Unaqwyn/SysP18_1cv/05_Webseite/05_Robi/IMAG0250.jpg

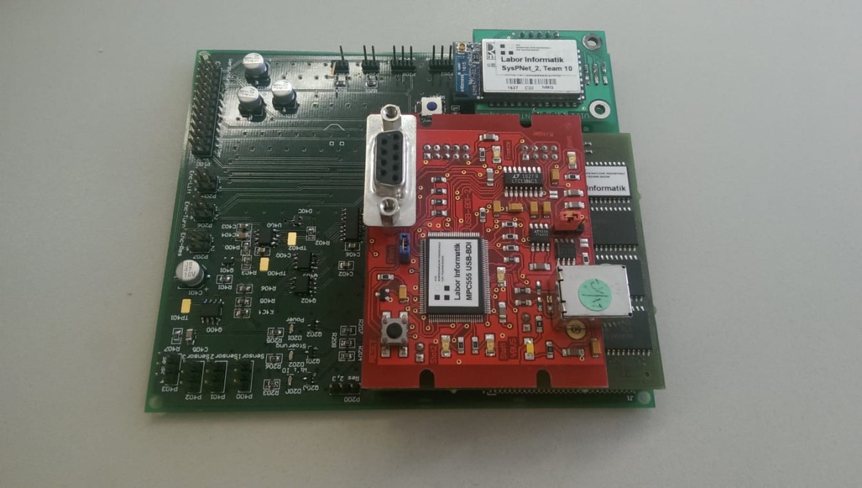
05_Webseite/05_Robi/IMAG0250.jpg
