Unaqwyn/SysP18_1cv/01_Organisation/02_Meilensteine/06_Datenblätter/02_Mechanik/01_Motoren/MotorBezeichnung mit Getriebe zuweisung.txt

Grosser Motor:

2232R012SR IEH2-1024 22/2 3.1:1

Kleiner Motor:

1524T012SR IEH2-1024 15/5 6.3:1
