Unaqwyn/SysP18_1cv/01_Organisation/00_Protokolle/SysP_Sitzung_2018_02_18.docx

Sitzungs-Protokoll vom: 20.2.18

Anwesende: Team 10, Peter Kühne

Ziel der Sitzung:

- M1 Abschluss
- Details am Roboter ausarbeiten
- Team-Coaching Termin festsetzten
- Detailierte Aufstellung für Zeitplan

Probleamtik/Diskussionspunkte:

- Team 10 im vorderen Teil der Noten
- Zeitplan muss detaillierter gestaltet werden
- Vorne nur Distanzsensor anstatt Druck
- Vibrationsmotor bestellen
- Faulhaber, Maxon: häufige Motorensponsoren
- Klapparm: kein Motor
- Team Coaching am 13 März abgemacht
- Auftrag: jeder erstellt ein ungefährer Zeitplan für sein Gebiet (bereits direkt nach Sitzung erledigt)
- Nach Absprache mit Partnerteam 3, neue Startstein Positionen festgesetzt: siehe Foto

Zeitaufwand für diese Sitzung: 1h
