Unaqwyn/SysP18_1cv/01_Organisation/02_Meilensteine/m5/anforderungsliste_nichteingehalten.docx

Zeit, übersetzung des Drehmotors stimmt nicht

Eingreifen während vorführung: sensor kann falsch ausschlagen, somit stimmt die position nicht

Startgrösse
