Unaqwyn/SysP18_1cv/01_Organisation/02_Meilensteine/m5/m5_info.pptx

## Informatik


- Viele kleinere Klassen
  - Einfacheres Testen/ Fehlersuche
- Drive als abstract class, um beide Arten von Motoren gleich anzusteuern
- Move und Lift um Motoren zu koordinieren
- RobiConstant und PinMap, um leicht Anpassungen machen zu können
