Unaqwyn/SysP18_1cv/01_Organisation/02_Meilensteine/m2/Praesentation_m2.pptx

## Klaus der Leuchtturmbauer

SysP18_Team_10

Design Review
Präsentation zu M2

Meilenstein_M2

3. März 2018

## Slide 2

Ablauf

SysP18_Team_10

- Einführung
- Mechanik
- Elektronik
- Informatik
- Zeitplan
- Diskussionsrunde

Meilenstein_M2

Seite 1/20

3. März 2018

## Slide 3

Einführung

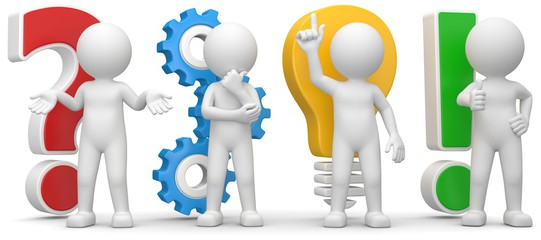
[picture p19: figure]

SysP18_Team_10

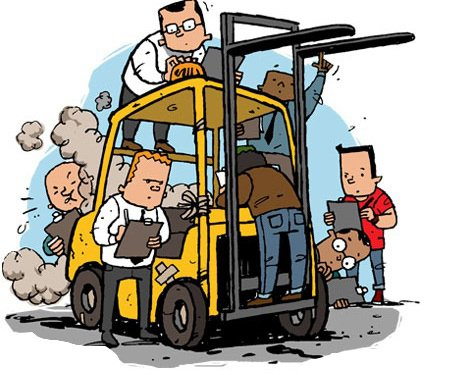
[picture p20: figure]

Seite 2/20

Meilenstein_M2

3. März 2018

## Slide 4

Mechanik – Design Review

SysP18_Team_10

- Autor: Jeannot Zwick
- Aktuar: Mauro Stoffel
- Experte: HansJakob Rechsteiner

Meilenstein_M2

Seite 3/20

3. März 2018

## Slide 5

Mechanik - Ergebnisse

SysP18_Team_10

- Produktionsaspekte mehr beachten
- Murphy’s law

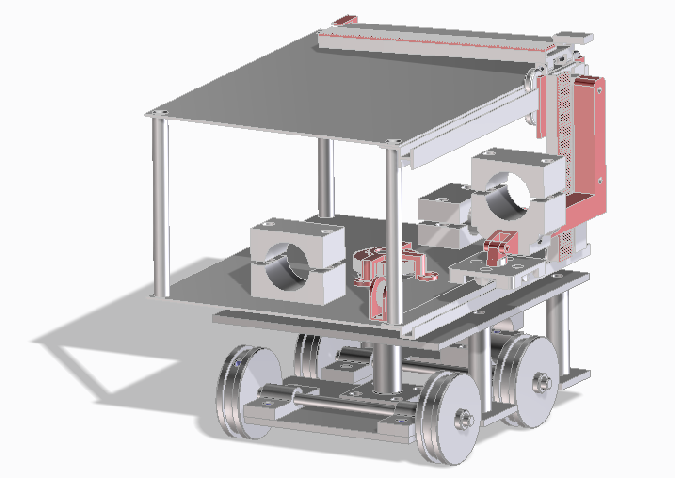
[picture p21: figure]

Meilenstein_M2

Seite 4/20

3. März 2018

## Slide 6

Elektronik

SysP18_Team_10

- Sensorelektronik und MPC 555
Moderator: Michael Alig
Autor: Luzian Weber
- Motorentreiber und Spannungsversorgung
Moderator: Luzian Weber
Autor: Michael Alig
-Aktuar: Marcel Sonderegger
-Betreuer: Falk Kyburz, Bernhard Girardi

Meilenstein_M2

Seite 5/20

3. März 2018

## Slide 7

Sensorelektronik und MPC 555 - Erster Entwurf

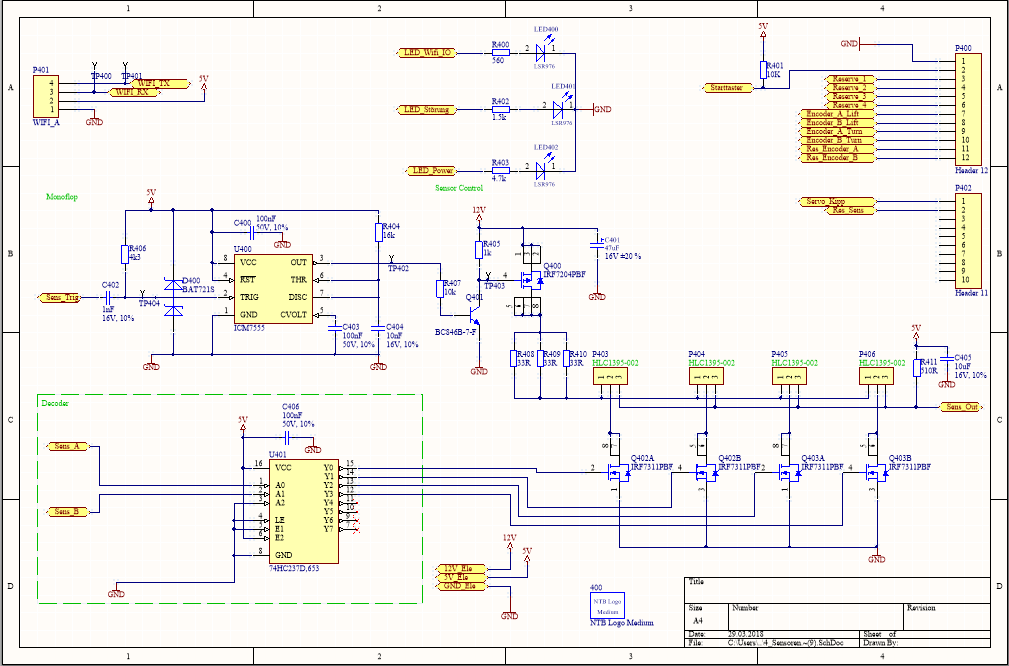
[picture p22: figure]

SysP18_Team_10

Meilenstein_M2

Seite 6/20

3. März 2018

## Slide 8

Sensorelektronik und MPC 555 - Entwurf Top Sheet

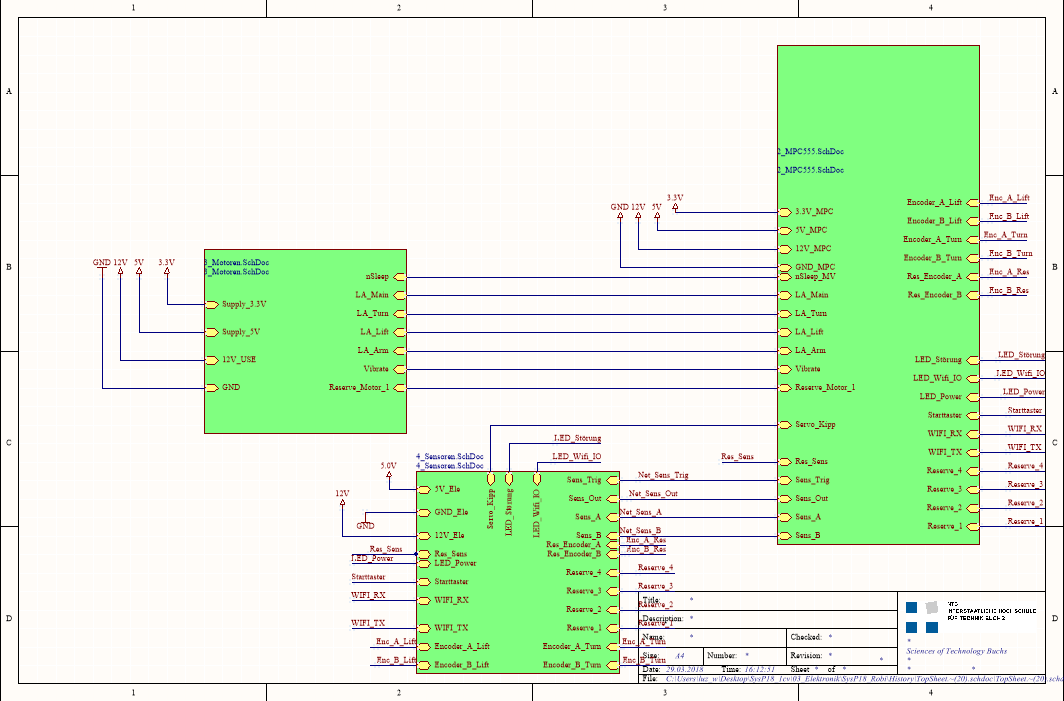
[picture p23: figure]

SysP18_Team_10

Meilenstein_M2

Seite 7/20

3. März 2018

## Slide 9

Sensorelektronik und MPC 555 - Top Sheet Aktuell

SysP18_Team_10

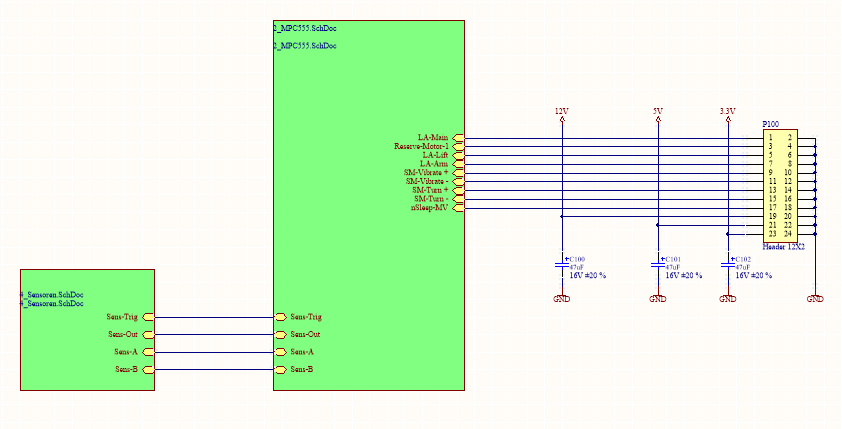
[picture p24: figure]

Meilenstein_M2

Seite 8/20

3. März 2018

## Slide 10

Sensorelektronik und MPC 555 - Aktuelles Schema

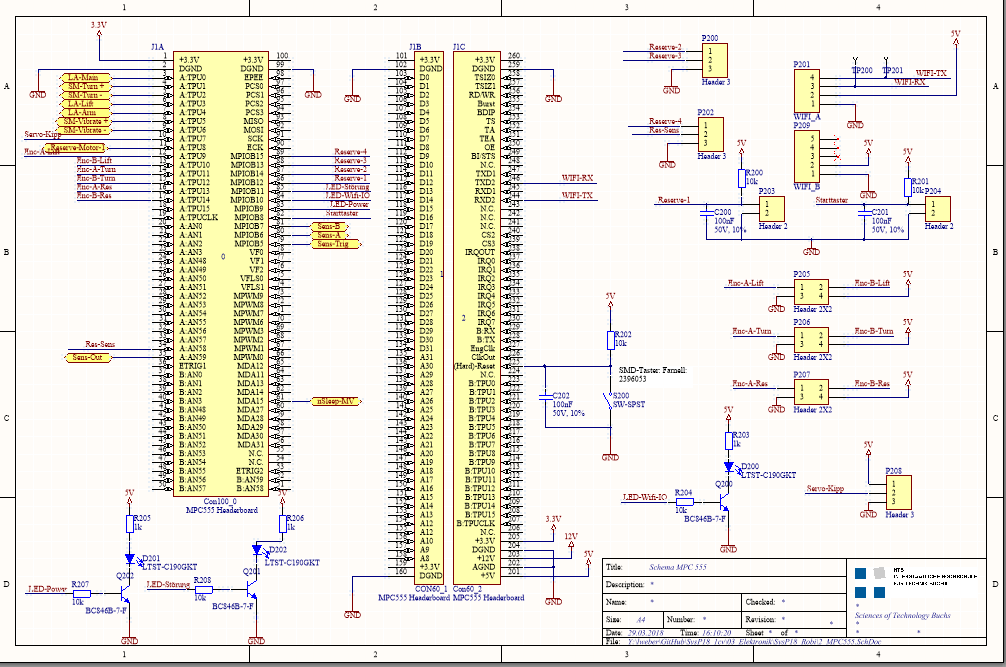
[picture p25: figure]

SysP18_Team_10

Meilenstein_M2

Seite 9/20

3. März 2018

## Slide 11

Sensorelektronik und MPC 555 - PCB Layout


SysP18_Team_10

Meilenstein_M2

Seite 10/20

3. März 2018

## Slide 12

Motorentreiber - Schema

SysP18_Team_10

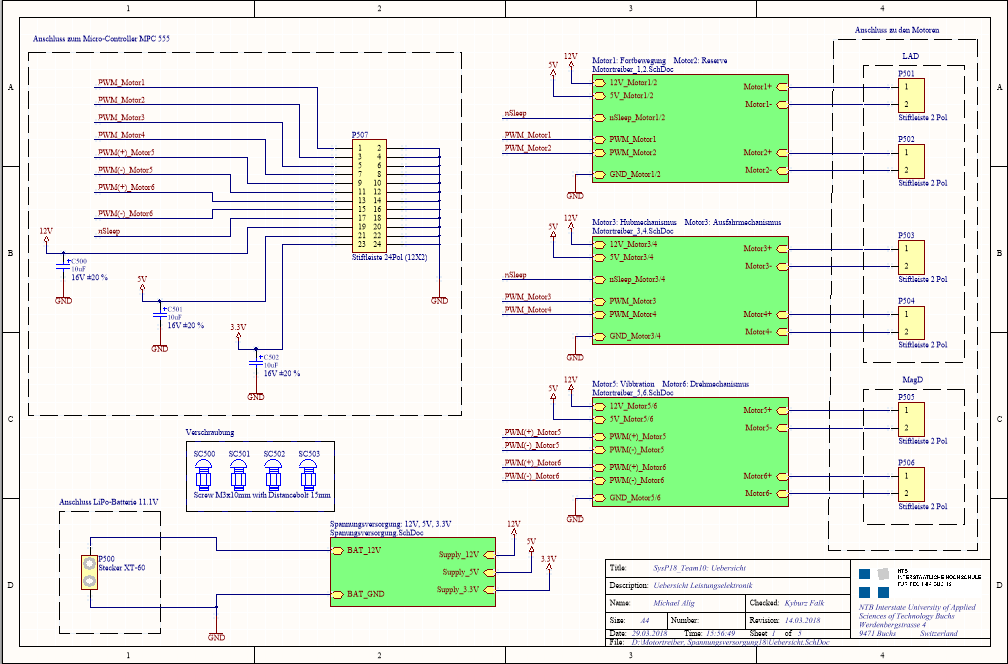
[picture p26: figure]

Meilenstein_M2

Seite 11/20

3. März 2018

## Slide 13

Motorentreiber - PCB Layout

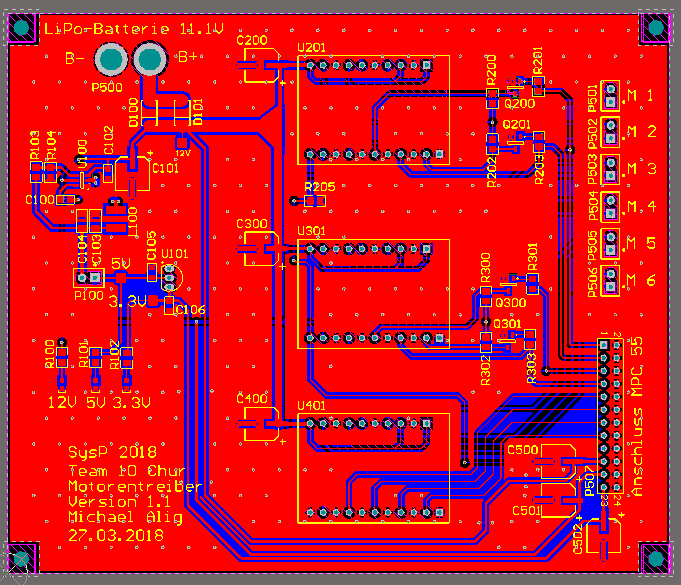
[picture p27: figure]

SysP18_Team_10

Meilenstein_M2

Seite 12/20

3. März 2018

## Slide 14

Fehlerquelle Spannungsversorgung (Switch-Loop)

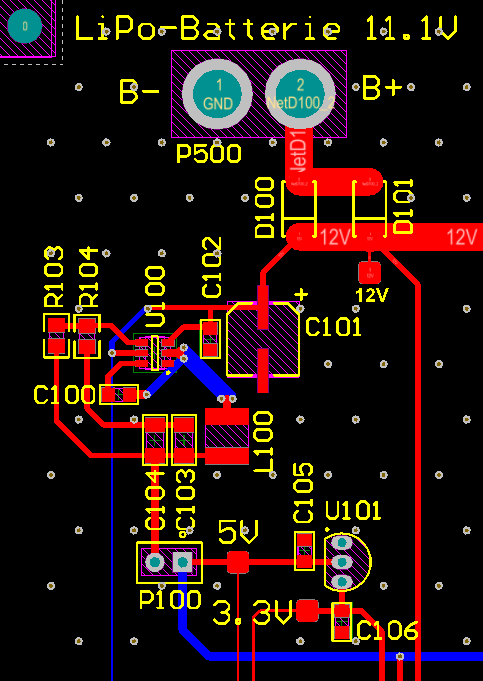
[picture p28: figure]

SysP18_Team_10

Meilenstein_M2

Seite 13/20

3. März 2018

## Slide 15

Motorentreiber - PCB 3D

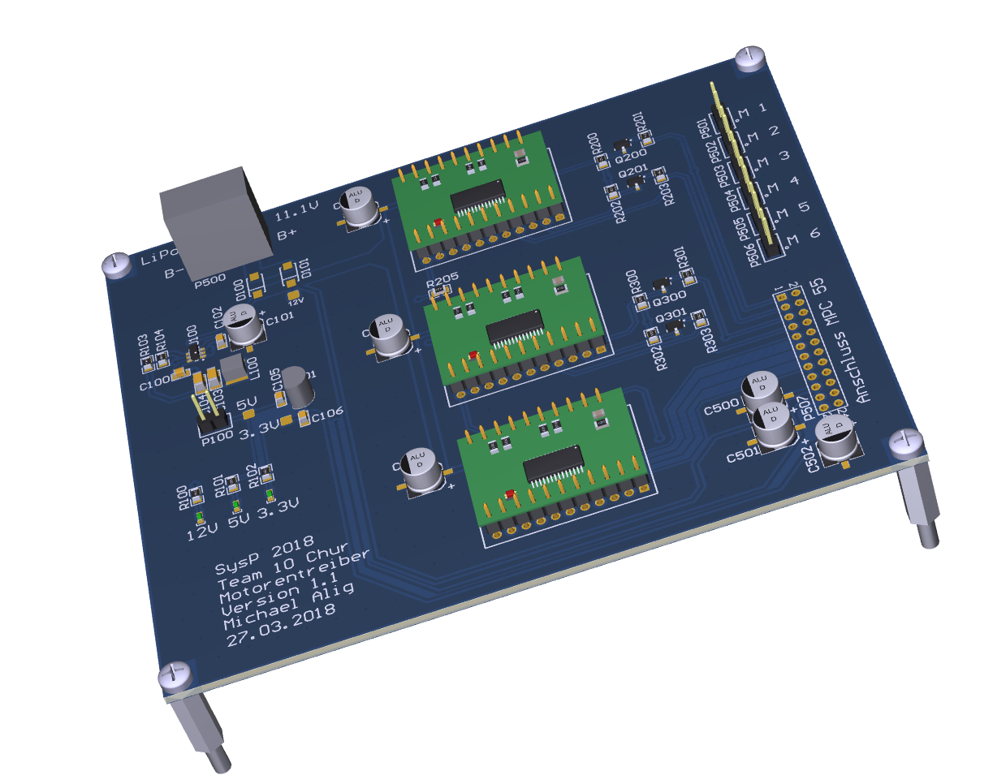
[picture p29: figure]

SysP18_Team_10

Meilenstein_M2

Seite 14/20

3. März 2018

## Slide 16

Informatik

SysP18_Team_10

- Klassendiagramm
- Ablaufdiagramm
- Kommunikationsprotokoll

Meilenstein_M2

Seite 15/20

3. März 2018

## Slide 17

Informatik - Klassendiagramm


- Mehr und kleinere Klassen
- Weniger zentrierte Struktur
- PinMap

SysP18_Team_10

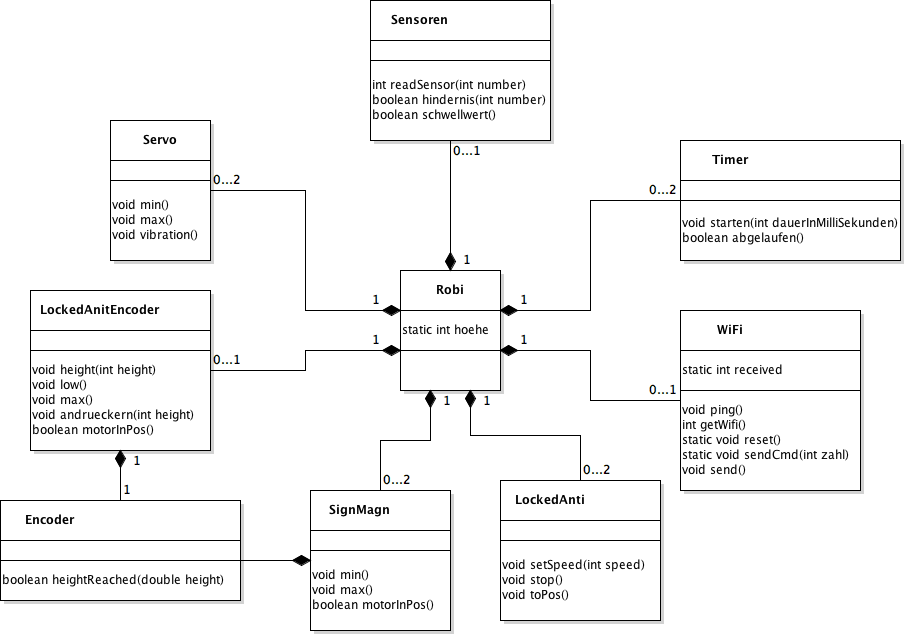
[picture p30: figure]

Meilenstein_M2

Seite 16/20

3. März 2018

## Slide 18

Informatik - Ablaufdiagramm

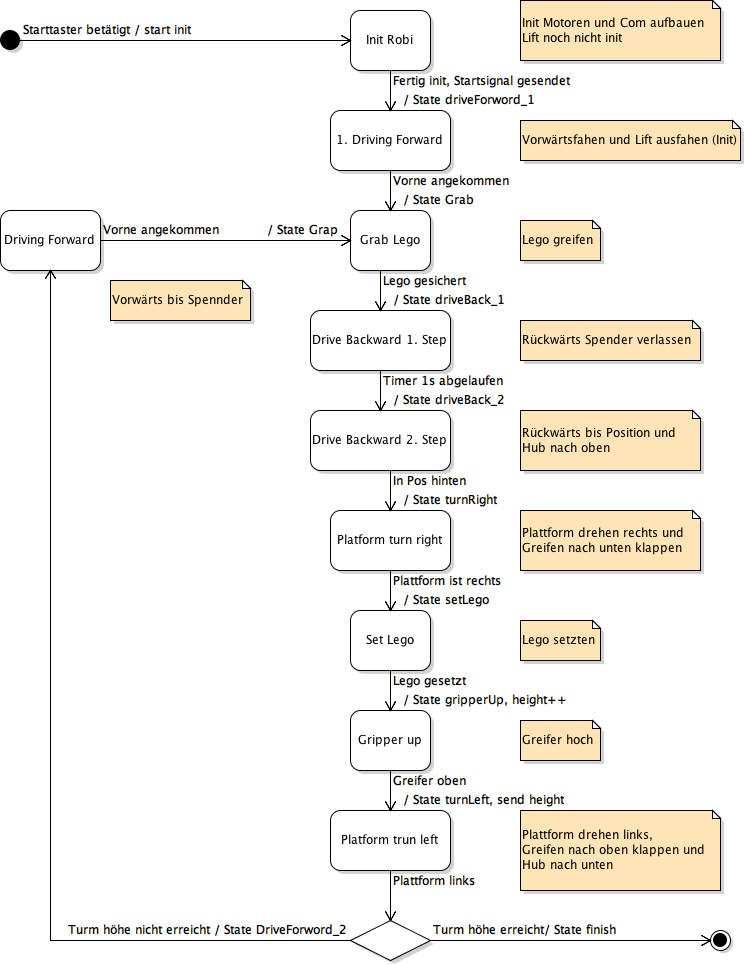
[picture p31: figure]

- Komplikationen vermeiden
- Je früher desto besser
- Bedingung & Aktivitäten

SysP18_Team_10

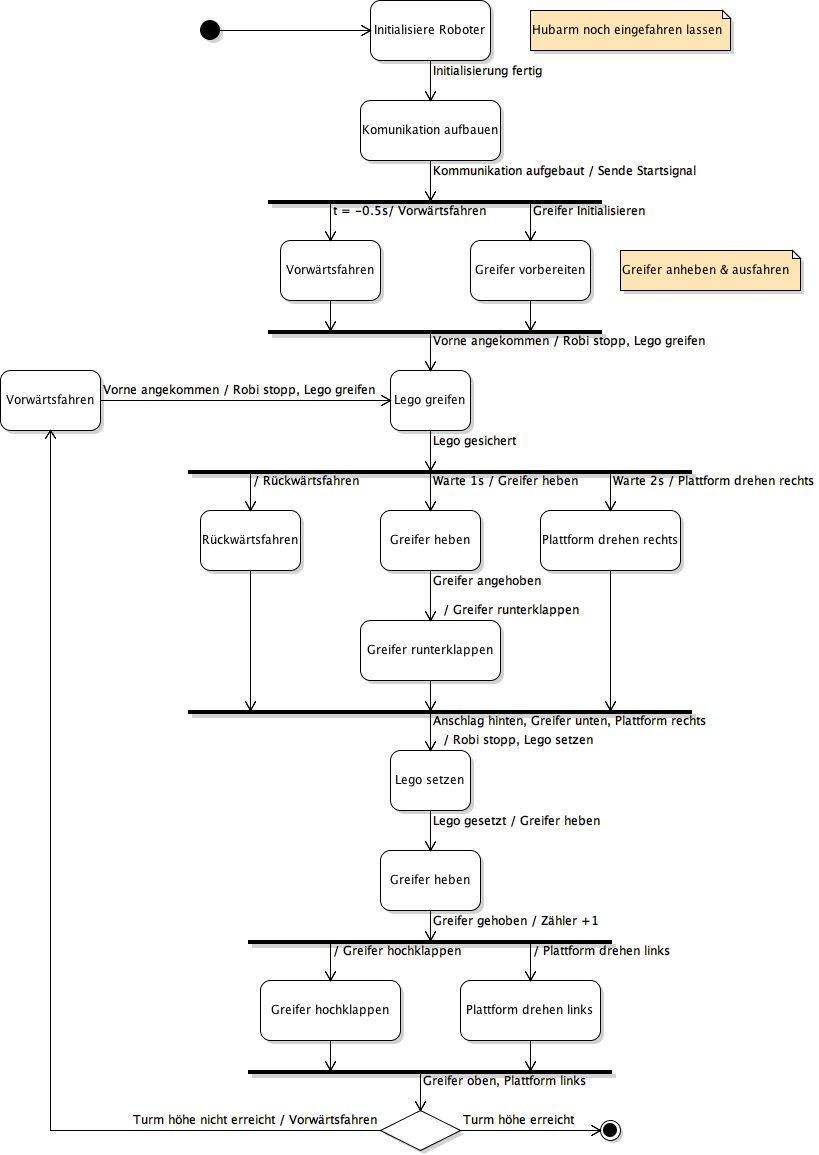
[picture p32: figure]

Meilenstein_M2

Seite 17/20

3. März 2018

## Slide 19

Informatik - Kommunikationsprotokoll

SysP18_Team_10

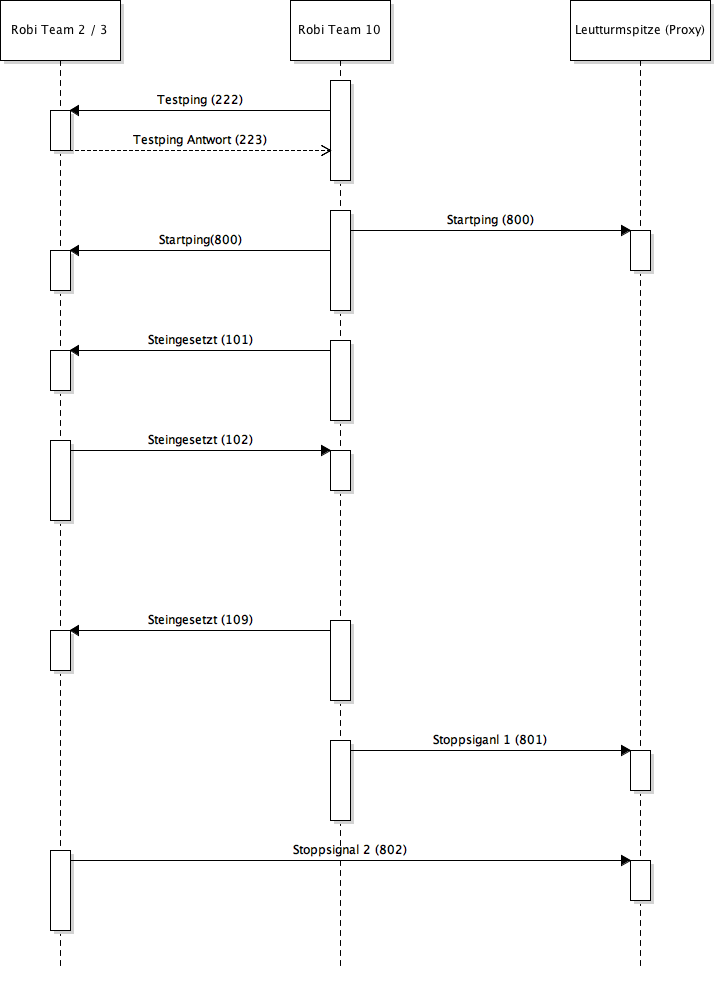
[picture p33: figure]

- Kontrollsignal
- Startsignal
- Stein-Gesetzt-Signal
- Stoppsignal

Meilenstein_M2

Seite 18/20

3. März 2018

## Slide 20

Zeitplan

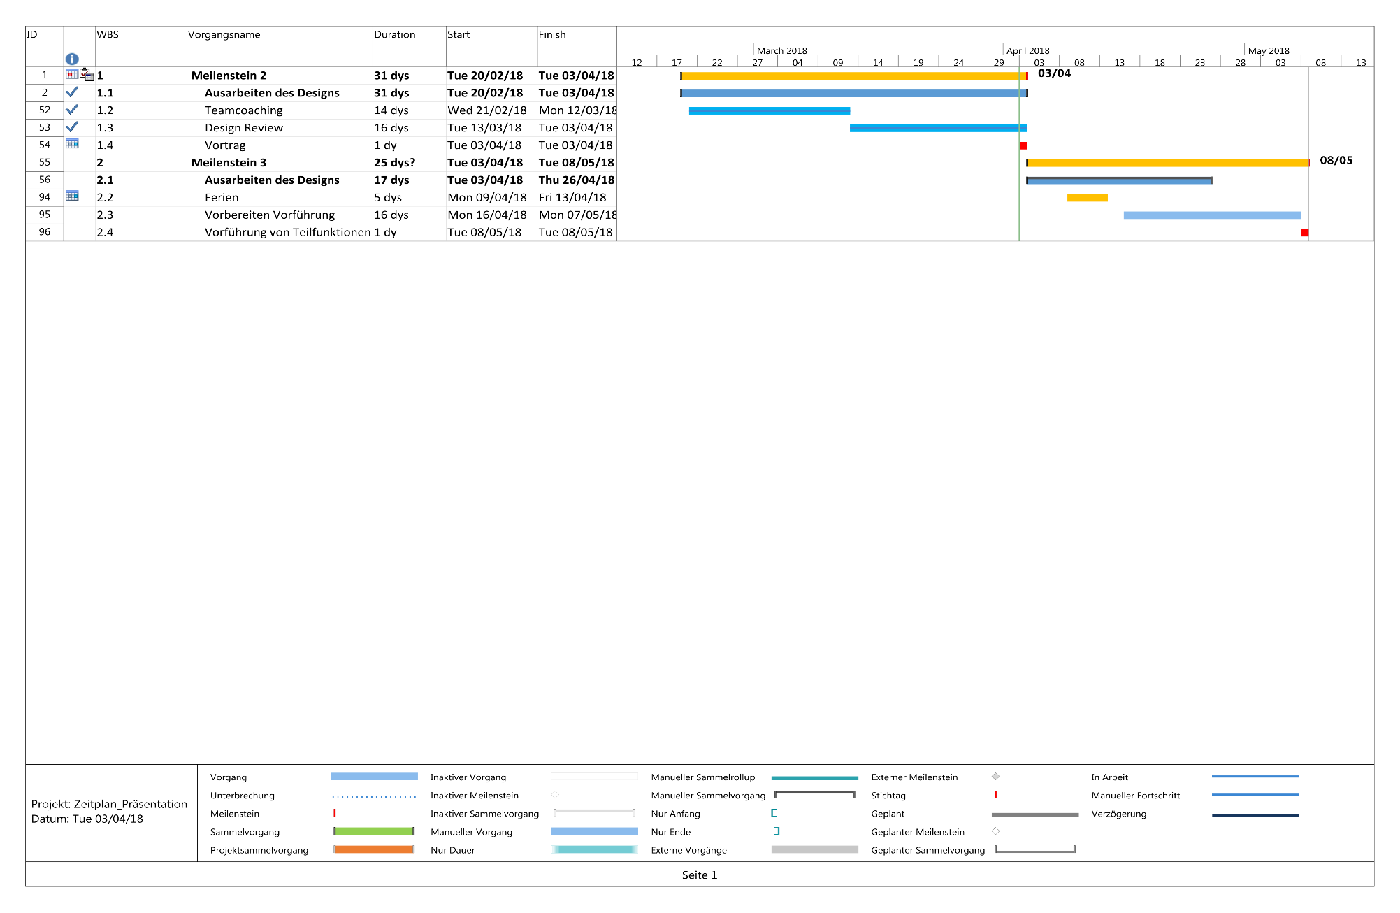
[picture p34: figure]

SysP18_Team_10

Meilenstein_M2

Seite 19/20

3. März 2018

## Diskussionsrunde

SysP18_Team_10

Meilenstein_M2

Seite 20/20

3. März 2018
