Unaqwyn/SysP18_1cv/01_Organisation/02_Meilensteine/m5/Frühere Präsentationen/Fachpräsentation 2016.pptx

## Fachpräsentation Team 01

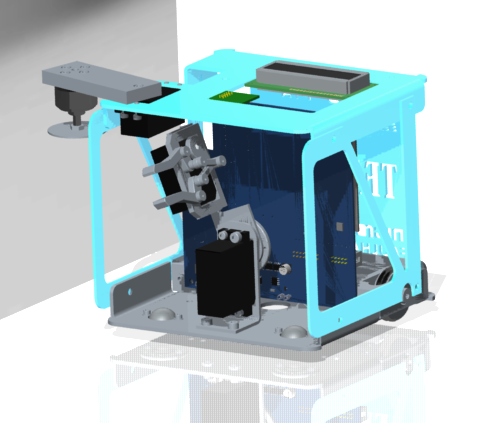
[picture p37: figure]

SYSP-16

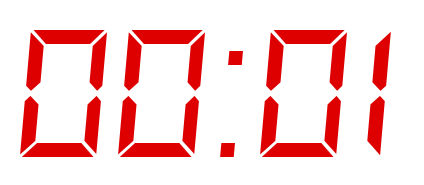
[picture p38: figure]

NTB- Buchs 28.06.2016

## Inhaltsverzeichnis

  1. Ergebnis
  2. Konzepte
    - Mechanik
    - Elektronik
    - Informatik
  3. Einhaltung der Anforderungen
  4. Verbesserungspotential
  5. Live Vorführung
  6. Zeitplan

## 1. Ergebnis

- Voll funktionsfähig
- Innovativ
- Einfache Konstruktion
- Wartungsarm
- Leichtbau

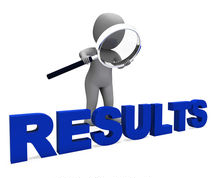
[picture p39: figure]

## 1. Konzepte Mechanik

Drahttrennen

Gehäuse

Antrieb

Greifen & Hub

## 2. Konzepte Mechanik

- Antrieb
  - Zwei Motoren
  - Vierpunkt Auflage
  - Kunststoffgleitlagerung
  - O- Ring für idealen Gripp

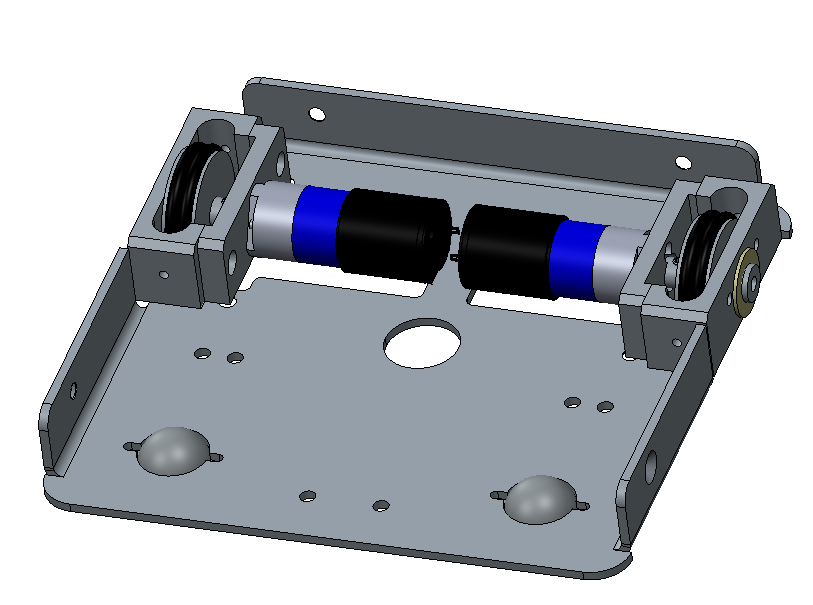
[picture p40: figure]

## 2. Konzepte Mechanik

- Antrieb
  - Auflager

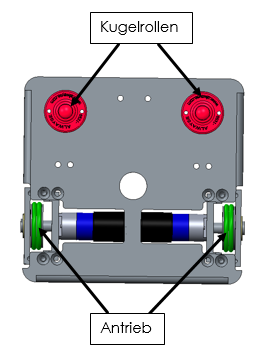
[picture p41: figure]

## 2. Konzepte Mechanik

- Antrieb
  - Lagerung

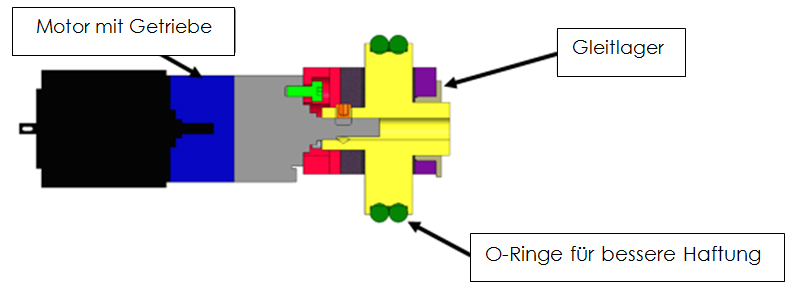
[picture p42: figure]
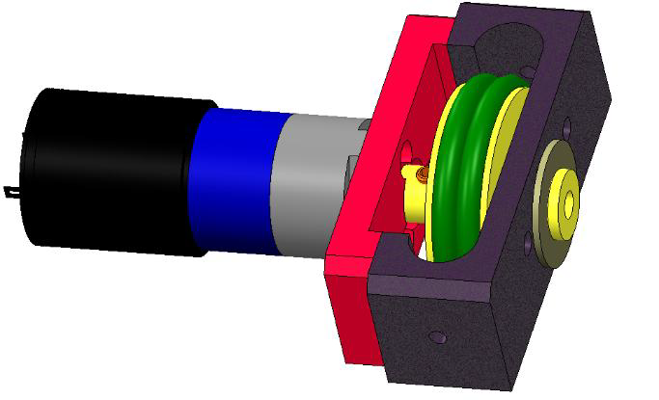
[picture p43: figure]

## 2. Konzepte Mechanik

- Stempelhalter
  - Magnet
  - Schnelle Aufnahme
  - Kunststoffleichtbau
  - Geringes Verkantungsrisiko

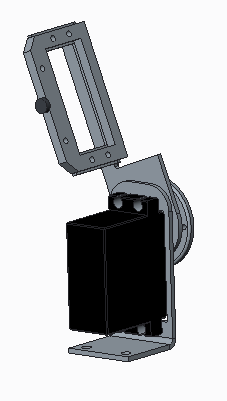
[picture p44: figure]
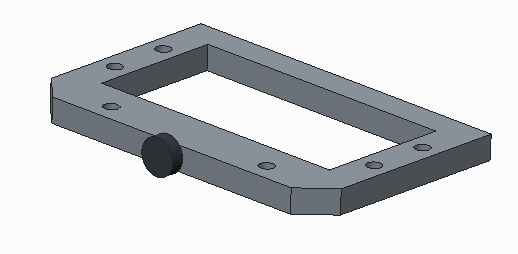
[picture p45: figure]

Magnet

## 2. Konzepte Mechanik

- Hub
  - 180° Schwenkung
  - Servoantrieb
  - Beidseitig
  - Schnell
  - Genaue Positionierung

## 2. Konzepte Mechanik

- Stempelhalter

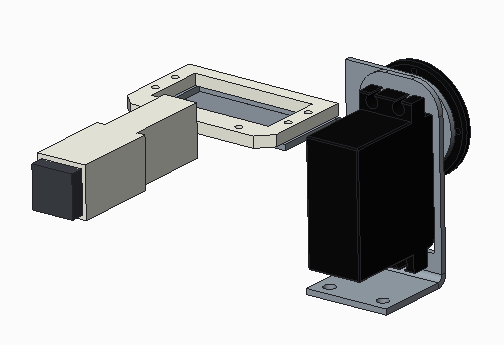
[picture p46: figure]
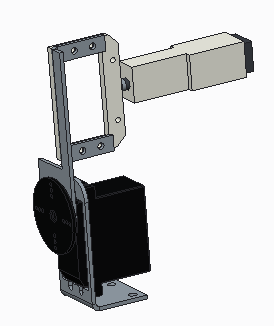
[picture p47: figure]
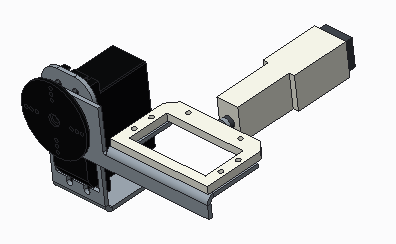
[picture p48: figure]

## 2. Konzepte Mechanik

- Hub

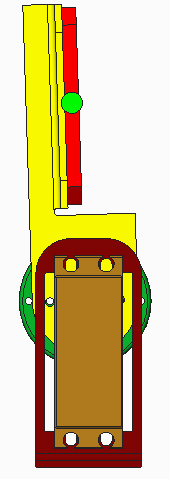
[picture p49: figure]

Stempel aufnehmen

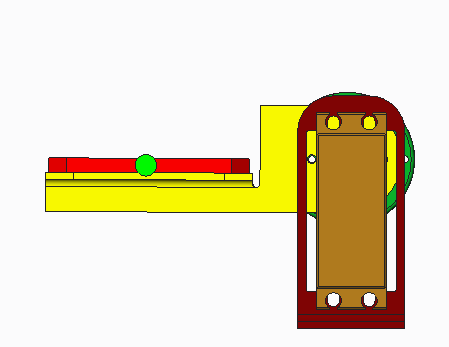
[picture p50: figure]

Stempeln

## 2. Konzepte Mechanik

- Drahttrenner
  - Brushlessmotor
  - Hohe Leistung
  - Ideale Schnittbedingung
  - Ausfahrbar
  - Vorschub durch Antrieb
  - Hochwertige Trennscheibe

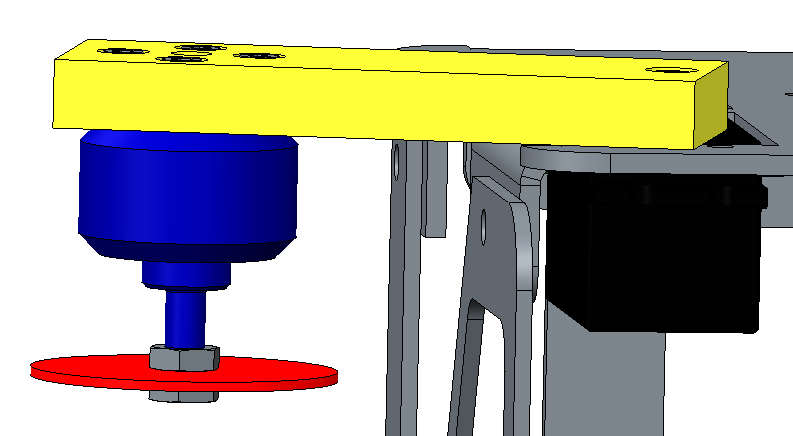
[picture p51: figure]
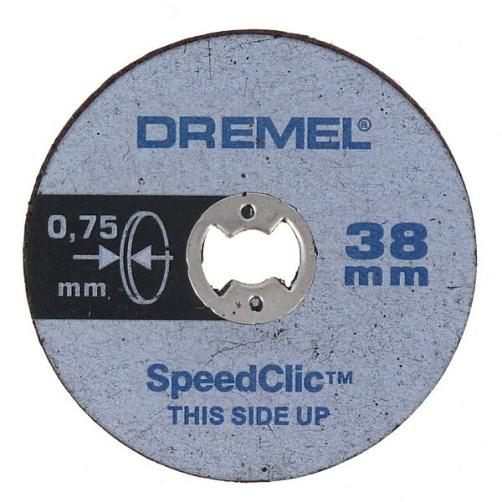
[picture p52: figure]

## 2. Konzepte Mechanik

- Drahttrenner

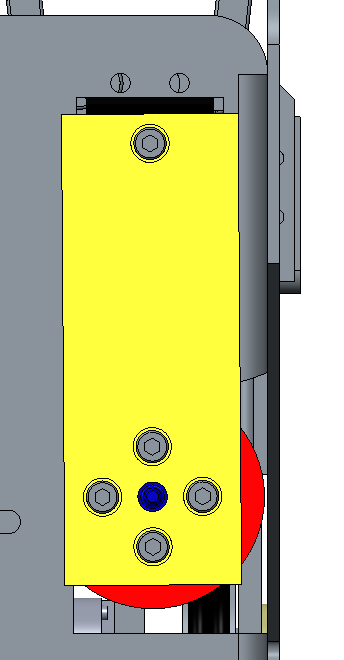
[picture p53: figure]
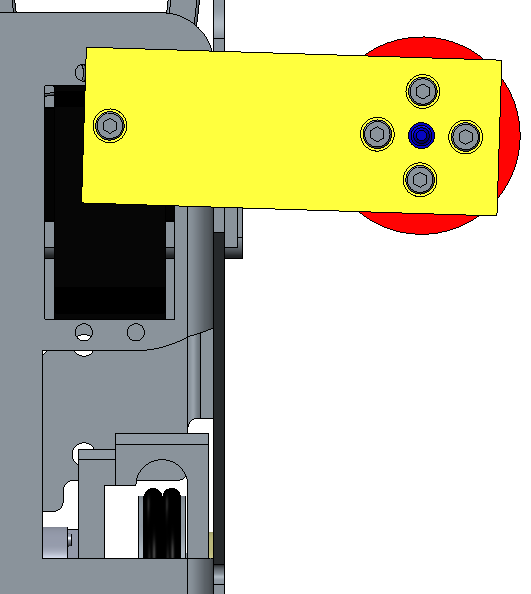
[picture p54: figure]

## 2. Konzepte Mechanik

- Gehäuse
  - Blech- Biege
  - Eloxiert
  - Einfache Montage
  - Logo & Sponsoren
  - Gut zugängliche Komponenten

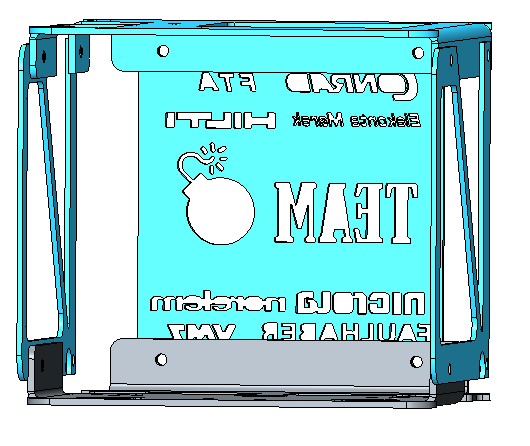
[picture p55: figure]

## 2. Konzepte Elektronik

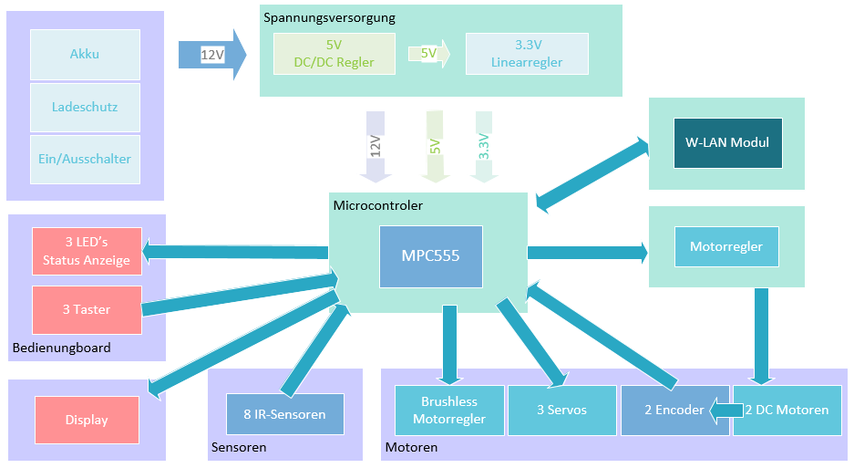
[picture p56: figure]

## 2. Konzepte Informatik

- Modularer Aufbau
- Abstrahierung zur Vereinfachung des Hauptprogramms
- Nutzung der Vorteile Javas ( Objektorientierte Programmierung)

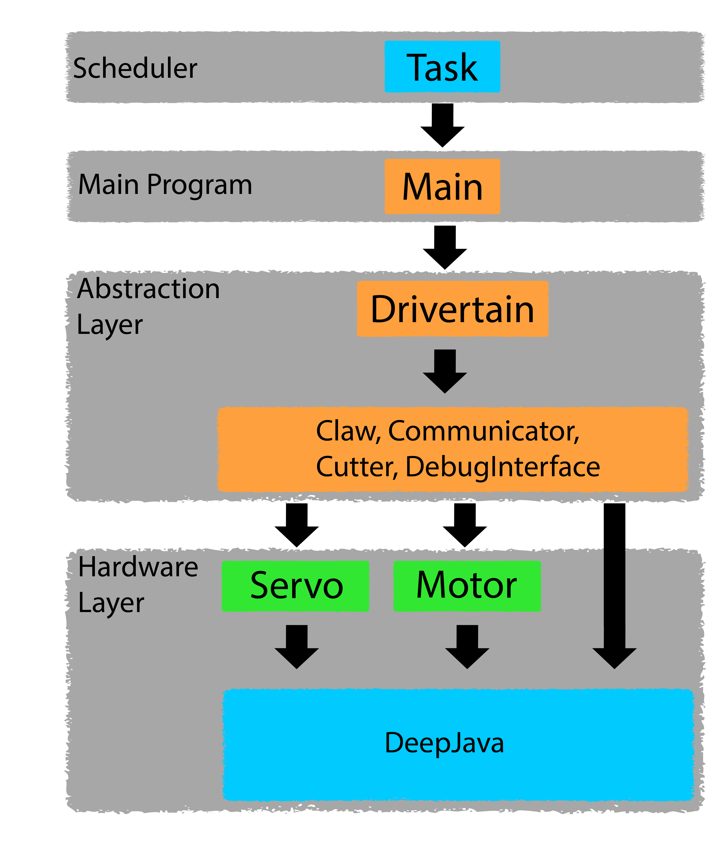
[picture p57: figure]

## 3. Einhaltung der Anforderungen

- Aufgaben der Roboter → erfüllt
- Vollständig autonom → erfüllt
- Gewicht → < 1.5 kg – Wunschgewicht
- Grenzmasse → erfüllt
- Max. 3D- Druckteile → nicht überschritten

## 3. Einhaltung der Anforderungen

- Technische Randbedingungen, Material und Design → erfüllt
- Max. Nennspannung (48V)→ nicht überschritten
- Mikrocontroller → MPC 555
- Programmiersprache → Java
- Kommunikation → WLAN

## 3. Einhaltung der Anforderungen

- Energieversorgung → autonom
- Max. Lärmbelastung → nicht überschritten
- Verletzungsgefahr → bei Beachtung der Sicherheitshinweise keine
- Budget → nicht überschritten
- Termine → eingehalten

## 4. Verbesserungspotential

- Bessere Absprache mit Motorenlieferant
- Liefertermin für Printplatte absprechen
- Checkliste für einzubauende Elektronikteile
- Separate Speisung für die Motoren
- Greifer

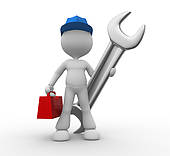
[picture p58: figure]

## 5. Live Vorführung

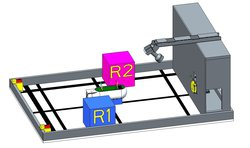
[picture p59: figure]

## 6. Zeitplan

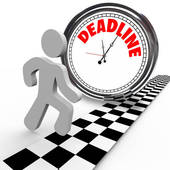
[picture p60: figure]

Zeitplan

## Vielen Dank für Ihre Aufmerksamkeit

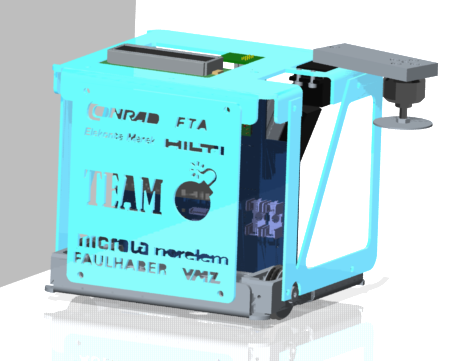
[picture p61: figure]
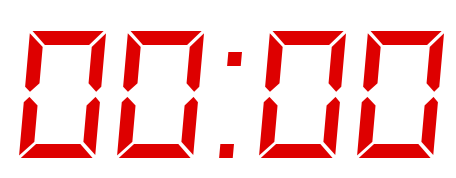
[picture p62: figure]
