Unaqwyn/SysP18_1cv/01_Organisation/02_Meilensteine/m3/Alte_Präsentationen/M3-Präsentation.pptx

## Bündner-Power-RoBock

Präsentation vom M3

Meilenstein_M3

## Inhaltsverzeichnis

- Teilfunktionen in Betrieb
  - Mechanik
  - Elektronik
  - Informatik
- Kommunikationskonzept mit Partnerteam
- Zeitplan Ausblick
- Diskussionsrunde / Vorführungen

## Mechanik

- Montage

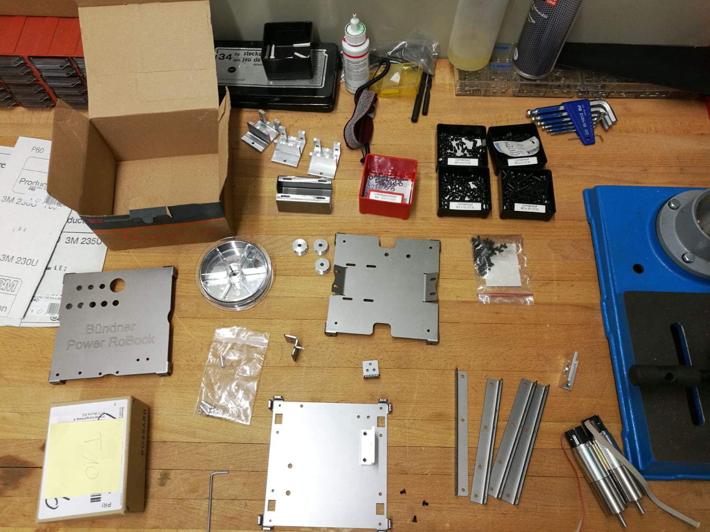
[picture p63: figure]
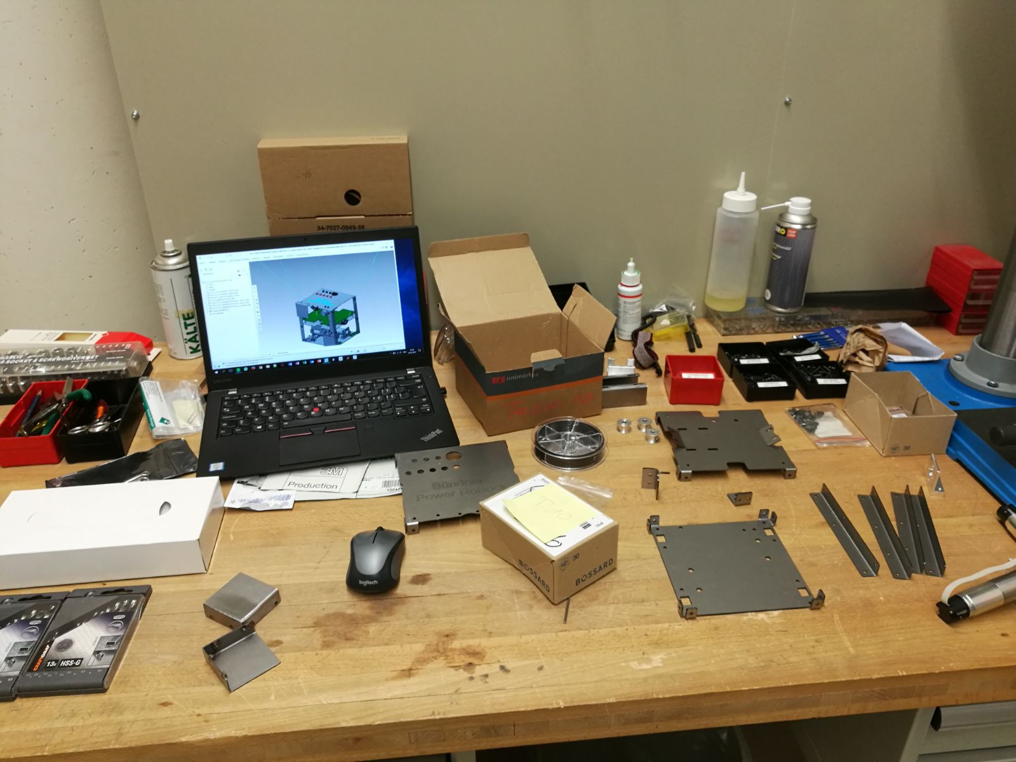
[picture p64: figure]

Notes: Vor Montage Teile vorbereitet
Anhand von CAD-Daten zusammengebaut

## Mechanik

- Grad der Fertigstellung: ca. 90%

Roboter komplett

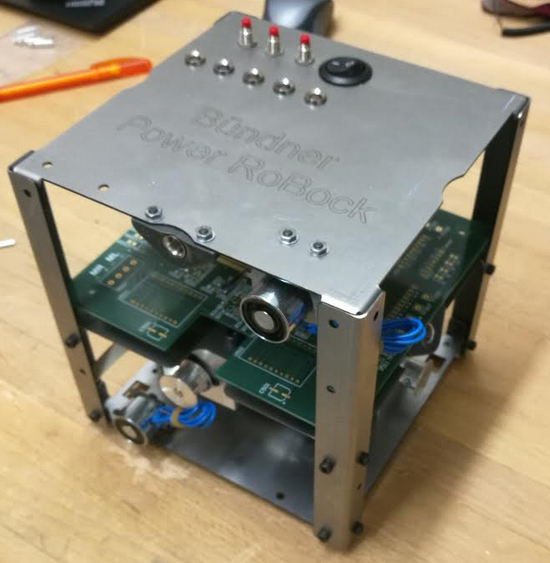
[picture p65: figure]

Teilsystem:
Bodenplatte

Teilsystem:
Deckplatte

Teilsystem:
Mittelplatte

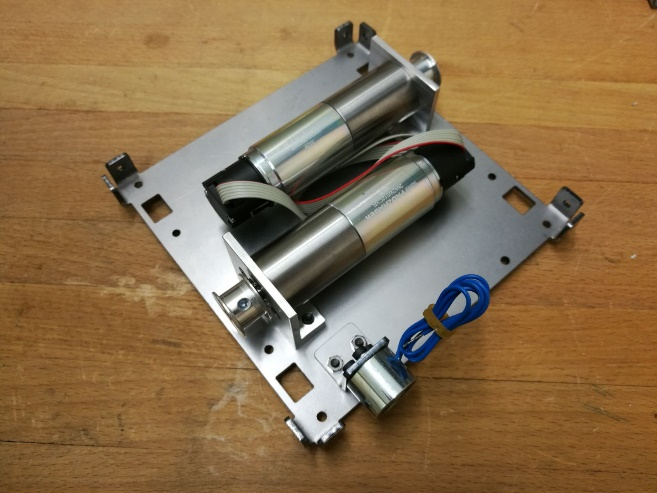
[picture p66: figure]
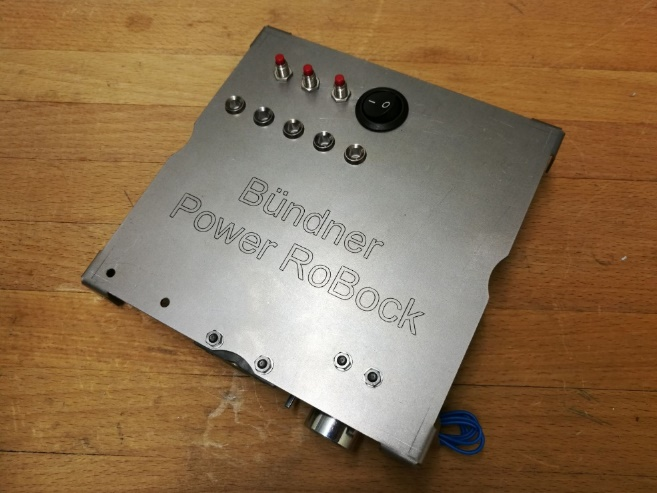
[picture p67: figure]
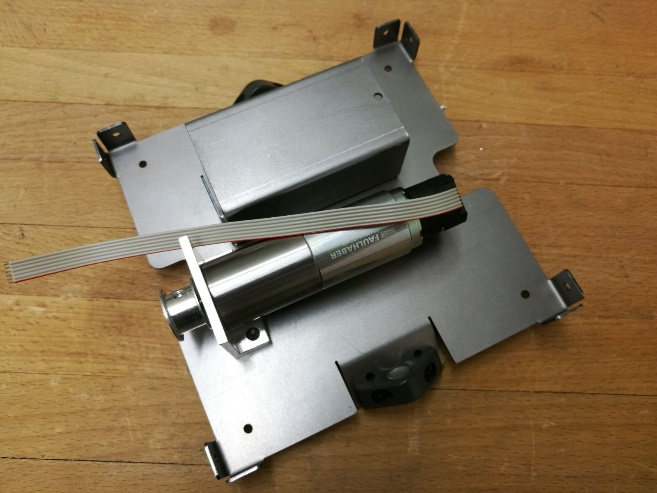
[picture p68: figure]

Notes: Zuerst mechanische Teilsysteme zusammengebaut, dann Roboter komplett
Grad der Fertigstellung 90%
Was fehlt?
Deckplatte noch nicht festgeschraubt (Nicht sinnvoll solange Print noch Arbeiten am Print gemacht werden)
Obere Magnetgegenplatte – wegen Deckplatte

## Mechanik

- Gelöste Probleme
  - Rahmenbefestigung
  - Bodenplatte
- Ungelöste Probleme
  - Seile
  - Gewichtsverteilung

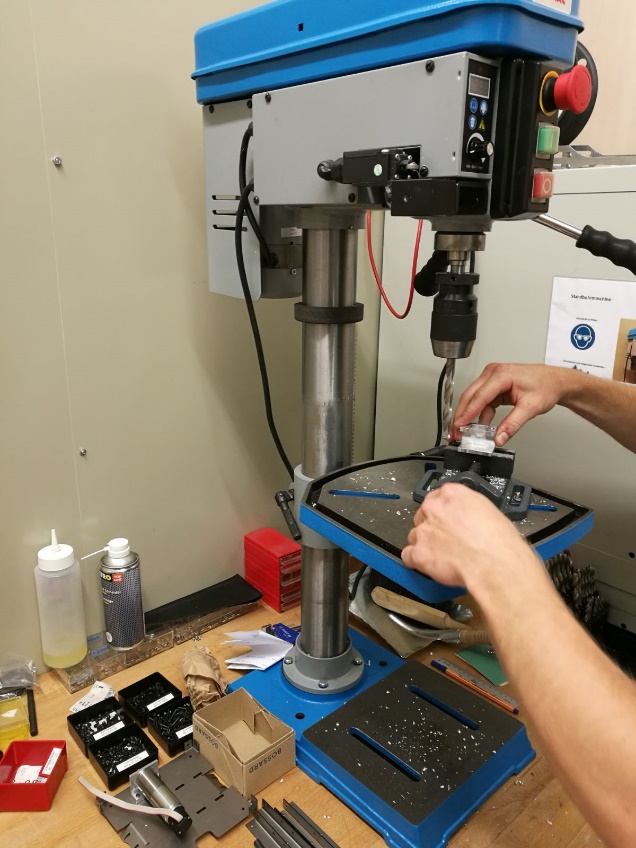
[picture p69: figure]
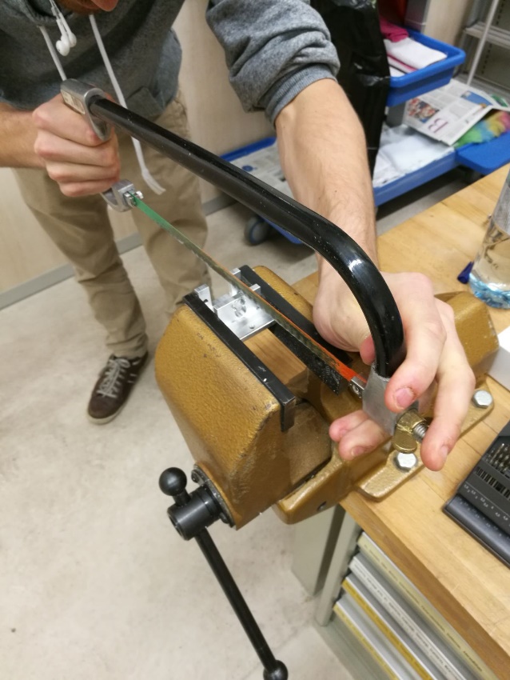
[picture p70: figure]

Notes:
Massnahmen:
Seile – Dickere Seile (0.2mm Angelschnur bringt gemäss M.Stöck 4-fache Verbesserung) (N.Herres bring spezial schnur)
Gewichtsverteilung – Gegengewichte anbringen

## Elektronik

- Vorbereitungen
- Bestückung Prints
- Verkabelung

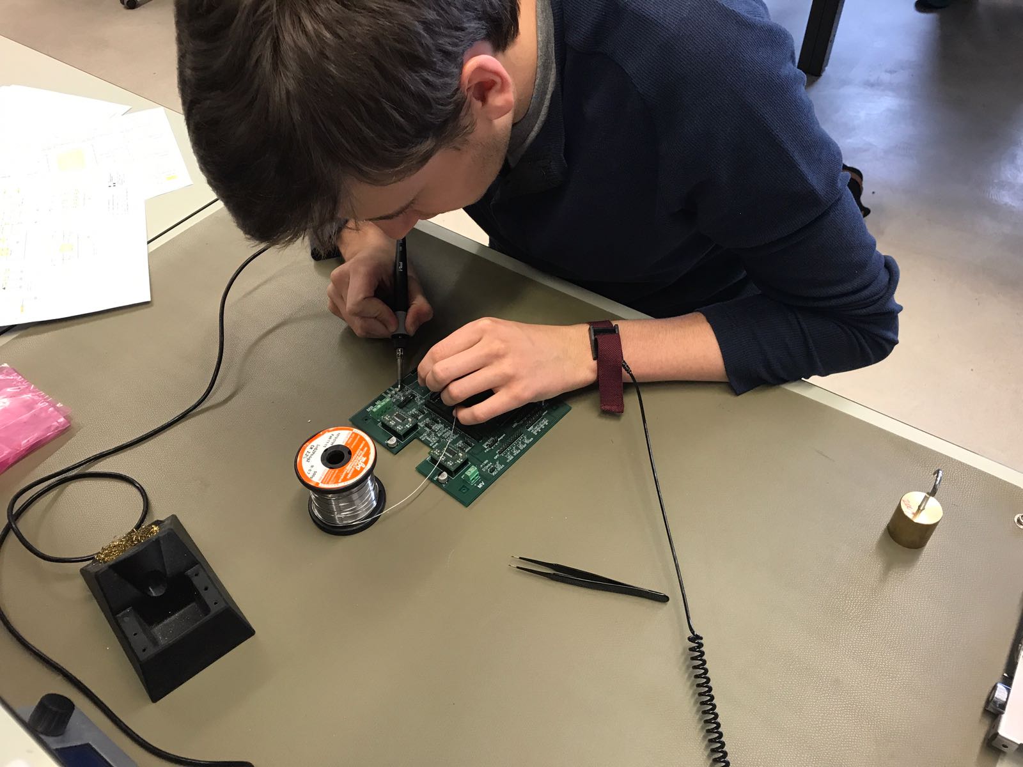
[picture p71: figure]

## Elektronik

- Messprotokoll
- Prüfung Teilfunktionen ohne MPC
- Prüfung mit MPC

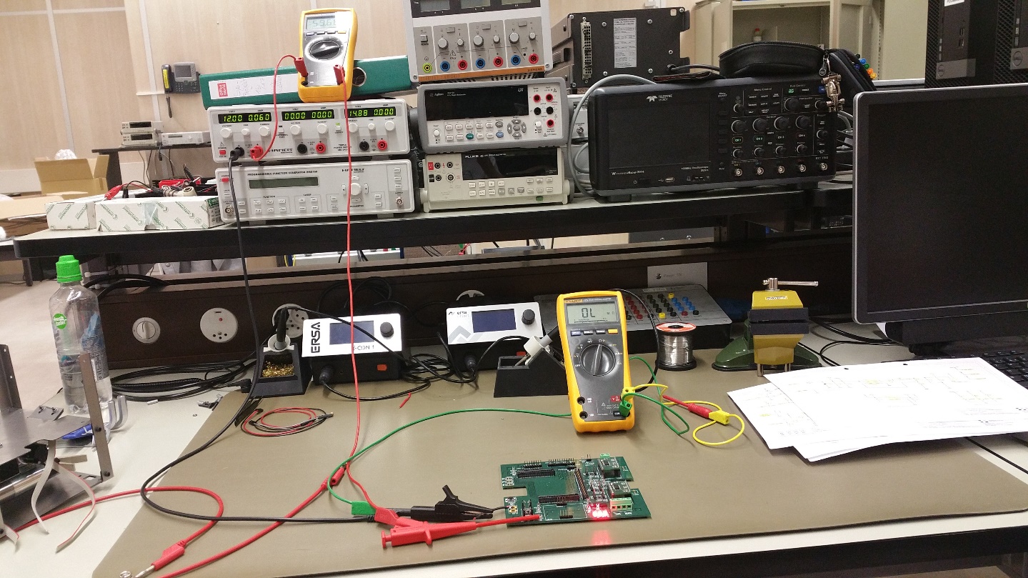
[picture p72: figure]

## Elektronik

Gelöste Probleme
LED’s
Magnete
OPT’s
Ungelöste Probleme
Motoren
Signal OPT

## Informatik

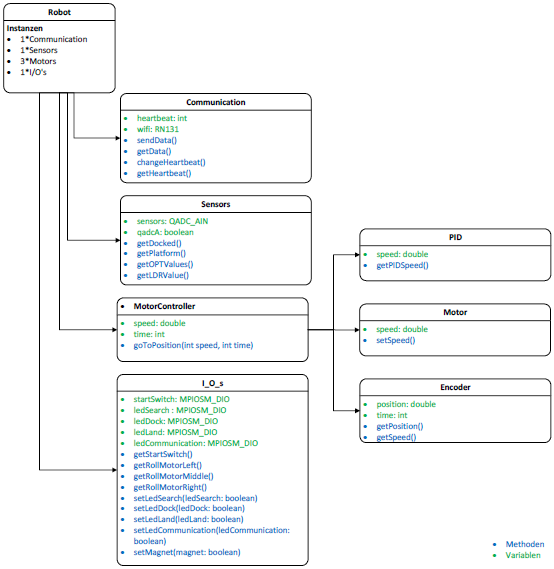
[picture p73: figure]

## Informatik

- Gelöste Probleme
  - StreamBuilder-Exception
  - Falsche Werte der OPT-Sensoren
- Ungelöste Probleme
  - WLAN TCP/IP-Proxy Verbindungsprobleme

## Kommunikationskonzept mit Partnerteam

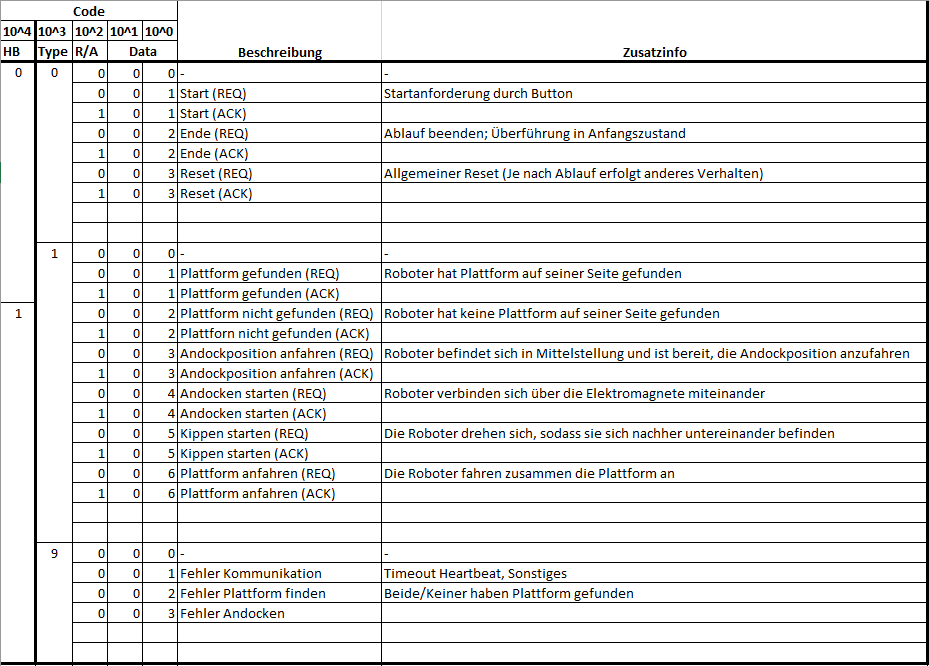
[picture p74: figure]
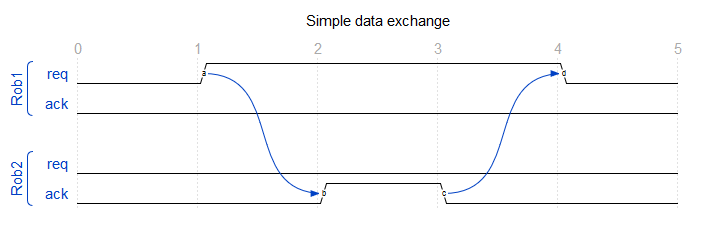
[picture p75: figure]

## Zeitplan Ausblick

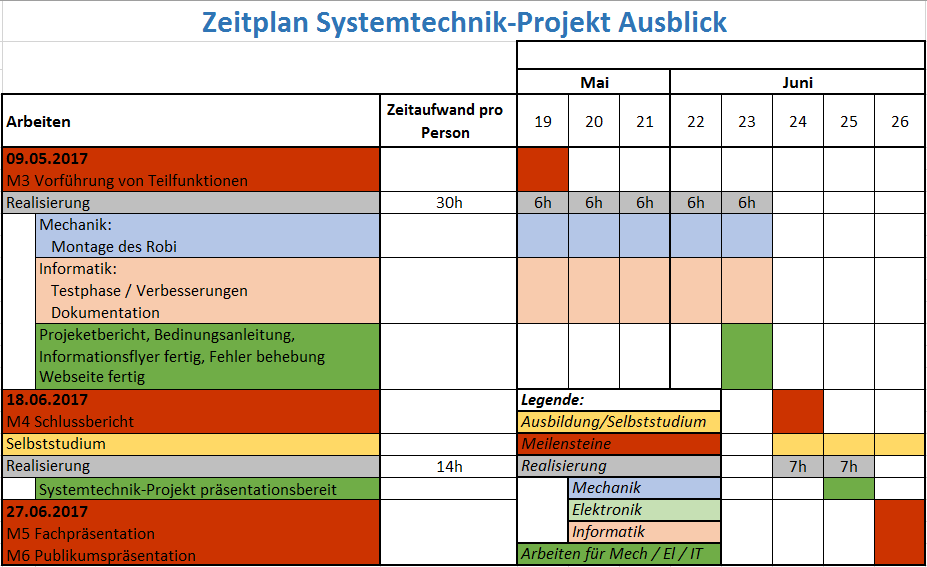
[picture p76: figure]

## Bündner-Power-RoBock

Diskussionsrunde
