Unaqwyn/SysP18_1cv/04_Informatik/99_Altes_Programm/Aktuelle_Dokumente/Sequenzdiagramm.pdf

Zeit

Robi 1 | Robi 2

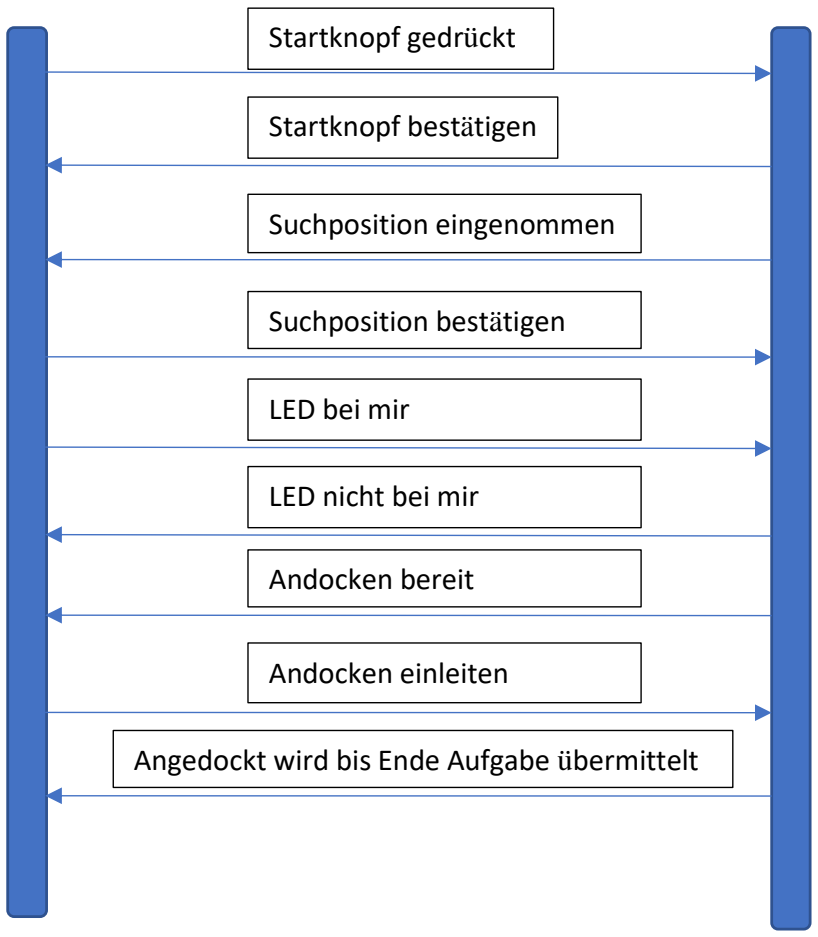
[picture p94: figure]
Startknopf gedrückt; Startknopf bestätigen; Suchposition eingenommen; Suchposition bestätigen; LED bei mir; LED nicht bei mir; Andocken bereit; Andocken einleiten

Angedockt wird bis Ende Aufgabe übermittelt
