Unaqwyn/SysP18_1cv/04_Informatik/02_Dokumente/Ablaufbeschreibung_Klasse_Lift.docx

## Klasse Lift

Init

Lift Arm ausfahren.

downMin

Hub fährt ganz nach unten

toHeight

Hub fährt 2 Stein höher als der Turm bis jetzt gebaut ist.

tilt

Greifer kippt nach unten bei true und nach oben bei false.

setLego

Hub fährt auf Höhe des aktuellen Turmes, wartet 0,5s und fährt nachher wieder mit der Methode toHeight hoch.

vibrate

Vibration starten bei true und stoppen bei false.

inPosHeight

Gibt true zurück, wenn der Hub in der richtigen Position ist.

legoFit

Gibt true zurück, wenn der Stein nicht mehr im Greifer ist.
