Unaqwyn/SysP18_1cv/01_Organisation/00_Protokolle/SysP_Sitzung_2018_01_08.docx

Sitzungs-Protokoll vom: 8.1.18

Anwesende: Team 10 Leiter, Team 2 Leiter, Team 3 Leiter

Ziel der Sitzung:

- Grundlegender Ablauf besprechen
- Diskussion in der Untergruppe

Diskussionspunkte:

- Offen bleiben gegenüber möglicher Konzeptänderungen
- Vielleicht baut nur einer den Turm
- Erster Stein ganz vorne in der Mitte des braunen Feldes (Seit Sitzung vom 12.1.18 ungültig)
