Unaqwyn/SysP18_1cv/01_Organisation/00_Protokolle/000Sitzungs_Protokoll_Vorlage.docx

Sitzungs-Protokoll vom: DATUM EINFÜGEN

Anwesende: ---

Resultat der letzten Sitzung (falls relevant): ---

Ziel der Sitzung: ---

Probleamtik/Diskussionspunkte: ---

Aufgabenverteilung:

- Allgemein: ---
- Elektronik: ---
- Machinenbau: ---
- Informatik: ---
