Unaqwyn/SysP18_1cv/01_Organisation/02_Meilensteine/m5/LogosAufRobi.doc.docx

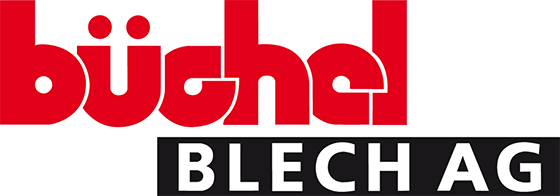
[picture p102: figure]
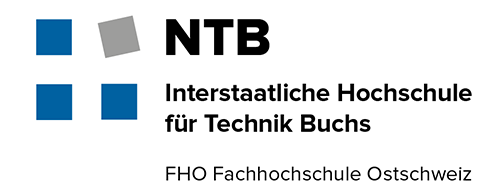
[picture p103: figure]
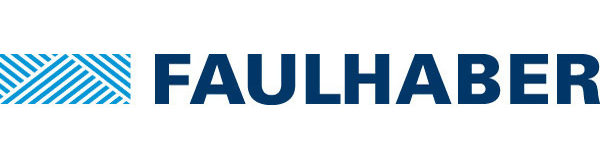
[picture p104: figure]
