Unaqwyn/SysP18_1cv/01_Organisation/02_Meilensteine/vorlagen/Praesentation_m3.pptx

## Klaus der Leuchtturmbauer

SysP18_Team_10

Vorführung der Teilfunktionen
Präsentation von M3

Meilenstein_M3

8. Mai 2018

## Slide 2

SysP18_Team_10

Ablauf

- Teilfunktionen in Betrieb
  - Mechanik
  - Elektronik
  - Informatik
- Kommunikationskonzept mit Partnerteam

Meilenstein_M1c

Seite 1/11

8. Mai 2018

## Diskussionsrunde

SysP18_Team_10

Meilenstein_M1c

Seite 11/11

20. Februar 2018
