Unaqwyn/SysP18_1cv/01_Organisation/02_Meilensteine/m2/M2_Info.pptx

## Klaus der Leuchtturmbauer

SysP18_Team_10

Design Review
Präsentation zu M2

Meilenstein_M2

3. März 2018

## Slide 2

SysP18_Team_10

Ablauf

- Einführung ??
- Mechanik
- Elektronik
- Informatik
- Aussichten ??

Meilenstein_M2

Seite 1/??

3. März 2018

## Slide 3

SysP18_Team_10

Informatik

- Klassendiagramm
- Ablaufdiagramm
- Kommunikationsprotokoll

Meilenstein_M2

Seite 2/??

3. März 2018

## Slide 4


Informatik - Klassendiagramm

- Mehr und kleiner Klasse
- Weniger zentrierte Struktur
- PinMap

SysP18_Team_10


Meilenstein_M2

Seite 2/??

3. März 2018

## Slide 5


Informatik - Ablaufdiagramm

- Komplikationen vermeiden
- Je früher desto besser
- Bedingung & Aktivitäten


SysP18_Team_10

Meilenstein_M2

Seite 2/??

3. März 2018

## Slide 6

Informatik - Kommunikationsprotokoll

SysP18_Team_10


- Kontrollsignal
- Startsignal
- «Steingesetztsignal» ohne Rückmeldung
- Stoppsignal

Meilenstein_M2

Seite 2/??

3. März 2018
