Unaqwyn/SysP18_1cv/01_Organisation/02_Meilensteine/m1c/Praesentation_m1c.pptx

## Klaus der Leuchtturmbauer

SysP18_Team_10

Konzeptfindung
Präsentation von M1c

Meilenstein_M1c

20. Februar 2018

## Slide 2

SysP18_Team_10

Ablauf

- Teamorganisation
- Konzeptfindung
- Funktionsablauf
- Versuchstechnik
- Elektronik
- Zeitplan & Aussichten
- Diskussionsrunde

Meilenstein_M1c

Seite 1/11

20. Februar 2018

## Slide 3

SysP18_Team_10

Luzian Weber*
Teamleiter Team 10
Jeannot Zwick
Teamleiter Mechanik
Marcel Sonderegger
Teamleiter Elektronik
Erich Meyer
Teamleiter Informatik
Romario Jäger
Mitarbeiter Informatik
Mauro Stoffel
Mitarbeiter Informatik
(Mauro Stoffel)
Reservemitarbeiter Mechanik
Michael Alig
Mitarbeiter Elektronik
Luzian Weber*
Mitarbeiter Elektronik

Team-Übersicht

Meilenstein_M1c

Seite 2/11

20. Februar 2018

## Slide 4

SysP18_Team_10

Konzeptfindung

- Start Einführungswoche
- Teamsitzungen
- Brainstorming
- Anforderungsliste
- Konzeptentscheid


Meilenstein_M1c

Seite 3/11

20. Februar 2018

## Slide 5

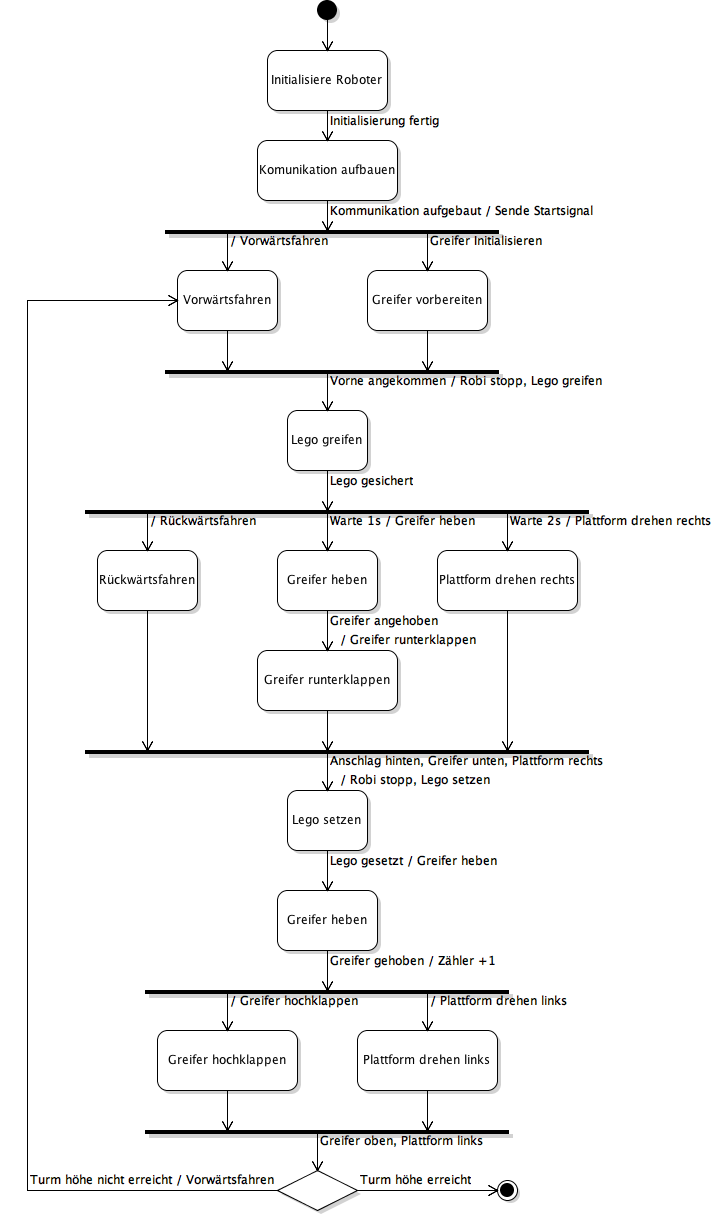
[picture p115: figure]

Seite 4/11

SysP18_Team_10

Funktionsablauf

Meilenstein_M1c

20. Februar 2018

## Slide 6

SysP18_Team_10

Versuchstechnik

- Anpressdruck
  - Erster Stein auf Legoplatte
  - Stein auf Stein
- Greifer
- Fortbewegung

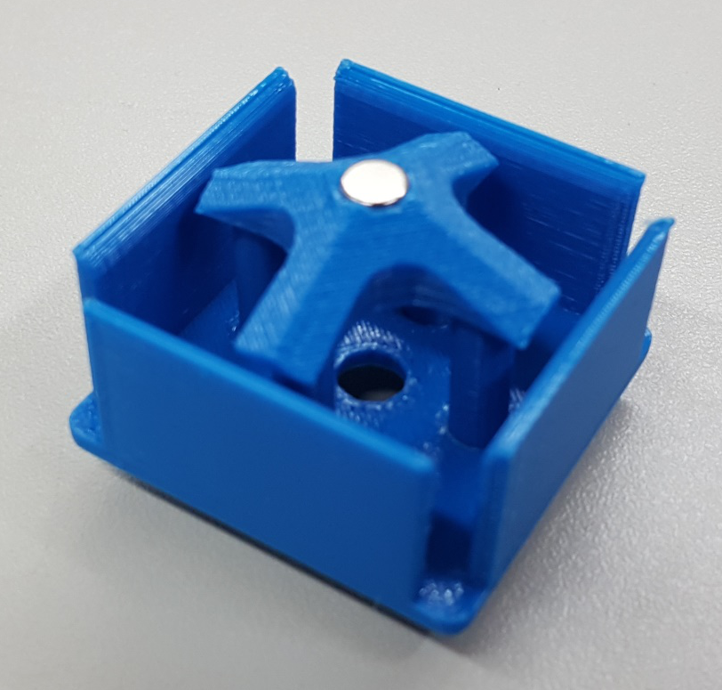
[picture p116: figure]

Meilenstein_M1c

Seite 5/11

20. Februar 2018

## Slide 7

SysP18_Team_10

Elektronik

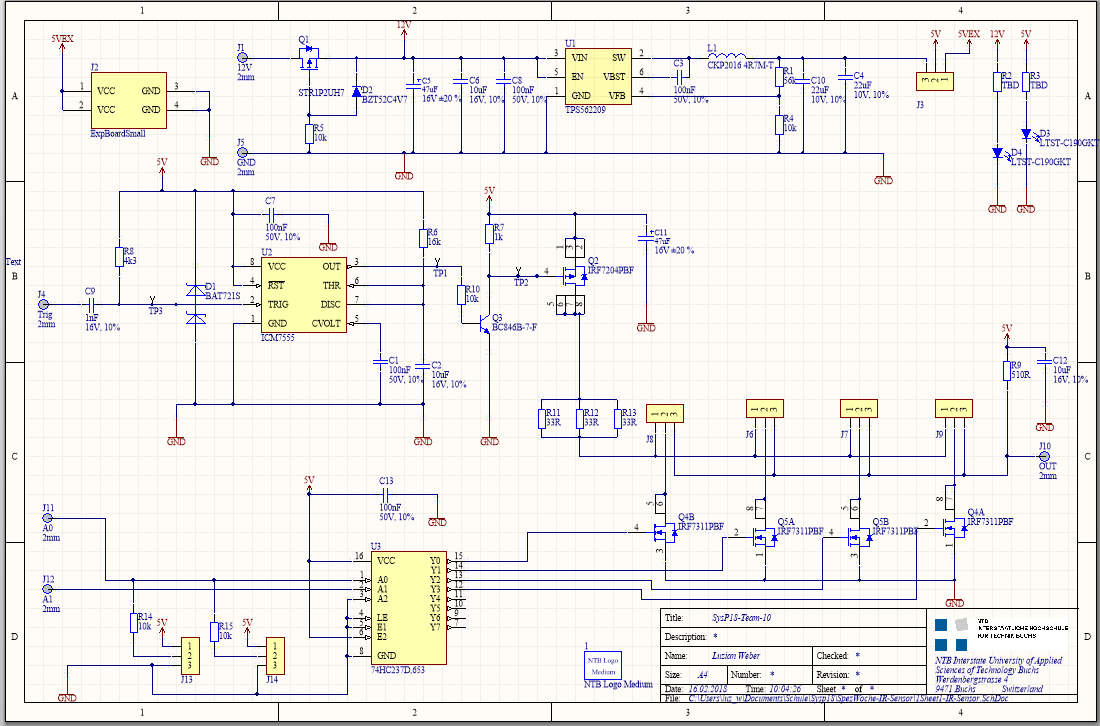
[picture p117: figure]
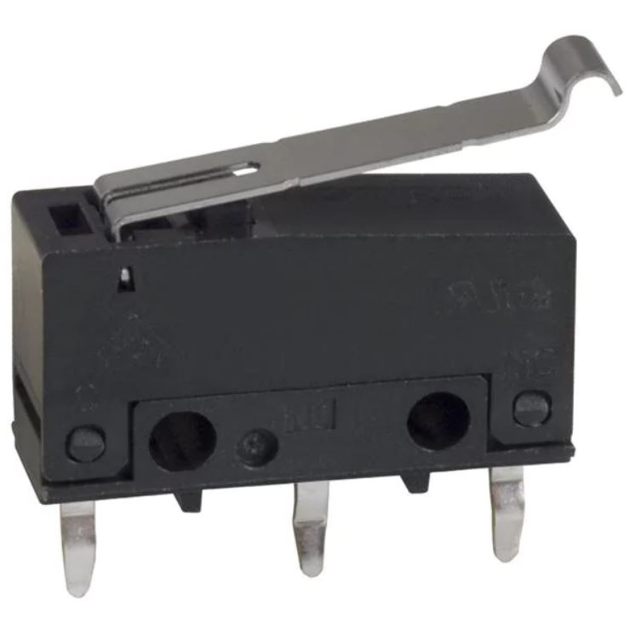
[picture p118: figure]

Einrastschalter

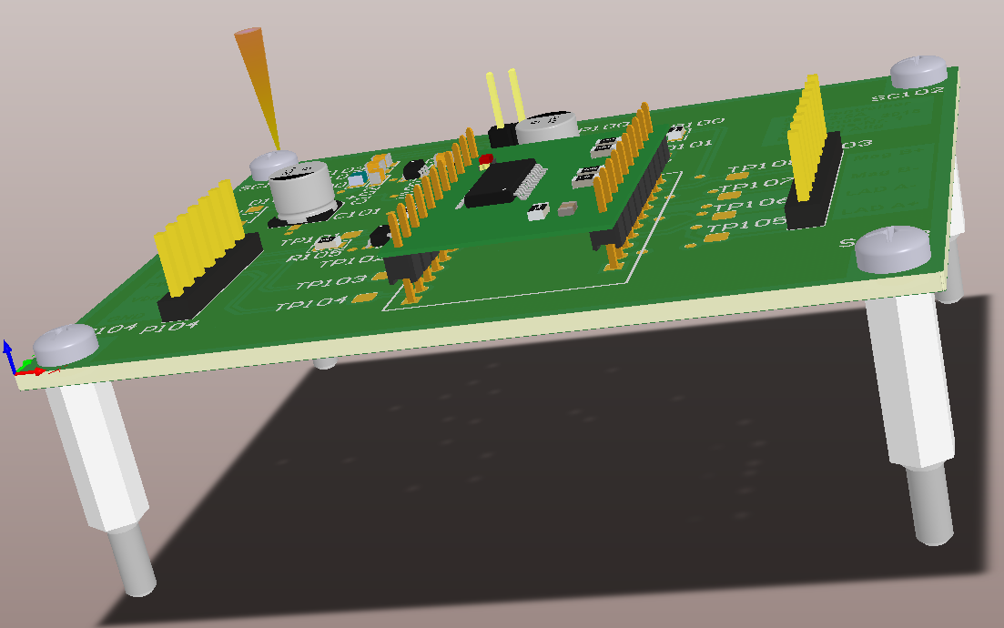
[picture p119: figure]

Meilenstein_M1c

Seite 6/11

20. Februar 2018

## Slide 8

SysP18_Team_10

Ausblick

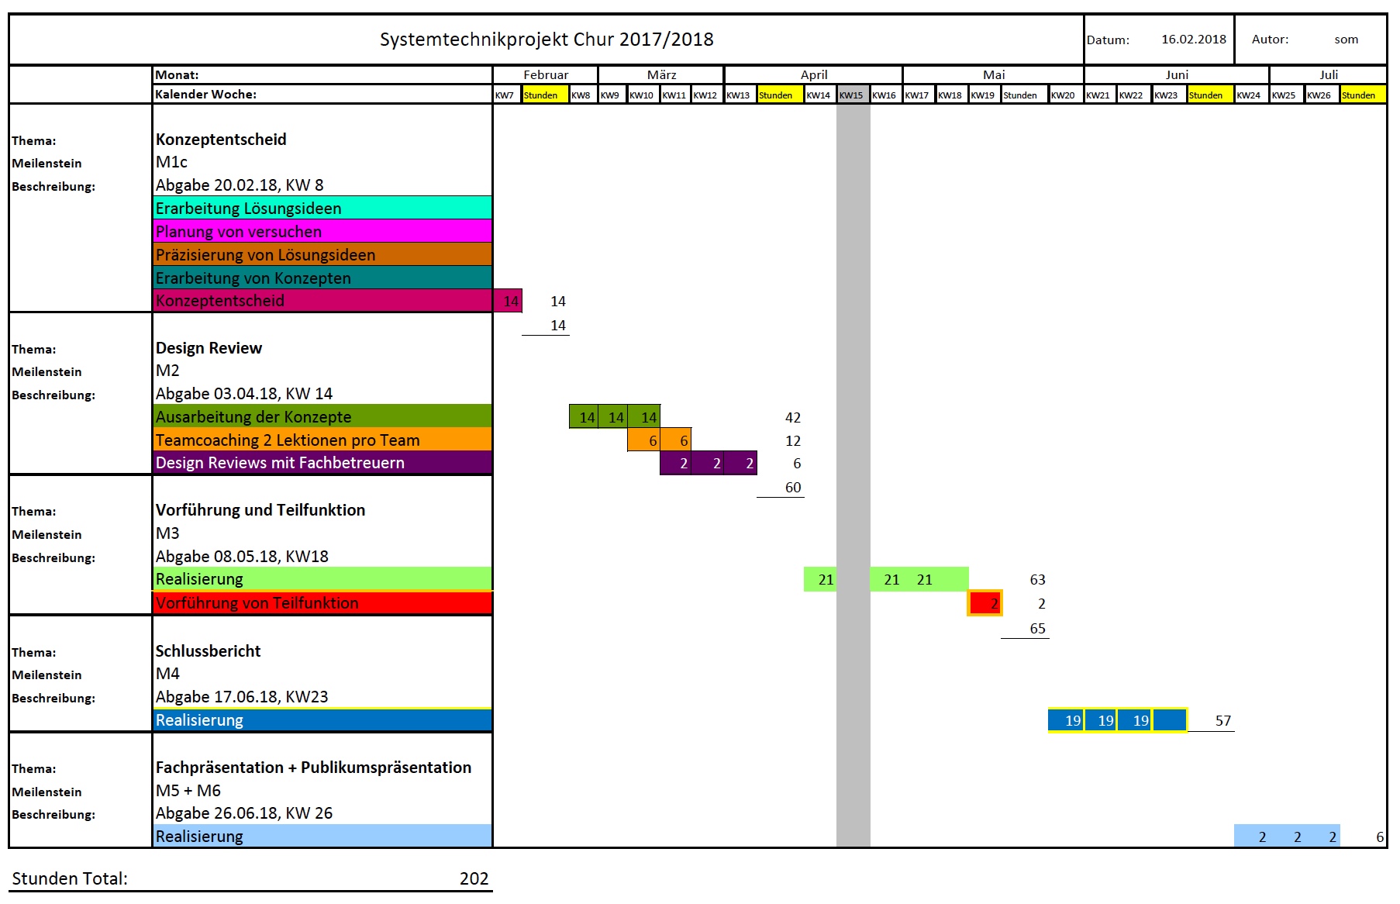
[picture p120: figure]

Meilenstein_M1c

Seite 7/11

20. Februar 2018

## Slide 9

SysP18_Team_10

Aussicht

Team Mechanik
  - Pläne erstellen

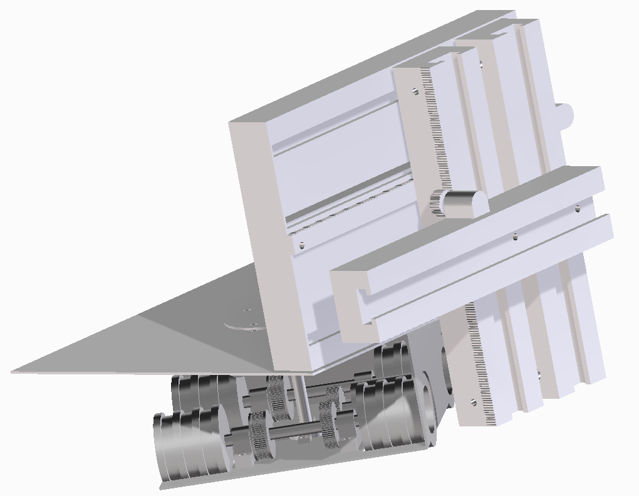
[picture p121: figure]

Meilenstein_M1c

Seite 8/11

20. Februar 2018

## Slide 10

SysP18_Team_10

Aussicht

Team Elektronik
- Bauteile definieren
- Schema zeichnen
- PCB layouten

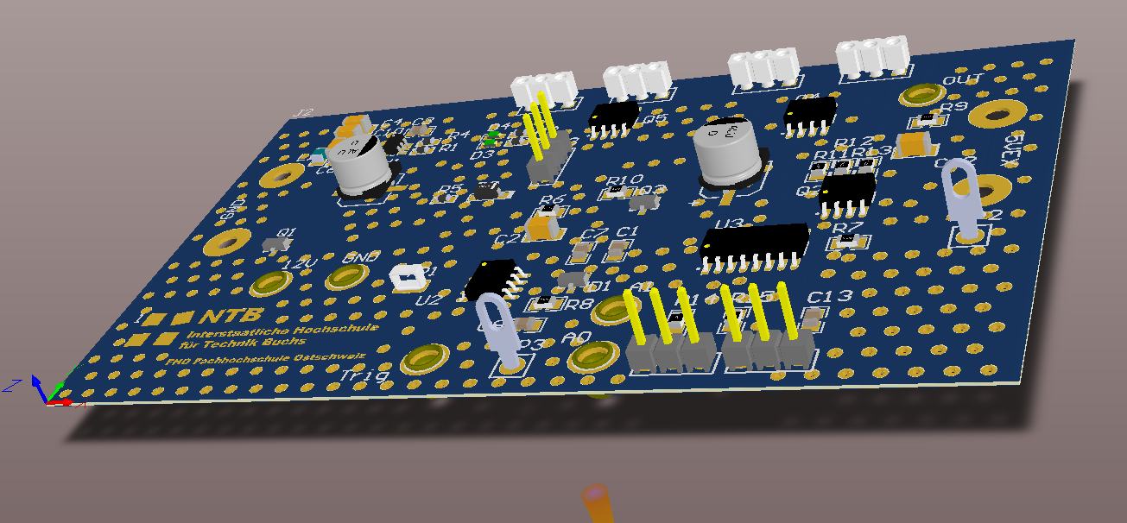
[picture p122: figure]

Meilenstein_M1c

Seite 9/11

20. Februar 2018

## Slide 11

SysP18_Team_10

Aussicht

Team Informatik
- Erste Klassen programmieren
- Kommunikationsprotokoll erarbeiten

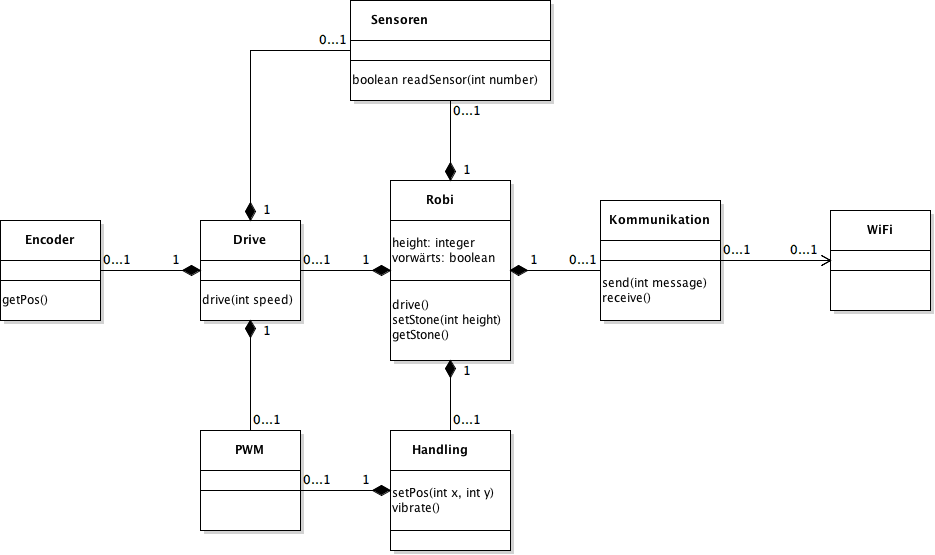
[picture p123: figure]

Meilenstein_M1c

Seite 10/11

20. Februar 2018

## Diskussionsrunde

SysP18_Team_10

Meilenstein_M1c

Seite 11/11

20. Februar 2018
