Unaqwyn/SysP18_1cv/01_Organisation/02_Meilensteine/m3/Alte_Präsentationen/M3 - Vorführung der Teilfunktionen.pptx

## M3 - Vorführung der Teilfunktionen

## Inhalt

- Aktualisierter Zeitplan
- Inbetriebnahme der Teilfunktionen
  - Mechanik
  - Elektronik
  - Informatik
- Diskussion

Notes: Martin 20’’

## Zeitplan: Ausblick

| Zeit/KW | 14 | 15 | 16 | 17 | 18 | 19 | 20 | 21 | 22 | 23 | 24 | 25 | 26 | 27 | 28 | 29 | 30 | 31 | 32 | 33 | 34 | 35 | 36 | 37
Di. 5.04.16 M2
Ferien
Realisierung | 70h | | | 7h | 7h | 7h | 7h | 7h | 7h | 7h | 7h | 7h | 7h
Roboter zusammengestellt
Di. 10.05.16 M3
Roboter präsentationsbereit
So. 19.06.16 M4 Teamleiter
Di. 28.06.16 M5, M6
Abgesetzte Modulschlussprüfungen
Demo Einführungswoche
Legende:
Alle
Meilensteine Abgabe
Teamleiter
Ferien
Meilensteine Teamintern
Modulschlussprüfungen

Notes: Martin

## Mechanik: Aufbau

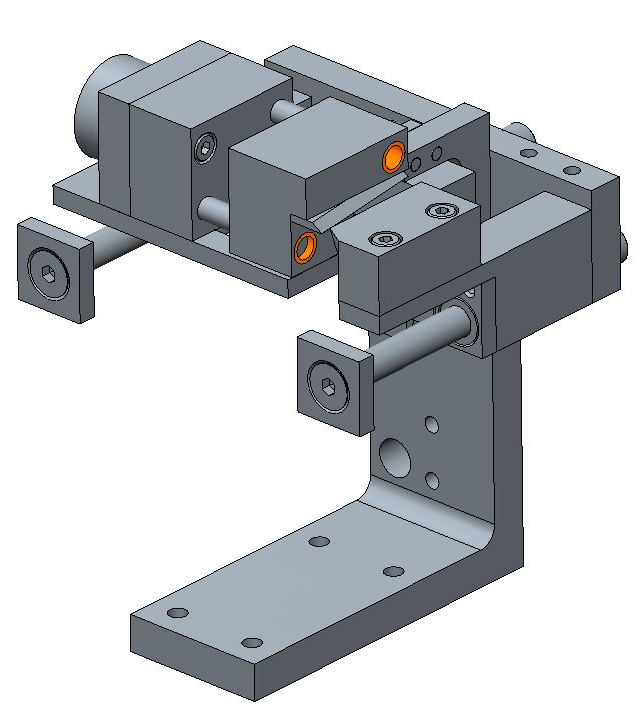
[picture p124: figure]
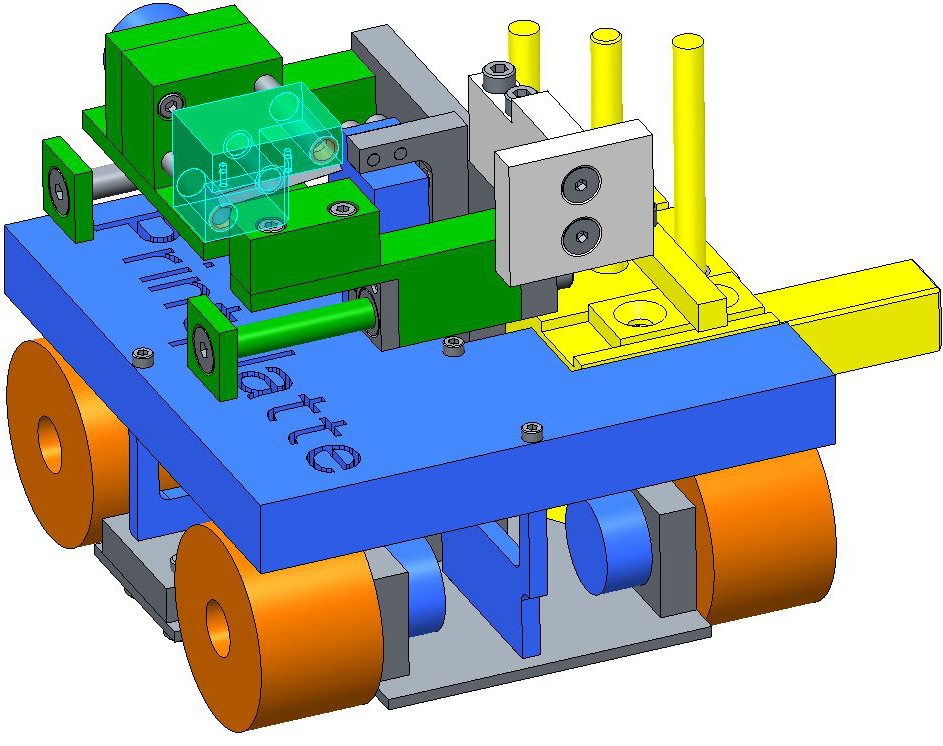
[picture p125: figure]

## Mechanik: Technische Probleme und Lösungen

- Kleine Probleme
- 2 Gewinde in der Grundplatte fehlten
  - Gewinde selber gemacht
  - Schrauben von Hand verkürzt
- Inbetriebnahme grösstenteils reibungslos
- Schneidewerkzeug ist in Fertigung

## Mechanik: Aufbau

Foto Roboter

## Elektronik: Printplatte

Screenshot von PCB

## Elektronik: Technische Probleme und Lösungen

- PCB zur Fertigung aufgegeben
  - Fehlerliste bekommen
  - Fehler behoben, Korrekturen vorgenommen
- Blabla 3

## Informatik: Programm

z.B. Screenshot von Programmteil

## Informatik: Kommunikation mit Partnerroboter

Kommunikationskonzept mit Partnerroboter

## Informatik: Technische Probleme und Lösungen

- Blabla
- Blabla 2
- Blabla 3

## Fazit der Inbetriebnahme der Teilfunktionen

- Mechanik
  - Schneidwerkzeug -> in Auftrag
- Elektronik
  - Printplatte ist auch in Auftrag
- Informatik

## Diskussion

Notes: Ursin
