Unaqwyn/SysP18_1cv/04_Informatik/02_Dokumente/Kommunikationsprotokoll.pdf

Signal-Nr. | Beschreibung | Zusatzinformationen
101…109 | Steingesetzt | Anzahlsteine + 100
222 | Test | Verbindungsaufbau
223 | Test iO | Antwort Verbindungsaufbau
800 | Start | Geht an Leuchtturmspitze und Partnerroboter
801 | Stopp_1 | Stopp von Roboter Team 10
802 | Stopp_2 | Stopp von Roboter Team 2 / 3

## Kommunikationsprotokoll
