Unaqwyn/SysP18_1cv/00_Infos/00_Typo3/EinfÅhrung_Typo3.pdf

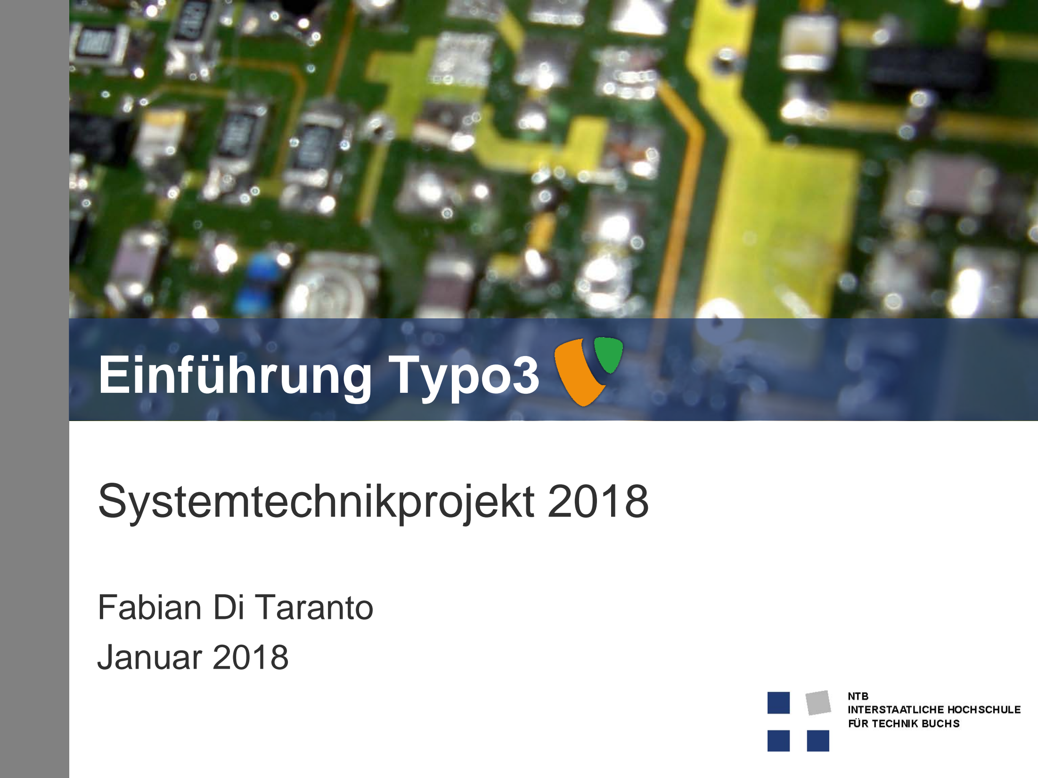
[picture p128: page 1]

# Einführung Typo3

## Systemtechnikprojekt 2018

### Fabian Di Taranto Januar 2018

## Einführung Typo3:

Überblick dieser Präsentation

### 1. Web Content Management System (WCMS)

- Allgemeines über WCMS-Systeme

### 2. SysP-Teamwebseite

- Anforderungen

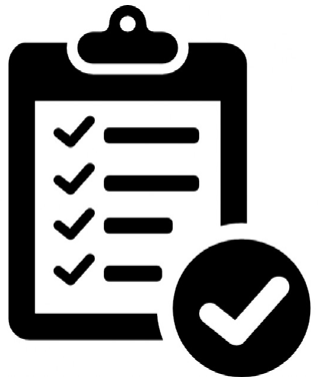
[picture p129: figure]

### 3. Typo3: Die ersten Schritte

- Tutorial

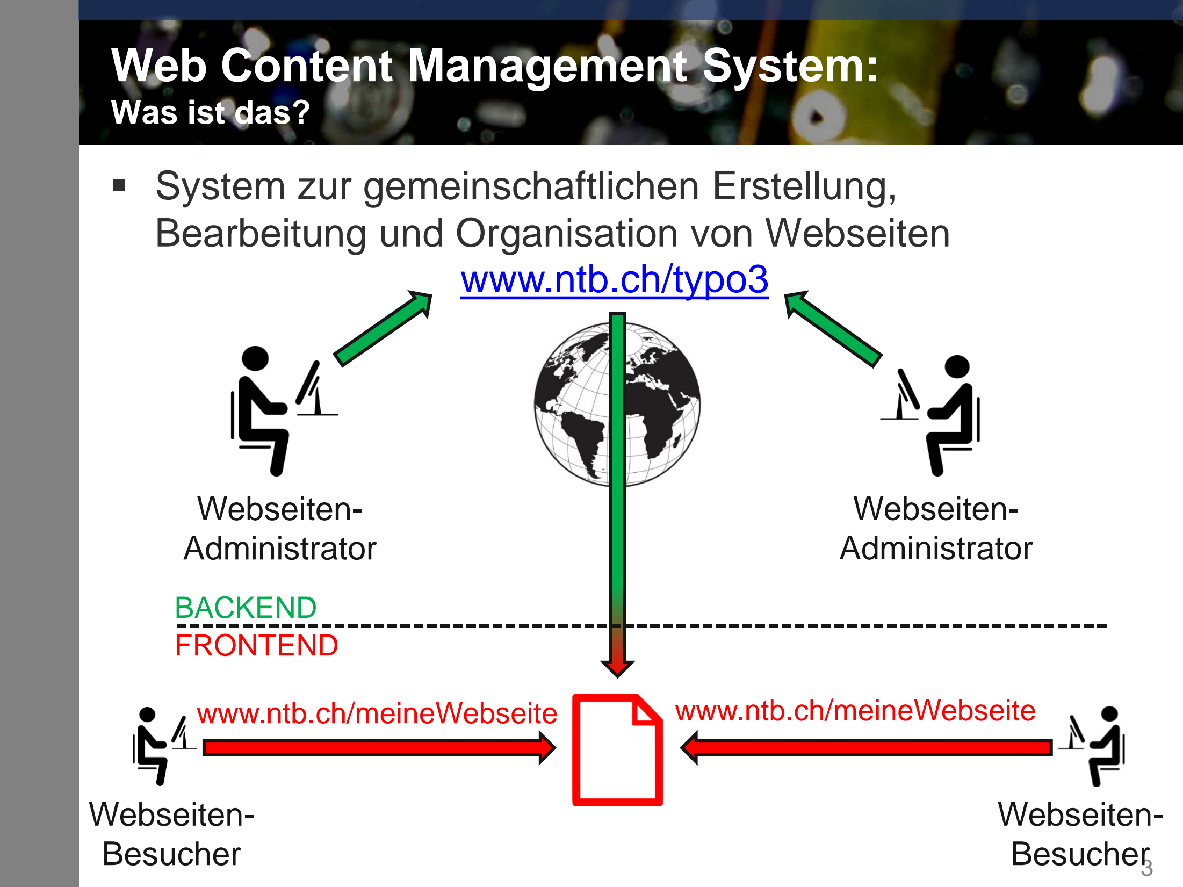
[picture p130: figure]
Web Content Management System: Was ist das?; www.ntb.ch/typo3; Webseiten- Administrator; www.ntb.ch/meineWebseite; Webseiten- Besucher; FRONTEND; BACKEND

- System zur gemeinschaftlichen Erstellung,

### Bearbeitung und Organisation von Webseiten

## Web Content Management System:

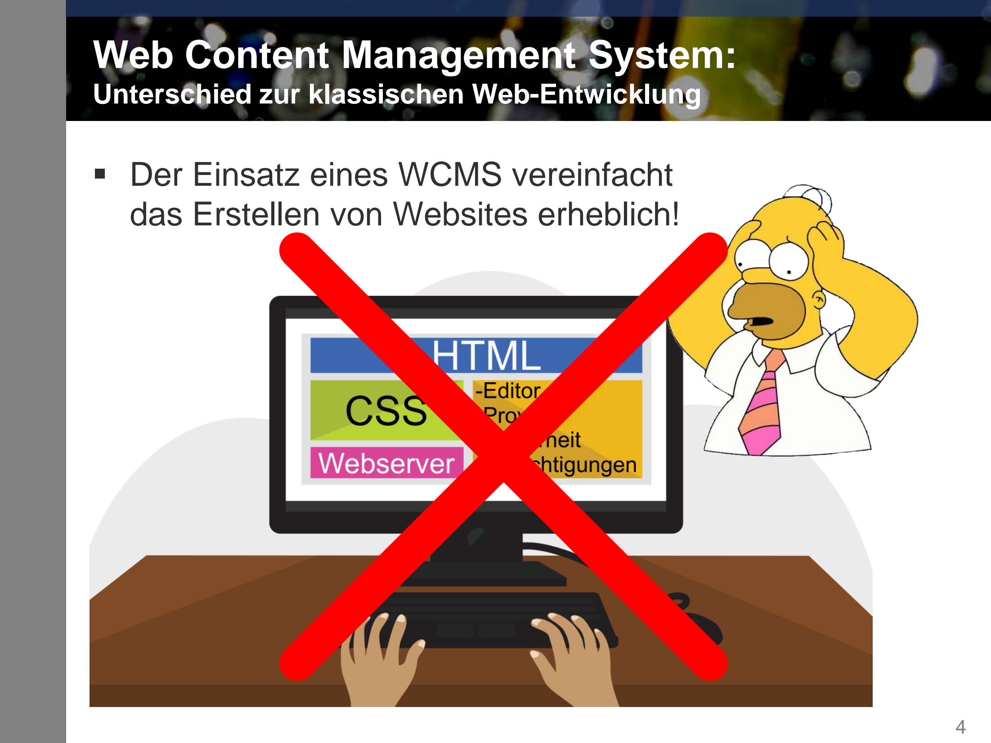
[picture p131: page 4]

### - Der Einsatz eines WCMS vereinfacht das Erstellen von Websites erheblich!

Unterschied zur klassischen Web-Entwicklung

## Web Content Management System:

Wesentliche Vor- und Nachteile

### - Vorteile:

- Plattformunabhängig
- Dynamische Erstellung der Webseiten in «Echtzeit»
- Einfache, weltweite Administration via Browser möglich
- Strikte Trennung von Inhalt, Funktion und Design
- Gestaltungsvorgaben können erzwungen werden
- Kostenersparnisse
- Keine Code-Kenntnisse vonnöten

### - Nachteile:

- Webdesign-Möglichkeiten klar eingeschränkt
- Gewöhnungsbedürftige Bedienung
- Jeder WCMS-Hersteller «kocht sein eigenes Süppchen» (z.B. Typo3, Joomla, Drupal, …)
- Abhängigkeiten zum gewählten WCMS-Anbieter

## Anforderungen:

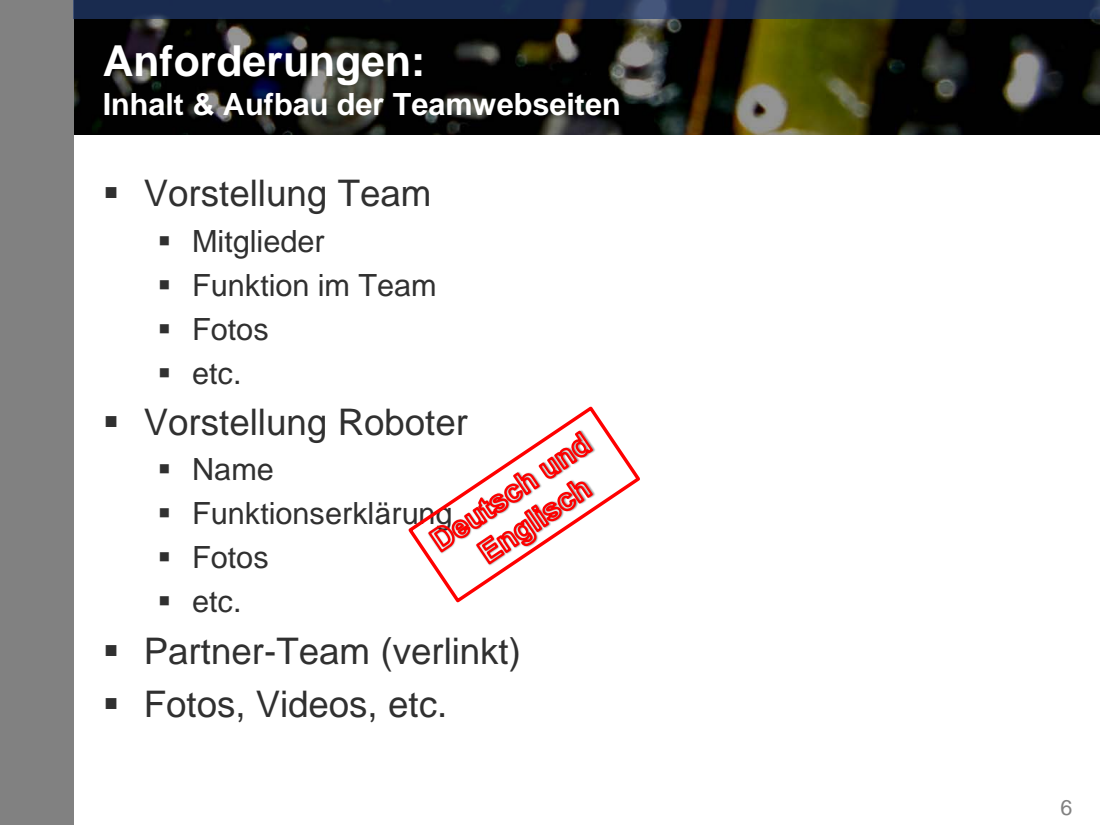
[picture p132: page 6]

Inhalt & Aufbau der Teamwebseiten
▪ Vorstellung Team
▪ Mitglieder
▪ Funktion im Team
▪ Fotos
▪ etc.
▪ Vorstellung Roboter
▪ Name
▪ Funktionserklärung
▪ Partner-Team (verlinkt)
▪ Fotos, Videos, etc.

### - Das gilt es zu beachten:

- Quellenangaben für nicht selbst erstellte Inhalte
- Keine Werbeeinblendungen
- Nur wirklich relevante externe Links
- Keine I-Like-This-Buttons, «Google +1»-Buttons oder ähnliches
- Keine Hintergrundmusik

## Anforderungen:

Inhalt & Aufbau der Teamwebseiten

Weitere Details zu den Anforderungen Ihrer Webseite finden Sie im Systemtechnikprojekt-Leitfaden auf Seite 15, vierter Abschnitt.

## Erste Schritte:

Demonstration

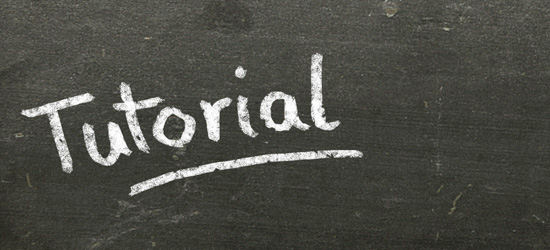
[picture p133: figure]

### - Tutorial-Dateien via Browser herunterladen: -Typo3_KursUnterlagen.zip

# https://moodle.ntb.ch

### - Typo3-Backend via Browser öffnen + einloggen mit persönlichem NTB-Studenten-Account:

# https://www.ntb.ch/typo3

## Tutorial:

Erste Schritte

### - Typo3 bietet die Möglichkeit, Seiten mehrsprachig

zu erstellen.

### - Der Benutzer kann zwischen den Sprachen der

Webseite umschalten.

### - Auf NTB-Webseite: Funktioniert nur, wenn auch eine englische Version hinterlegt ist:

## Tutorial: Mehrsprachige Webseite

Allgemeines

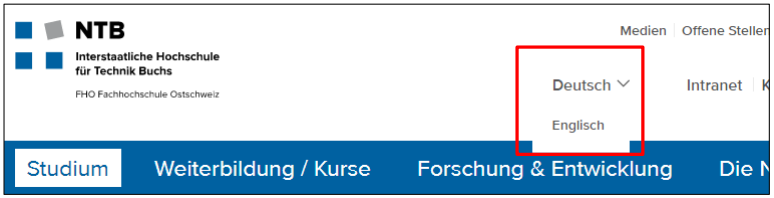
[picture p134: figure]

## Tutorial: Mehrsprachige Webseite

Allgemeines

- Erstellen der Masterseite immer in Deutsch.
- Anschliessend ausgewählte Seiten und Elemente übersetzen.
- Seiten, für welche keine Übersetzung angelegt wurde, werden in der «fremden» Sprache nicht angezeigt.
- Nicht übersetzte Elemente einer übersetzten Seite werden in der «Default»-Sprache angezeigt. Das ist unschön. Deshalb sollten ALLE Elemente einer Seite übersetzt oder nicht zu übersetzende Elemente gelöscht werden.
- Es existiert kein Übersetzungs-Automatismus wie z.B. «Google-Translator». Englische Übersetzungen müssen manuell vorgenommen werden!

## Tutorial: Mehrsprachige Webseite

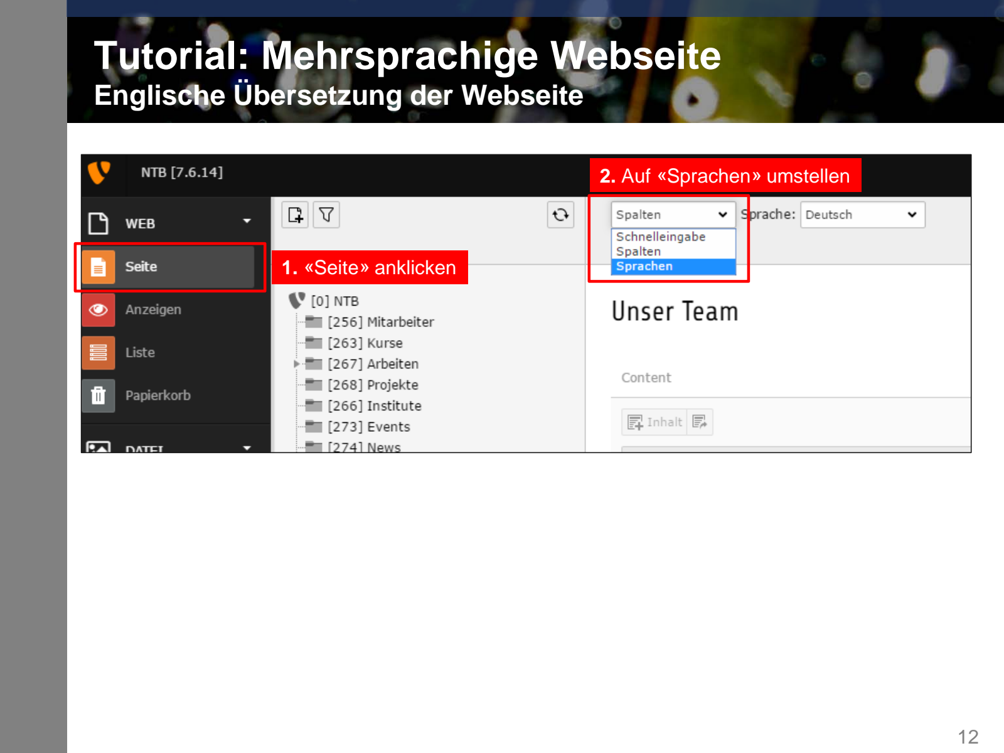
[picture p135: page 12]

### 2. Auf «Sprachen» umstellen

Englische Übersetzung der Webseite

1. «Seite» anklicken

## Tutorial: Mehrsprachige Webseite

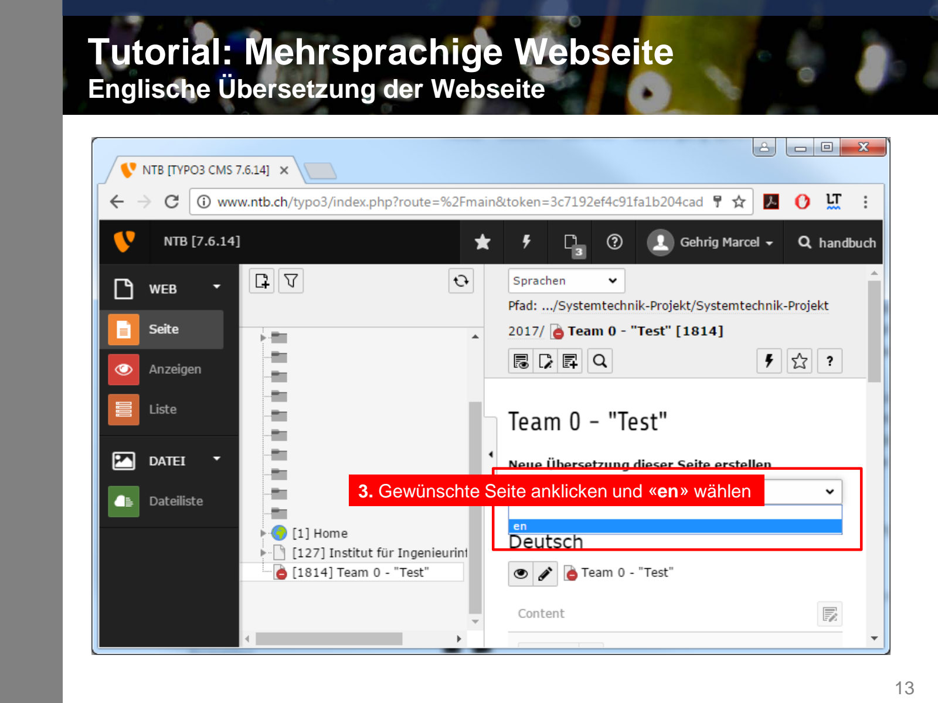
[picture p136: page 13]

### 3. Gewünschte Seite anklicken und «en» wählen

Englische Übersetzung der Webseite

## Tutorial: Mehrsprachige Webseite

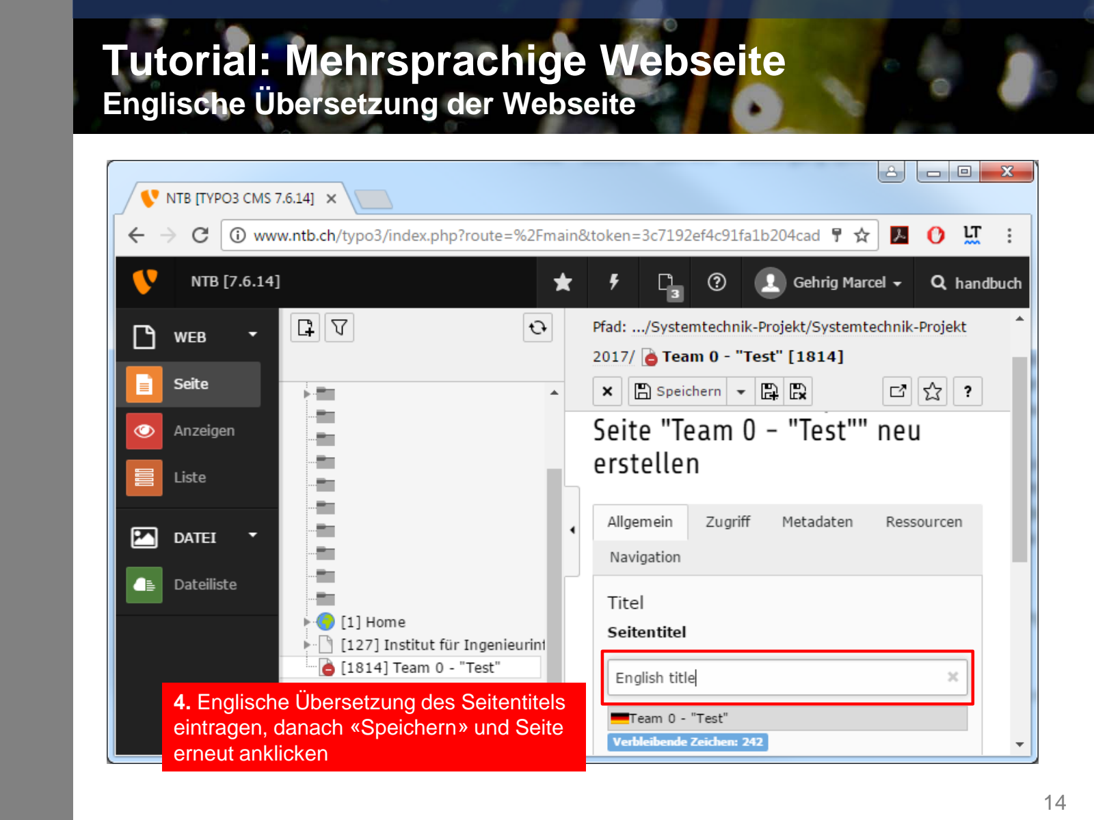
[picture p137: page 14]

### 4. Englische Übersetzung des Seitentitels

eintragen, danach «Speichern» und Seite erneut anklicken

Englische Übersetzung der Webseite

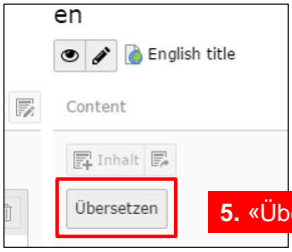
[picture p138: figure]

5. «Übersetzen»
6. «Translate»

## Tutorial: Mehrsprachige Webseite

Englische Übersetzung der Webseite

7. «Nächster» und

«Verarbeitung beginnen»

## Tutorial: Mehrsprachige Webseite

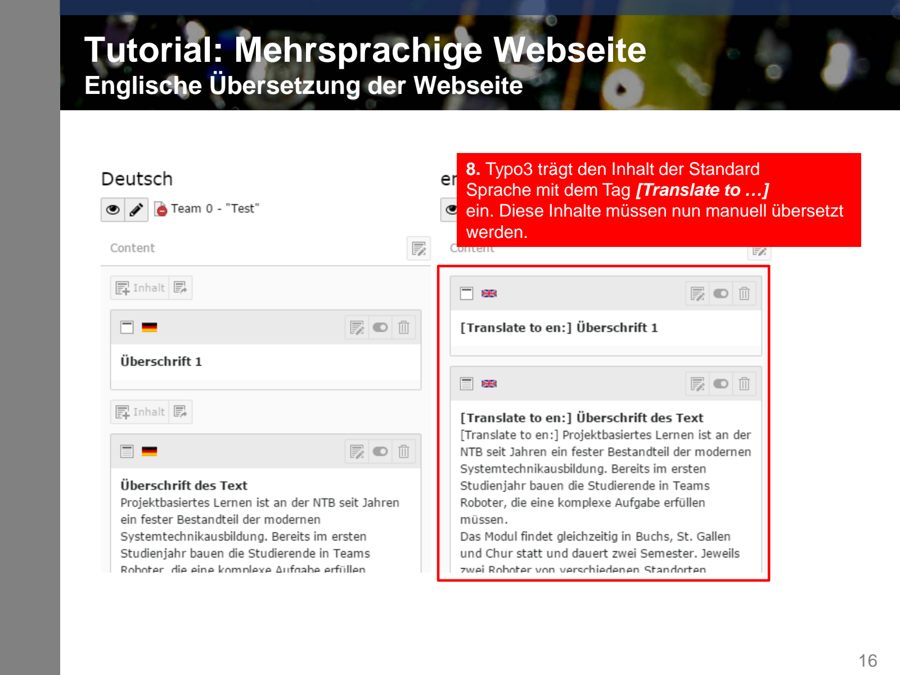
[picture p139: page 16]

### 8. Typo3 trägt den Inhalt der Standard

Sprache mit dem Tag [Translate to …]
ein. Diese Inhalte müssen nun manuell übersetzt werden.

Englische Übersetzung der Webseite

## Tutorial:

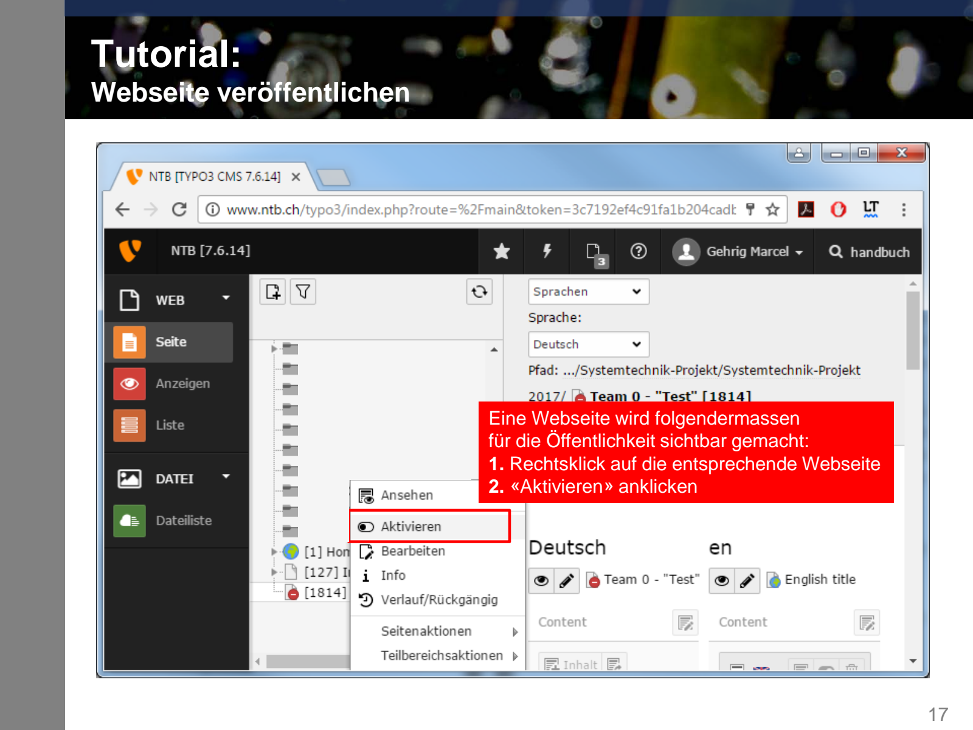
[picture p140: page 17]

Eine Webseite wird folgendermassen
für die Öffentlichkeit sichtbar gemacht:

### 1. Rechtsklick auf die entsprechende Webseite

2. «Aktivieren» anklicken

Webseite veröffentlichen

## Tutorial:

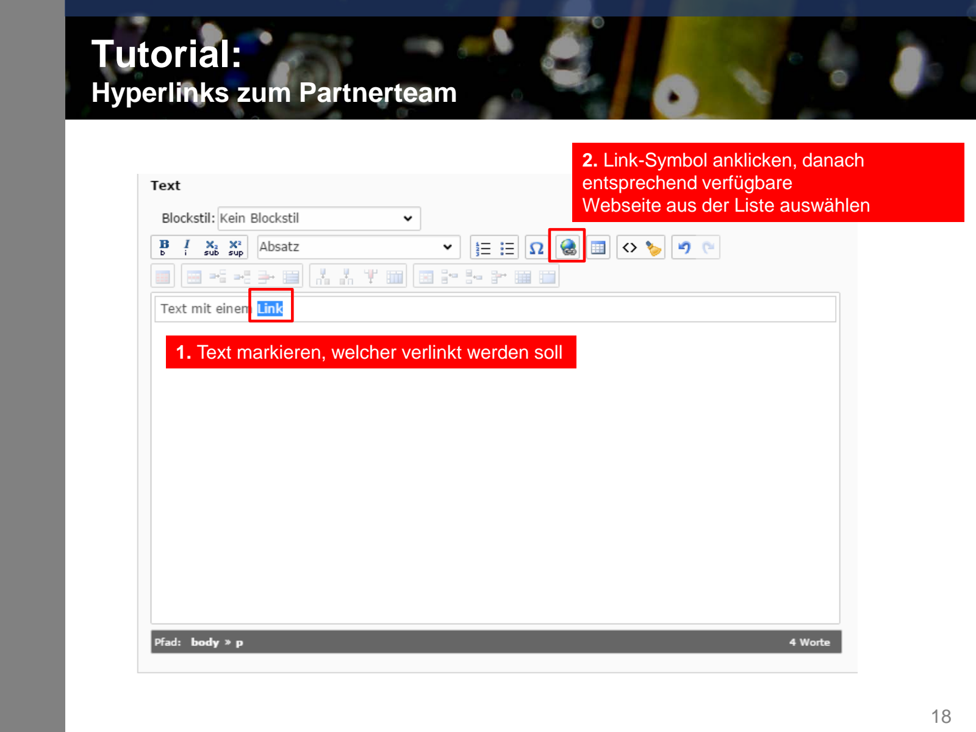
[picture p141: page 18]

### 2. Link-Symbol anklicken, danach

entsprechend verfügbare
Webseite aus der Liste auswählen

Hyperlinks zum Partnerteam

### 1. Text markieren, welcher verlinkt werden soll

## Tutorial:

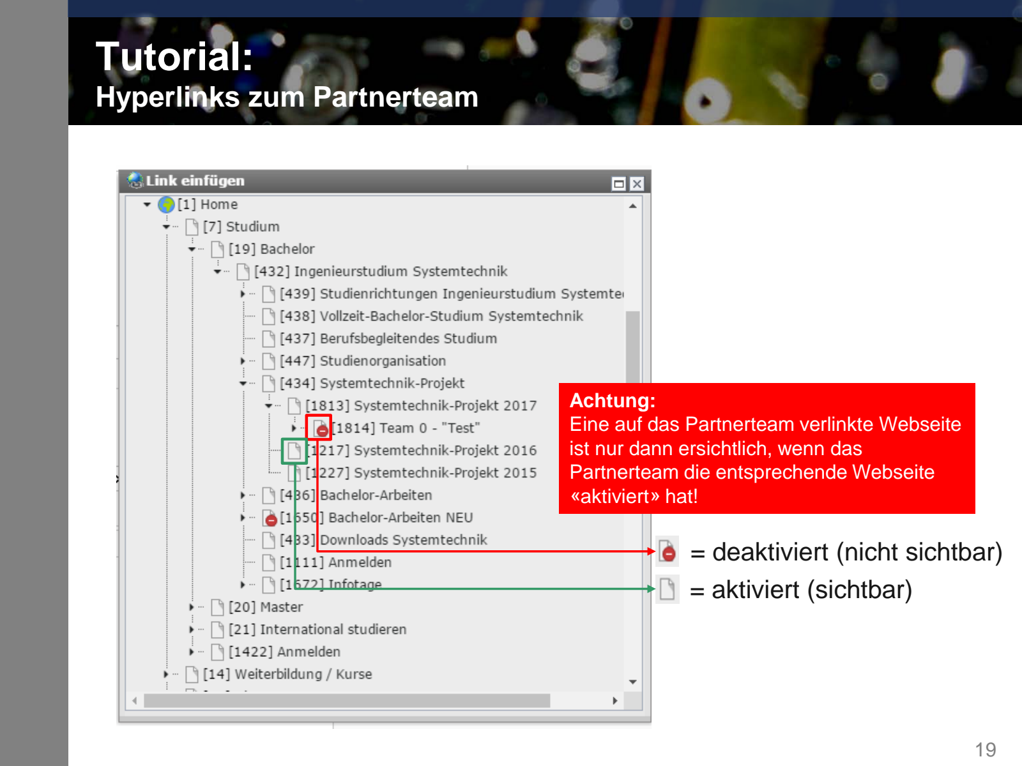
[picture p142: page 19]

Achtung:
Eine auf das Partnerteam verlinkte Webseite ist nur dann ersichtlich, wenn das Partnerteam die entsprechende Webseite «aktiviert» hat!
= deaktiviert (nicht sichtbar) = aktiviert (sichtbar)

Hyperlinks zum Partnerteam

## Tutorial:

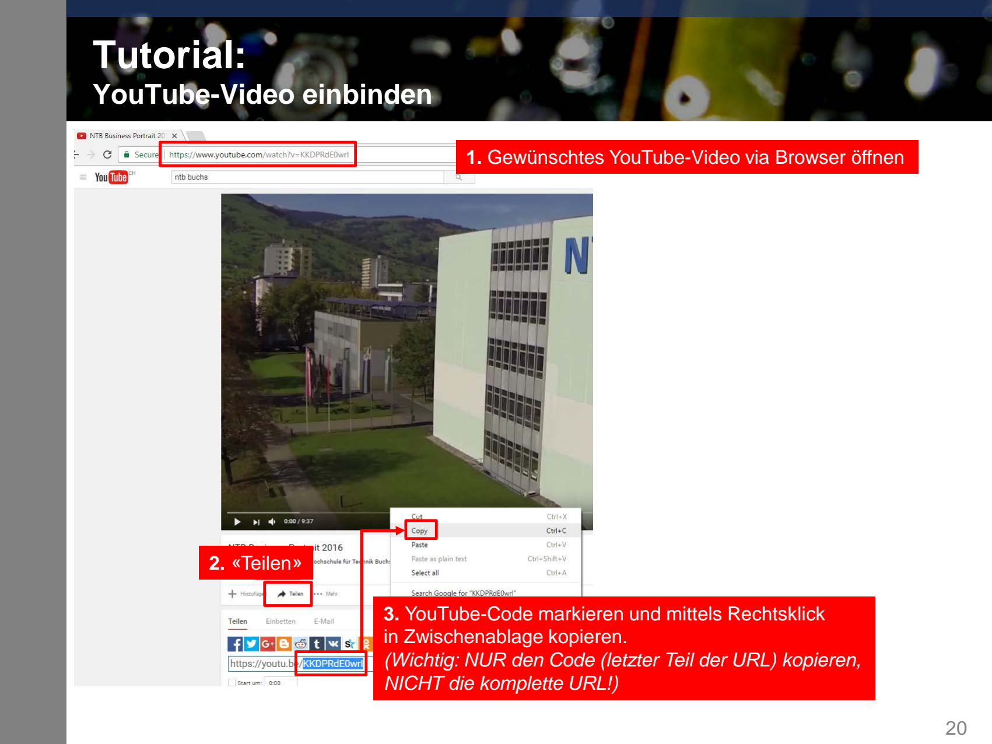
[picture p143: page 20]

YouTube-Video einbinden

### 1. Gewünschtes YouTube-Video via Browser öffnen

2. «Teilen»

### 3. YouTube-Code markieren und mittels Rechtsklick

in Zwischenablage kopieren.
(Wichtig: NUR den Code (letzter Teil der URL) kopieren, NICHT die komplette URL!)

## Tutorial:

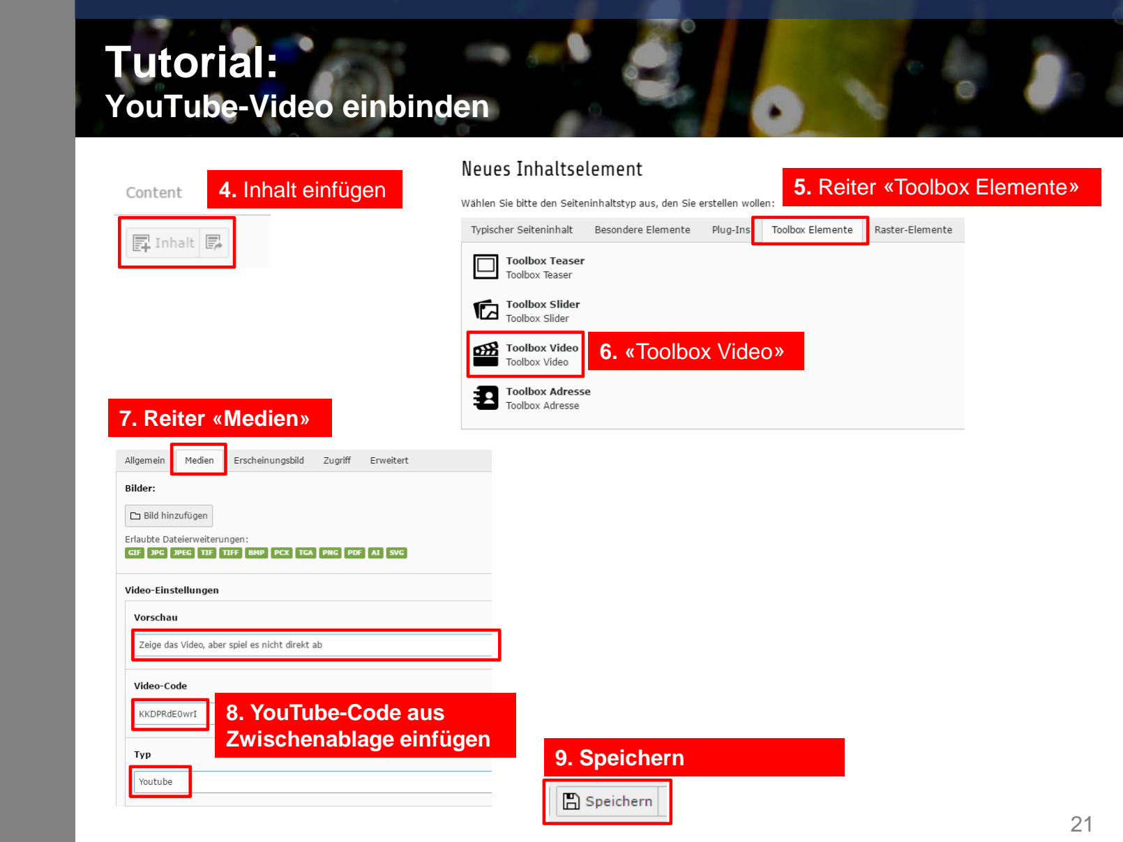
[picture p144: page 21]

4. Inhalt einfügen | 5. Reiter «Toolbox Elemente»
6. «Toolbox Video»

### 7. Reiter «Medien»

### 8. YouTube-Code aus

Zwischenablage einfügen 9. Speichern

YouTube-Video einbinden

## Allgemeine Informationen

### - Dokumentation/Hilfe:

- Dokumentation auf der Projektseite. Besonders zu empfehlen sind folgende Tutorials: http://typo3.org/documentation/document-library/
- Typo3 an der NTB:
https://intranet.ntb.ch/ntb-von-a-z/inhalte-a-z/typo3-support.html (https://intranet.ntb.ch/ntb-von-a-z/inhalte-a-z/typo3-support.html)

### - Für Fragen:

- Fabian Di Taranto (fabian.ditaranto@ntb.ch)
- Marcel Gehrig (marcel.gehrig@ntb.ch)
- Roland Seeger (roland.seeger@ntb.ch)
- Franz Vinzenz (www.ntb.ch/stoerungsmeldung oder franz.vinzenz@ntb.ch)

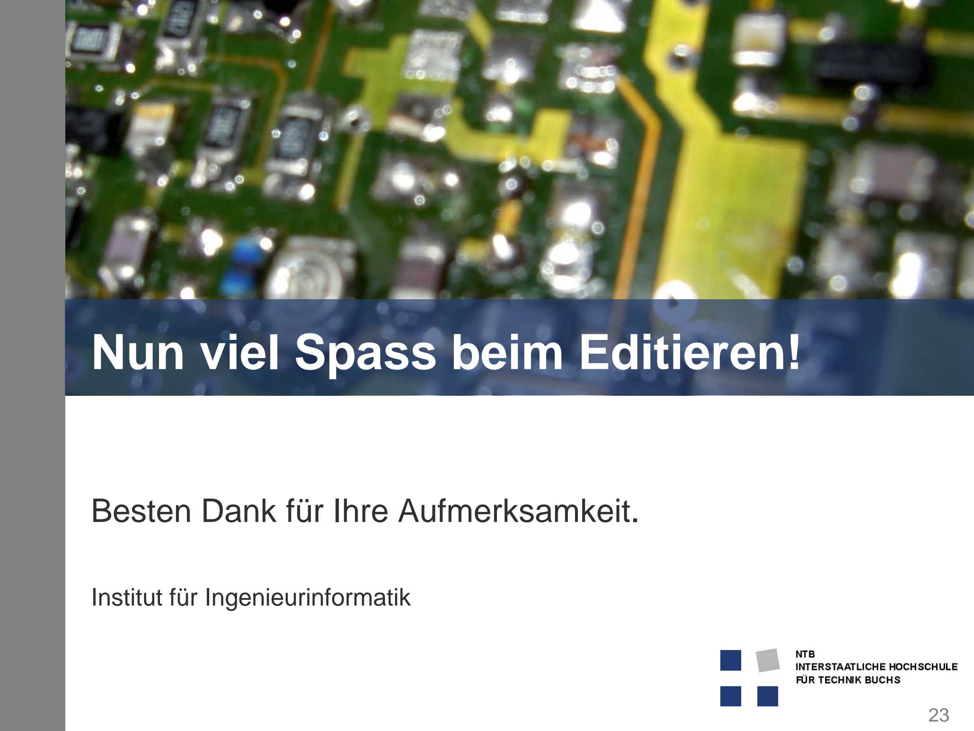
[picture p145: page 23]

Besten Dank für Ihre Aufmerksamkeit.

Institut für Ingenieurinformatik

# Nun viel Spass beim Editieren!
