Unaqwyn/SysP18_1cv/04_Informatik/99_Altes_Programm/Aktuelle_Dokumente/Quelltextformatierung.pdf

## Quelltextformatierung

- Bei Konstruktoren die geschweiften Klammern auf separater Zeile setzen.
- Bei Methoden, Schleifen etc. die geschweifte Klammer (nach links gerichtet) auf der obersten Zeile schreiben.
- Nach jeder geschweiften Klammer (nach links gerichtet) auf der nächsten Zeile einrücken.
- Bei mathematischen Operatoren links und rechts einen Abstand einfügen.
- Einrücken mit Tabulatorzeichen.
- Nur eine Anweisung pro Zeile.
- Variablen mit gleichen Anfangswerten auf einzelne Zeilen schreiben.
- Kurzformen wie i++ als Zähler in Ordnung, ansonsten die ausgeschriebene Form i = i + 1
- Zeilenlänge auf 80 Zeichen begrenzen
- Right-hand-comparison (die Variable steht links, die Zahl rechts)

## Namenskonvention

Typ | Schreibstil
Klassen | UpperCamelCase
Methoden | lowerCamerCase
Variablen | lowerCamelCase
Parameter | lowerCamelCase
Konstanten | GROSSBUCHSTABEN
Sondierende Methoden | getBlabla

Sprache der Klassen-, Methoden-, Variablennamen etc.: Englisch

Sprache der Kommentare: Englisch
