Unaqwyn/SysP18_1cv/04_Informatik/99_Altes_Programm/Aktuelle_Dokumente/CD/Kommunikationstabelle.pdf

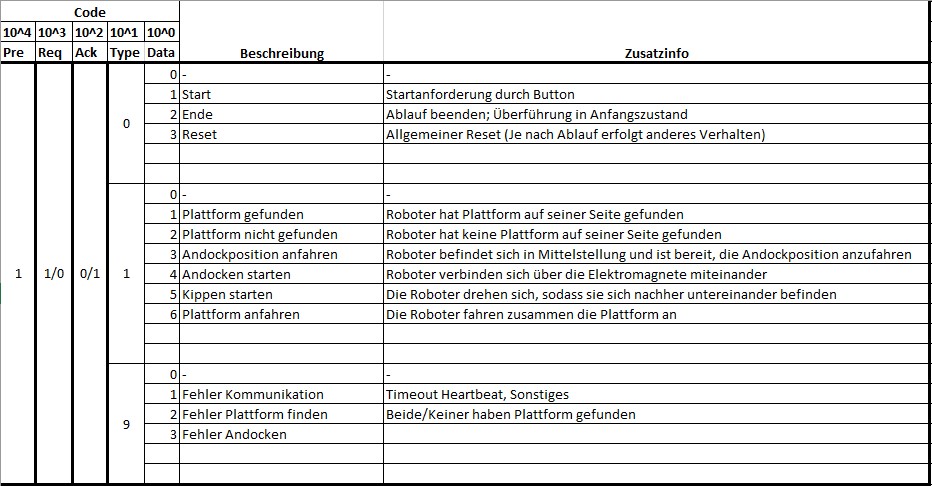
[picture p146: figure]
