Unaqwyn/SysP18_1cv/01_Organisation/02_Meilensteine/m4/SySP18-Team10-Anhang/Abgabe Elektonik/Abgabe PDF/Motortreiber, Spannungsversorgung PDF/Spannungsregler.pdf

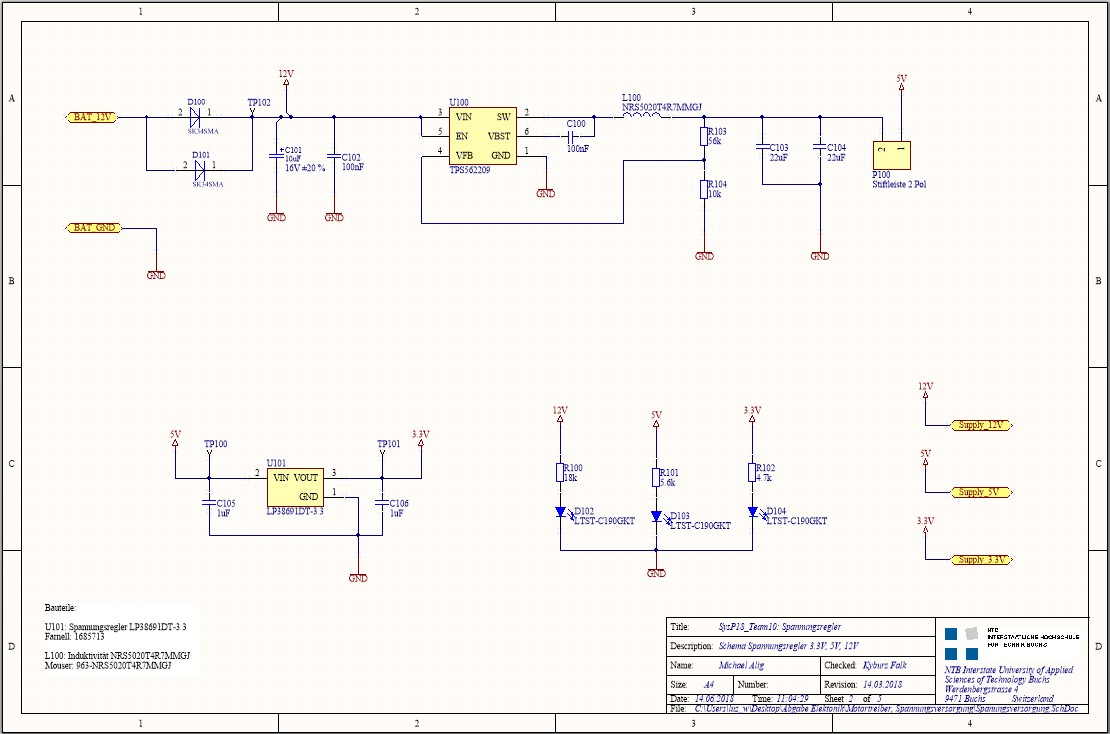
[picture p151: figure]
