Unaqwyn/SysP18_1cv/01_Organisation/02_Meilensteine/m4/SySP18-Team10-Anhang/Abgabe Elektonik/Abgabe PDF/MPC555undSensoren Bestellung PDF/PCB_MPC555_Sensoren.pdf

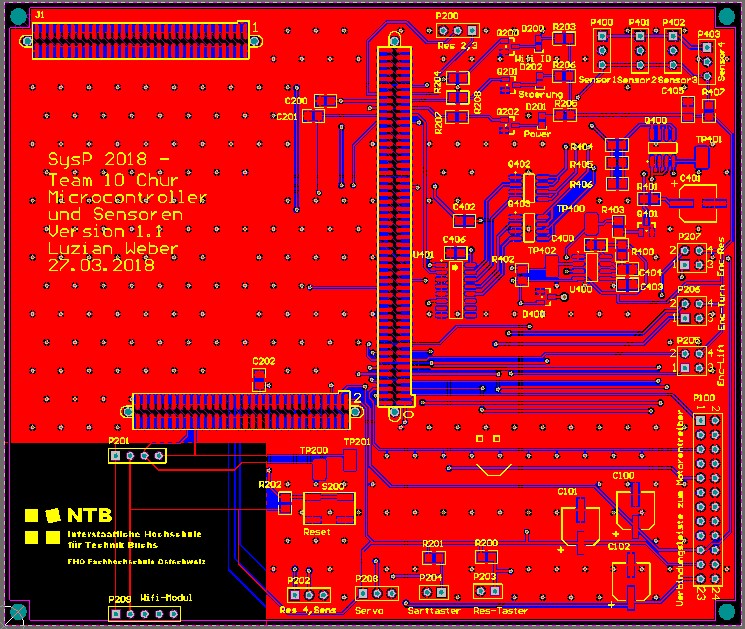
[picture p154: figure]
