Unaqwyn/SysP18_1cv/01_Organisation/02_Meilensteine/m4/SySP18-Team10-Anhang/Abgabe Elektonik/Abgabe PDF/MPC555undSensoren Bestellung PDF/TopSheet_MPC_Sensoren.pdf

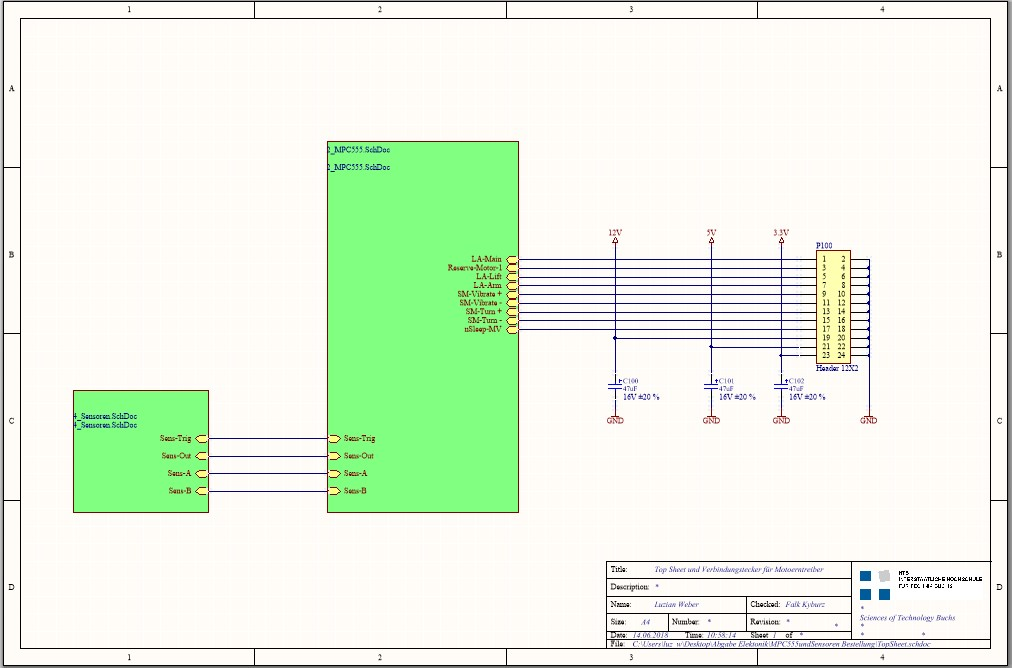
[picture p156: figure]
