Unaqwyn/SysP18_1cv/00_Diverses/Roboter_2.png

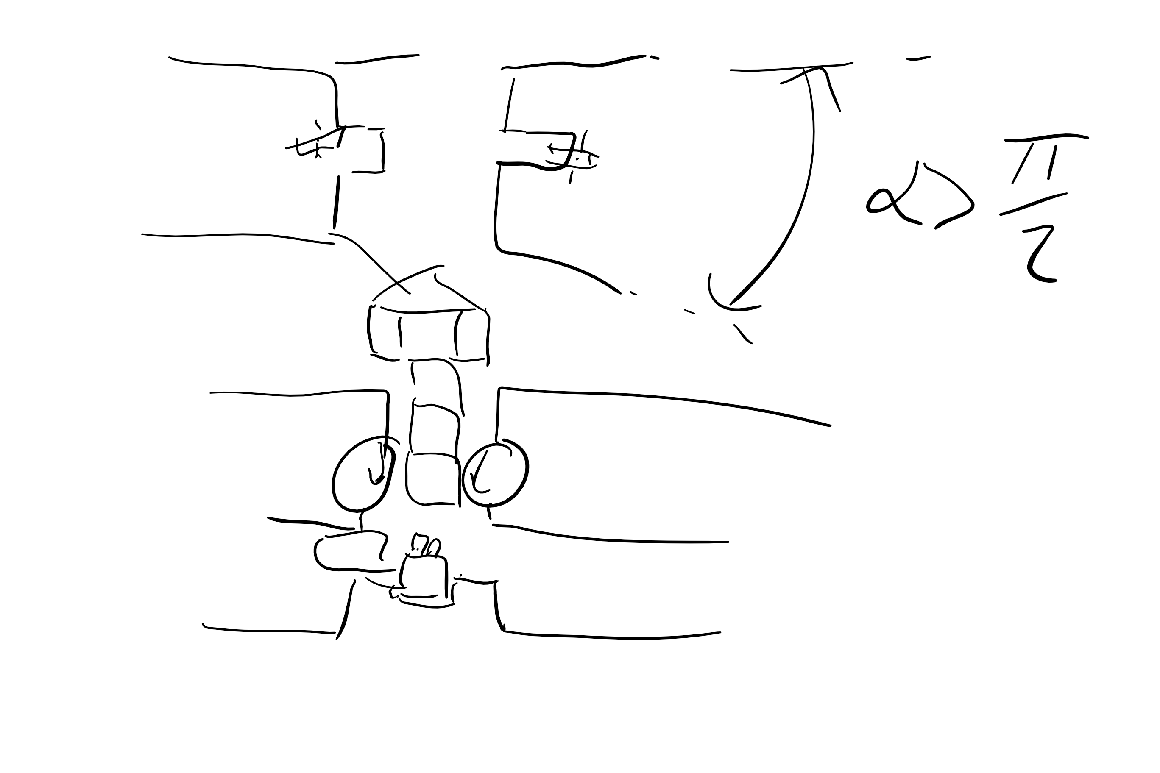
00_Diverses/Roboter_2.png
