Unaqwyn/SysP18_1cv/00_Infos/00_Typo3/AbrahamSimpson.png

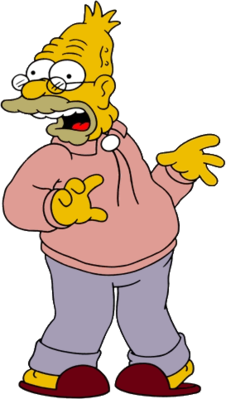
00_Infos/00_Typo3/AbrahamSimpson.png
