Unaqwyn/SysP18_1cv/00_Infos/00_Typo3/MargeSimpson.png

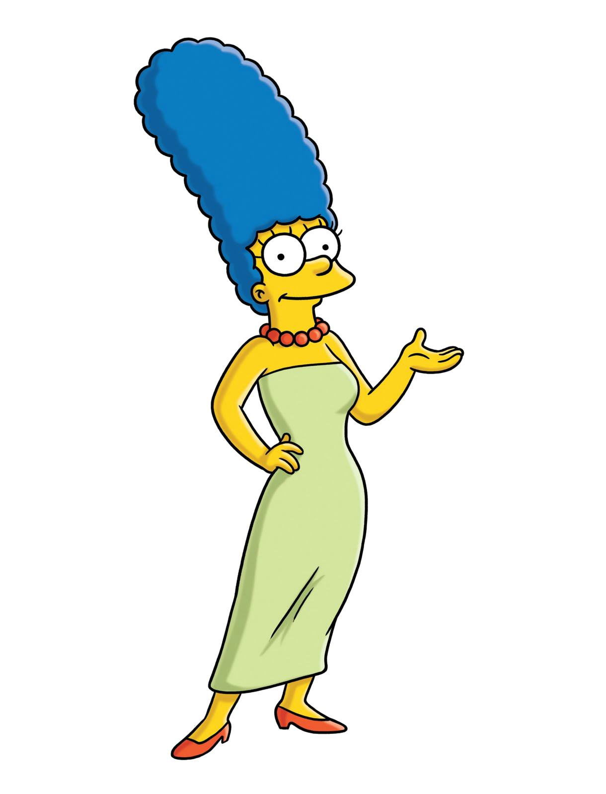
00_Infos/00_Typo3/MargeSimpson.png
