Unaqwyn/SysP18_1cv/01_Organisation/02_Meilensteine/06_Datenblätter/02_Mechanik/PrtScn Motoren.PNG

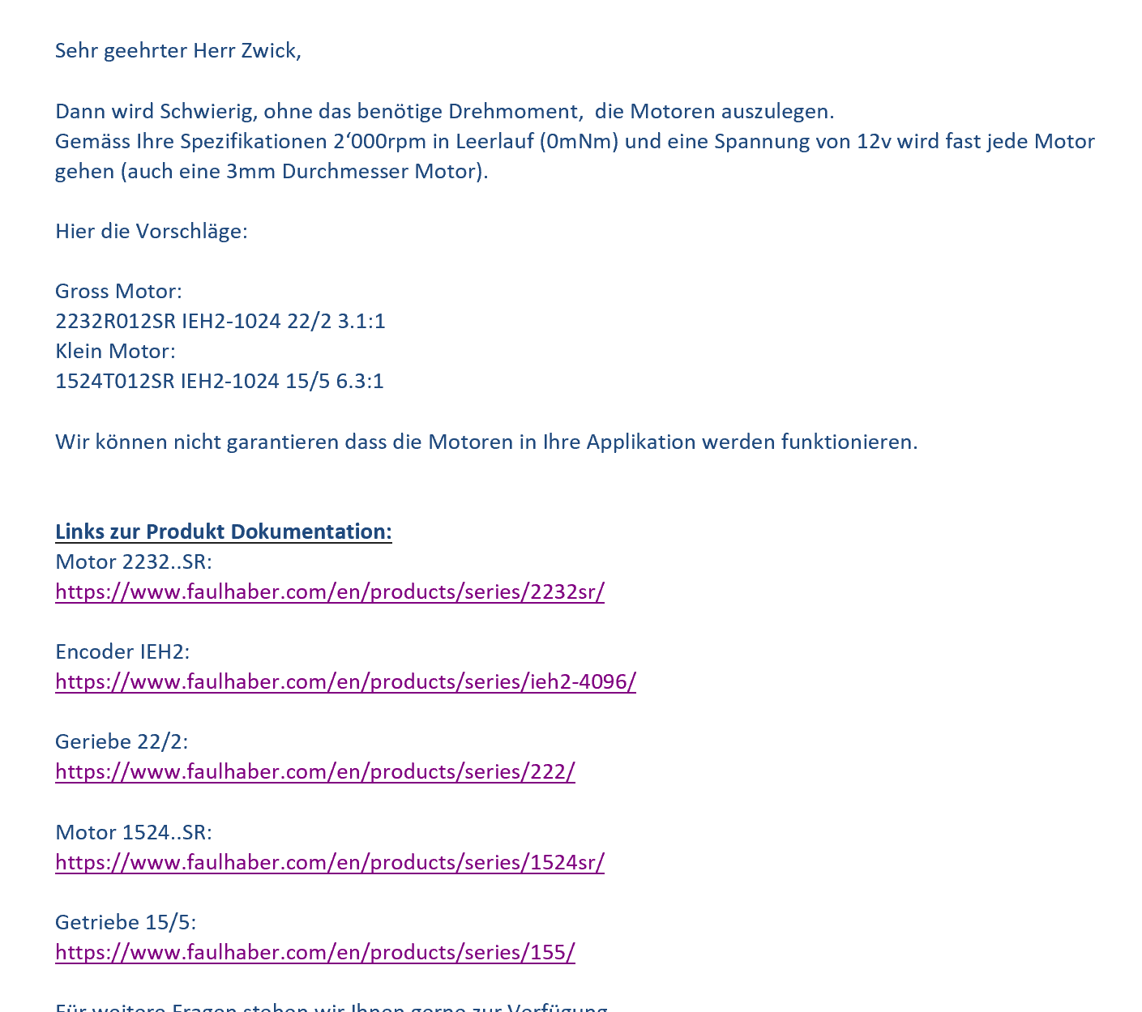
01_Organisation/02_Meilensteine/06_Datenblätter/02_Mechanik/PrtScn Motoren.PNG
