Unaqwyn/SysP18_1cv/01_Organisation/02_Meilensteine/m1a/01_Systembeschreibung/Systembeschreibung_Graphik_V1_2017_10_08_LST.jpg

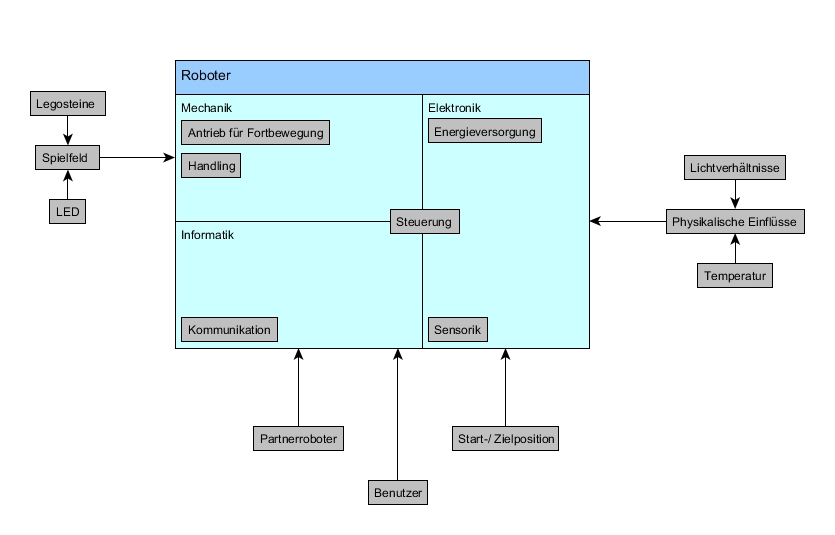
01_Organisation/02_Meilensteine/m1a/01_Systembeschreibung/Systembeschreibung_Graphik_V1_2017_10_08_LST.jpg
