Unaqwyn/SysP18_1cv/01_Organisation/02_Meilensteine/m1c/Bilder/3D_2.png

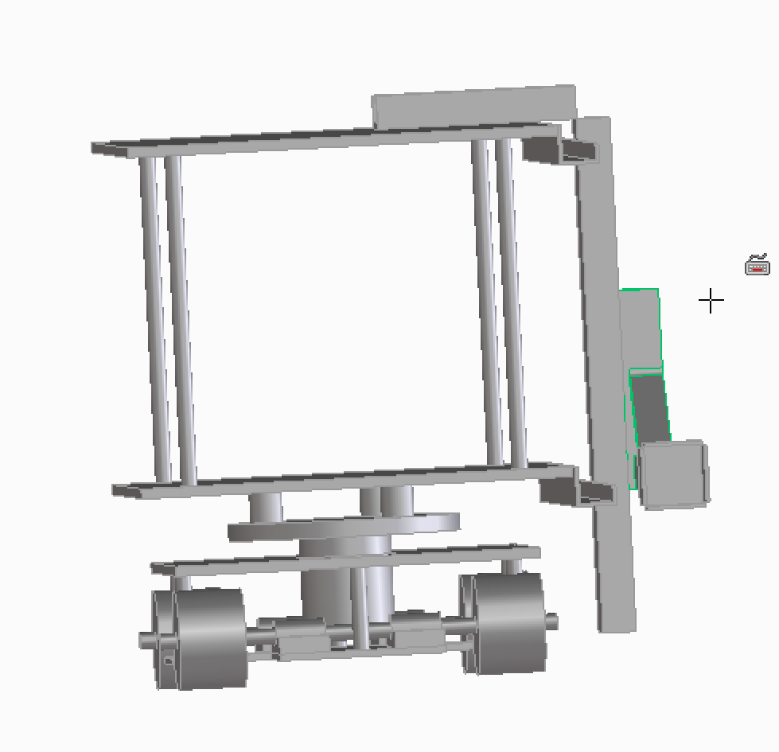
01_Organisation/02_Meilensteine/m1c/Bilder/3D_2.png
