Unaqwyn/SysP18_1cv/01_Organisation/02_Meilensteine/m1c/Bilder/20180219_171103.jpg

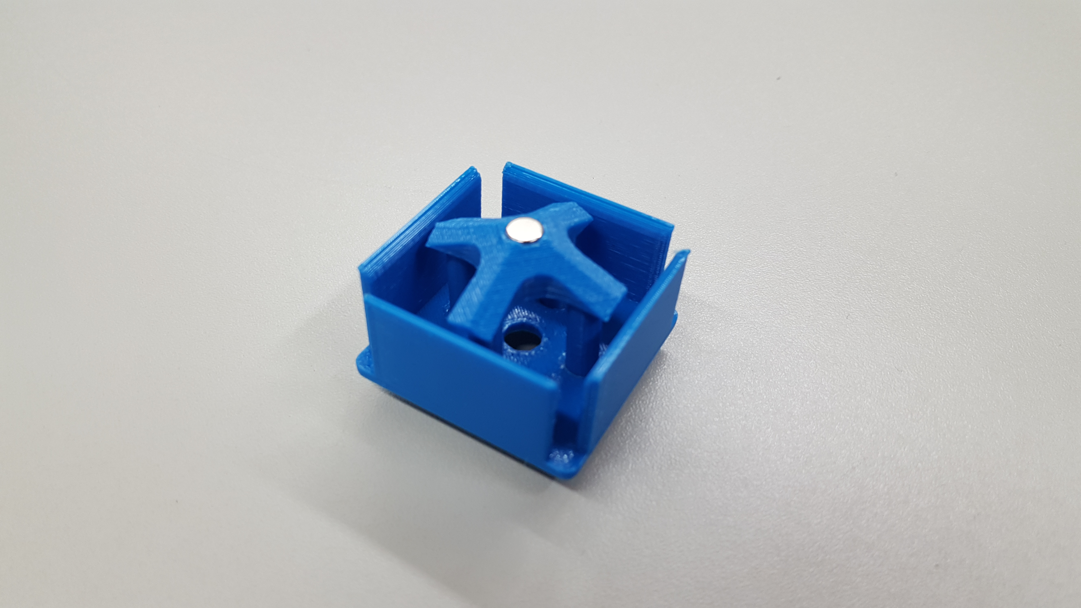
01_Organisation/02_Meilensteine/m1c/Bilder/20180219_171103.jpg
