Unaqwyn/SysP18_1cv/01_Organisation/02_Meilensteine/m1c/Bilder/Activity diagram.png

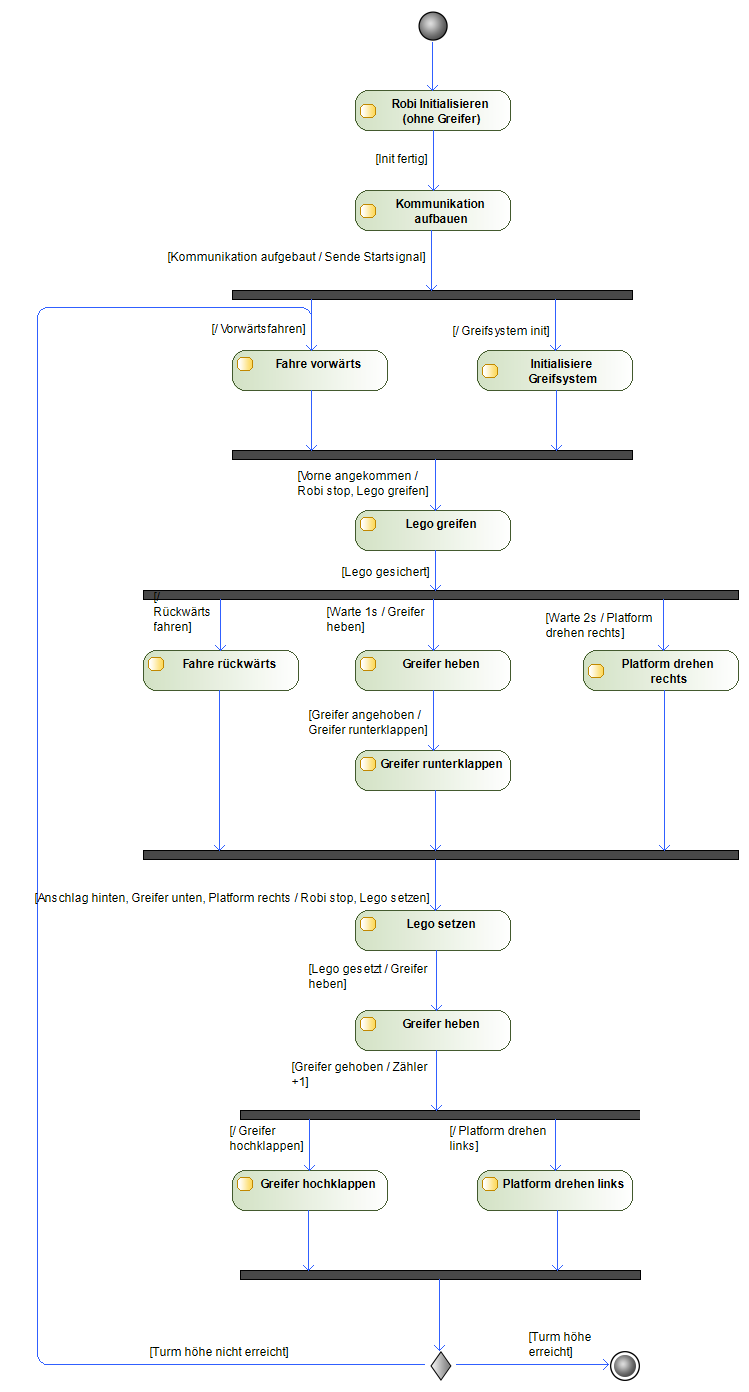
01_Organisation/02_Meilensteine/m1c/Bilder/Activity diagram.png
