Unaqwyn/SysP18_1cv/01_Organisation/02_Meilensteine/m1c/Bilder/Klaus CAD Bodenansicht.png

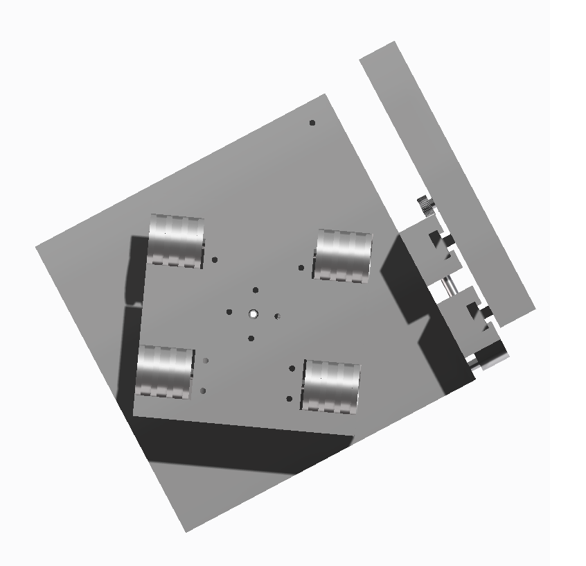
01_Organisation/02_Meilensteine/m1c/Bilder/Klaus CAD Bodenansicht.png
