Unaqwyn/SysP18_1cv/01_Organisation/02_Meilensteine/m1c/Bilder/sysp_project Class diagram.png

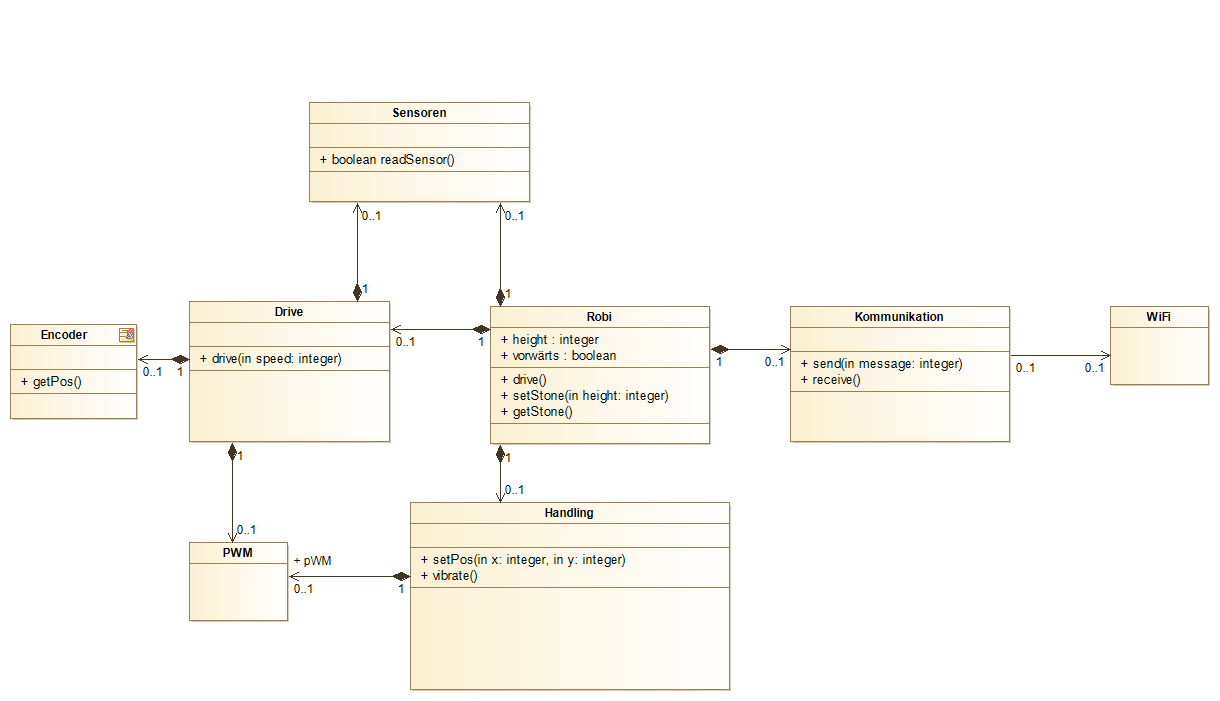
01_Organisation/02_Meilensteine/m1c/Bilder/sysp_project Class diagram.png
