Unaqwyn/SysP18_1cv/01_Organisation/02_Meilensteine/m4/Flyer/IMG_6948V2.png

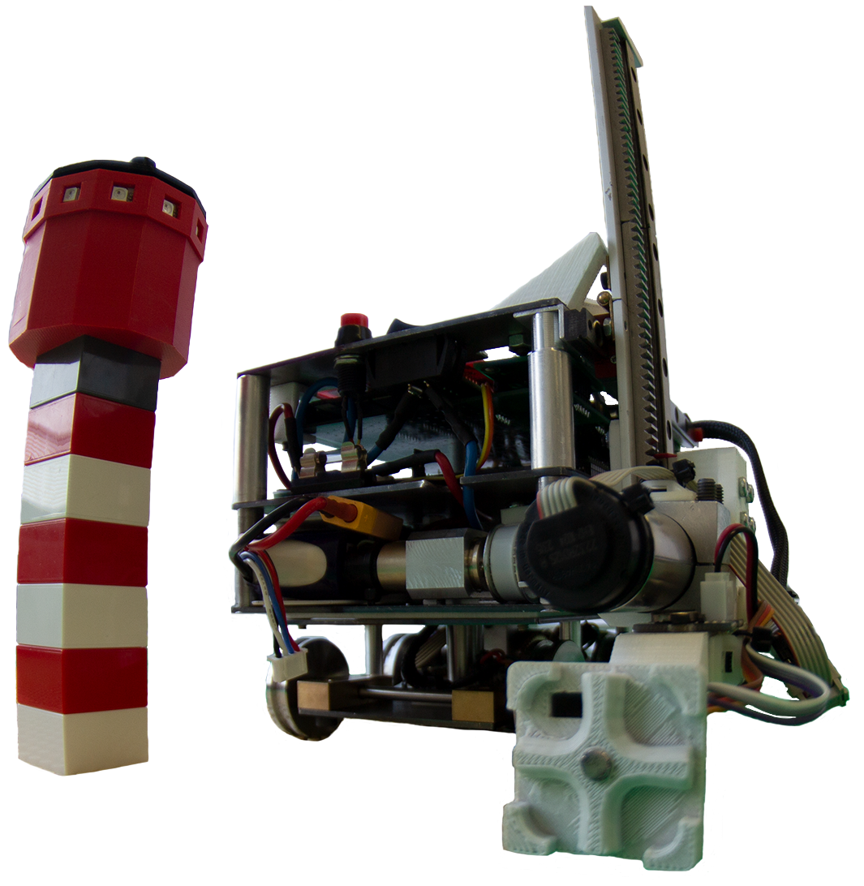
01_Organisation/02_Meilensteine/m4/Flyer/IMG_6948V2.png
