Unaqwyn/SysP18_1cv/01_Organisation/02_Meilensteine/m4/Mechanik/Hintergrund.png

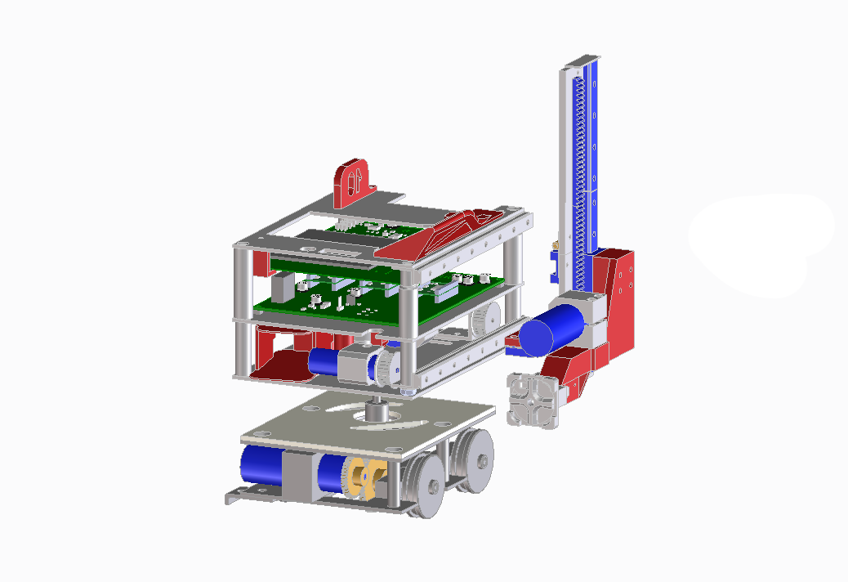
01_Organisation/02_Meilensteine/m4/Mechanik/Hintergrund.png
