Unaqwyn/SysP18_1cv/01_Organisation/02_Meilensteine/m4/Skizze2.PNG

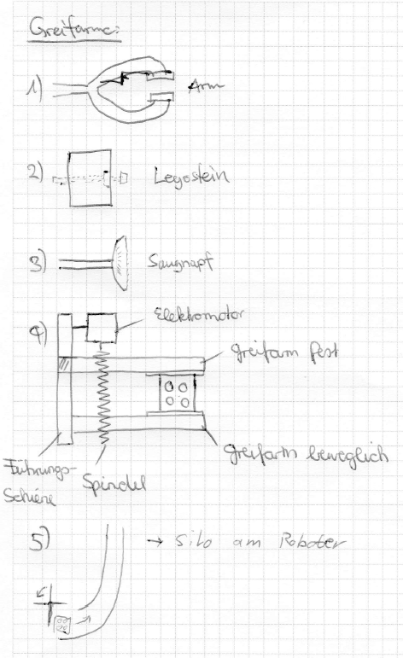
01_Organisation/02_Meilensteine/m4/Skizze2.PNG
