Unaqwyn/SysP18_1cv/01_Organisation/02_Meilensteine/m5/Blockschaltbild2.jpg

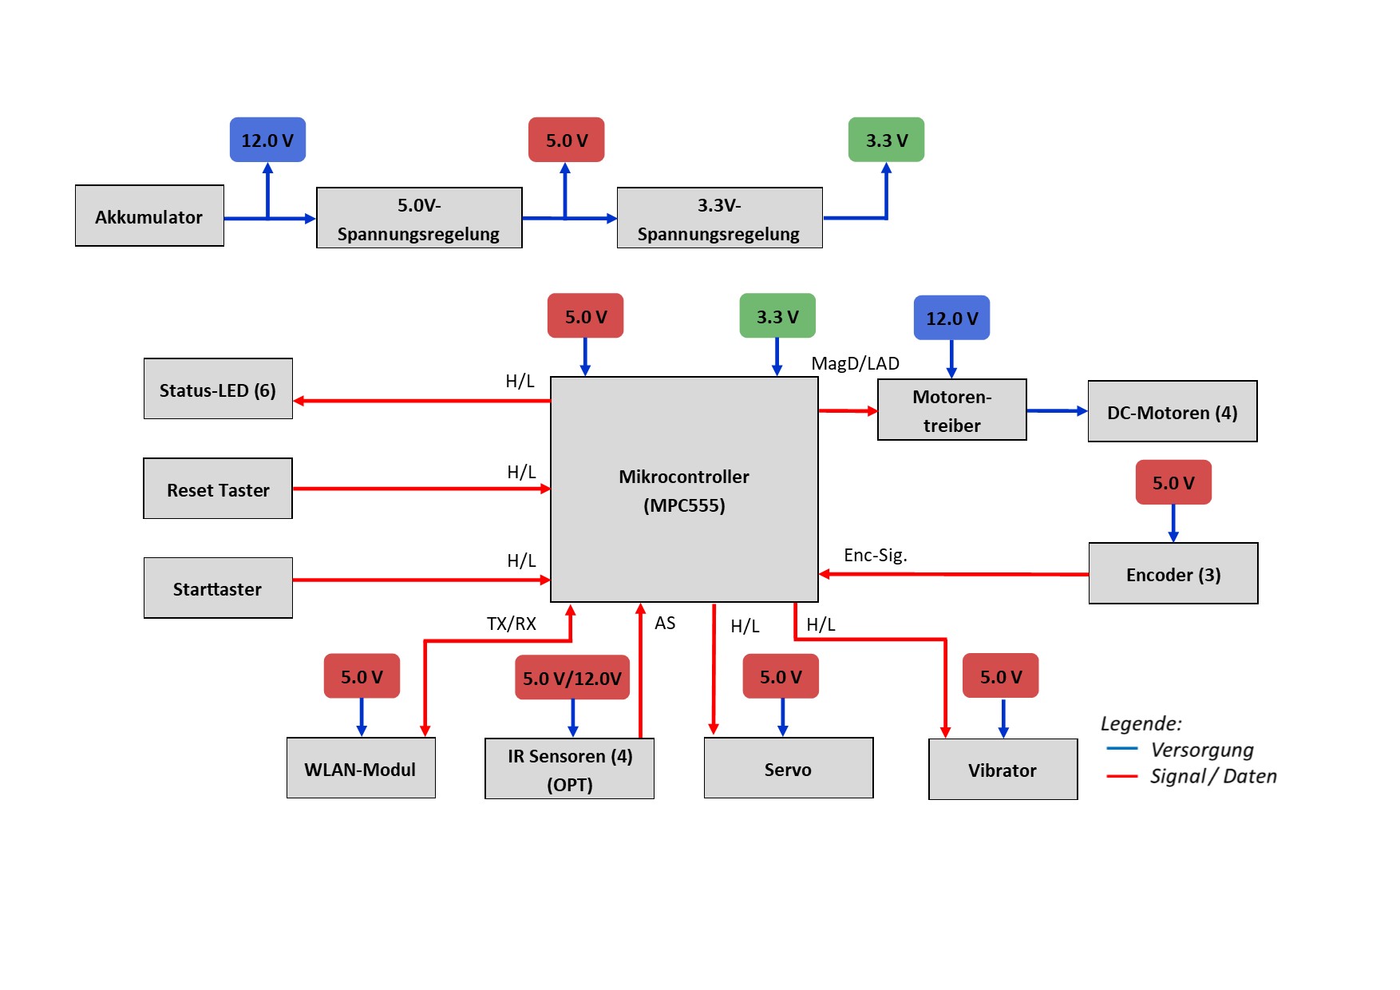
01_Organisation/02_Meilensteine/m5/Blockschaltbild2.jpg
