Unaqwyn/SysP18_1cv/01_Organisation/02_Meilensteine/m5/motorentreiber.PNG

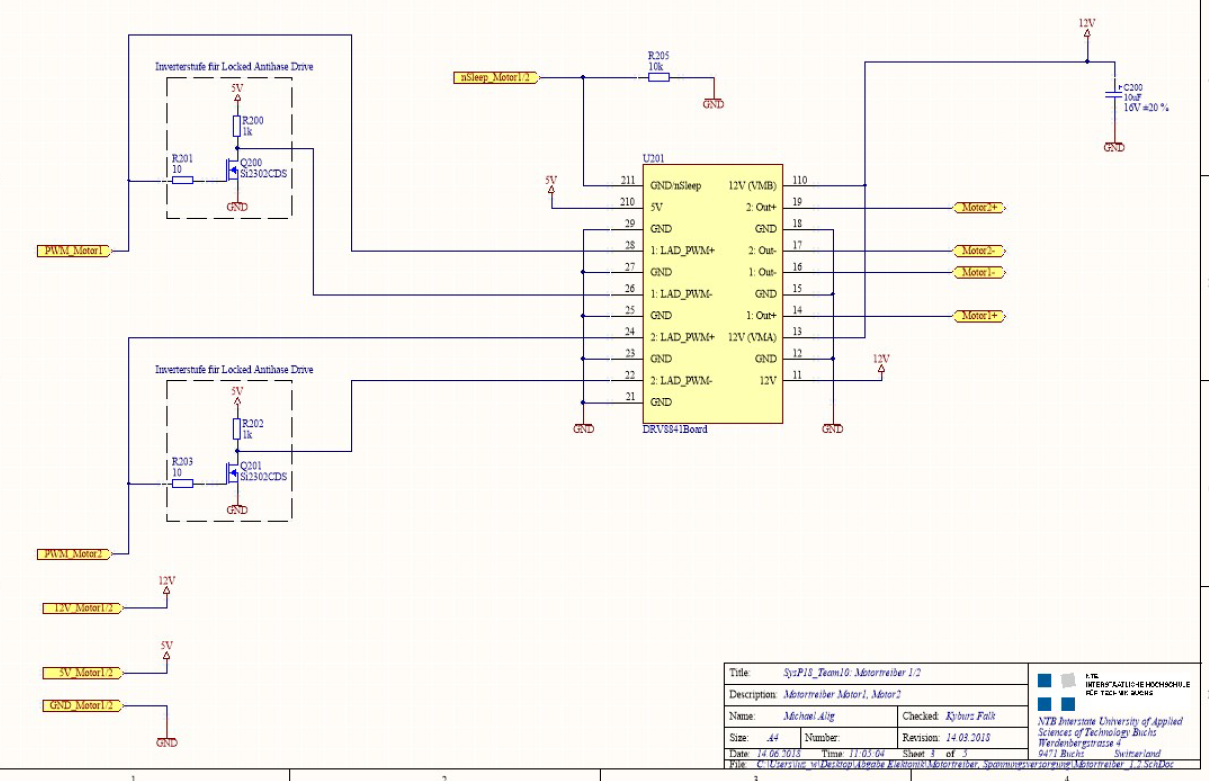
01_Organisation/02_Meilensteine/m5/motorentreiber.PNG
