Unaqwyn/SysP18_1cv/01_Organisation/02_Meilensteine/m5/Sensor1.JPG

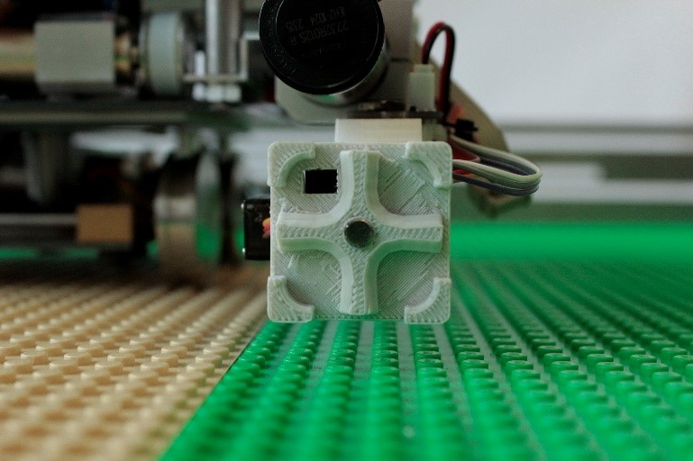
01_Organisation/02_Meilensteine/m5/Sensor1.JPG
