Unaqwyn/SysP18_1cv/01_Organisation/02_Meilensteine/m5/Sensor2.jpg

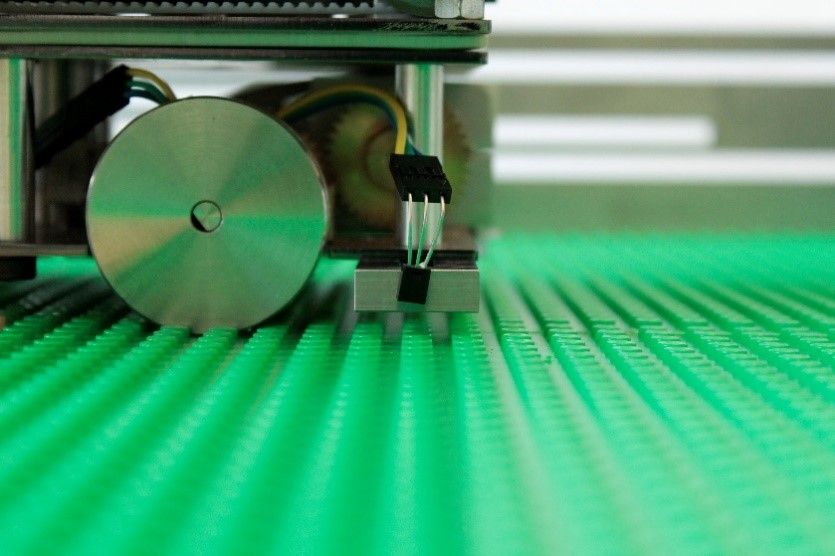
01_Organisation/02_Meilensteine/m5/Sensor2.jpg
