Unaqwyn/SysP18_1cv/01_Organisation/02_Meilensteine/m6/Namensschilder/Flag_of_Canton_of_Graubünden.svg.png

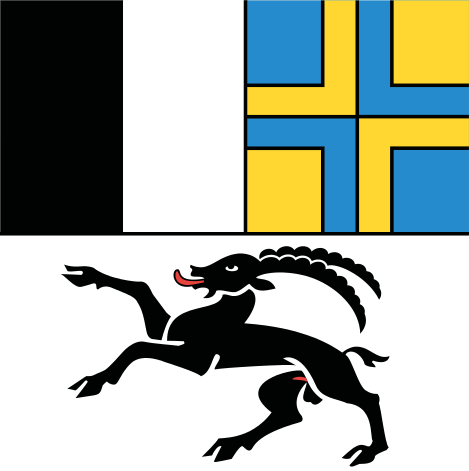
01_Organisation/02_Meilensteine/m6/Namensschilder/Flag_of_Canton_of_Graubünden.svg.png
