Unaqwyn/SysP18_1cv/01_Organisation/02_Meilensteine/m6/Präsentationsfotos/FotoJeannot2.jpg

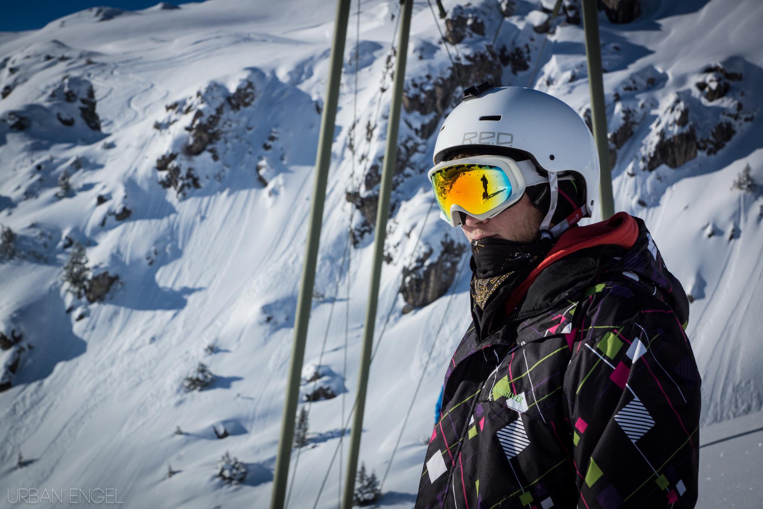
01_Organisation/02_Meilensteine/m6/Präsentationsfotos/FotoJeannot2.jpg
