Unaqwyn/SysP18_1cv/01_Organisation/02_Meilensteine/m6/Präsentationsfotos/FotoLuzian1.jpg

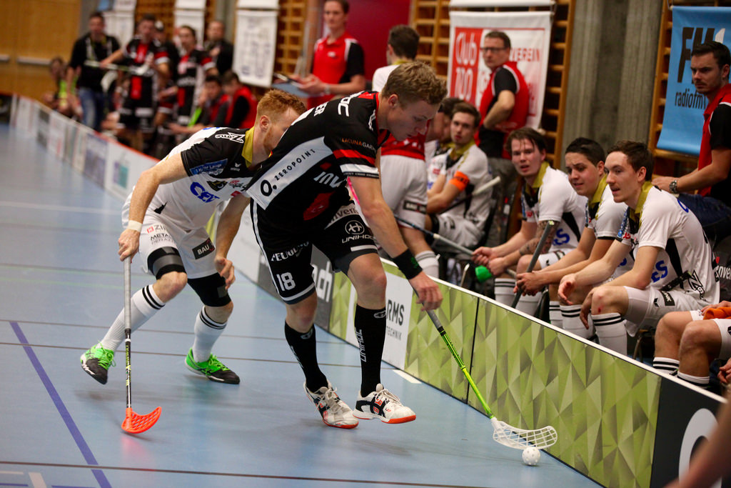
01_Organisation/02_Meilensteine/m6/Präsentationsfotos/FotoLuzian1.jpg
