Unaqwyn/SysP18_1cv/01_Organisation/02_Meilensteine/m6/Präsentationsfotos/Mauro/20170428_143037.jpg

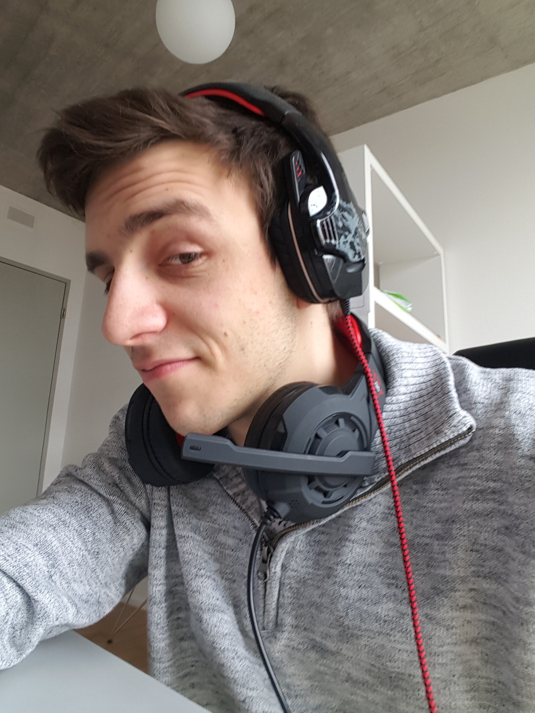
01_Organisation/02_Meilensteine/m6/Präsentationsfotos/Mauro/20170428_143037.jpg
