Unaqwyn/SysP18_1cv/01_Organisation/02_Meilensteine/m6/Präsentationsfotos/Mauro/20170720_191004.jpg

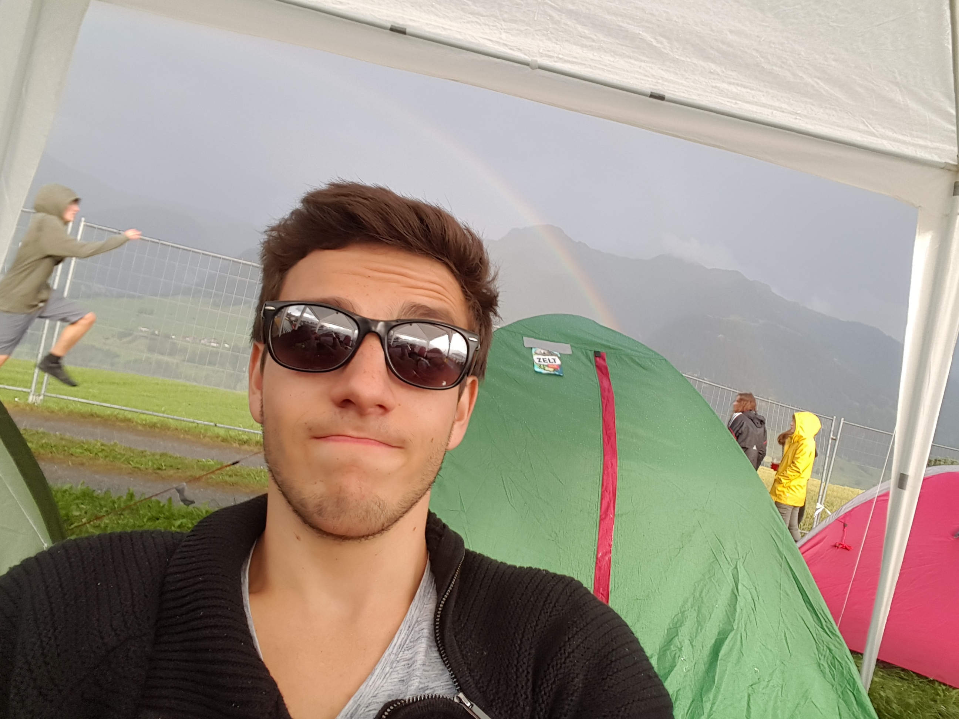
01_Organisation/02_Meilensteine/m6/Präsentationsfotos/Mauro/20170720_191004.jpg
