Unaqwyn/SysP18_1cv/01_Organisation/02_Meilensteine/m6/Präsentationsfotos/Mauro/Mauro Stoffel Freizeit 003.JPG

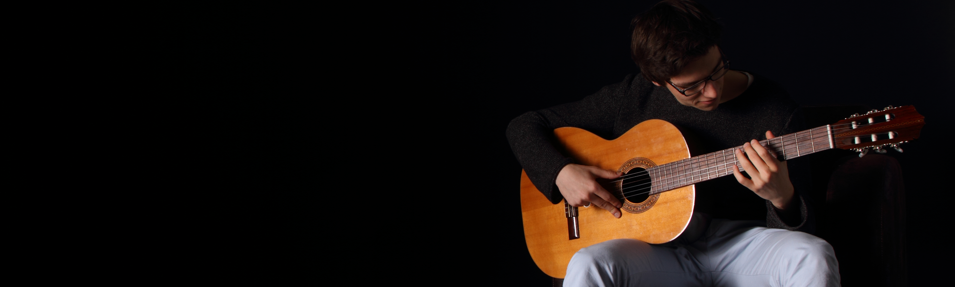
01_Organisation/02_Meilensteine/m6/Präsentationsfotos/Mauro/Mauro Stoffel Freizeit 003.JPG
