Unaqwyn/SysP18_1cv/01_Organisation/02_Meilensteine/m6/Präsentationsfotos/Michael.jpg

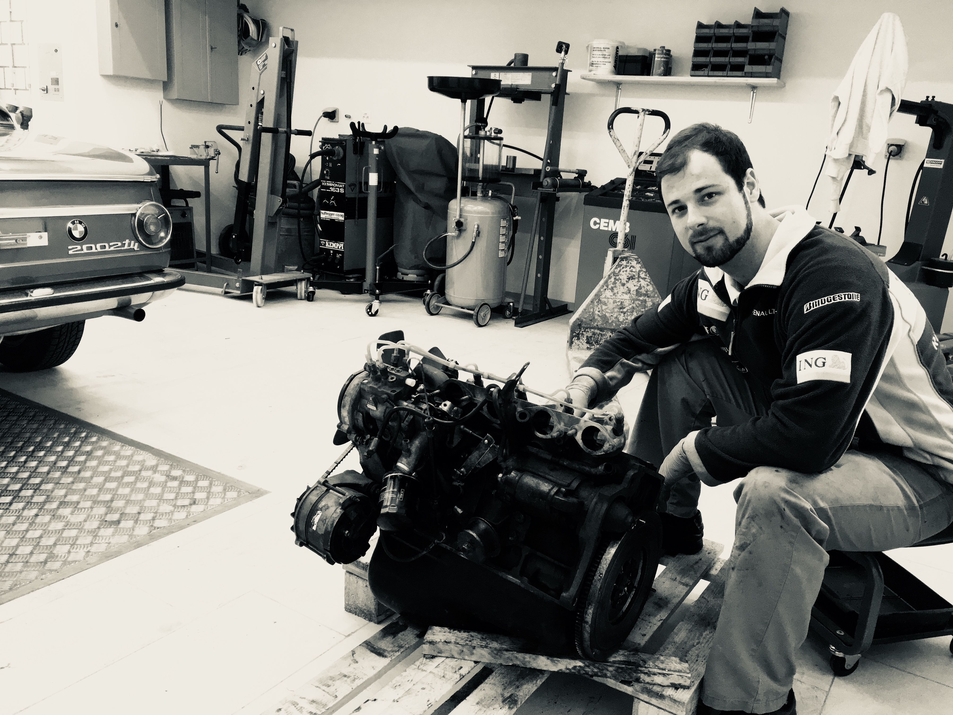
01_Organisation/02_Meilensteine/m6/Präsentationsfotos/Michael.jpg
