Unaqwyn/SysP18_1cv/01_Organisation/02_Meilensteine/m6/Präsentationsfotos/Robi_ALU_1.jpg

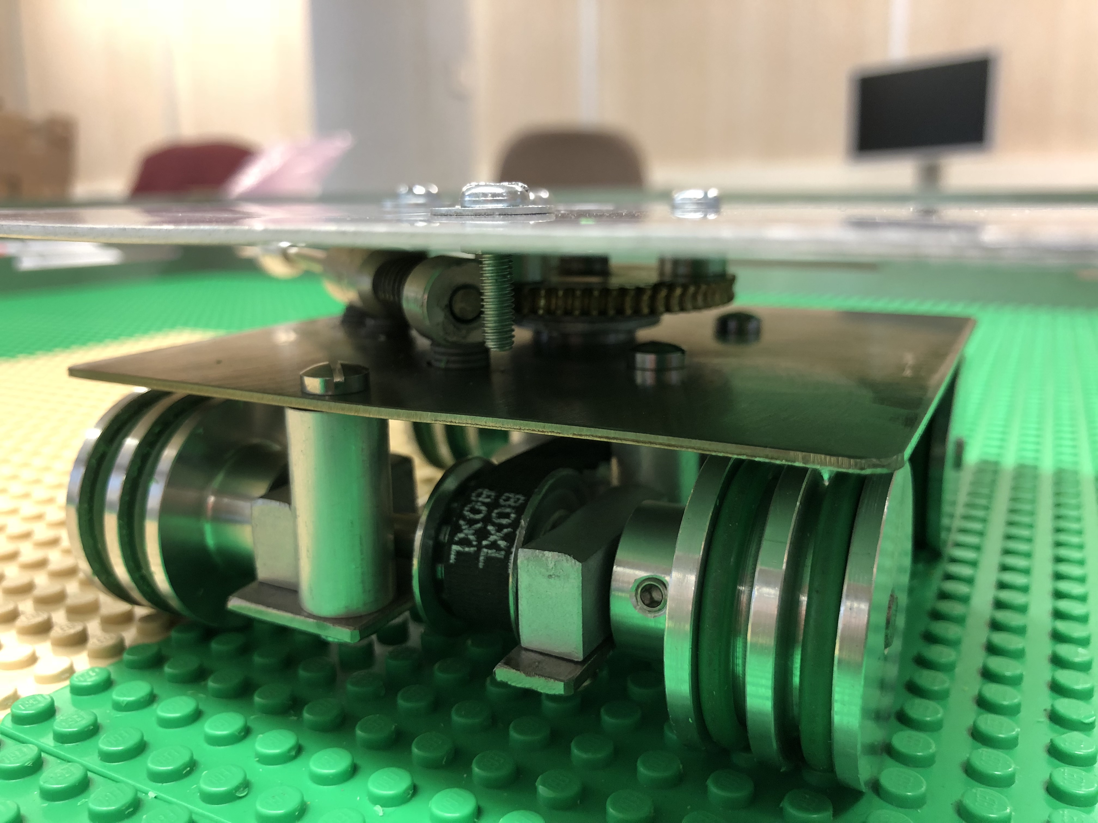
01_Organisation/02_Meilensteine/m6/Präsentationsfotos/Robi_ALU_1.jpg
