Unaqwyn/SysP18_1cv/03_Elektronik/veralteteDateien/SysP18_Robi/MPC555Stand27.03.PNG

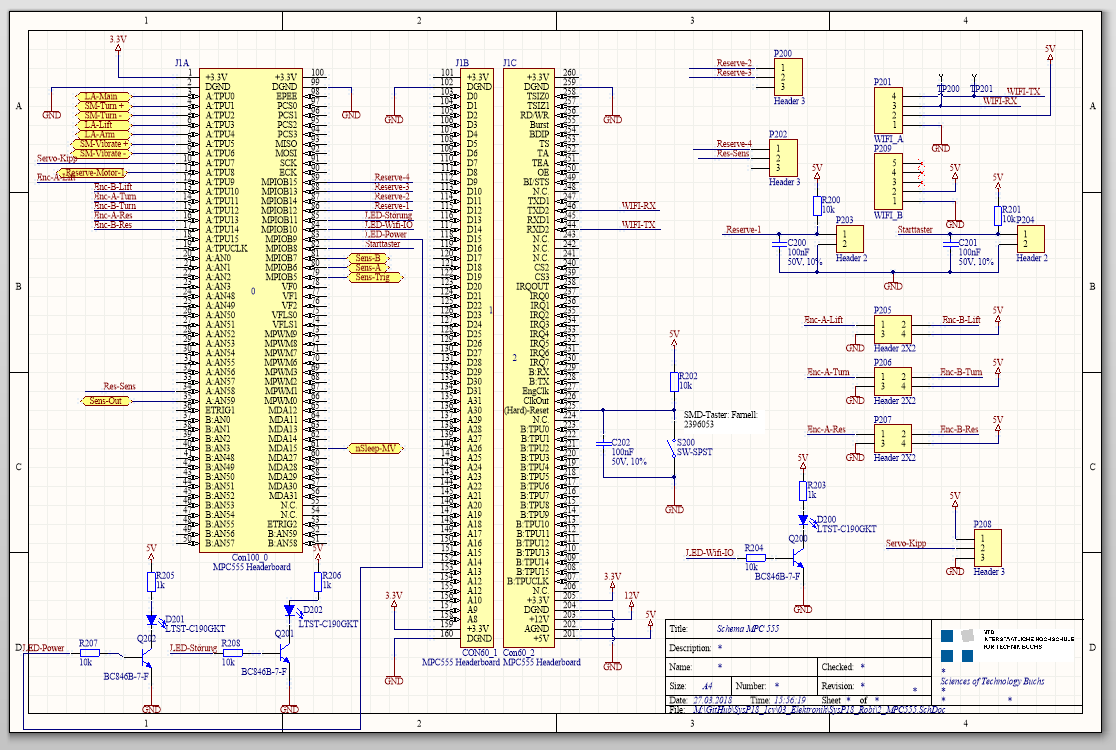
03_Elektronik/veralteteDateien/SysP18_Robi/MPC555Stand27.03.PNG
