Unaqwyn/SysP18_1cv/04_Informatik/01_Diagramme/Sequence_diagram.png

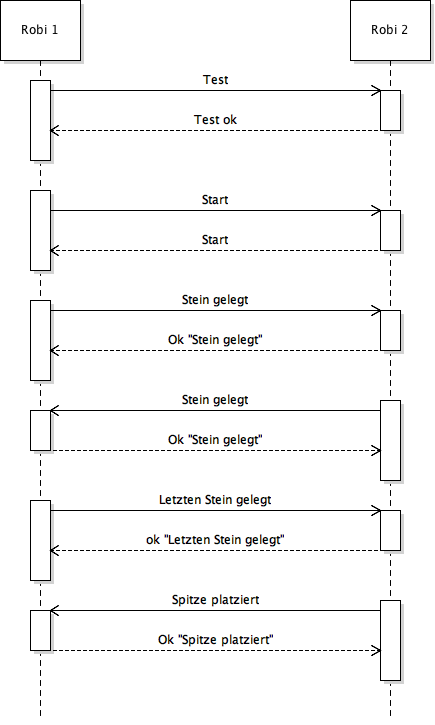
04_Informatik/01_Diagramme/Sequence_diagram.png
