Unaqwyn/SysP18_1cv/04_Informatik/99_Altes_Programm/Aktuelle_Dokumente/Kommunikationstabelle.JPG

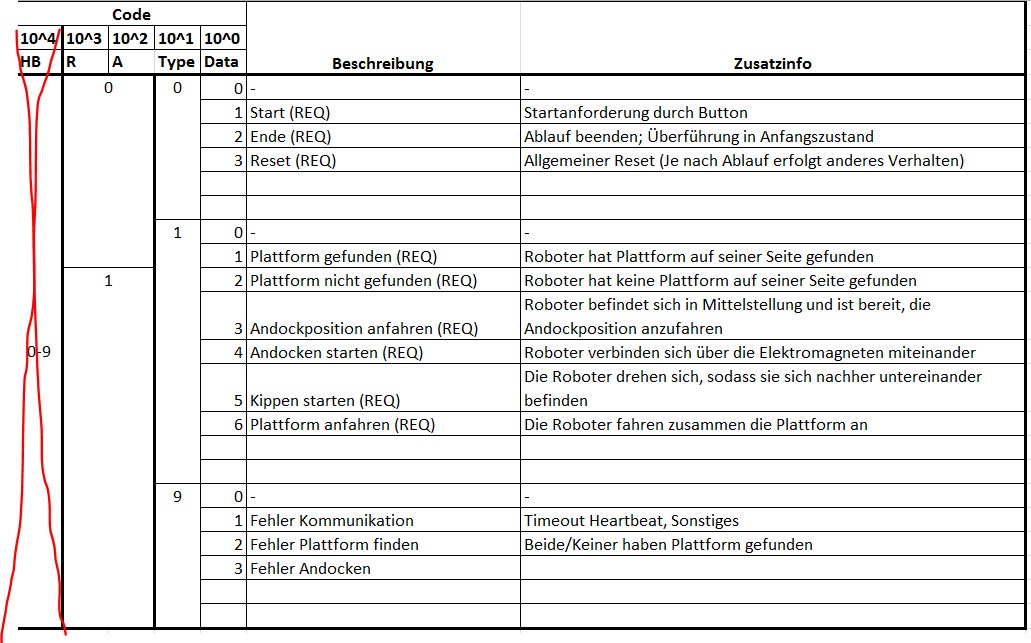
04_Informatik/99_Altes_Programm/Aktuelle_Dokumente/Kommunikationstabelle.JPG
