Unaqwyn/SysP18_1cv/05_Webseite/01_Bilder/Profilbild-Platzhalter-w.jpg

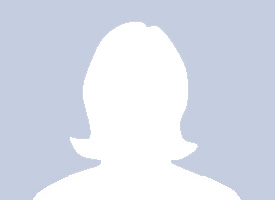
05_Webseite/01_Bilder/Profilbild-Platzhalter-w.jpg
