Unaqwyn/SysP18_1cv/05_Webseite/01_Bilder/Profilbild-Platzhalter.jpg

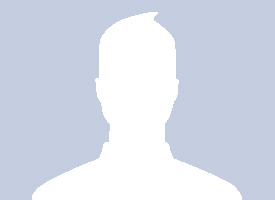
05_Webseite/01_Bilder/Profilbild-Platzhalter.jpg
