Unaqwyn/SysP18_1cv/05_Webseite/01_Bilder/Teamstrucktur.png

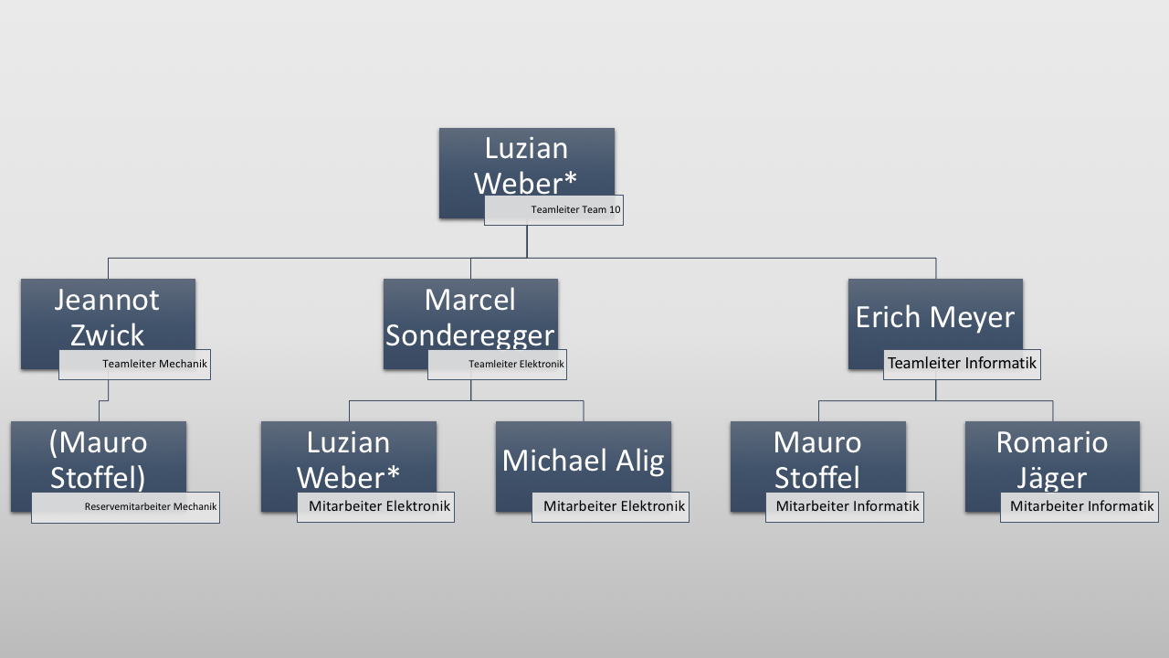
05_Webseite/01_Bilder/Teamstrucktur.png
