Unaqwyn/SysP18_1cv/05_Webseite/02_Porträt/Laura.jpg

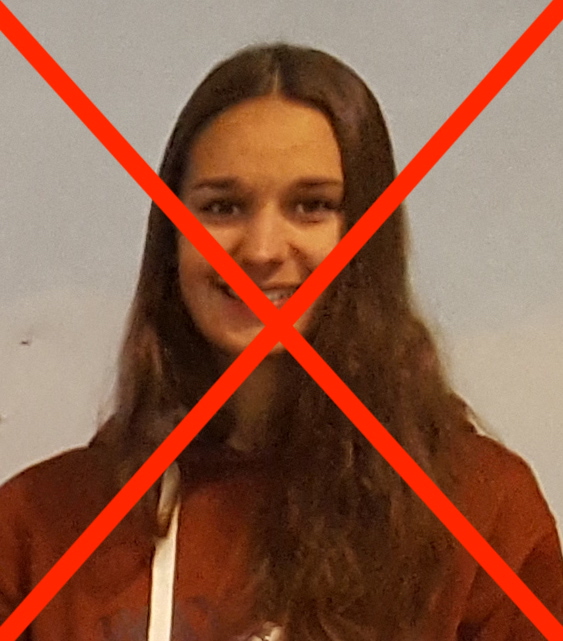
05_Webseite/02_Porträt/Laura.jpg
