Unaqwyn/SysP18_1cv/05_Webseite/02_Porträt/Marcel_alt.jpg

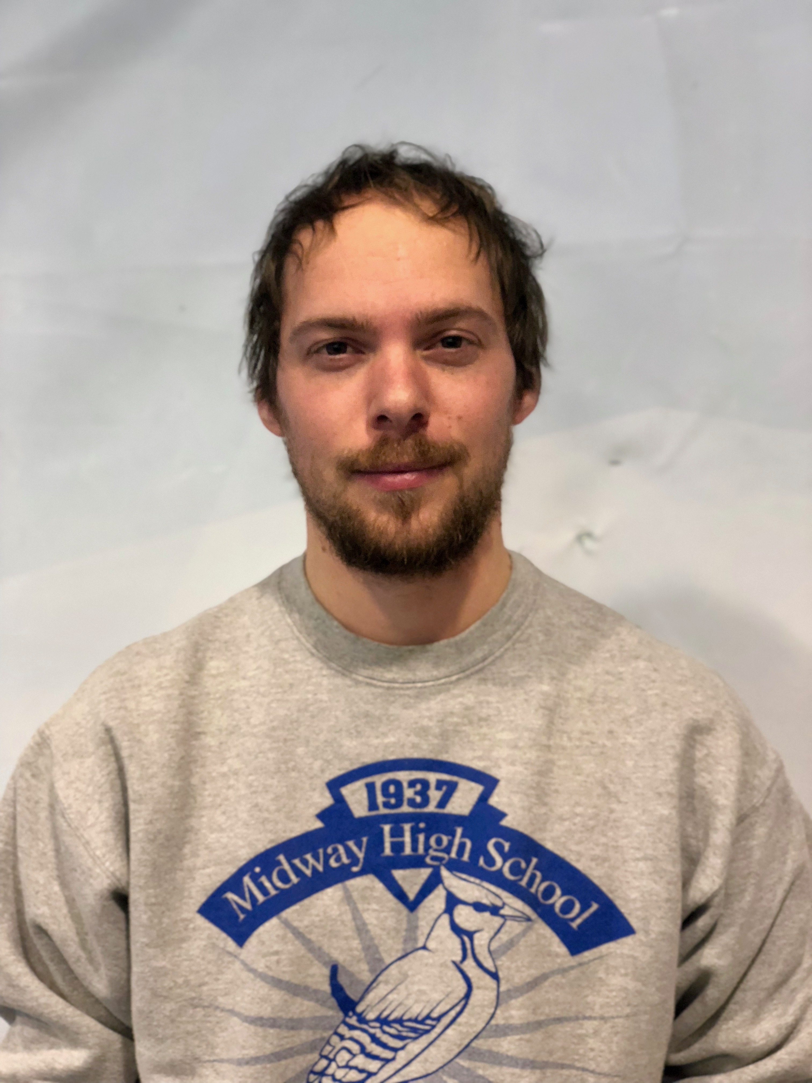
05_Webseite/02_Porträt/Marcel_alt.jpg
