Unaqwyn/SysP18_1cv/05_Webseite/02_Porträt/Mauro.jpg

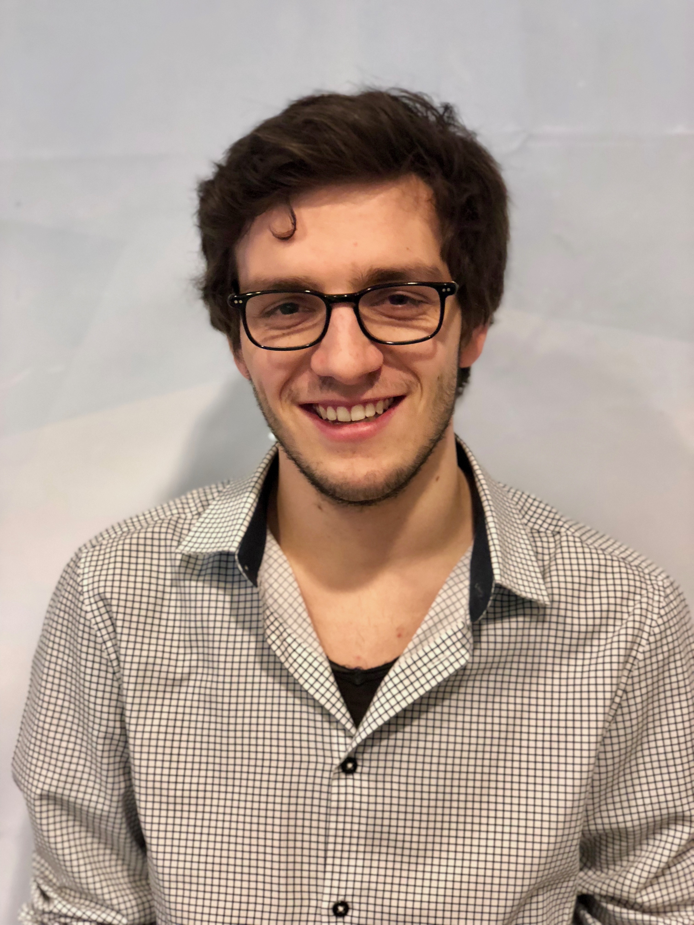
05_Webseite/02_Porträt/Mauro.jpg
