Unaqwyn/SysP18_1cv/05_Webseite/03_Sponsoren/faulhaber.jpg

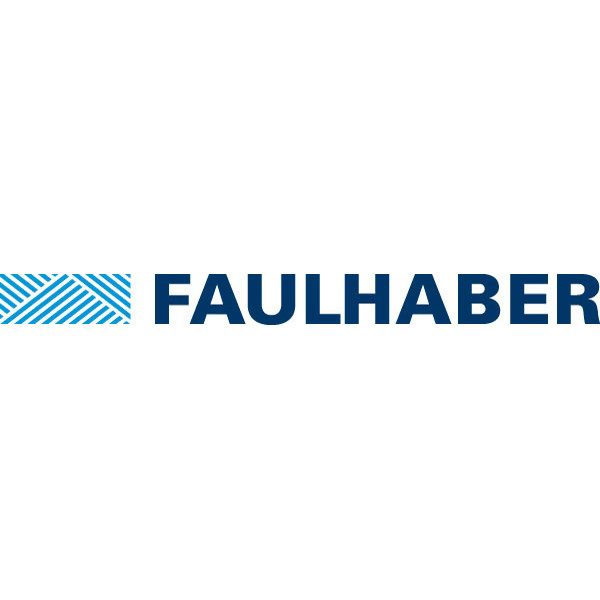
05_Webseite/03_Sponsoren/faulhaber.jpg
