Unaqwyn/SysP18_1cv/05_Webseite/04_Mediathek/Hochgeladen/9b97f04c-d26c-4549-8599-a20a27662bf8.jpg

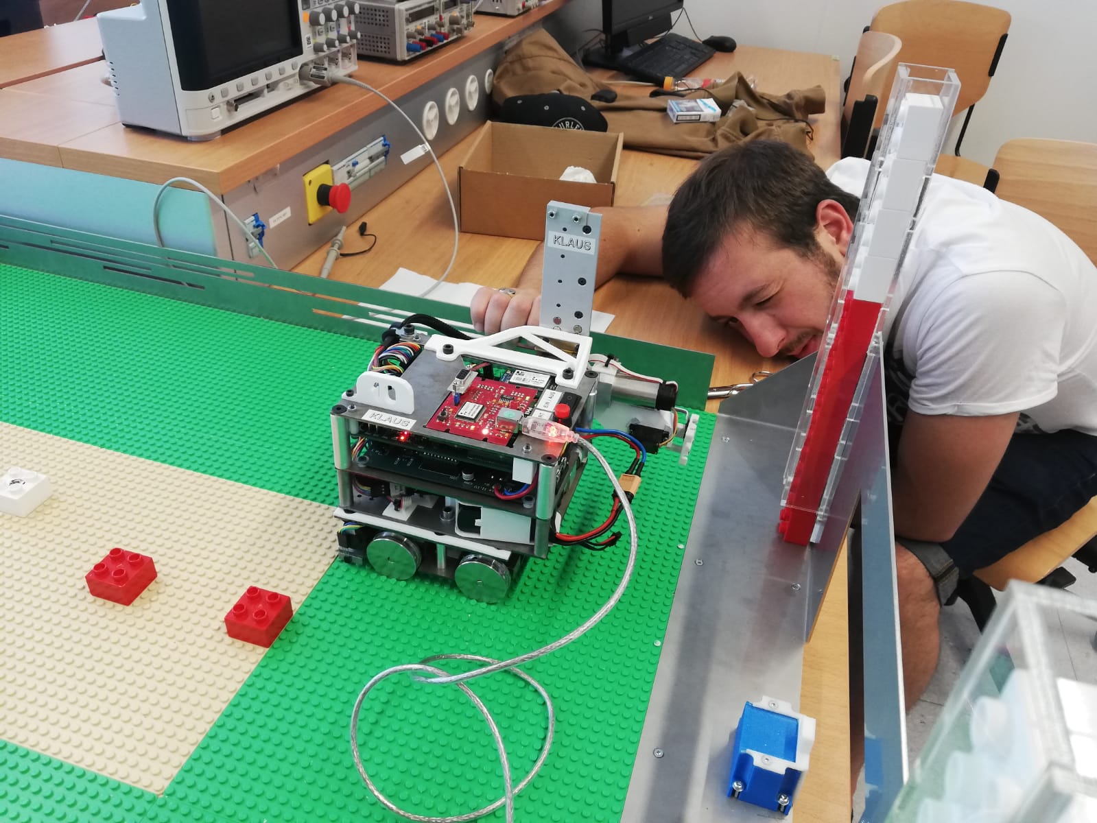
05_Webseite/04_Mediathek/Hochgeladen/9b97f04c-d26c-4549-8599-a20a27662bf8.jpg
