Unaqwyn/SysP18_1cv/05_Webseite/04_Mediathek/Hochgeladen/18edad8e-4c34-4cdc-a0f5-3b2ebb2a7a0b.jpg

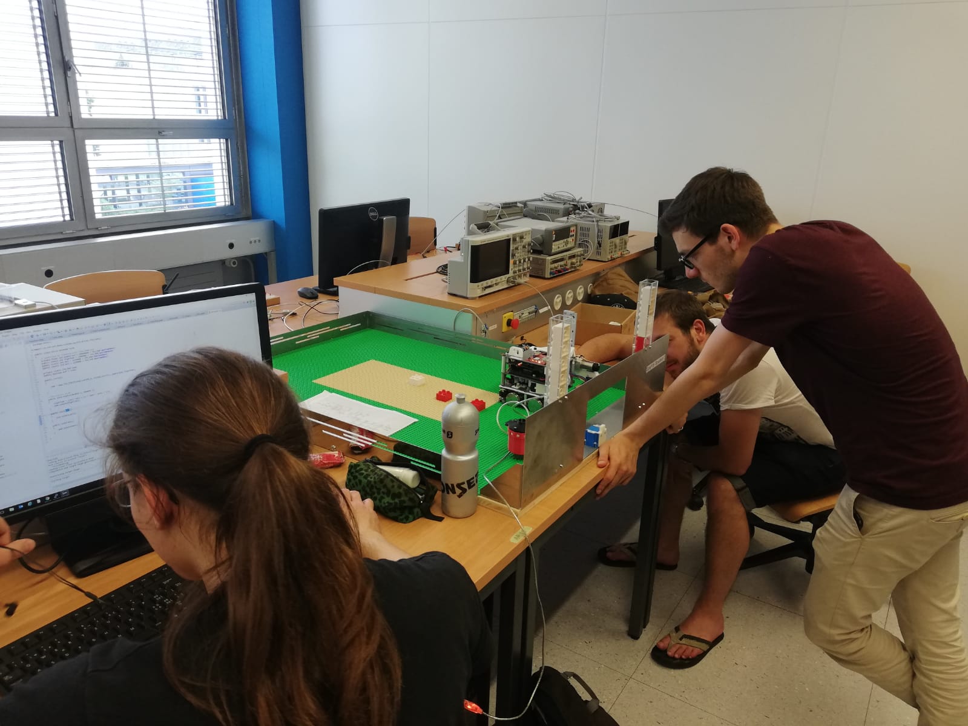
05_Webseite/04_Mediathek/Hochgeladen/18edad8e-4c34-4cdc-a0f5-3b2ebb2a7a0b.jpg
