Unaqwyn/SysP18_1cv/05_Webseite/04_Mediathek/Hochgeladen/70a36ec6-195b-40f6-a419-cb3ec2cc155b.jpg

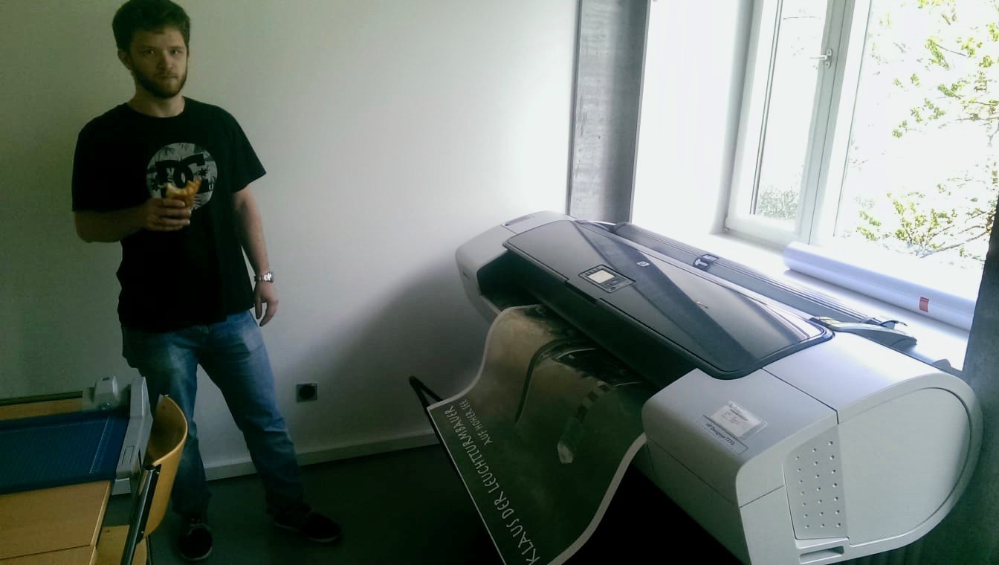
05_Webseite/04_Mediathek/Hochgeladen/70a36ec6-195b-40f6-a419-cb3ec2cc155b.jpg
