Unaqwyn/SysP18_1cv/05_Webseite/04_Mediathek/Hochgeladen/b3cf3521-ea76-4aaa-9266-8a74e348915c.jpg

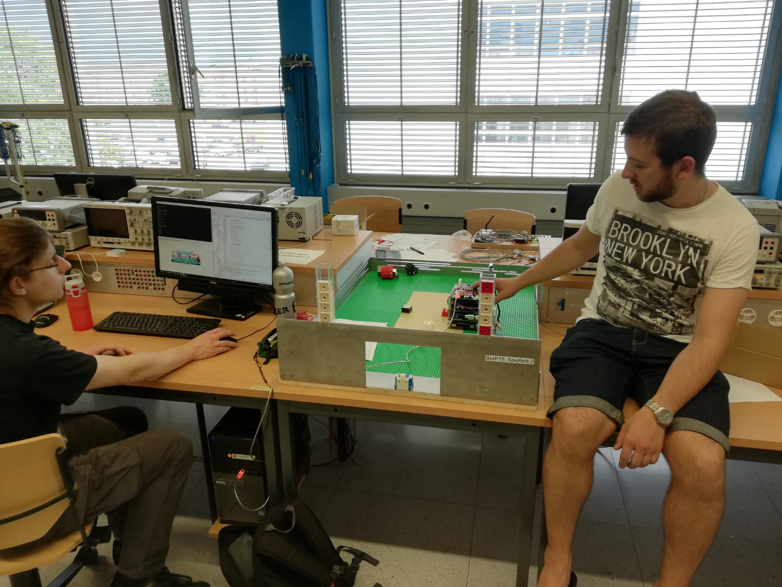
05_Webseite/04_Mediathek/Hochgeladen/b3cf3521-ea76-4aaa-9266-8a74e348915c.jpg
