Unaqwyn/SysP18_1cv/05_Webseite/04_Mediathek/Hochgeladen/d1c9973b-fbab-4746-ac73-c2e64dbb6a8f.jpg

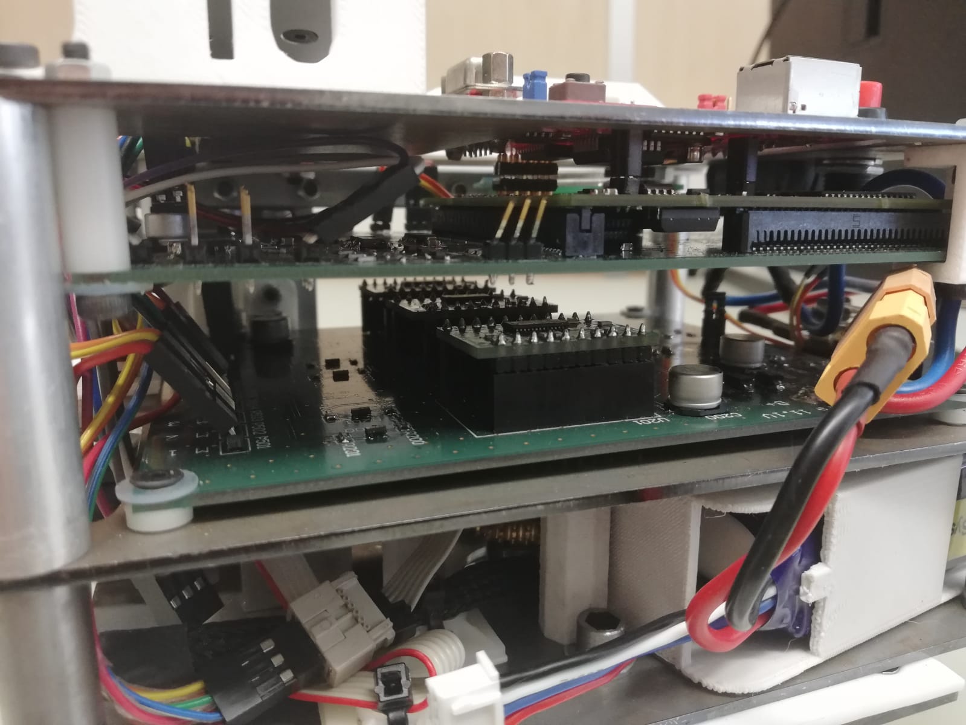
05_Webseite/04_Mediathek/Hochgeladen/d1c9973b-fbab-4746-ac73-c2e64dbb6a8f.jpg
