Unaqwyn/SysP18_1cv/05_Webseite/04_Mediathek/Hochgeladen/e9b87880-fcc8-4672-9cc1-a21c02fbb1ae.jpg

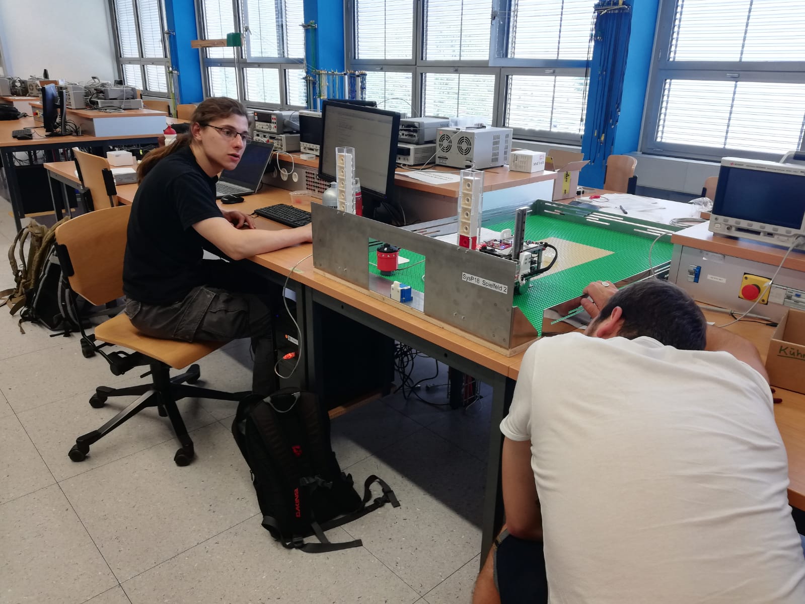
05_Webseite/04_Mediathek/Hochgeladen/e9b87880-fcc8-4672-9cc1-a21c02fbb1ae.jpg
