Unaqwyn/SysP18_1cv/05_Webseite/04_Mediathek/Hochgeladen/efc17c77-1bde-447a-b3a5-e84e0d3070d2.jpg

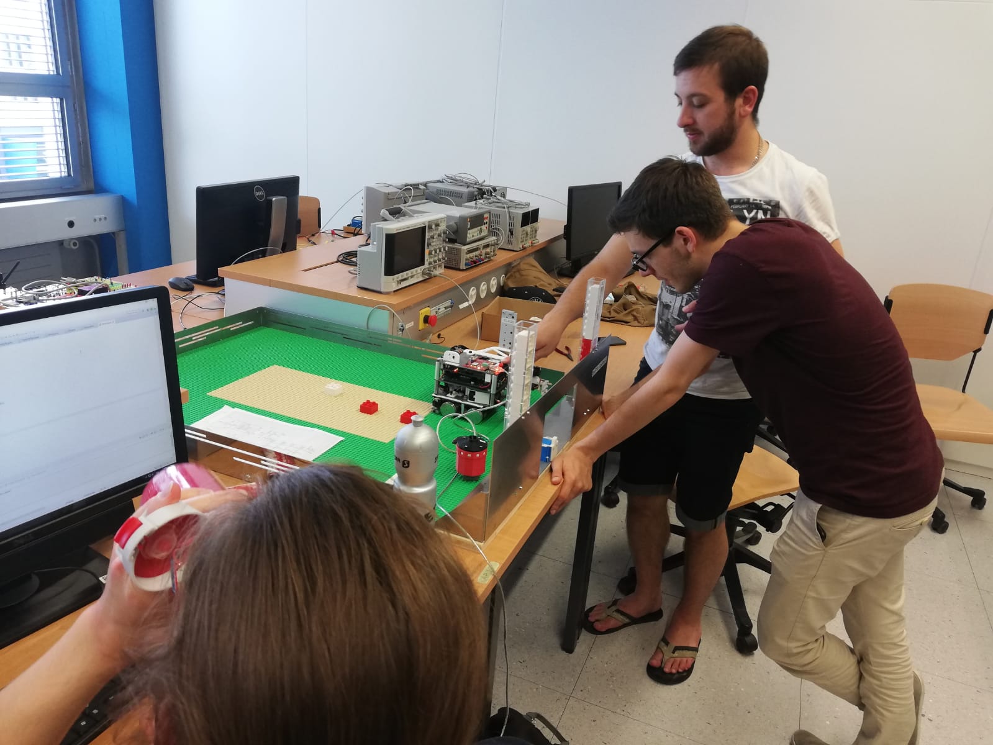
05_Webseite/04_Mediathek/Hochgeladen/efc17c77-1bde-447a-b3a5-e84e0d3070d2.jpg
