Unaqwyn/SysP18_1cv/05_Webseite/04_Mediathek/Hochgeladen/IMAG0275.jpg

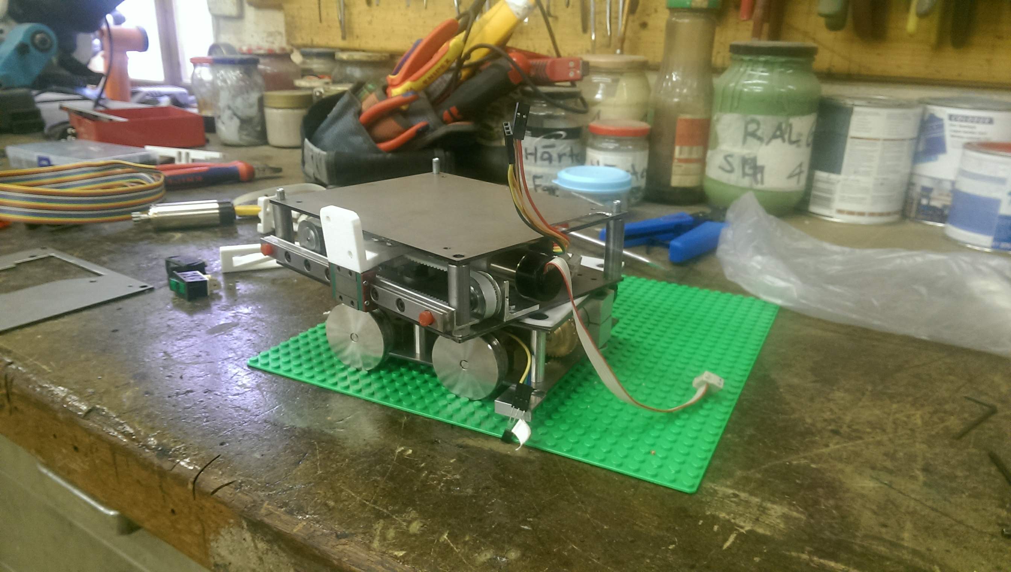
05_Webseite/04_Mediathek/Hochgeladen/IMAG0275.jpg
