Unaqwyn/SysP18_1cv/05_Webseite/04_Mediathek/Hochgeladen/image1.jpeg

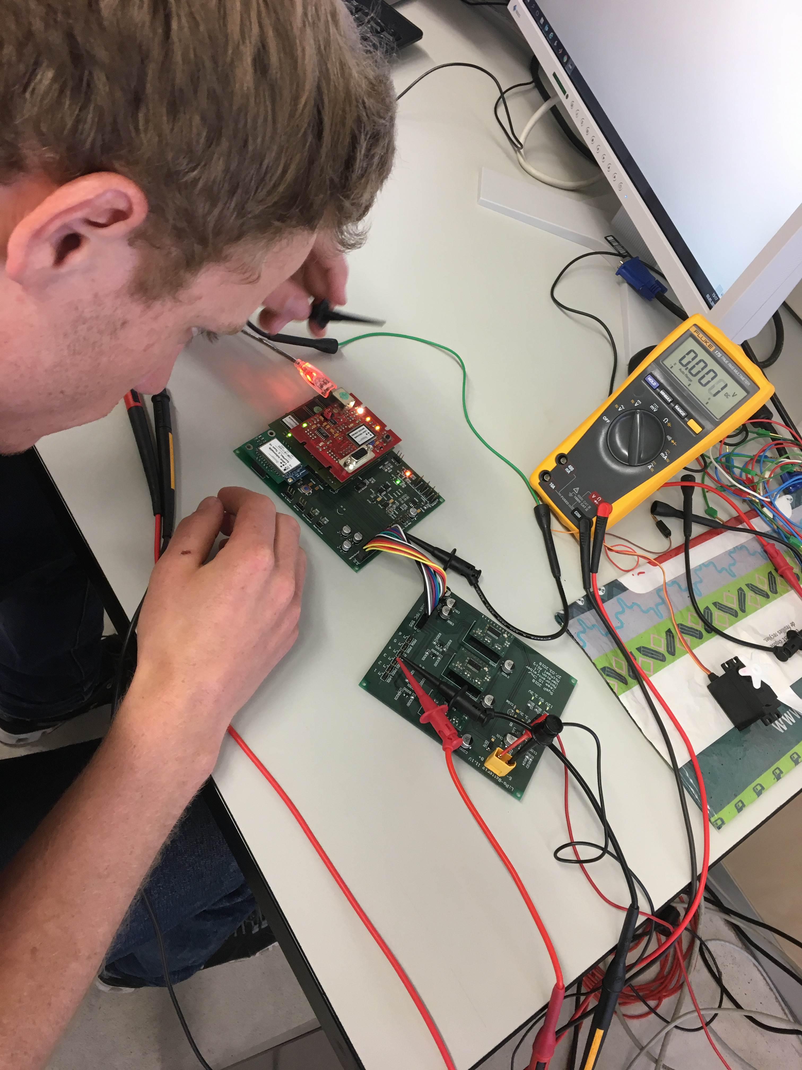
05_Webseite/04_Mediathek/Hochgeladen/image1.jpeg
