Unaqwyn/SysP18_1cv/05_Webseite/04_Mediathek/Hochgeladen/IMG_0975.jpg

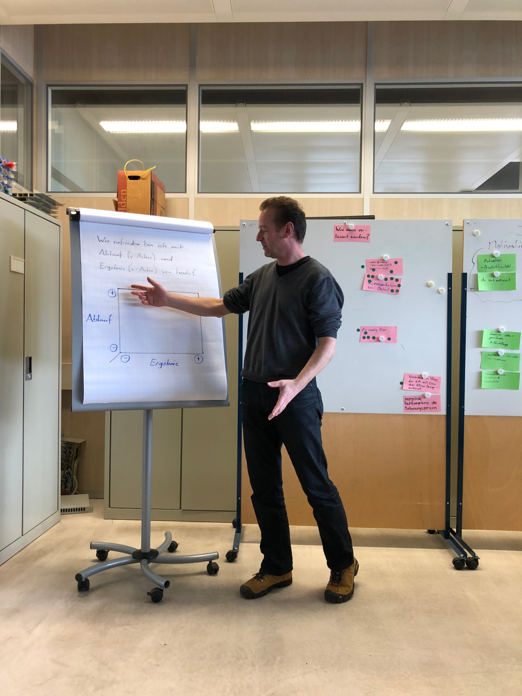
05_Webseite/04_Mediathek/Hochgeladen/IMG_0975.jpg
