Unaqwyn/SysP18_1cv/05_Webseite/04_Mediathek/Hochgeladen/IMG_0987_Titel.jpg

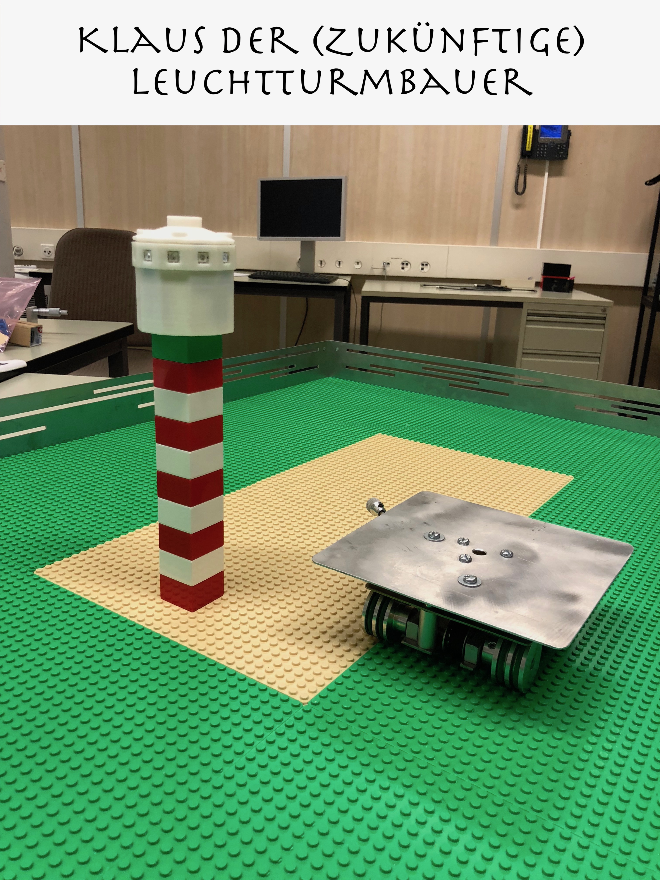
05_Webseite/04_Mediathek/Hochgeladen/IMG_0987_Titel.jpg
