Unaqwyn/SysP18_1cv/05_Webseite/04_Mediathek/Nicht_verwendet/7dc3bb58-5567-443f-86cb-ebc30191fc35.jpg

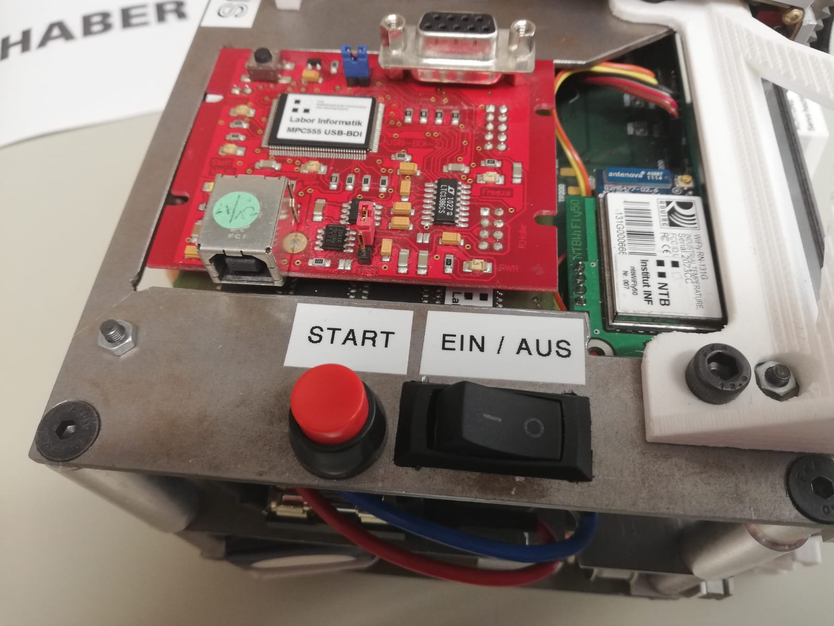
05_Webseite/04_Mediathek/Nicht_verwendet/7dc3bb58-5567-443f-86cb-ebc30191fc35.jpg
