Unaqwyn/SysP18_1cv/05_Webseite/04_Mediathek/Nicht_verwendet/26e9a6b7-19cd-45bb-b35f-08c392e0b2c5.jpg

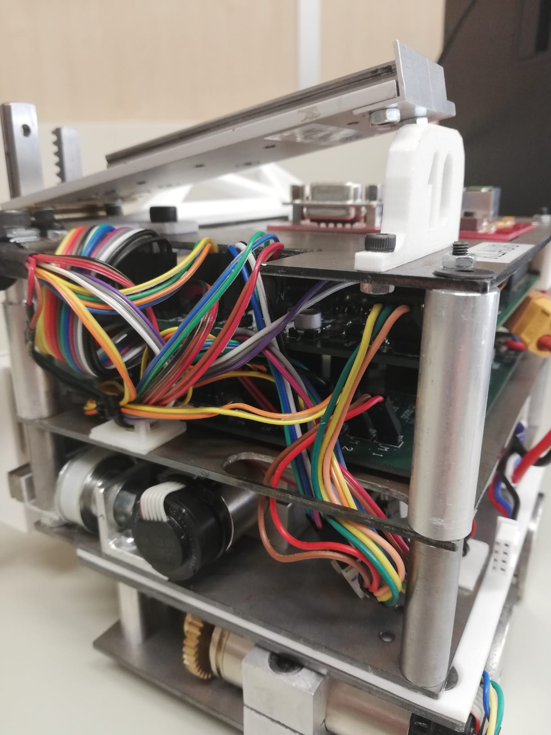
05_Webseite/04_Mediathek/Nicht_verwendet/26e9a6b7-19cd-45bb-b35f-08c392e0b2c5.jpg
