Unaqwyn/SysP18_1cv/05_Webseite/04_Mediathek/Nicht_verwendet/70ab4a47-688d-4188-acc7-863f50ce0877.jpg

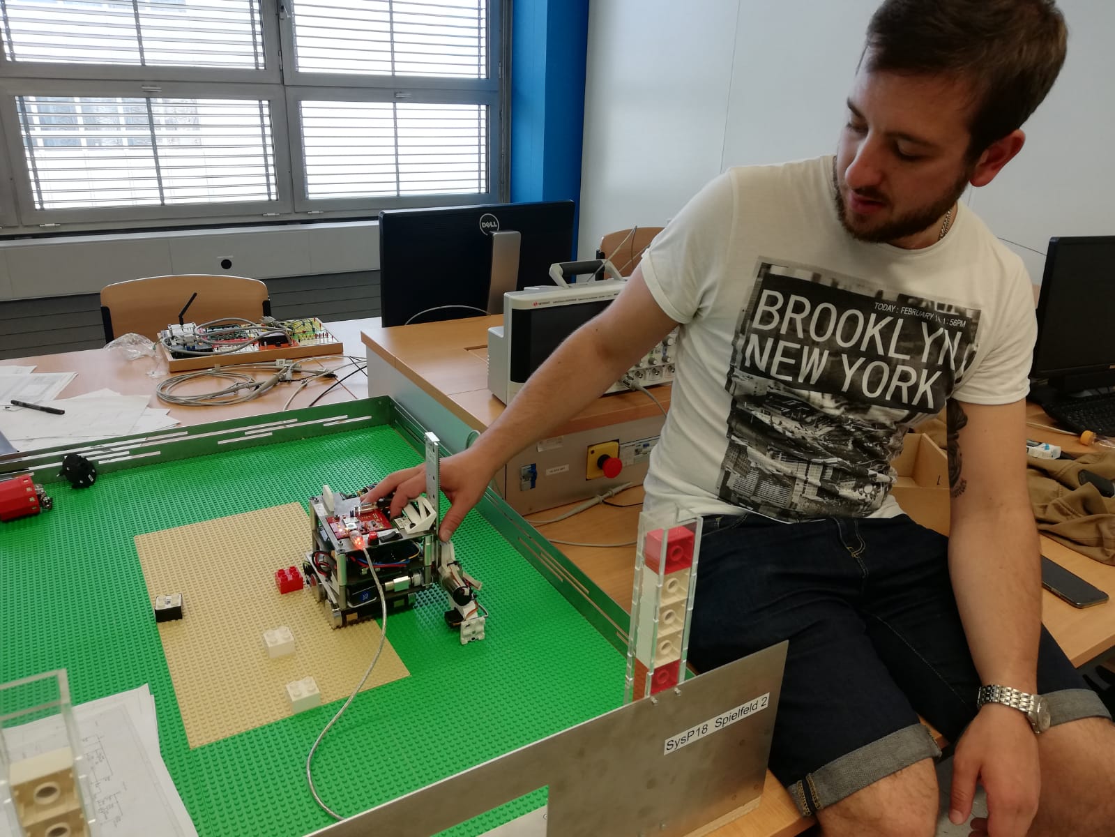
05_Webseite/04_Mediathek/Nicht_verwendet/70ab4a47-688d-4188-acc7-863f50ce0877.jpg
