Unaqwyn/SysP18_1cv/05_Webseite/04_Mediathek/Nicht_verwendet/7075ae88-4c72-406c-824d-7bd651676167.JPG

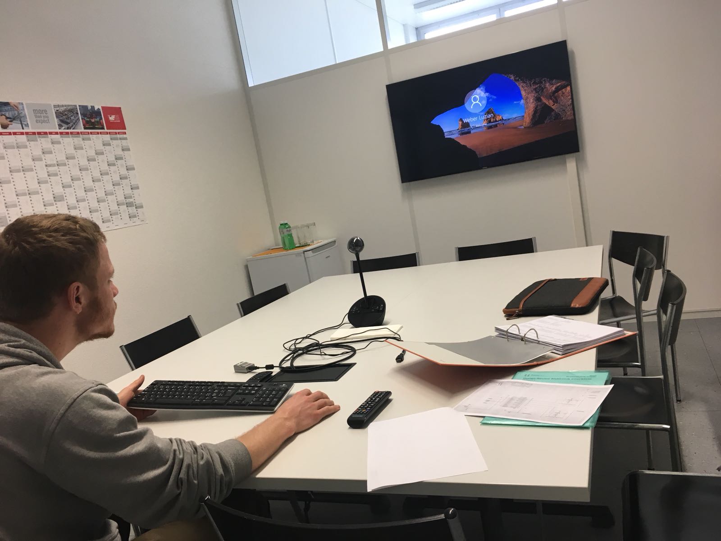
05_Webseite/04_Mediathek/Nicht_verwendet/7075ae88-4c72-406c-824d-7bd651676167.JPG
