Unaqwyn/SysP18_1cv/05_Webseite/04_Mediathek/Nicht_verwendet/074374a0-931a-43e8-8b43-4e871c6c2989.jpg

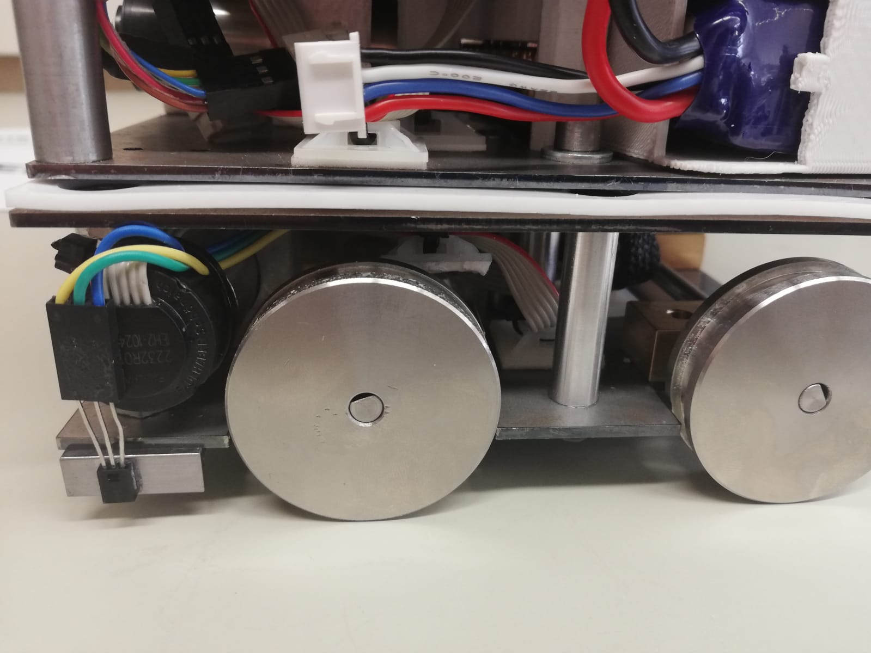
05_Webseite/04_Mediathek/Nicht_verwendet/074374a0-931a-43e8-8b43-4e871c6c2989.jpg
