Unaqwyn/SysP18_1cv/05_Webseite/04_Mediathek/Nicht_verwendet/c9ccb158-df68-4e10-b713-48cd7105a139.jpg

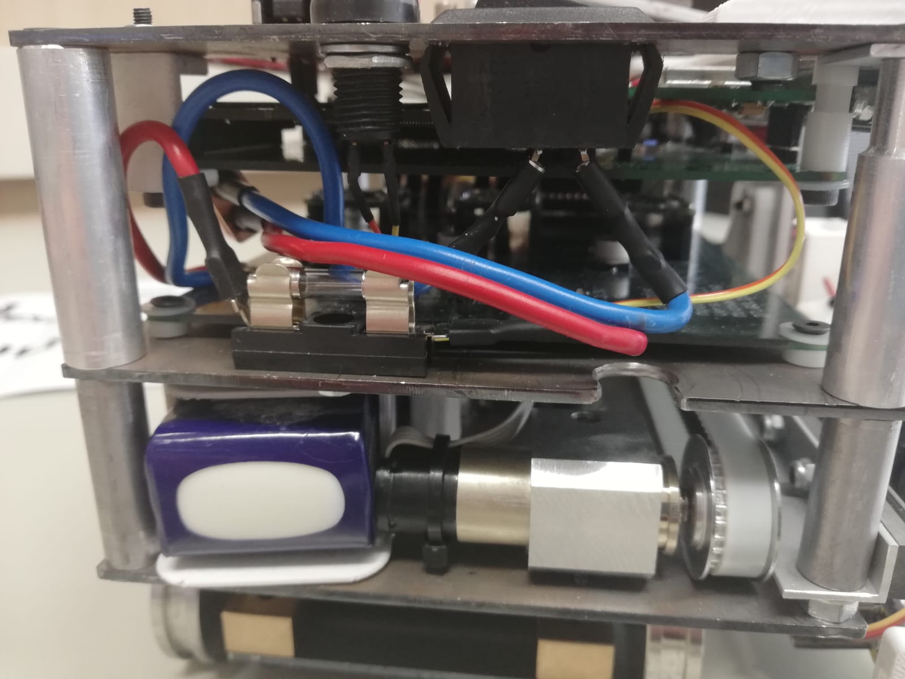
05_Webseite/04_Mediathek/Nicht_verwendet/c9ccb158-df68-4e10-b713-48cd7105a139.jpg
