Unaqwyn/SysP18_1cv/05_Webseite/04_Mediathek/Nicht_verwendet/IMG-20180611-WA0000.jpeg

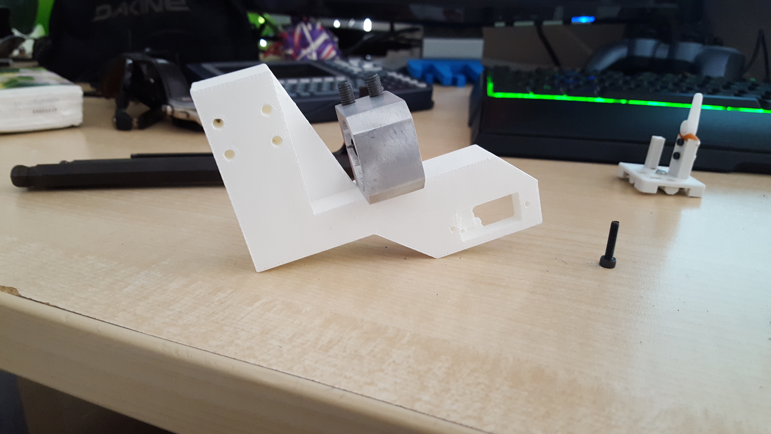
05_Webseite/04_Mediathek/Nicht_verwendet/IMG-20180611-WA0000.jpeg
