Unaqwyn/SysP18_1cv/05_Webseite/04_Mediathek/Nicht_verwendet/IMG_0977.jpg

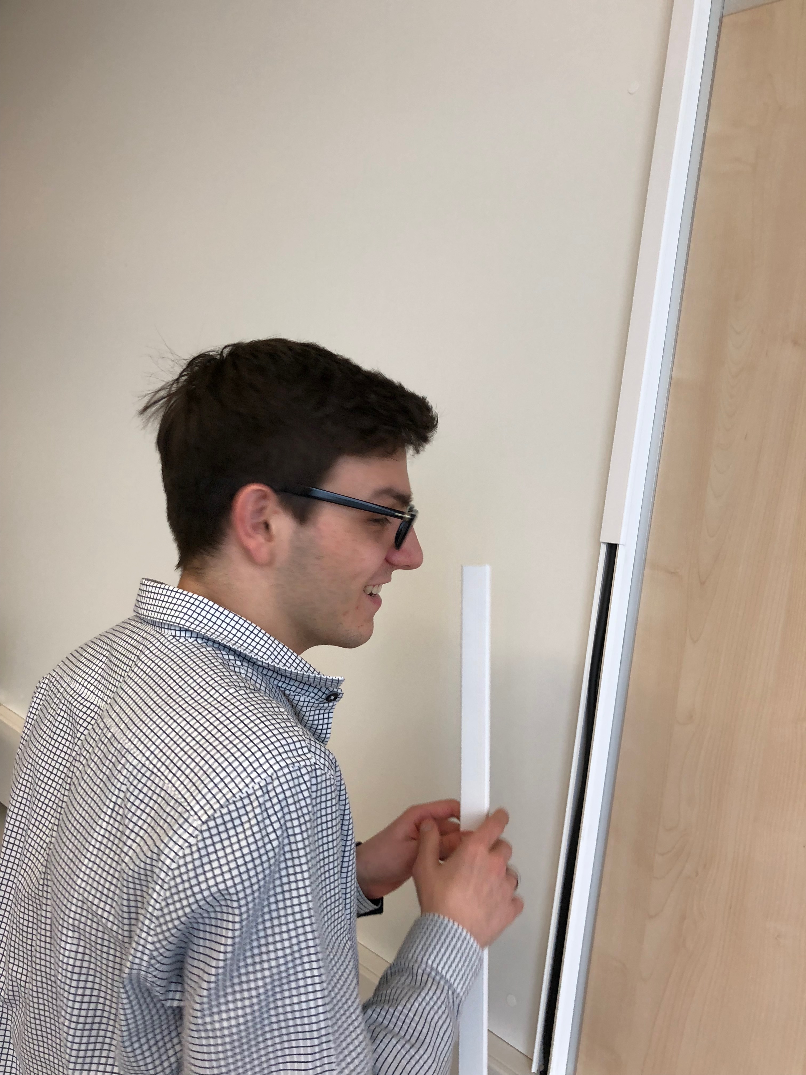
05_Webseite/04_Mediathek/Nicht_verwendet/IMG_0977.jpg
