Unaqwyn/SysP18_1cv/05_Webseite/04_Mediathek/Nicht_verwendet/IMG_6917.JPG

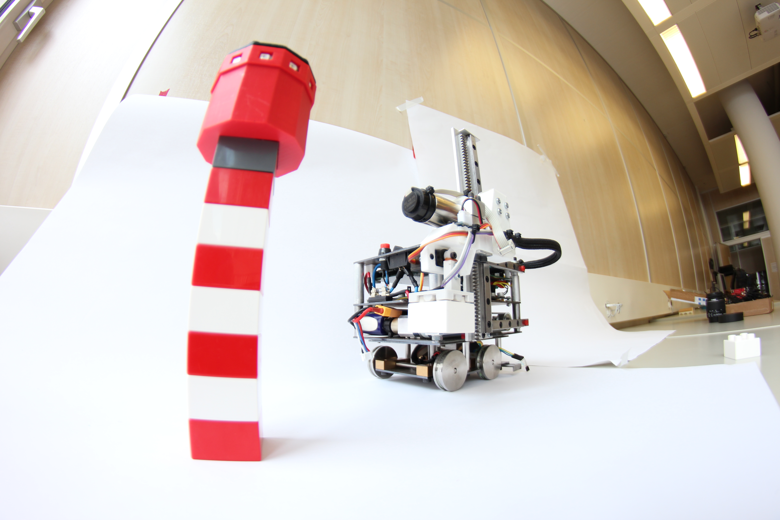
05_Webseite/04_Mediathek/Nicht_verwendet/IMG_6917.JPG
