Unaqwyn/SysP18_1cv/05_Webseite/05_Robi/Ablauf/IMG_2410.jpg

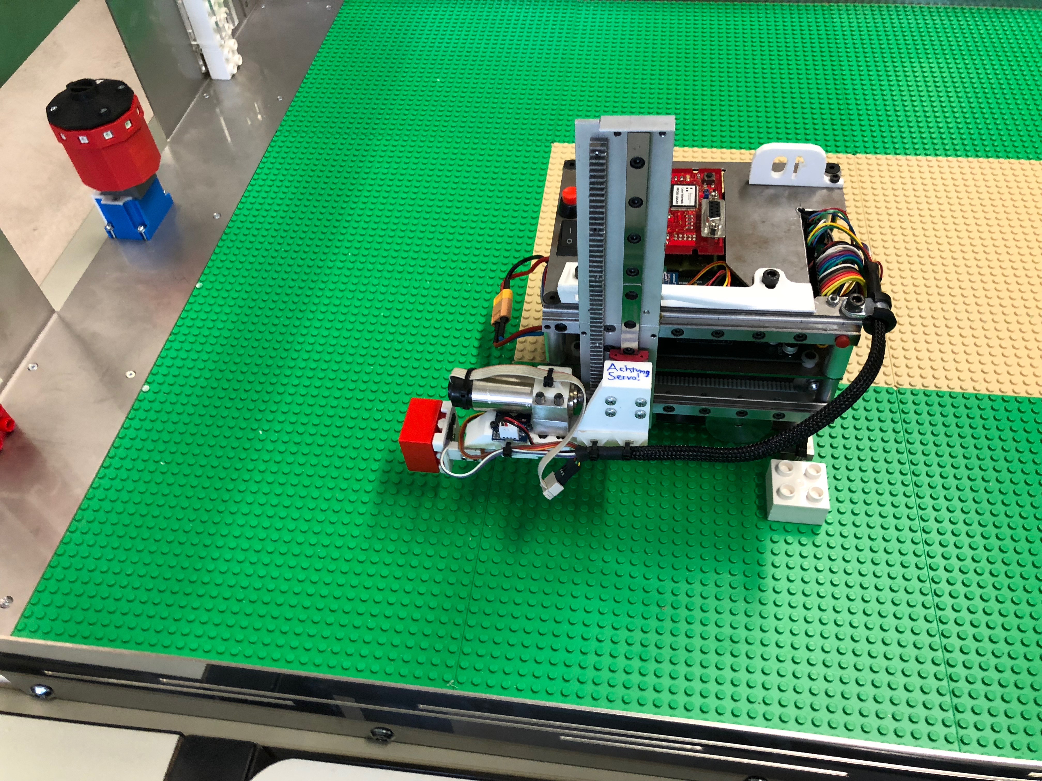
05_Webseite/05_Robi/Ablauf/IMG_2410.jpg
