Unaqwyn/SysP18_1cv/05_Webseite/05_Robi/Ablauf/IMG_2416.jpg

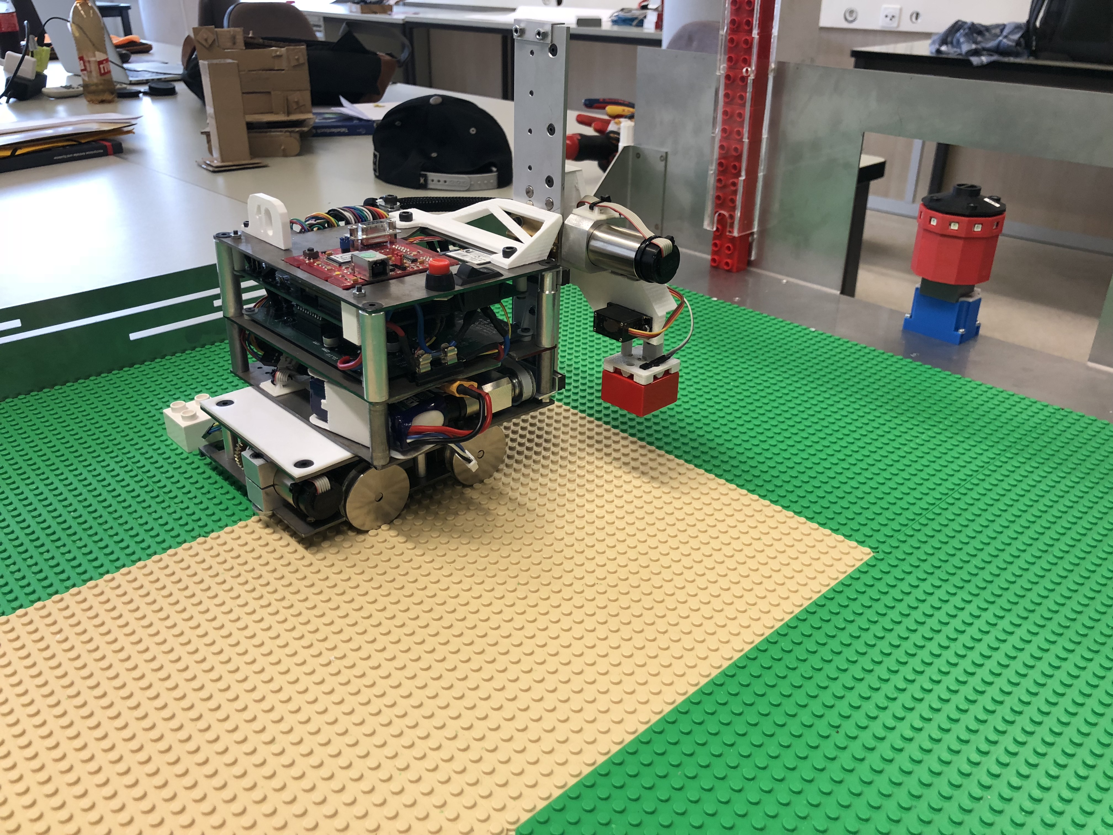
05_Webseite/05_Robi/Ablauf/IMG_2416.jpg
