Unaqwyn/SysP18_1cv/05_Webseite/05_Robi/IMAG0251.jpg

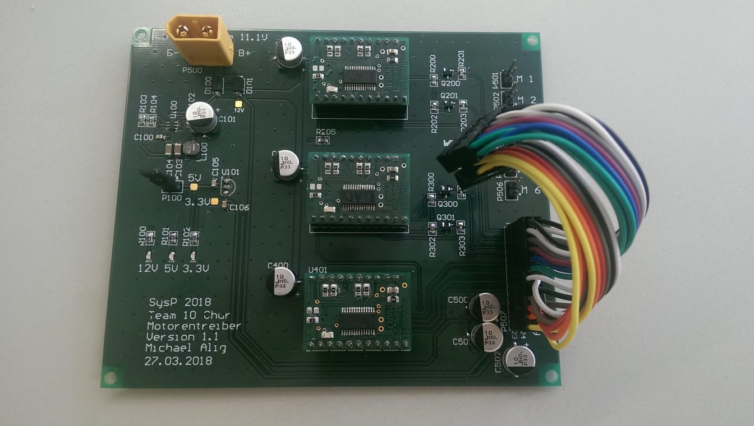
05_Webseite/05_Robi/IMAG0251.jpg
