Unaqwyn/SysP18_1cv/05_Webseite/05_Robi/Robi komplett.png

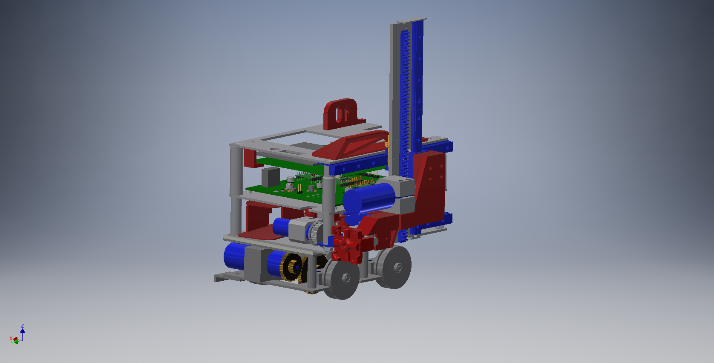
05_Webseite/05_Robi/Robi komplett.png
