Unaqwyn/SysP18_1cv/01_Organisation/05_Bestellungen/Budget.xlsx

Budget |  |  | Total: | SFr.714.46
 |  |  |  |  |  | unklar
Kategorie | Artikel | Preis | Lieferant | Lieferungkosten | Summe
Elektronik | Bestückung Komplett | SFr.70.00 | mouser etc. | SFr.20.00 | SFr.90.00
 | Platinen 2x | SFr.170.00 | ntb | SFr.0.00 | SFr.170.00
Mechanik | Motoren | gesponsert | sponsor | SFr.0.00 | SFr.0.00
 | Micro-Servo | SFr.9.95 | conrad.ch | SFr.8.95 | SFr.18.90
 | Vibrationsmotor | SFr.3.15 | distrelec.ch | SFr.0.00 | SFr.3.15
 | Kunststoffplatte | SFr.37.26 | distrelec.ch | SFr.0.00 | SFr.37.26
 | Schienen m. Wagen | 75 | distrelec.ch | SFr.0.00 | SFr.75.00
Nachbestellung | Antrieb |  | conrad.ch | SFr.13.50 | SFr.17.95
Mechanik | Antrieb |  | distrerelec.ch | SFr.12.40 | SFr.3.20
 | Antrieb |  | maedler.ch | ? | SFr.199.00
Materialkosten
WerkstattNTB | Annahme | SFr.100.00 | - | SFr.0.00 | SFr.100.00
