Unaqwyn/SysP18_1cv/01_Organisation/05_Bestellungen/Bestellformular_SysProjekt_18.xlsx

Bestellung Team: | 10
Zuständig für Rückfragen: | Marcel Sonderegger
email | msonderegger@ntb.ch
Bestelldatum: | 2018-05-01
Lieferant | Menge | Art. Nr. | Artikel | Preis/Stück | Total CHF
conrad.ch | 1 | 236950 | Messing, Stahl Schneckenradsatz, Reely Modul-Typ: 0.75 Anzahl Zähne: 40 | SFr.17.95 | 17.95
distrelec.ch | 1 | 148-50-105 | Rillenkugellager 16 mm, 625, SKF | SFr.3.20 | 3.20
maedler.ch | 6 | 60120700 | Drehstarre Kupplung HZ mit Sacklochbohrung 4mm max. Drehmoment 0,5 Nm Außendurchmesser 12,7mm | SFr.17.94 | 116.25
maedler.ch | 3 | 16051200 | Zahnriemenrad aus Polyacetal gespritzt Profil T2,5 12 Zähne für Riemenbreite 6mm | SFr.4.10 | 12.30
maedler.ch | 1 | 16054000 | Zahnriemenrad aus Polyacetal gespritzt Profil T2,5 40 Zähne für Riemenbreite 6mm | SFr.7.23 | 7.23
maedler.ch | 1 | 16060000 | PU-Zahnriemen Profil T2,5 Breite 6mm Meterware 6 T2,5 (Polyurethan mit Stahl-Zugstrang) | SFr.34.04 | 34.04
maedler.ch | 1 | 16069900 | Klemmplatte aus Aluminium für Zahnriemen Profil T2,5 Riemenbreite 6mm | SFr.15.16 | 15.16
maedler.ch | 1 | 28102800 | Stirnzahnrad aus Polyacetal gespritzt mit Nabe Modul 0,5 28 Zähne Zahnbreite 3mm Außendurchmesser 15mm | SFr.0.79 | 0.79
maedler.ch | 1 | 28103200 | Stirnzahnrad aus Polyacetal gespritzt mit Nabe Modul 0,5 32 Zähne Zahnbreite 3mm Außendurchmesser 17mm | SFr.0.82 | 0.82
maedler.ch | 1 | 28160100 | Zahnstange aus Polyacetal Modul 0,5 Zahnbreite 4mm Höhe 4,5mm Länge 250mm | SFr.1.82 | 1.82
maedler.ch | 2 | 28103000 | Stirnzahnrad aus Polyacetal gespritzt mit Nabe Modul 0,5 30 Zähne Zahnbreite 3mm Außendurchmesser 16mm | SFr.0.79 | 1.58
 |  |  |  |  | 0.00
 |  |  |  |  | 0.00
 |  |  |  |  | 0.00
 |  |  |  |  | 0.00
 |  |  |  |  | 0.00
 |  |  |  |  | 0.00
 |  |  |  |  | 0.00
 |  |  |  |  | 0.00
