Unaqwyn/SysP18_1cv/01_Organisation/05_Bestellungen/Bestellformular_SysProjekt_18_Team10_Elektronik.xlsx

Bestellung Team: | 10
Zuständig für Rückfragen: | Marcel Sonderegger
email | msonderegger@ntb.ch
Bestelldatum: | 2018-04-06 |  |  |  | NTB verfügbar
Lieferant | Menge | Art. Nr. | Artikel | Preis/Stück | Total CHF
MPC555 + Sensoren
mouser.ch | 4 | 598-AVE476M16D16T-F | ELKO 47uF 16V | SFr.0.38 | 1.50
mouser.ch | 6 | 80-C0805S104K5RAUTO | Keramikvielschichtkondensator,0805, 0.1 µF, 50 V, ± 10%, X7R | SFr.0.07 | 0.42
mouser.ch | 1 | 710-885012207033 | Keramikvielschichtkondensator, SMD, 0805, 1000 pF, 16 V, ± 5%, C0G / NP0 | SFr.0.07 | 0.07
mouser.ch | 1 | 710-885012208026 | Keramikvielschichtkondensator, SMD, 1206, 10nF, 16 V, ± 10%, X7R | SFr.0.24 | 0.24
mouser.ch | 1 | 710-885012208041 | Keramikvielschichtkondensator, SMD, 0805, 10 µF, 10 V, ± 10%, X7R, Baureihe C | SFr.0.54 | 0.54
mouser.ch | 1 | 755-SML-D13M8WT86 (https://www.mouser.ch/ProductDetail/ROHM-Semiconductor/SML-D13M8WT86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) | LED, 0603, Grün, Oberflächenmontage, 20 mA, 2.2 V, 560 nm | SFr.0.19 | 0.19
mouser.ch | 1 | 755-SML-D12V1WT86 (https://www.mouser.ch/ProductDetail/ROHM-Semiconductor/SML-D12V1WT86) | LED, 0603, Rot, Oberflächenmontage, 20 mA, 2.2 V, 630 nm | SFr.0.20 | 0.20
mouser.ch | 1 | 755-SML-D12D1WT86 (https://www.mouser.ch/ProductDetail/ROHM-Semiconductor/SML-D12D1WT86) | LED, 0603, Orange, Oberflächenmontage, 20 mA, 2.2 V, 605 nm | SFr.0.20 | 0.20
mouser.ch | 1 | 771-BAT721S-T/R | 771-BAT721S - Kleinsignal-Schottky-Diode, Zwei in Reihe, 40 V, 200 mA, 1 A, SOT 23 | SFr.0.50 | 0.50
mouser.ch | 4 | 621-BC846B-7-F | Bipolarer Einzeltransistor (BJT), NPN, 65 V, 300 MHz, 300 mW, 100 mA, 330 hFE | SFr.0.19 | 0.76
mouser.ch | 1 | 942-IRF7204PBF | IRF7204PBF - MOSFET-Transistor, p-Kanal, 5.3 A, -20 V, 60 mohm, -10 V, -2.5 V | SFr.0.75 | 0.75
mouser.ch | 2 | 942-IRF7311PBF | IRF7311PBF - Dual-MOSFET, Zweifach n-Kanal, 6.6 A, 20 V, 29 mohm, 4.5 V, 700 mV | SFr.0.96 | 1.92
mouser.ch | 10 | 667-ERJ-6RBD1002V | 10 kOhm, 0805 | SFr.0.16 | 1.59
mouser.ch | 4 | 667-ERJ-6RBD1001V | 1kOhm, 0805 | SFr.0.17 | 0.70
mouser.ch | 1 | 667-ERJ-U06F16R0V | 16kOhm, 0805 | SFr.0.04 | 0.04
mouser.ch | 1 | 667-ERJ-6GEYJ432V | 4.3kOhm, 0805 | SFr.0.11 | 0.11
mouser.ch | 1 | 667-ERJ-6GEYJ511V | 510 Ohm, 0805 | SFr.0.11 | 0.11
mouser.ch | 1 | 653-B3SE-1002P | B3SE-1002P Switch | SFr.0.60 | 0.60
mouser.ch | 1 | 968-ICM7555CBAZ | ICM7555 CMOS Timer | SFr.0.67 | 0.67
mouser.ch | 1 | 771-HC237D653 | Decoder 3-8 line, SO16 | SFr.0.54 | 0.54
Motorentreiber und Stromversogung
mouser.ch | 2 | 710-885012207072 | 885012207072 - 0.1uf , MLCC, 805, X7R | SFr.0.07 | 0.14
mouser.ch | 7 | 598-AVE476M16D16T-F | AVE476M16D16T-F, Elko | SFr.0.38 | 2.64
mouser.ch | 2 | 963-EMK316BB7226ML-T | MLCC - SMD/SMT 22uF 16V X7R +/-20% 1206 Gen | SFr.0.96 | 1.92
mouser.ch | 2 | 710-885012207051 | SMD/SMT WCAP-CSGP 1uF 0805 10% 16V MLCC | SFr.0.17 | 0.34
mouser.ch | 3 | 859-LTST-C190GKT | LTST-C190GKT LED Grün 20ma 2.1V | SFr.0.24 | 0.72
mouser.ch | 1 | 963-NRS5020T4R7MMGJ | NRS5020T4R7MMGJ 4.7 uH, 2A | SFr.0.32 | 0.32
mouser.ch | 3 | 538-22-28-5364 | Terminals/Header 36position 1 row | SFr.1.41 | 4.23
mouser.ch | 3 | 538-10-89-7122 | Header 12 Position 2 row | SFr.2.01 | 6.03
mouser.ch | 1 | 926-38691DT-3.3/NOPB | LDO-Festspannungsregler, 2.7V bis 10V, 330mV Dropout, 3.3Vout, 500mAout | SFr.1.87 | 1.87
mouser.ch | 1 | 667-ERJ-6GEYJ183V | 18k, 0805 | SFr.0.19 | 0.19
mouser.ch | 1 | 667-ERJ-PB6B5601V | 5.6k, 0805 | SFr.0.55 | 0.55
mouser.ch | 1 | 667-ERJ-6GEYJ472V | 4.7k, 0805 | SFr.0.19 | 0.19
mouser.ch | 1 | 667-ERJ-6RBD5602V | 56k, 0805 | SFr.0.14 | 0.14
mouser.ch | 6 | 667-ERJ-6RBD1002V | 10 kOhm, 0805 | SFr.0.16 | 0.95
mouser.ch | 4 | 667-ERJ-6RBD1001V | 1k, 0805 | SFr.0.27 | 1.10
mouser.ch | 1 | 781-SI2302CDS-E3 | SI2302CDS-T1-E3 - MOSFET, N CHANNEL, 20V, 2.6A, SOT-23-3 | SFr.0.48 | 0.48
Buchs | 2 | SK34-SMA | DIOTEC-SK34-SMA
Buchs | 4 | - | DRV8841 Steckboards
Buchs | 0 | TPS562209DDCT | TPS562209DDCT - 4.5V-17Vin, 760mV-7Vout, 2Aout
Buchs | 4 | HLC1395 | Optoreflektor Sensor | SFr.2.10 | 8.40
Buchs | 1 | TFM-150-02-LDLC | MPC555 Steckleiste | SFr.11.00 | 11.00
Buchs | 2 | TFM-130-02-LDLC | MPC555 Steckleiste | SFr.7.00 | 14.00
