Unaqwyn/SysP18_1cv/01_Organisation/05_Bestellungen/Bestellformular_SysProjekt_18_Team10_Mechanik.xlsx

Bestellung Team: | 10
Zuständig für Rückfragen: | Marcel Sonderegger
email | msonderegger@ntb.ch
Bestelldatum: | 2018-04-06
Lieferant | Menge | Art. Nr. | Artikel | Preis/Stück | Total CHF
conrad.ch | 1 | 249458 - 62 | Micro-Servo S 36 S36 0.13 s | SFr.9.95 | SFr.9.95
distrelec.ch | 1 | 300-69-914 | Grove Vibrationsmotor | SFr.3.15 | SFr.3.15
distrelec.ch | 1 | 148-21-717 | Kunststoffplatte 295 x 295 x 2 mm, PTFE NATURE 295X295X2, No Brand | SFr.37.26 | SFr.37.26
distrelec.ch | 1 | 182-49-575 | Lötpaste | SFr.17.40 | SFr.17.40
distrelec.ch | 1 | 182-49-574 | Dosiernadel | SFr.1.08 | SFr.1.08
distrelec.ch | 1 | 300-72-943 | Schlitten für lineare Führungsschienen 9 mm, Vorgeschmiert ja, MNN 9-G3-LS, Schneeberger | SFr.29.67 | SFr.29.67
distrelec.ch | 1 | 300-72-923 | Lineare Führungsschiene 9/275 mm, MN 9-275-G3-V0, Schneeberger | SFr.45.05 | SFr.45.05
