Unaqwyn/SysP18_1cv/01_Organisation/02_Meilensteine/m1b/Ideensammlung.xlsx

Sheet: Bewegung
Nr. | Typ | Beschreibung | Zeichnungslink
1 | Raupe | Flache Raupen
2 |  | Dreiecks-Raupen
3 |  | Flache Raupen mit Führung in der Mitte
4 |  | "Schienen": Raupen die zwischen den Lego-Köpfen fahren
5 | Räder | 4 Räder mit Lenkachse
6 |  | Omniräder
7 |  | 3 Räder
8 | Beine | Octoped
9 |  | "Zwei Beiner"
10 | Rollen | Kugelförmiges Design des Roboters: Fortbewegung durch rollen
11 | Vibration | siehe Link
12 | Luftkissen | Luftkissenboden mit Propeller-Antrieb
13 | Rotoren | Helikopter
14 |  | Quadrotor
15
16
17
18
19
20

Sheet: Antrieb_Energieübertragung
Nr. | Typ | Beschreibung | Zeichnungslink
1 | Zahnräder
2 | Kettenübertagung
3 | Keilriemen
4 | Getriebe
5
6
7
8
9
10
11
12
13
14
15
16
17
18
19
20

Sheet: Sensorik
Nr. | Typ | Beschreibung | Zeichnungslink
1 | Orientierenug | 360° Umdrehung mit Ultraschallsensor
2 |  | Distanzsensor am Boden des Roboters: Spielfeldrand suchen
3 |  | Farbsensor am Boden des Roboters: Spielfeldmitte suchen
4 |  | Tastsensor: Spielfeld wand erfühlen
5 |  | Materialsensor: Metallwand suchen
6 |  | Kamera: Turmspitze suchen, Silos suchen
7 |  | GPS-Orientierung
8 | Referenzpunkte | Turmspitze
9 |  | Lego-Vorräte
10 | Sensorik | Tastsensor: Für Legoklötze und Turmspitze
11 |  | Farbsensor: Unterscheidung rote/weisse Klötze
12 |  | Kamera: Erkennung des anderen Roboters
13 |  | Distanzsensor am Boden des Roboters: Absturzsicherung
14
15
16
17
18
19
20

Sheet: Handling
Nr. | Typ | Beschreibung | Zeichnungslink
1 | Blöcke bewegen | klassischer Greifarm
2 |  | Legostein als Gegenstück
3 |  | Saugnapf
4 |  | Greifarm mit Spinel
5 |  | Schaufelrad
6 |  | Kombo: Lego als Gegenstück + Greifarm mit Spindel | .--->
7 | Taktiken | Turm von unten nach oben: nicht in der Höhe beschränkt
8
9
10
11
12
13
14
15
16
17
18
19
20
