Unaqwyn/SysP18_1cv/01_Organisation/02_Meilensteine/m1b/alte_Versionen/SysP18-Team 10-morphologischer Kasten_V2_2017_11_04_M.Stoffel.xlsx

Teilsystem | Lösungsvarianten
Energieversorgung | Lithium-Polymer- Akkumulator (LiPo-Akku) | Nickel-Cadmium-Akkumulator (NiCd-Akku) | Blei-Akkumulator | Verbrennungsmotor | Photovoltaische Zelle (Solarzelle) | Potenzielle Energie durch Spannen einer Feder | Druckluftspeicher | AKW | Dampfmaschine
Kommunikation zwischen den Robotern | Wireless Local Area Network (W-LAN) | Bluetooth | Infrarot | Akustisch
Fortbewegung auf dem Spielfeld | 3 Räder | 4 Räder | Diagonal-Räder (Omniräder) | Schienen | Flache Raupen | Dreiecks-Raupen | 2 Beine | Octoped | Quadrokopter | Helikopter | Lufftkissen-Boot | Kugelförmiges Design (Fortbewegung durch Rollen)
Antrieb für Fortbewegung | Permanent erregter Gleichstrom-Elektromotor | Bürstenloser Gleichstrommotor (Brushless-motor) | Schrittmotor
Heandlingsystem für die Lego-Duplo-Steine / Leuchtturm | Zange betätigt durch eine Spindel | Hydraulisch betätigte Zange | Pneumatisch betätigte Zange | Saugnapf | Lego-Duplo-Stein als Gegenstück | Sekundenkleber | Magnet | Schaufelrad | Kombo: Lego als Gegenstück + Greifarm mit Spindel
Antrieb für das Handlingsystem | Digital-Metallgetriebeservo aus dem Modellbaubereich | Permanent erregter Gleichstrom-Elektromotor | Bürstenloser Gleichstrommotor (Brushless-motor) | Schrittmotor mit Positionsgeber
Handhabung der Lego-Duplo-Steine | Lego-Duplo-Steine von oben stapeln | Lego-Duplo-Steine von unten stapeln | Zwischenlager für Lego-Duplo-Steine im Roboter | Hub-Gabelstapler
Orientierung auf dem Spielfeld, Sensorik | Kamera | Global Positioning System (GPS) | Infrarot-Sensor | Distanzmesser (Spielfeldwand suchen) | Distantmesser (Spilfeldrand suchen) | Bezugspunkt auf dem Spielfeld | Farbsensor (Spielfeldmitte suchen) | Tastsensor (Spielfeldwand erfühlen) | Materialsensor (Metallwand suchen)
