Unaqwyn/SysP18_1cv/02_Mechanik/Lagerbock_sysp.stp

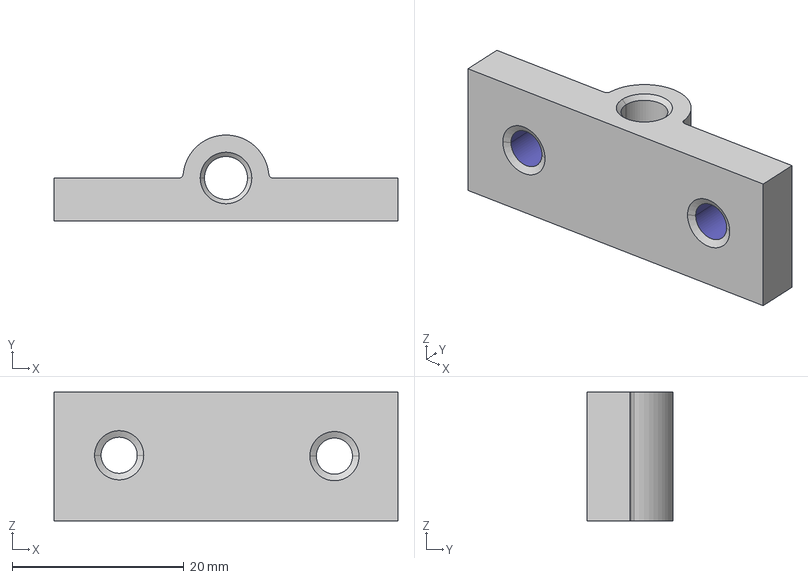
[picture p303: CAD file, 2018-03-06]
02_Mechanik/Lagerbock_sysp.stp
40.0 x 10.0 x 15.0 mm
