Unaqwyn/SysP18_1cv/03_Elektronik/Motortreiber, Spannungsversorgung/PCB.step

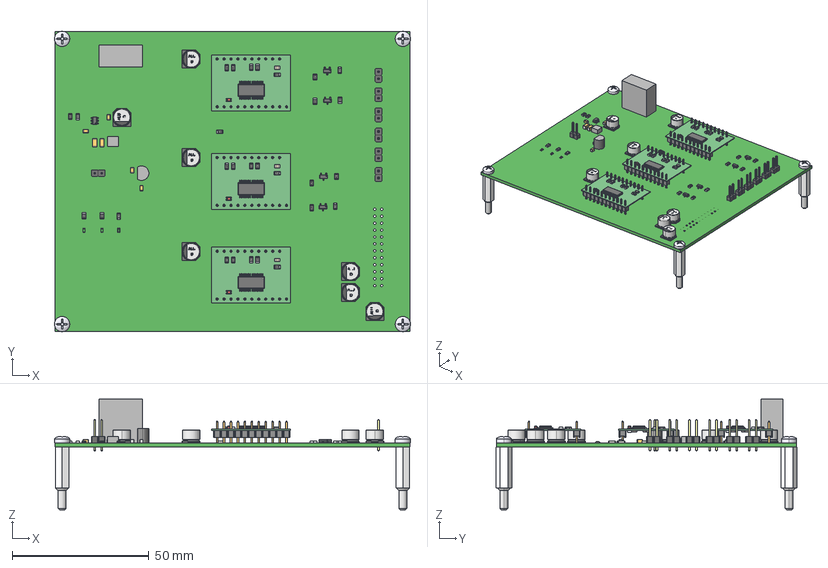
[picture p304: CAD file, 2018-06-12]
03_Elektronik/Motortreiber, Spannungsversorgung/PCB.step
130.3 x 110.2 x 40.5 mm
Board x 4
CAPC2012X120N_EIA_0805 x 4
User_Library-ALU-D_Fuss_1 x 7
User_Library-ALU-D_Pins_1 x 7
User_Library-ALU-D_K_X_F6rper_1 x 7
User_Library-ALU-D_Beschriftung_1 x 7
CAPC3216X180N_EIA_1206 x 2
User_Library-led_0603_(2) x 3
Extruded x 3
User_Library-Header_Male_2Pin_PinArray x 7
User_Library-Header_Male_2Pin_BodyArray x 7
User_Library-SOT23-3 x 4
User_Library-RES_2013-0805 x 32
M3x0_5x10_Phillips_Panhead_Screw x 4
User_Library-SOT23-6-2
User_Library-PWP_(R-PDSO-G28)_PWP_Koerper x 3
User_Library-PWP_(R-PDSO-G28)_PWP_PIN x 84
User_Library-PWP_(R-PDSO-G28)_PWP_THERM_PIN x 3
LED0805_red x 3
CAP0805 x 12
User_Library-Header_Vertical_2.54mm_Pitch2-1_2 x 63
