Unaqwyn/SysP18_1cv/03_Elektronik/veralteteDateien/SysP18_Robi/SensorenUndMPC555Stand28.03fürCAD.step

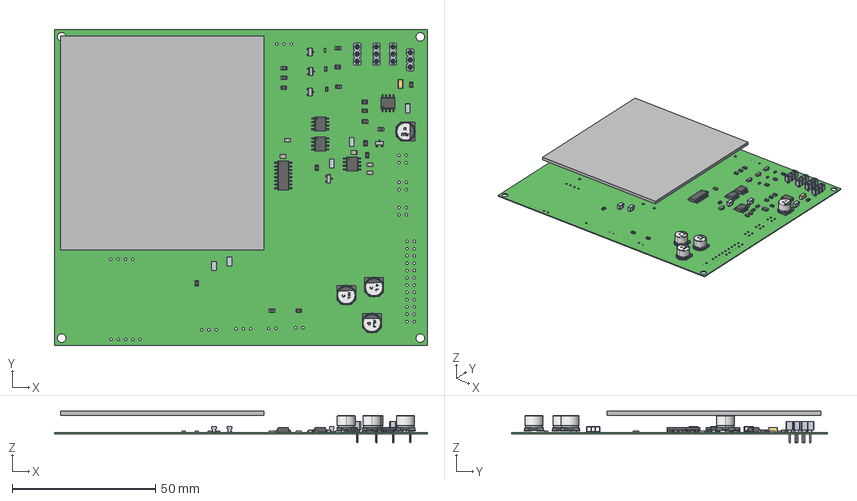
[picture p305: CAD file, 2018-04-04]
03_Elektronik/veralteteDateien/SysP18_Robi/SensorenUndMPC555Stand28.03fürCAD.step
130.0 x 110.0 x 11.1 mm
Board
Extruded
SO16
SO8 x 4
RCW_1206 x 5
RES0805 x 17
FAIRCHILD-SOT-23_3L x 5
3Pin_Buchsenleiste x 4
User_Library-led_0603_(2) x 3
CAP0805 x 8
CAPC3216X180N_EIA_1206
User_Library-ALU-D_Fuss_1 x 4
User_Library-ALU-D_Pins_1 x 4
User_Library-ALU-D_K_X_F6rper_1 x 4
User_Library-ALU-D_Beschriftung_1 x 4
