Unaqwyn/SysP18_1cv/01_Organisation/02_Meilensteine/m4/SysP18-Team-10-Bedienungs_und_Wartungsanleitung_2018_06_15.docx

# Bedienungs- und Wartungsanleitung

## Bedienungsanleitung

1. Akku anschliessen
  1.1. Akku aus der Hülle nehmen
  1.2. Akku mit Spannungsprüfer überprüfen
  1.3. Feinsicherung (2A) kontrollieren
  1.4. Akku anstecken und in Akkugehäuse einschieben
  1.5. Hauptschalter einschalten
2. Roboter nur an der Bodenplatte von Hand halten und anheben

Roboter auf dem Spielfeld platzieren

  2.1. Greifarm muss Richtung Spender zeigen und auf die Legosteine ausgerichtet werden. Roboter in Ausgangstellung bringen:
    2.1.1. Arm vorsichtig horizontal verschieben, bis dieser ganz hinten an der Schiene Ankommt.
    2.1.2. Arm vorsichtig vertikal verschieben, sodass der Servo-Motor sich zwischen den beiden Schienen befindet.
    2.1.3. Schiene umklappen, sodass sie auf dem Roboter liegt.
  2.2. Räder müssen zwischen den «Noppen» der Legogrundplatte laufen.
3. Wenn beide Roboter bereit sind, «Start» Taster drücken
4. Nach Vollendung des Programms; Hauptschalter betätigen und Roboter wieder in Ausgangsstellung bringen.

## Wartungsanleitung

### Mechanik

Alle Schrauben sind periodisch zu prüfen und gegeben Falles nachzuziehen.

Die Lagerung des Roboters muss immer in einem trocknen Bereich bei Raumtemperatur erfolgen.

Der Keilriemen kann mithilfe der Stellschraube ideal gespannt und danach mit der Fixierschraube befestigt werden.

### Elektronik

Beide Elektronikplatinen müssen regelmüssig und vorsichtig von Staub befreit werden. Bei diesem Vorgang können sie gleichzeitig auf Beschädigung überprüft werden.

- Akku:
  - Sobald der Roboter für länger Zeit ausgeschaltet wird, ist der Akku zu entfernen.
  - Er sollte, wenn immer möglich in einem Batterie-Safe Bag aufbewahrt werden.
  - Regelmässiges überprüfen des Ladezustandes ist empfohlen.
- Feinsicherung:
  - Für eine sichere Verwendung wird eine 2A Feinsicherung empfohlen.
- Allgemein:
  - Weder Drehen, anheben des Liftes, noch das ausfahren des Armes sollten von Hand vorgenommen werden. Dies könnte Beschädigungen an den Motoren oder der Mechanik nach sich ziehen.

SysP18-Team-10-Bedienungs_und_Wartungsanleitung_2018_06_15.docxSeite 1 von 12018_06-15
