Unaqwyn/SysP18_1cv/03_Elektronik/veralteteDateien/PCB_SysP17_Official_170617_1141/Print.PcbDoc.htm

Reporting Options

# File in Previous Format

Date | : | 27.03.2018
Time | : | 14:20:04
Filename | : | M:\GitHub\SysP18_1cv\03_Elektronik\PCB_SysP17_Official_170617_1141\Print.PcbDoc

Version | Warning

This file was generated by an earlier version of the software
