Unaqwyn/SysP18_1cv/TEstordner/Flyer tetxt.docx

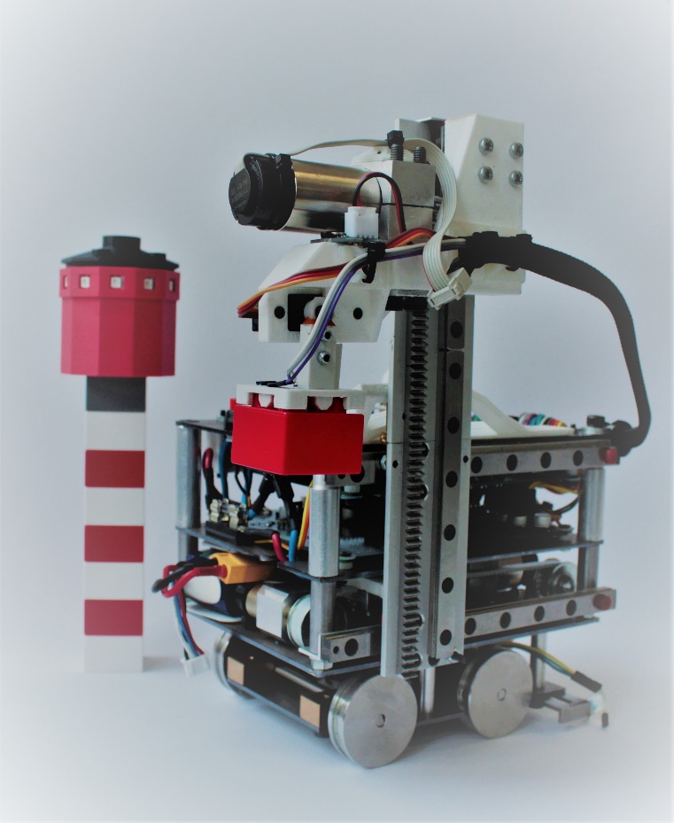
[picture p306: figure]

Klaus der Leuchtturmbauer

- - Innovativ
- - Zuverlässig
- - Stabil
- - qualitativ hochwertig

Team 10:

- Weber Luzian
- Alig Michael
- Meyer Erich
- Jäger Romario
- Stoffel Mauro
- Zwick Jeannot
