Unaqwyn/SysP18_1cv/03_Elektronik/veralteteDateien/SysP18_Robi/SysP18_Robi.pdf

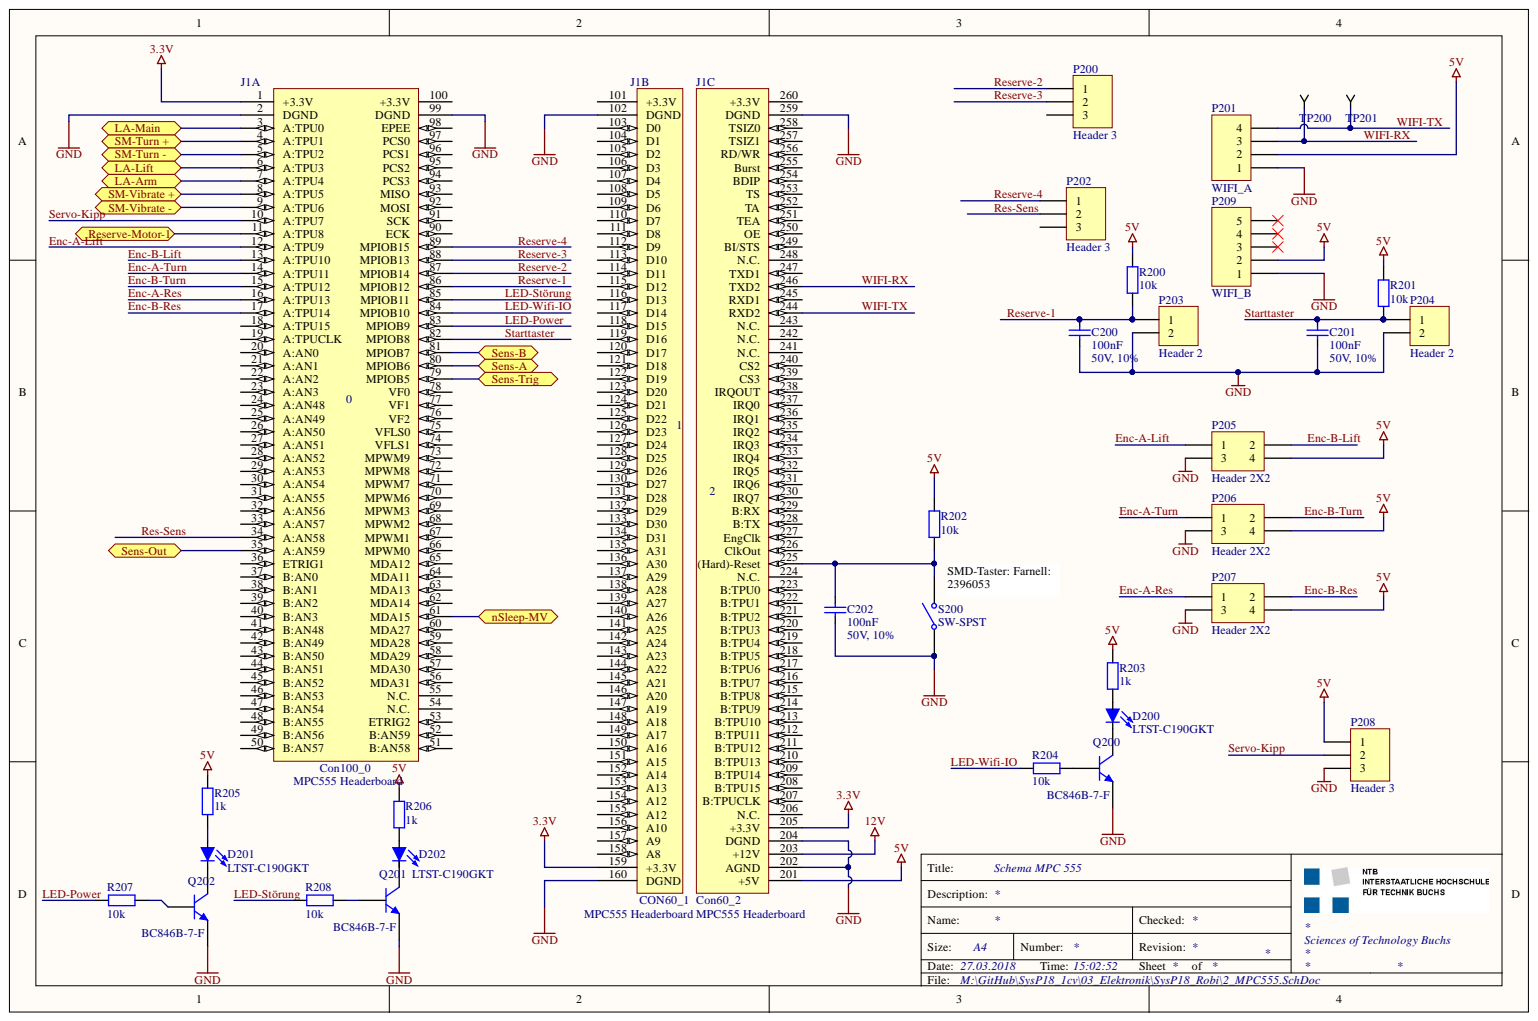
[picture p307: page 1]

Name: | : *

Size: A 4 | N umber: * | Rev i s i o n : * *

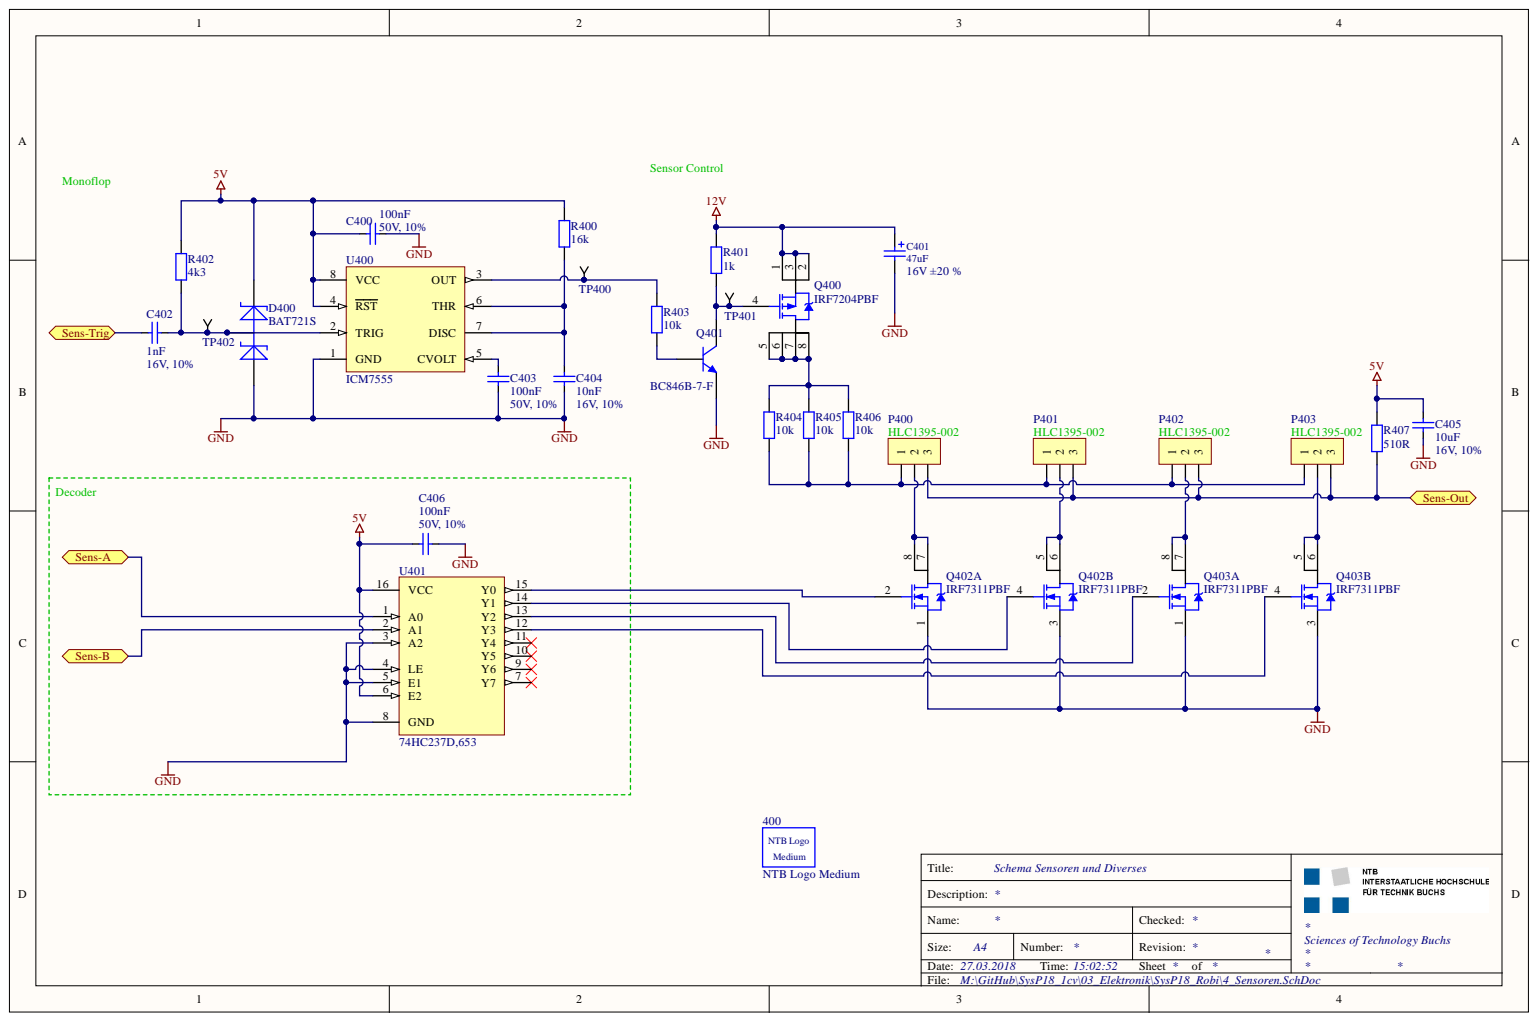
[picture p308: page 2]

Schema Sensoren und Diverses

Name: * | Checked: *

Size: A4 | Number: * | Revision: * *

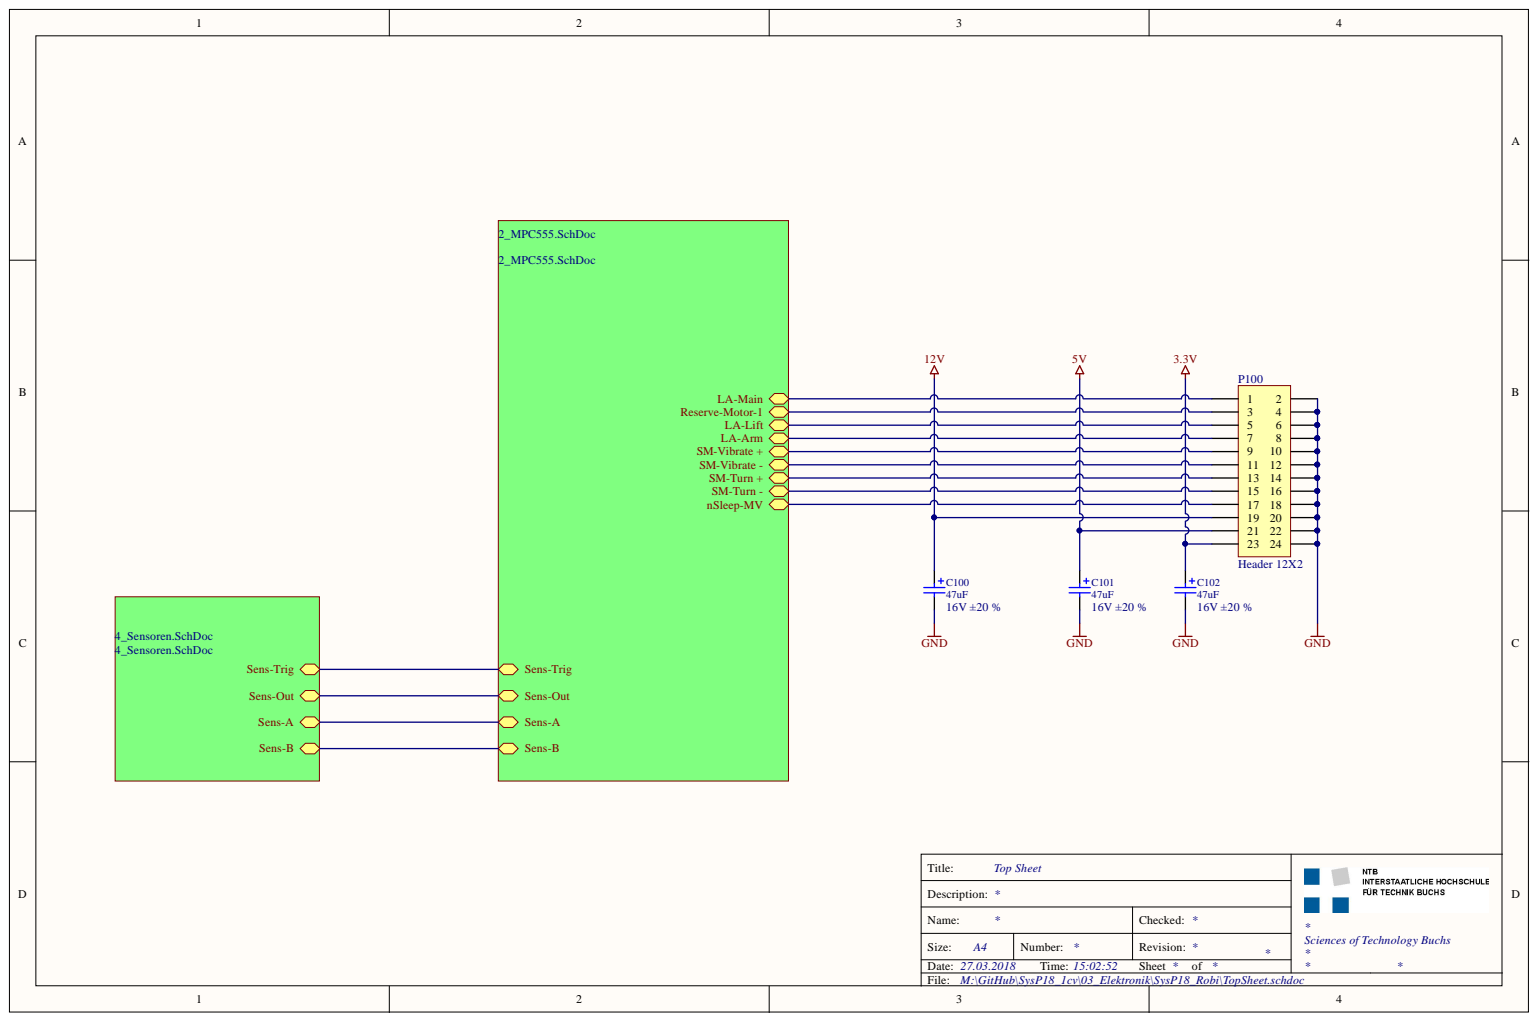
[picture p309: page 3]

Name: * | Checked: *

Size: A4 | Number: * | Revision: * *

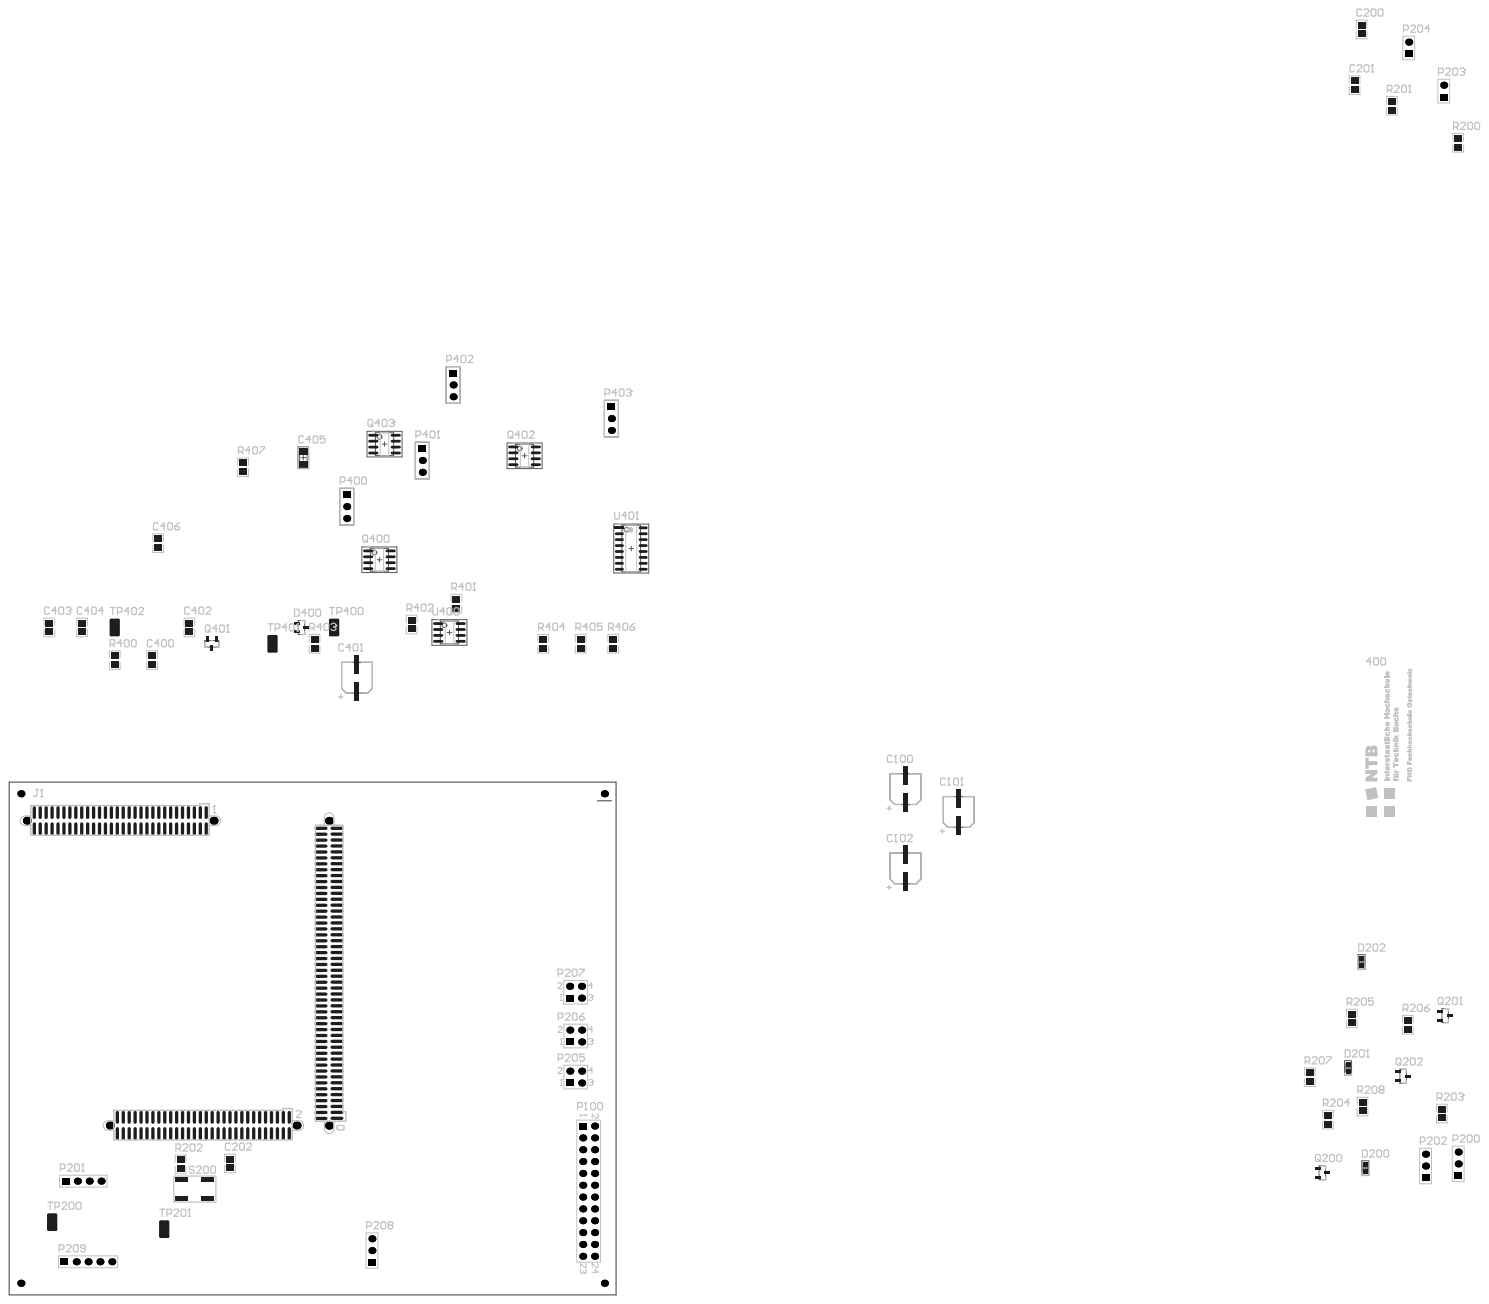
[picture p310: page 4]
