Unaqwyn/SysP18_1cv/04_Informatik/99_Altes_Programm/Aktuelle_Dokumente/Zustandsdiagramm.pdf

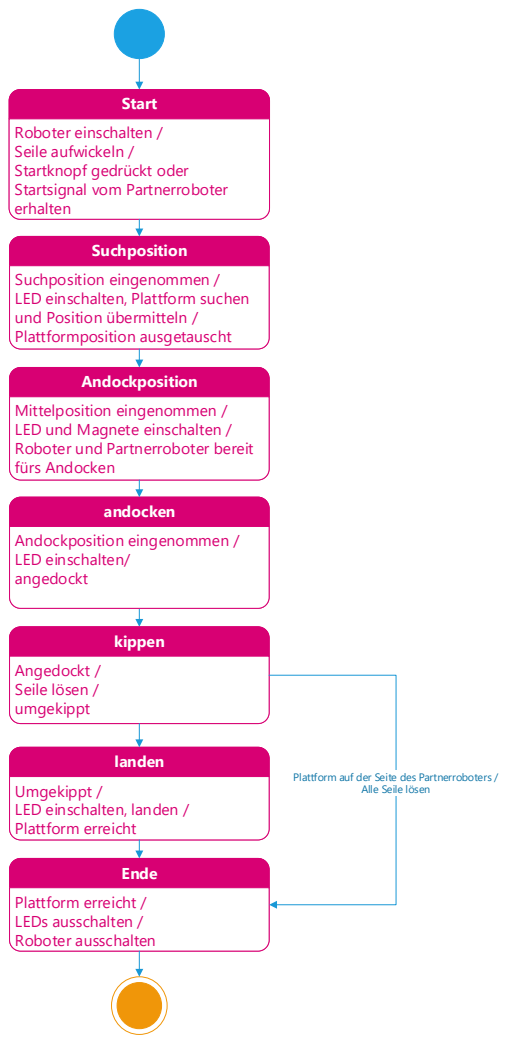
[picture p311: page 1]
Start; Suchposition; andocken; Andockposition eingenommen / LED einschalten/ angedockt; kippen; Angedockt / Seile lösen / umgekippt; Andockposition; landen; Ende; Plattform erreicht / LEDs ausschalten / Roboter ausschalten; Plattform auf der Seite; des Partnerroboters /

Roboter einschalten /
Seile aufwickeln /
Startknopf gedrückt oder
Startsignal vom Partnerroboter
erhalten

Suchposition eingenommen /
LED einschalten, Plattform suchen
und Position übermitteln /
Plattformposition ausgetauscht

Mittelposition eingenommen /
LED und Magnete einschalten /
Roboter und Partnerroboter bereit
fürs Andocken

Umgekippt /
LED einschalten, landen /
Plattform erreicht

Alle Seile lösen
