Unaqwyn/SysP18_1cv/04_Informatik/99_Altes_Programm/Aktuelle_Dokumente/CD/Klassendiagramm.pdf

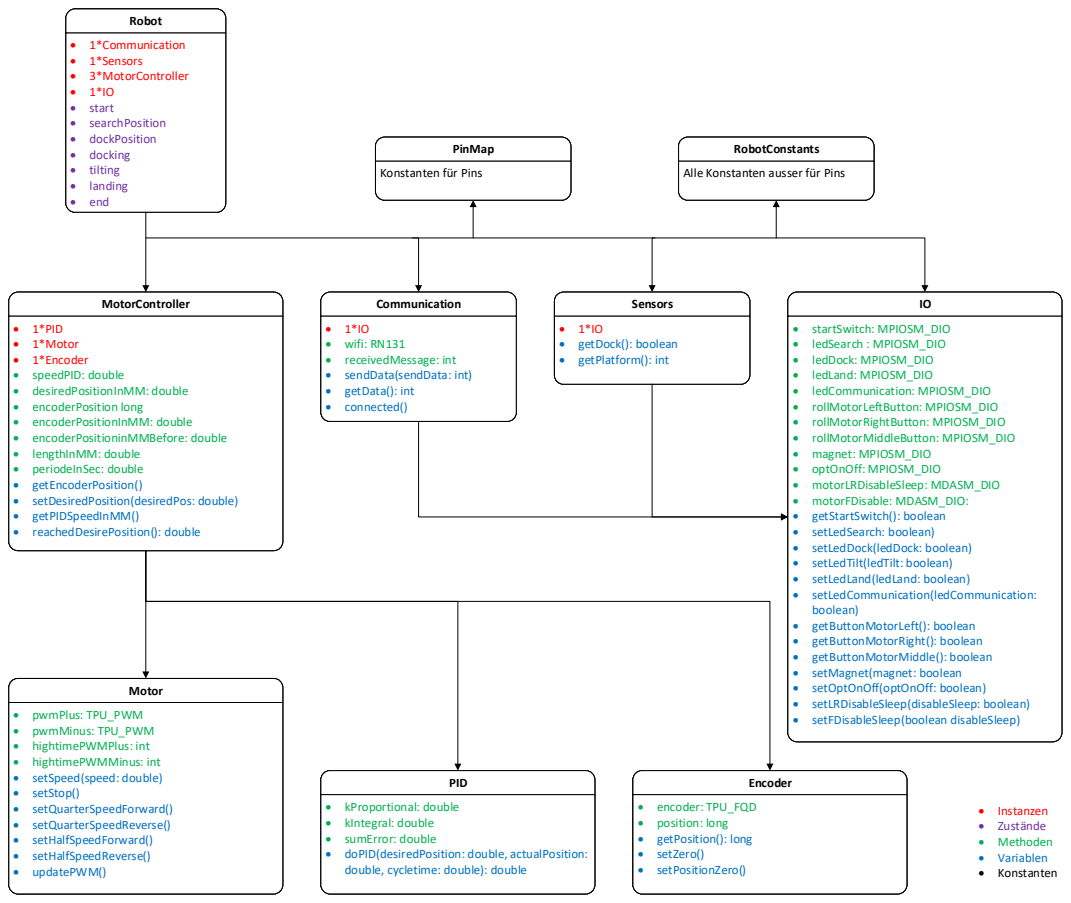
[picture p312: page 1]
Communication; Robot; • 1*Communication • 1*Sensors • 3*MotorController • 1*IO • start • searchPosition • dockPosition • docking • tilting • landing • end; Sensors; • 1*IO • getDock(): boolean • getPlatform(): int; MotorController; Encoder; • encoder: TPU_FQD • position: long • getPosition(): long • setZero() • setPositionZero(); • Instanzen • Zustände • Methoden • Variablen • Konstanten; Motor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

Konstanten für Pins

Alle Konstanten ausser für Pins

• 1*PID
• 1*Motor
• 1*Encoder
• speedPID: double
• desiredPositionInMM: double
• encoderPosition long
• encoderPositionInMM: double
• encoderPositioninMMBefore: double
• lengthInMM: double
• periodeInSec: double
• getEncoderPosition()
• setDesiredPosition(desiredPos: double)
• getPIDSpeedInMM()
• reachedDesirePosition(): double

• wifi: RN131
• receivedMessage: int
• sendData(sendData: int)
• getData(): int
• connected()

• startSwitch: MPIOSM_DIO
• ledSearch : MPIOSM_DIO
• ledDock: MPIOSM_DIO
• ledLand: MPIOSM_DIO
• ledCommunication: MPIOSM_DIO
• rollMotorLeftButton: MPIOSM_DIO
• rollMotorRightButton: MPIOSM_DIO
• rollMotorMiddleButton: MPIOSM_DIO
• magnet: MPIOSM_DIO
• optOnOff: MPIOSM_DIO
• motorLRDisableSleep: MDASM_DIO
• motorFDisable: MDASM_DIO:
• getStartSwitch(): boolean
• setLedSearch: boolean)
• setLedDock(ledDock: boolean)
• setLedTilt(ledTilt: boolean)
• setLedLand(ledLand: boolean)
• setLedCommunication(ledCommunication:
boolean)
• getButtonMotorLeft(): boolean
• getButtonMotorRight(): boolean
• getButtonMotorMiddle(): boolean
• setMagnet(magnet: boolean
• setOptOnOff(optOnOff: boolean)
• setLRDisableSleep(disableSleep: boolean)
• setFDisableSleep(boolean disableSleep)

• kProportional: double
• kIntegral: double
• sumError: double
• doPID(desiredPosition: double, actualPosition:
double, cycletime: double): double
