Unaqwyn/SysP18_1cv/04_Informatik/99_Altes_Programm/Aktuelle_Dokumente/CD/Zustandsdiagramm.pdf

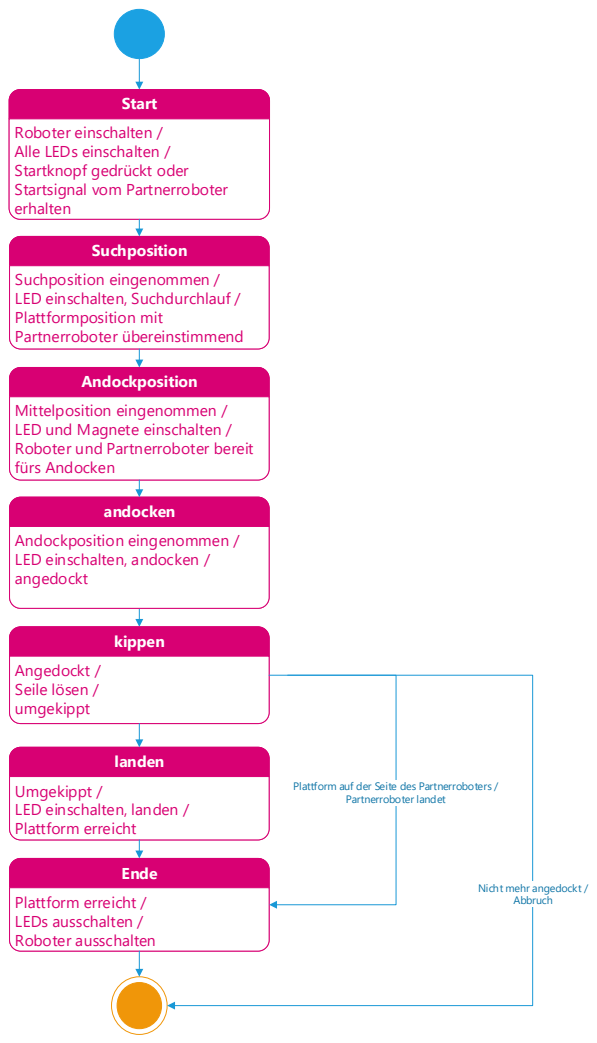
[picture p313: page 1]
Start; Suchposition; andocken; kippen; Angedockt / Seile lösen / umgekippt; Andockposition; landen; Abbruch; Ende; Plattform erreicht / LEDs ausschalten / Roboter ausschalten; Plattform auf der Seite; des Partnerroboters /; Partnerroboter landet

Roboter einschalten /
Alle LEDs einschalten /
Startknopf gedrückt oder
Startsignal vom Partnerroboter
erhalten

Suchposition eingenommen /
LED einschalten, Suchdurchlauf /
Plattformposition mit
Partnerroboter übereinstimmend

Mittelposition eingenommen /
LED und Magnete einschalten /
Roboter und Partnerroboter bereit
fürs Andocken

Andockposition eingenommen /
LED einschalten, andocken /
angedockt

Umgekippt /
LED einschalten, landen /
Plattform erreicht

Nicht mehr angedockt /
