Unaqwyn/SysP18_1cv/01_Organisation/02_Meilensteine/06_Datenblätter/01_Elektronik/Wifimodulschema.pdf

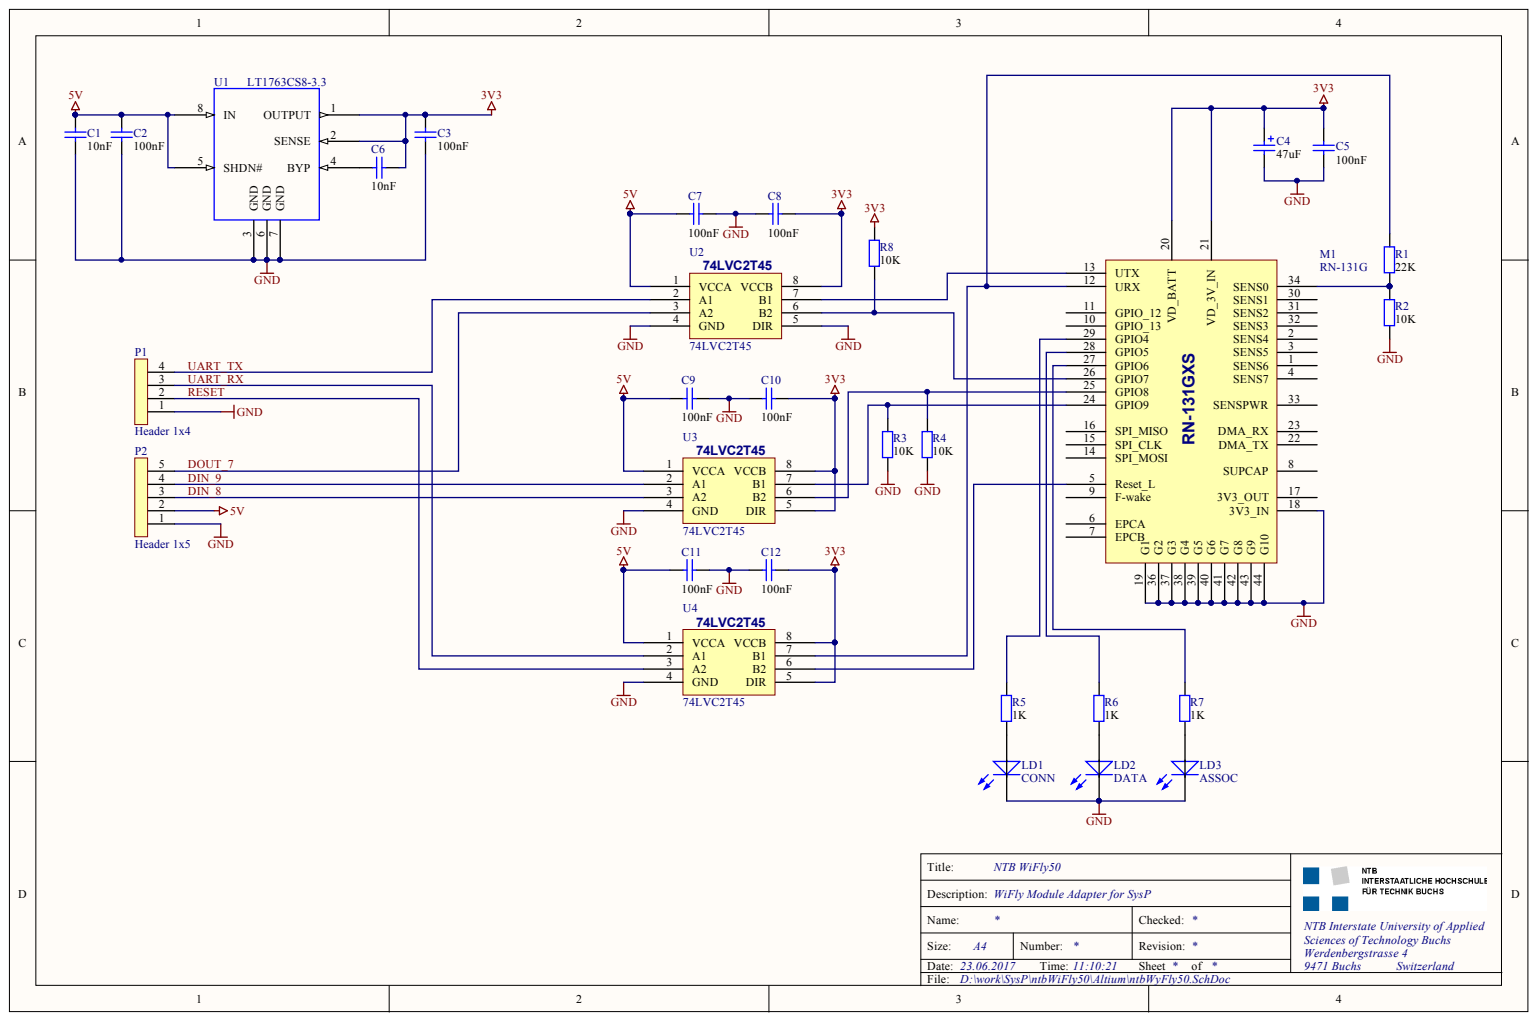
[picture p314: page 1]

1 1 | GPIO _ 1 2 GPIO _ 1 3 GPIO 4 GPIO 5

G U ART _ T X | 4 | | 1 0

1234 | U ART _RX 5 V

2 7
2 6 | GPIO 7 GPIO 8 GPIO 9 SPI_MISO SPI_CL K SPI_MOSI Reset _ L F-wak e
2 5
2 4

RESE T

1 0 n F G N D 1 0 n F 3 7 4 LVC 2 T 4 5

DIN _ 8 | 3 | 5 B2 6 B1 7 | G N D | 9

Name: * | Checked : *

Size: A 4 | N umber: * | Rev i s i o n : *

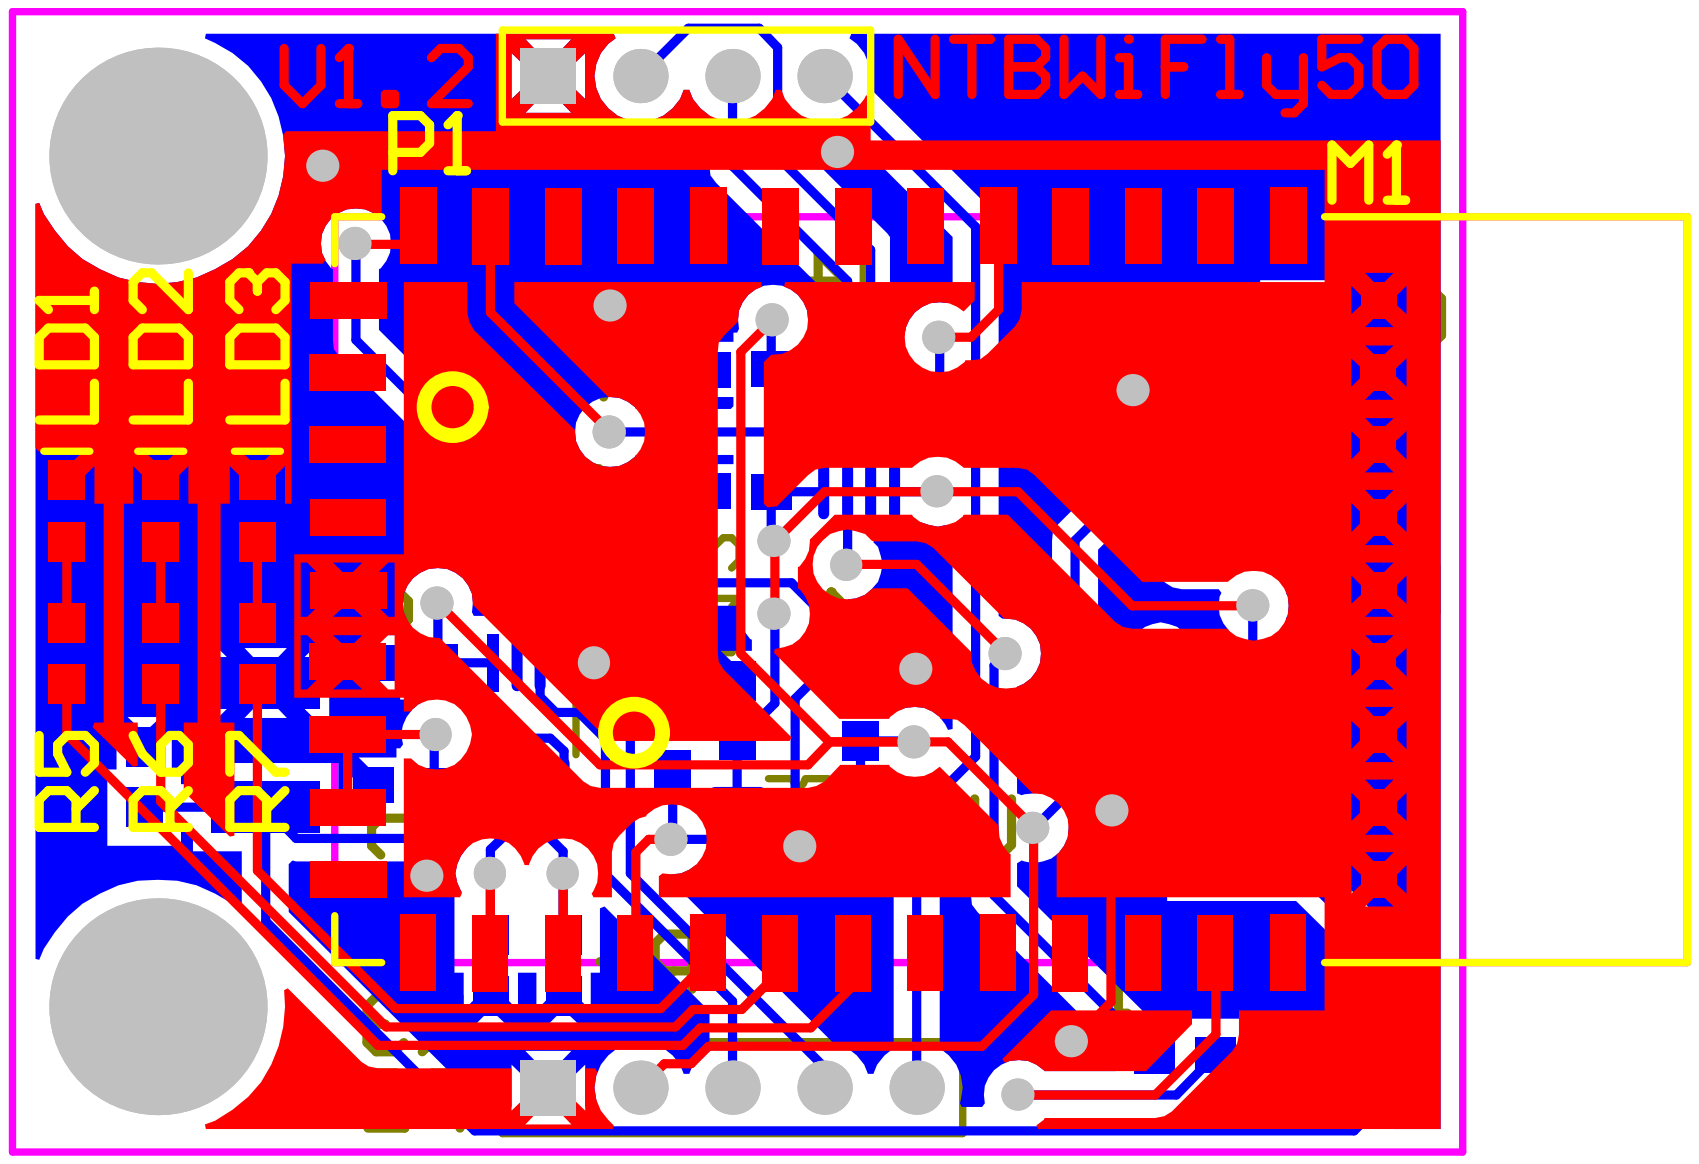
[picture p315: page 2]
