Unaqwyn/SysP18_1cv/01_Organisation/02_Meilensteine/m4/SySP18-Team10-Anhang/Abgabe Mechanik/CAD abgaben/Arm-Platte unten 10_60_0.pdf

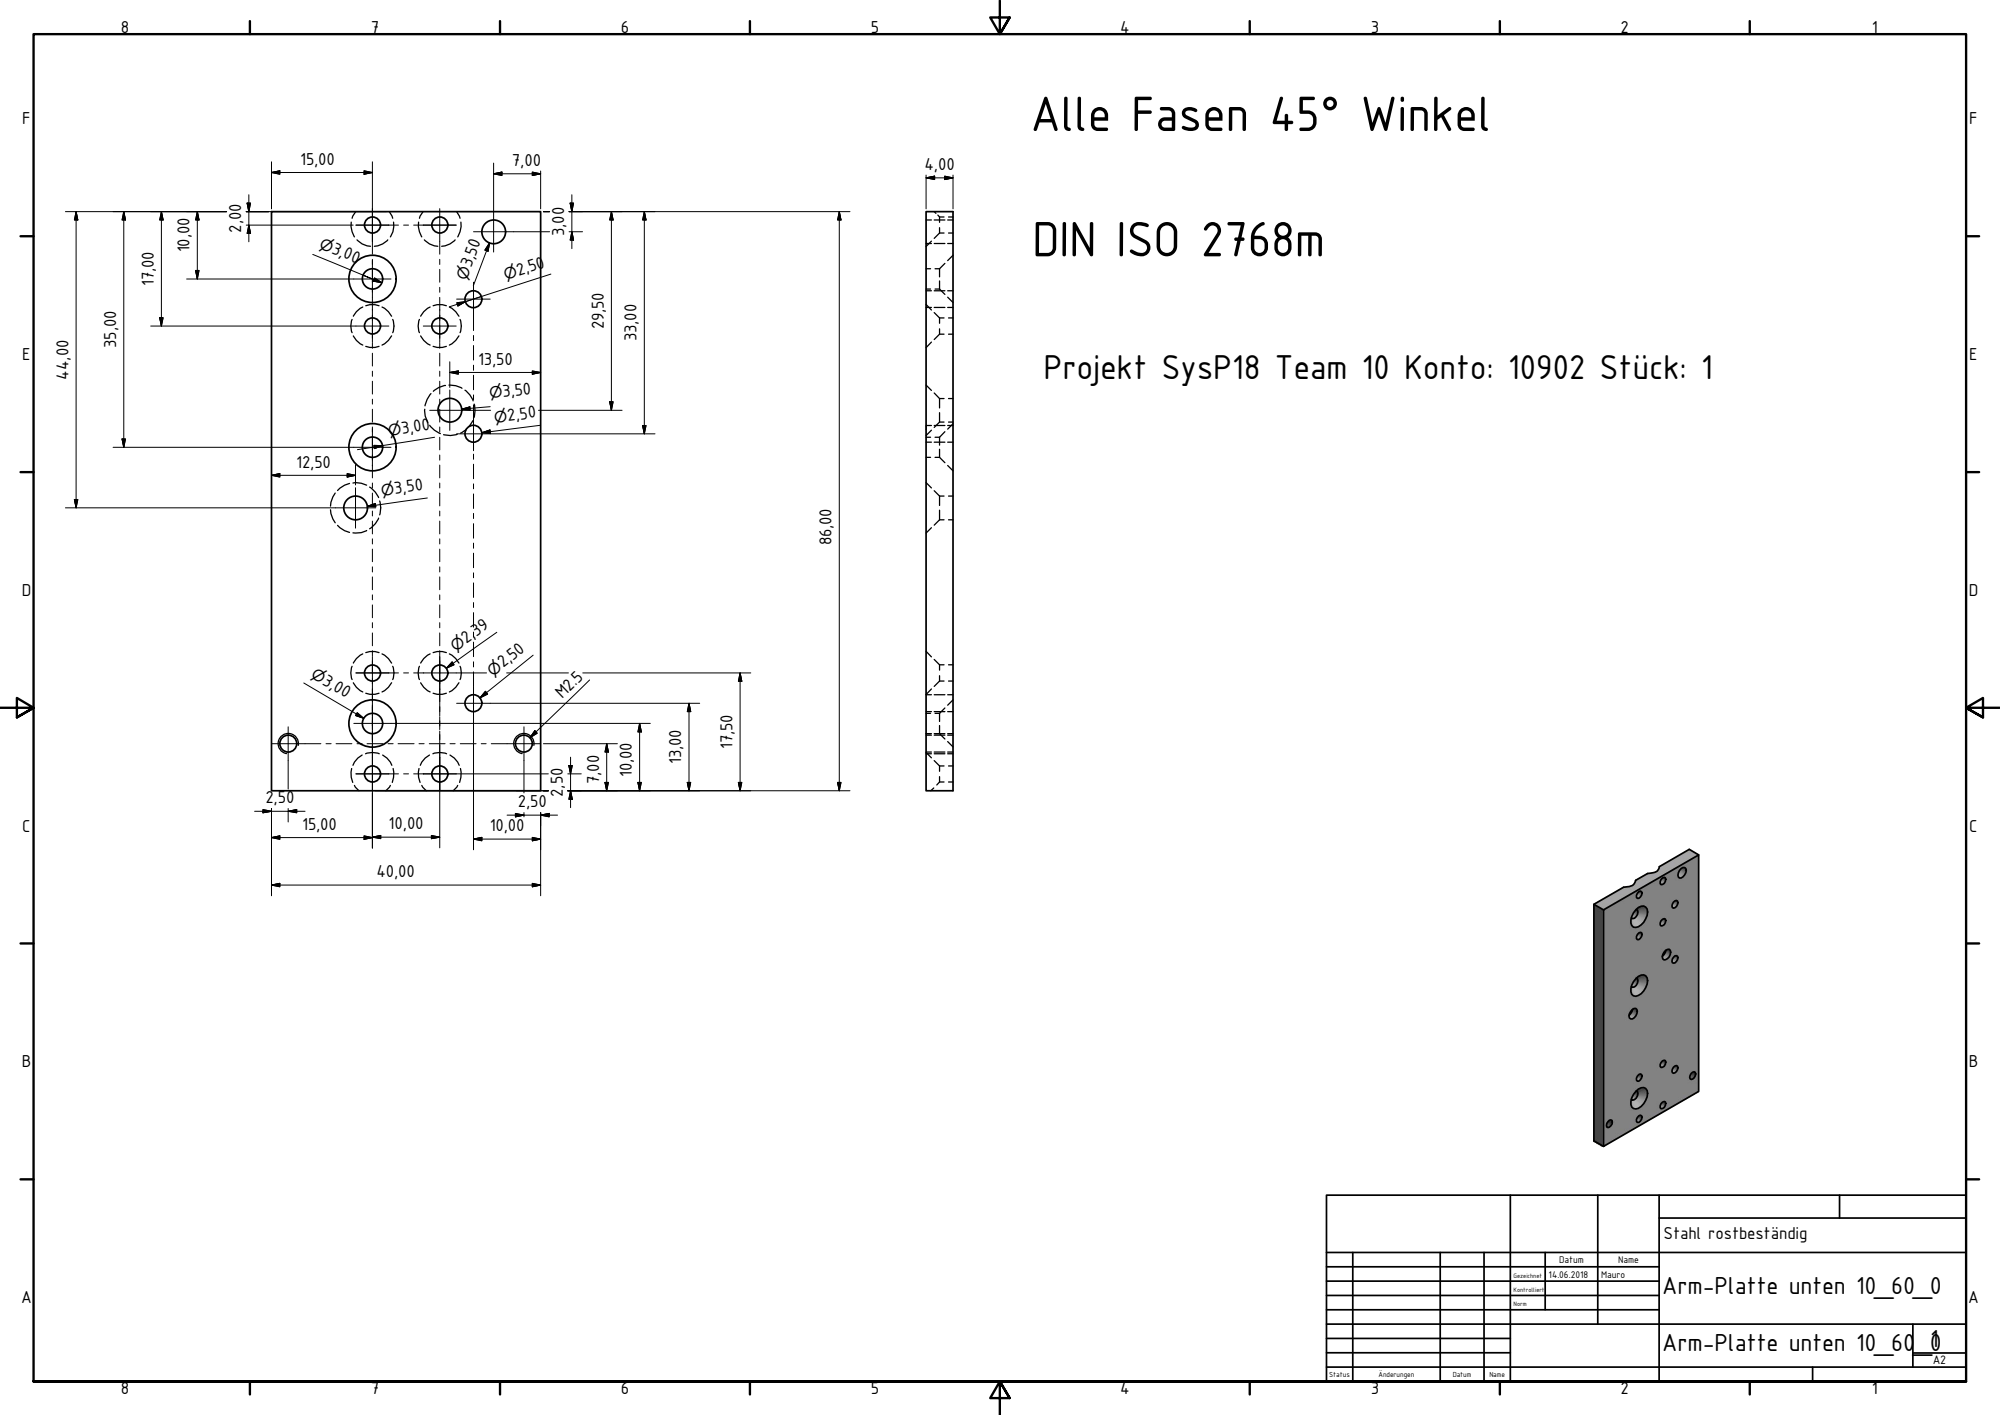
[picture p317: page 1]
DIN ISO 2768m

Alle Fasen 45n Winkel

Projekt SysP18 Team 10 Konto: 10902 St¯ck: 1

Stahl rostbestndig

Datum | Name | Arm-Platte unten 10_60_0

Gezeichnet | 14.06.2018 | Mauro

Kontrolliert

Norm

Arm-Platte unten 10_60_0
