Unaqwyn/SysP18_1cv/01_Organisation/02_Meilensteine/m4/SySP18-Team10-Anhang/Abgabe Mechanik/CAD abgaben/Halterung grosser Motor 10_57_0.pdf

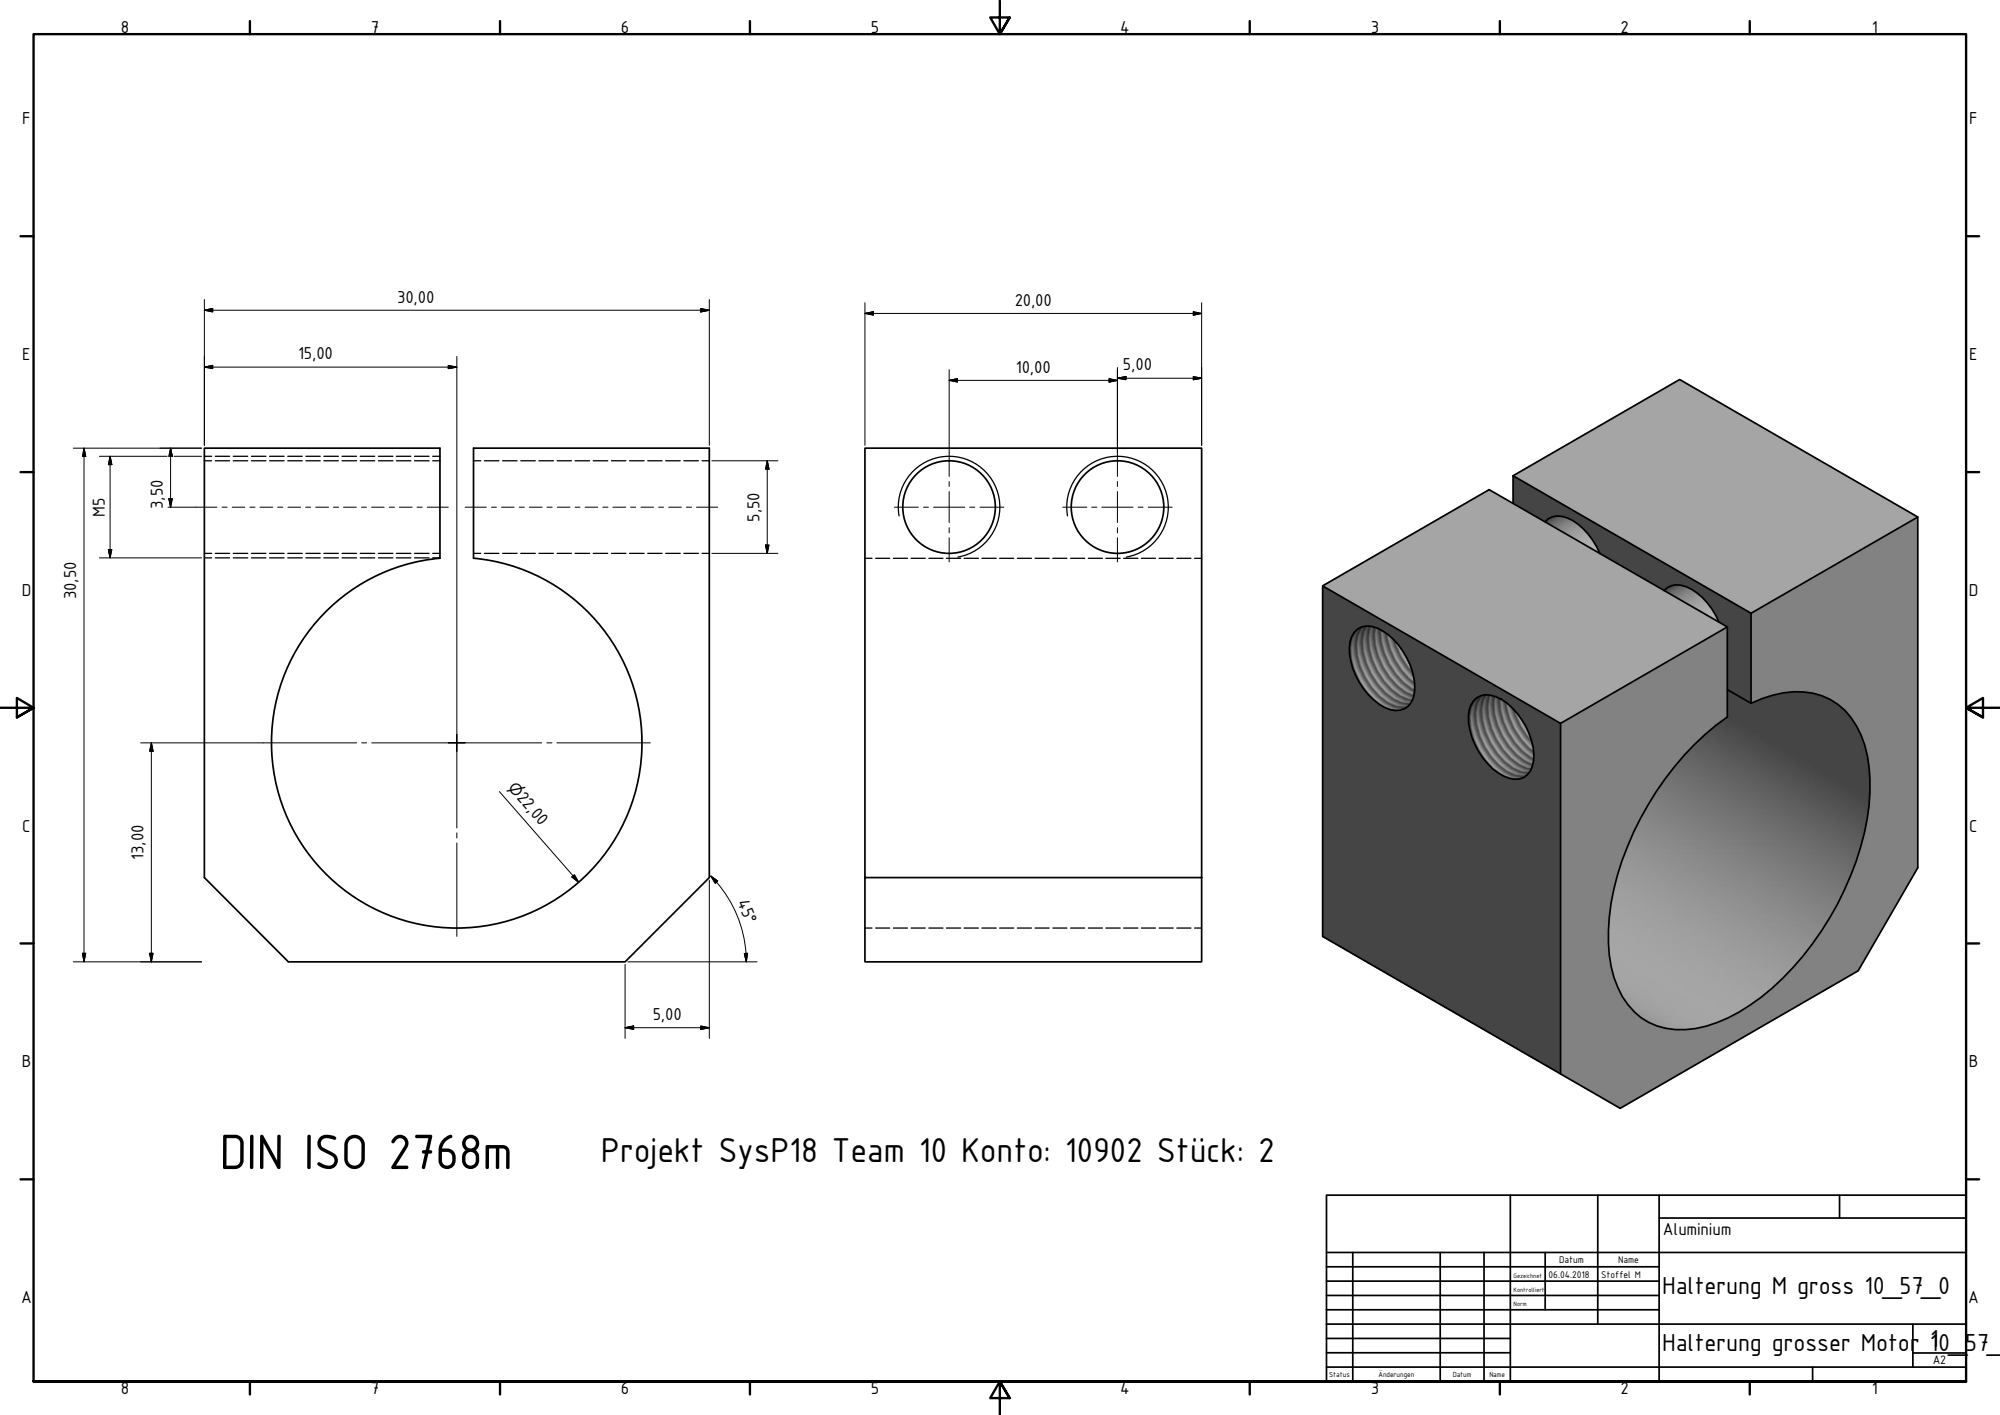
[picture p318: page 1]
DIN ISO 2768m

Projekt SysP18 Team 10 Konto: 10902 St¯ck: 2

Datum | Name | Halterung M gross 10_57_0

Gezeichnet | 06.04.2018 | Stoffel M

Kontrolliert

Norm

Halterung grosser Motor 10_57_0
