Unaqwyn/SysP18_1cv/01_Organisation/02_Meilensteine/m4/SySP18-Team10-Anhang/Abgabe Mechanik/CAD abgaben/Halterung kleiner Motor 10_58_0.pdf

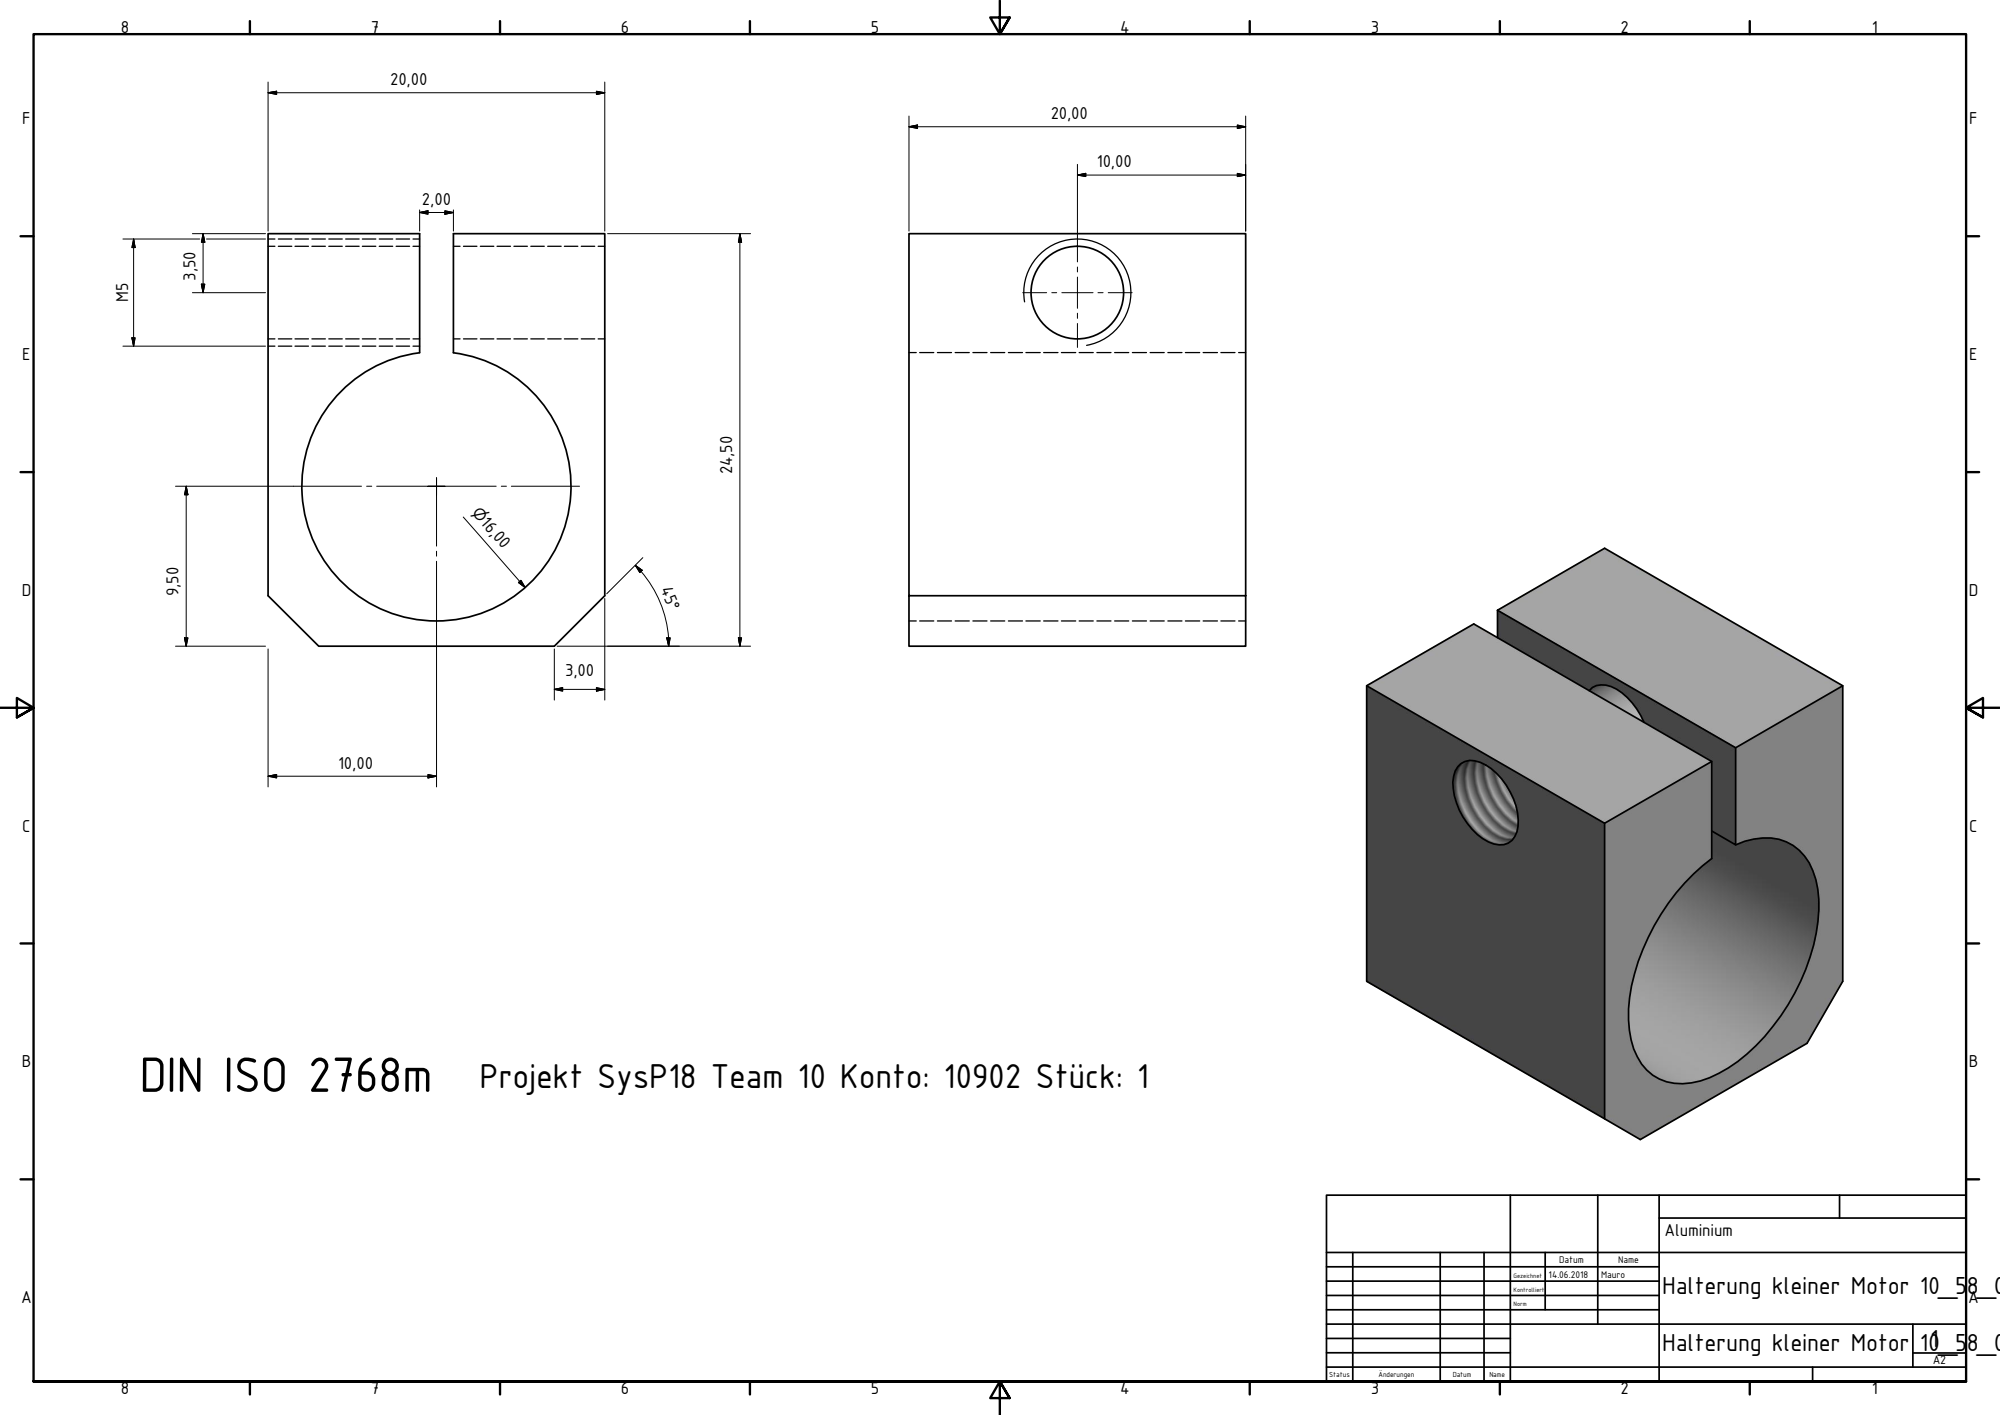
[picture p319: page 1]
Halterung kleiner Motor

DIN ISO 2768m Projekt SysP18 Team 10 Konto: 10902 St¯ck: 1

Datum | Name

Gezeichnet | 14.06.2018 | Mauro

Halterung kleiner Motor 10_58_0

Kontrolliert

Norm
