Unaqwyn/SysP18_1cv/03_Elektronik/veralteteDateien/PCB_SysP17_Official_170617_1141/PIC.pdf

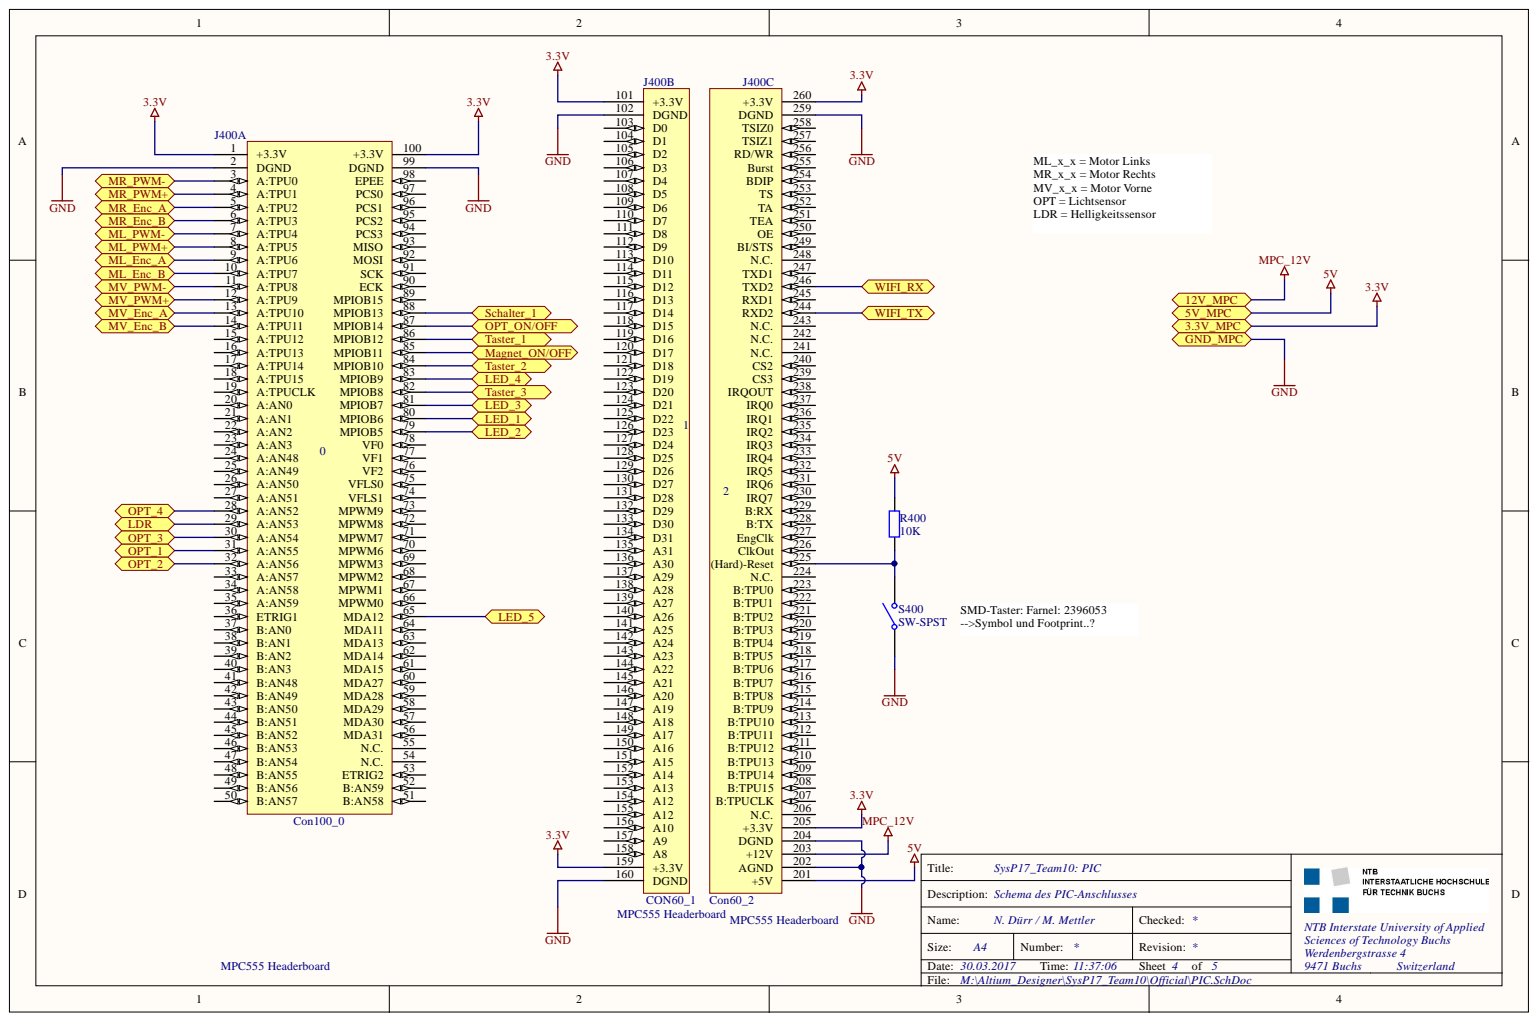
[picture p320: page 1]

Name: N. D ü r r / M. Met t ler | Checked : *

Size: A 4 | N umber: * | Rev i s i o n : *
