Unaqwyn/SysP18_1cv/03_Elektronik/veralteteDateien/PCB_SysP17_Official_170617_1141/SysP17_Team10.pdf

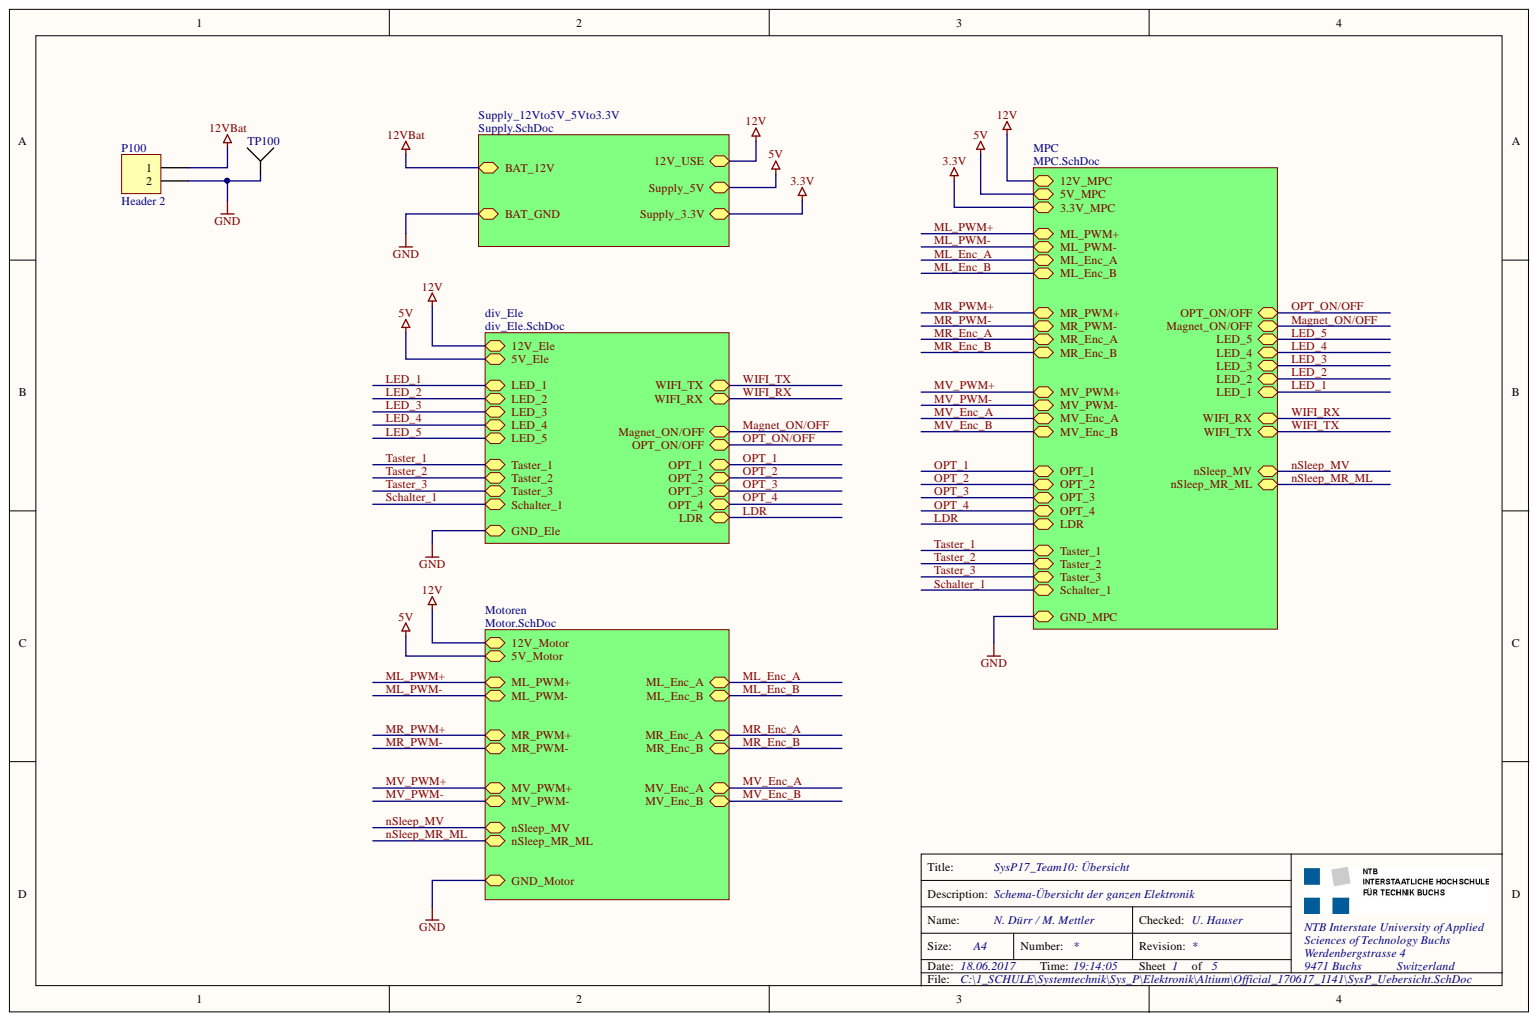
[picture p321: page 1]

Name: N. D ü r r / M. Met t ler | Checked : U. Ha u ser

Size: A 4 | N umber: * | Rev i s i o n : *

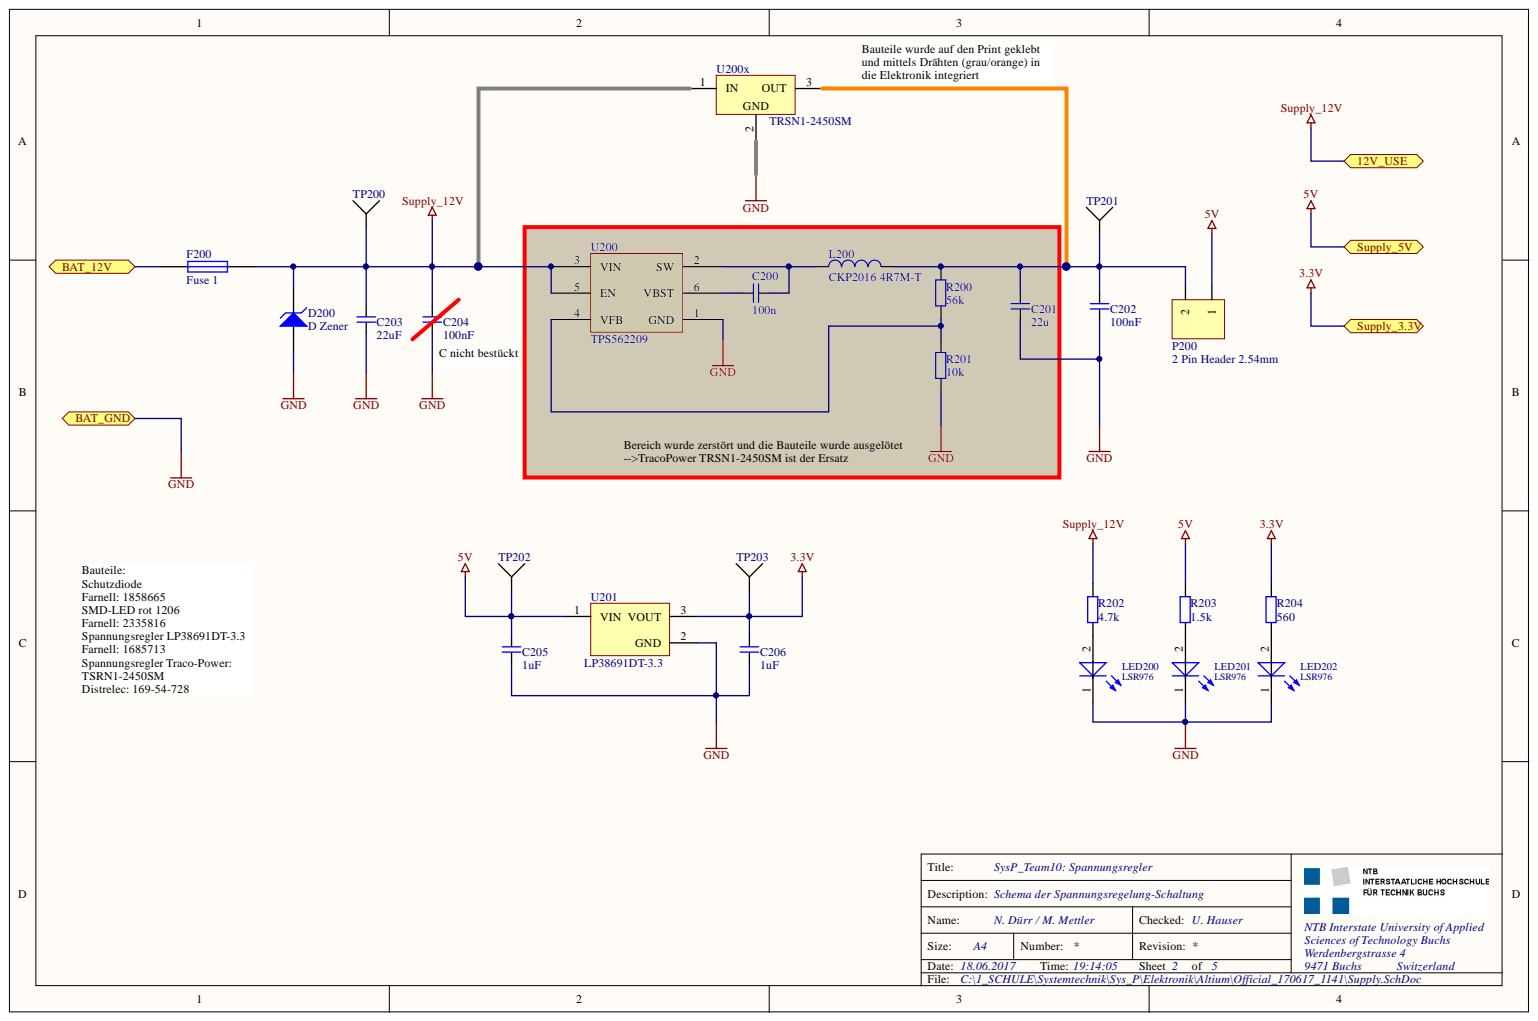
[picture p322: page 2]

Bauteile wurde auf den Print geklebt
und mittels Drähten (grau/orange) in
die Elektronik integriert

Bereich wurde zerstört und die Bauteile wurde ausgelötet
-->TracoPower TRSN1-2450SM ist der Ersatz

Schema der Spannungsregelung-Schaltung

Name: N. Dürr / M. Mettler | Checked: U. Hauser

NTB Interstate University of Applied
Sciences of Technology Buchs
Werdenbergstrasse 4

Size: A4 | Number: * | Revision: *

C:\1_SCHULE\Systemtechnik\Sys_P\Elektronik\Altium\Official_170617_1141\Supply.SchDoc
File:

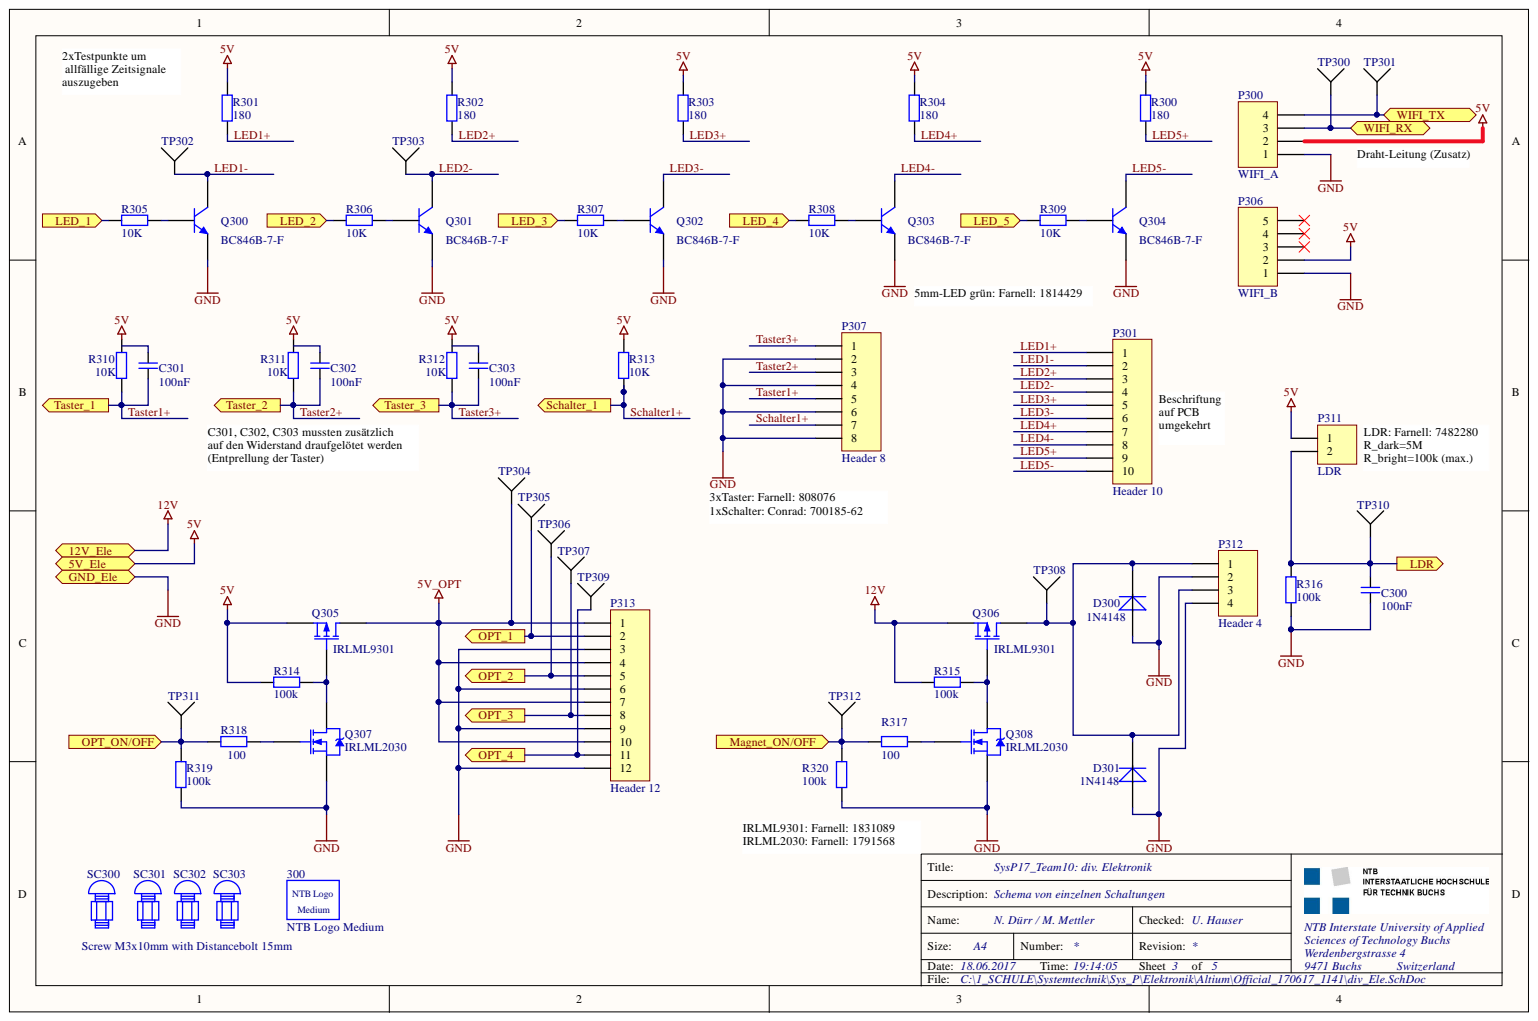
[picture p323: page 3]

Taster2+

Taster1+

C301, C302, C303 mussten zusätzlich
auf den Widerstand draufgelötet werden
(Entprellung der Taster)

Schema von einzelnen Schaltungen

Name: N. Dürr / M. Mettler | Checked: U. Hauser

NTB Interstate University of Applied
Sciences of Technology Buchs
Werdenbergstrasse 4

Size: A4 | Number: * | Revision: *

C:\1_SCHULE\Systemtechnik\Sys_P\Elektronik\Altium\Official_170617_1141\div_Ele.SchDoc

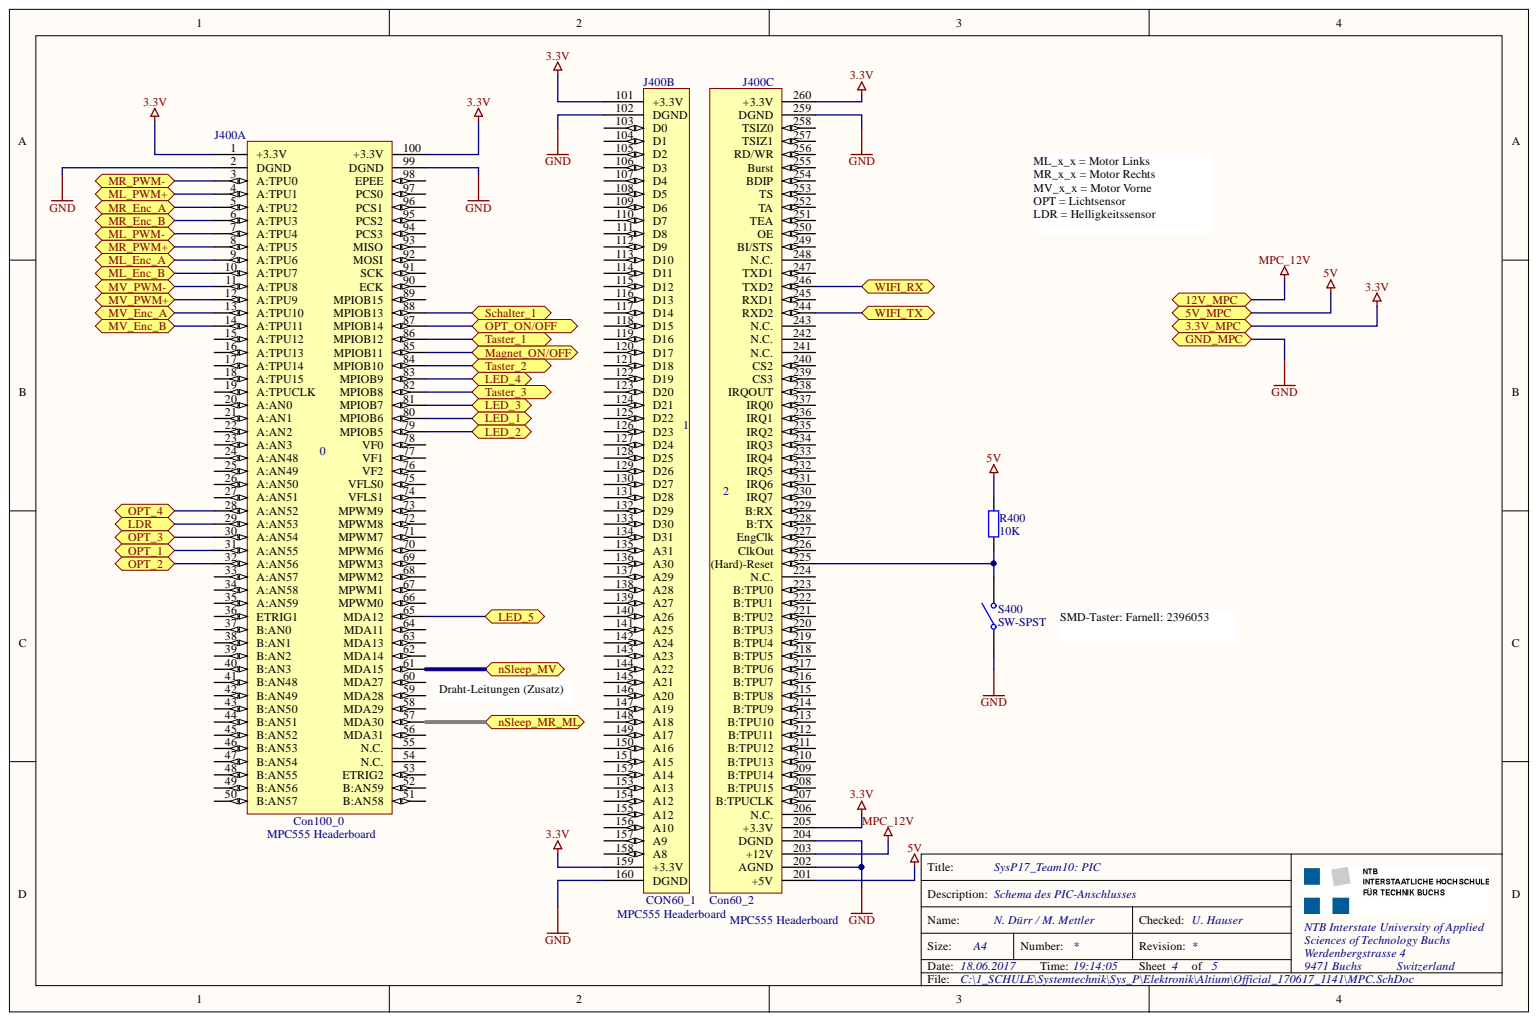
[picture p324: page 4]

Name: N. D ü r r / M. Met t ler | Checked : U. Ha u ser

Size: A 4 | N umber: * | Rev i s i o n : *

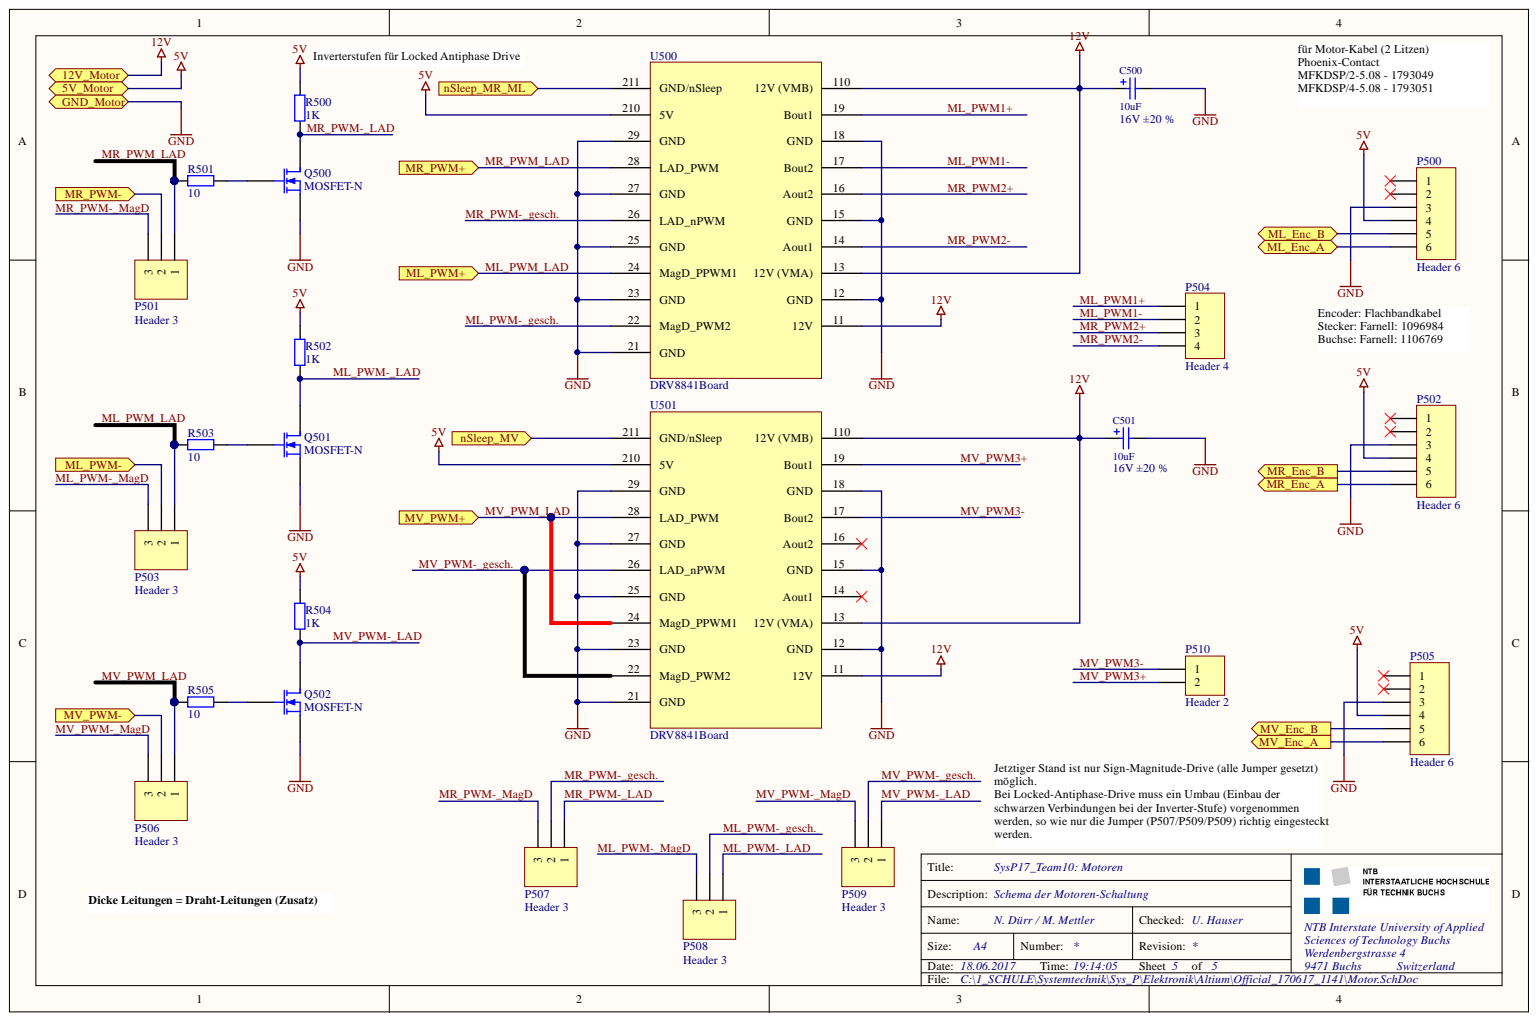
[picture p325: page 5]

Inverterstufen für Locked Antiphase Drive

für Motor-Kabel (2 Litzen)
Phoenix-Contact
MFKDSP/2-5.08 - 1793049
MFKDSP/4-5.08 - 1793051

Jetztiger Stand ist nur Sign-Magnitude-Drive (alle Jumper gesetzt)
möglich.
Bei Locked-Antiphase-Drive muss ein Umbau (Einbau der
schwarzen Verbindungen bei der Inverter-Stufe) vorgenommen
werden, so wie nur die Jumper (P507/P509/P509) richtig eingesteckt
werden.

Dicke Leitungen = Draht-Leitungen (Zusatz)

Schema der Motoren-Schaltung

Name: N. Dürr / M. Mettler | Checked: U. Hauser

NTB Interstate University of Applied
Sciences of Technology Buchs
Werdenbergstrasse 4

Size: A4 | Number: * | Revision: *

C:\1_SCHULE\Systemtechnik\Sys_P\Elektronik\Altium\Official_170617_1141\Motor.SchDoc

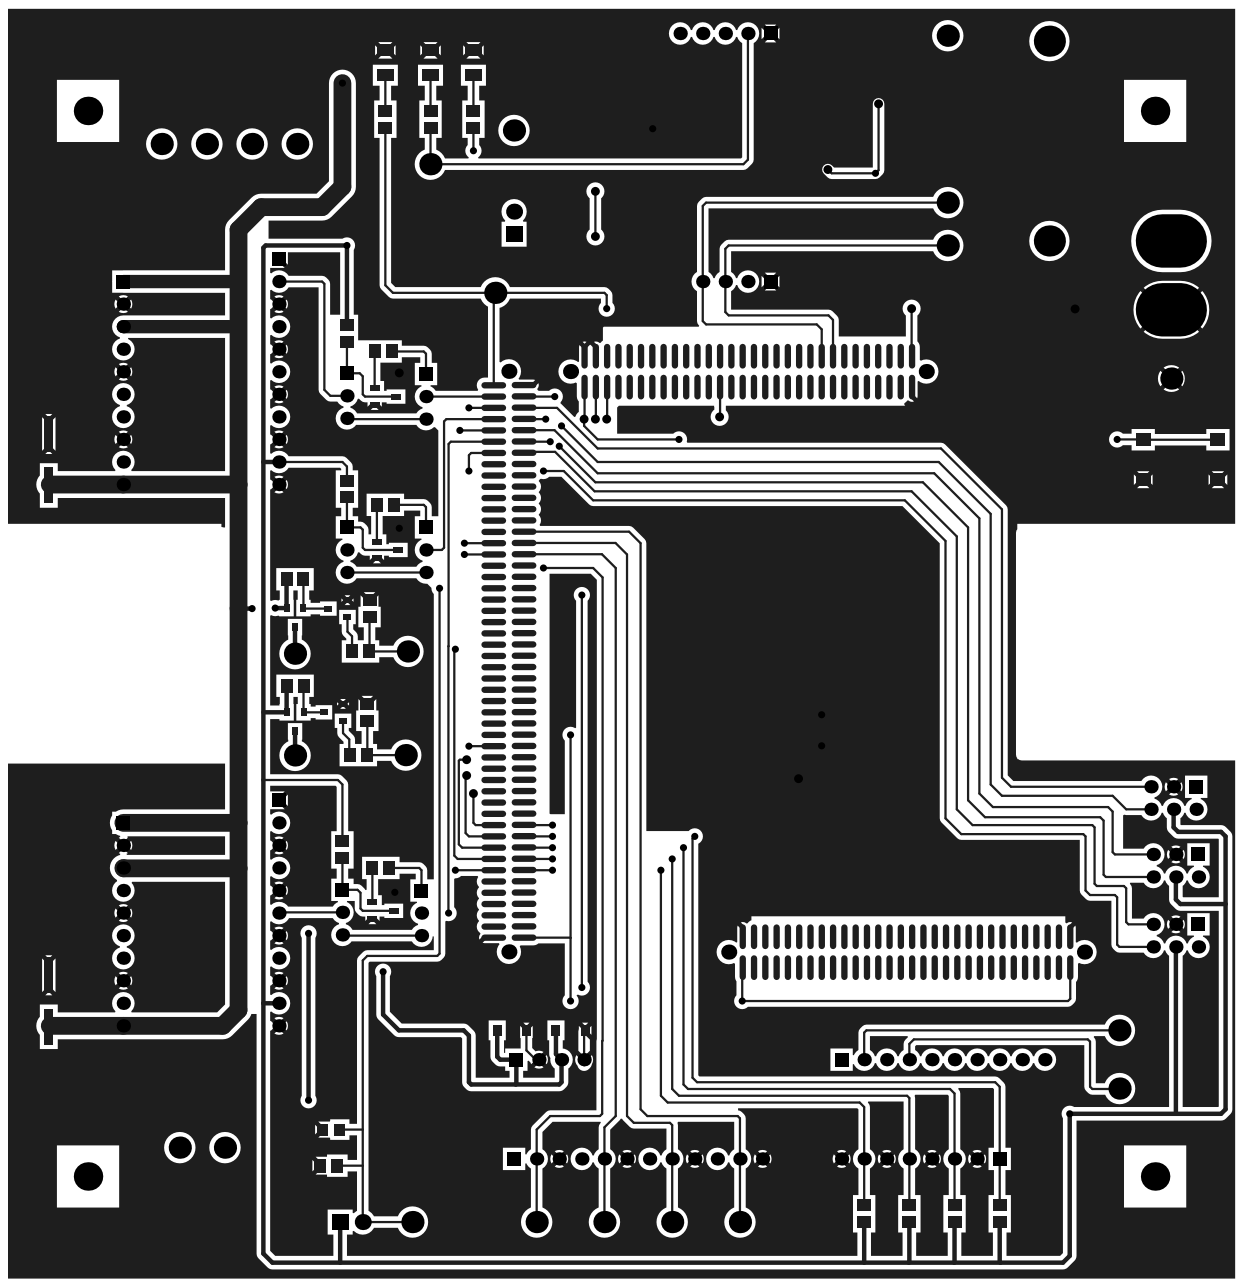
[picture p326: page 6]
