Unaqwyn/SysP18_1cv/01_Organisation/02_Meilensteine/06_Datenblätter/01_Elektronik/Wifivermassung.pdf

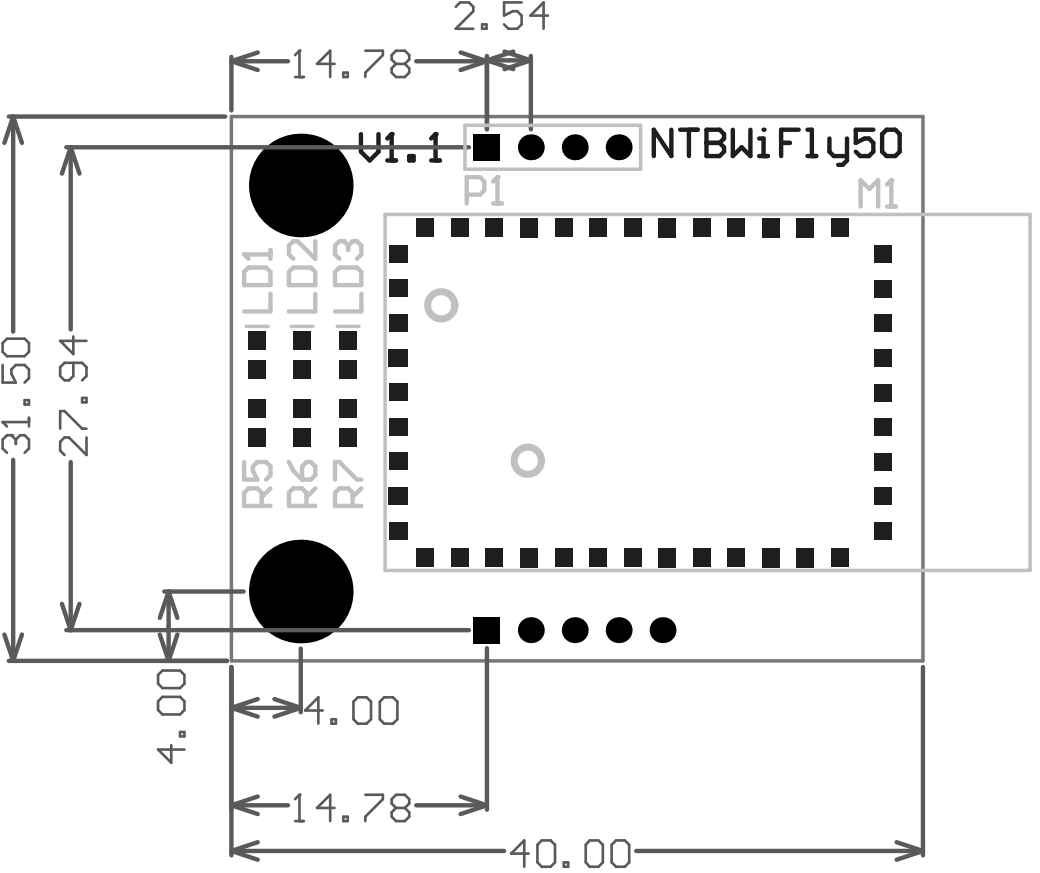
[picture p327: page 1]
