Unaqwyn/SysP18_1cv/01_Organisation/02_Meilensteine/m4/SySP18-Team10-Anhang/Abgabe Mechanik/CAD abgaben/Abstandhalter HU 10_54_0.pdf

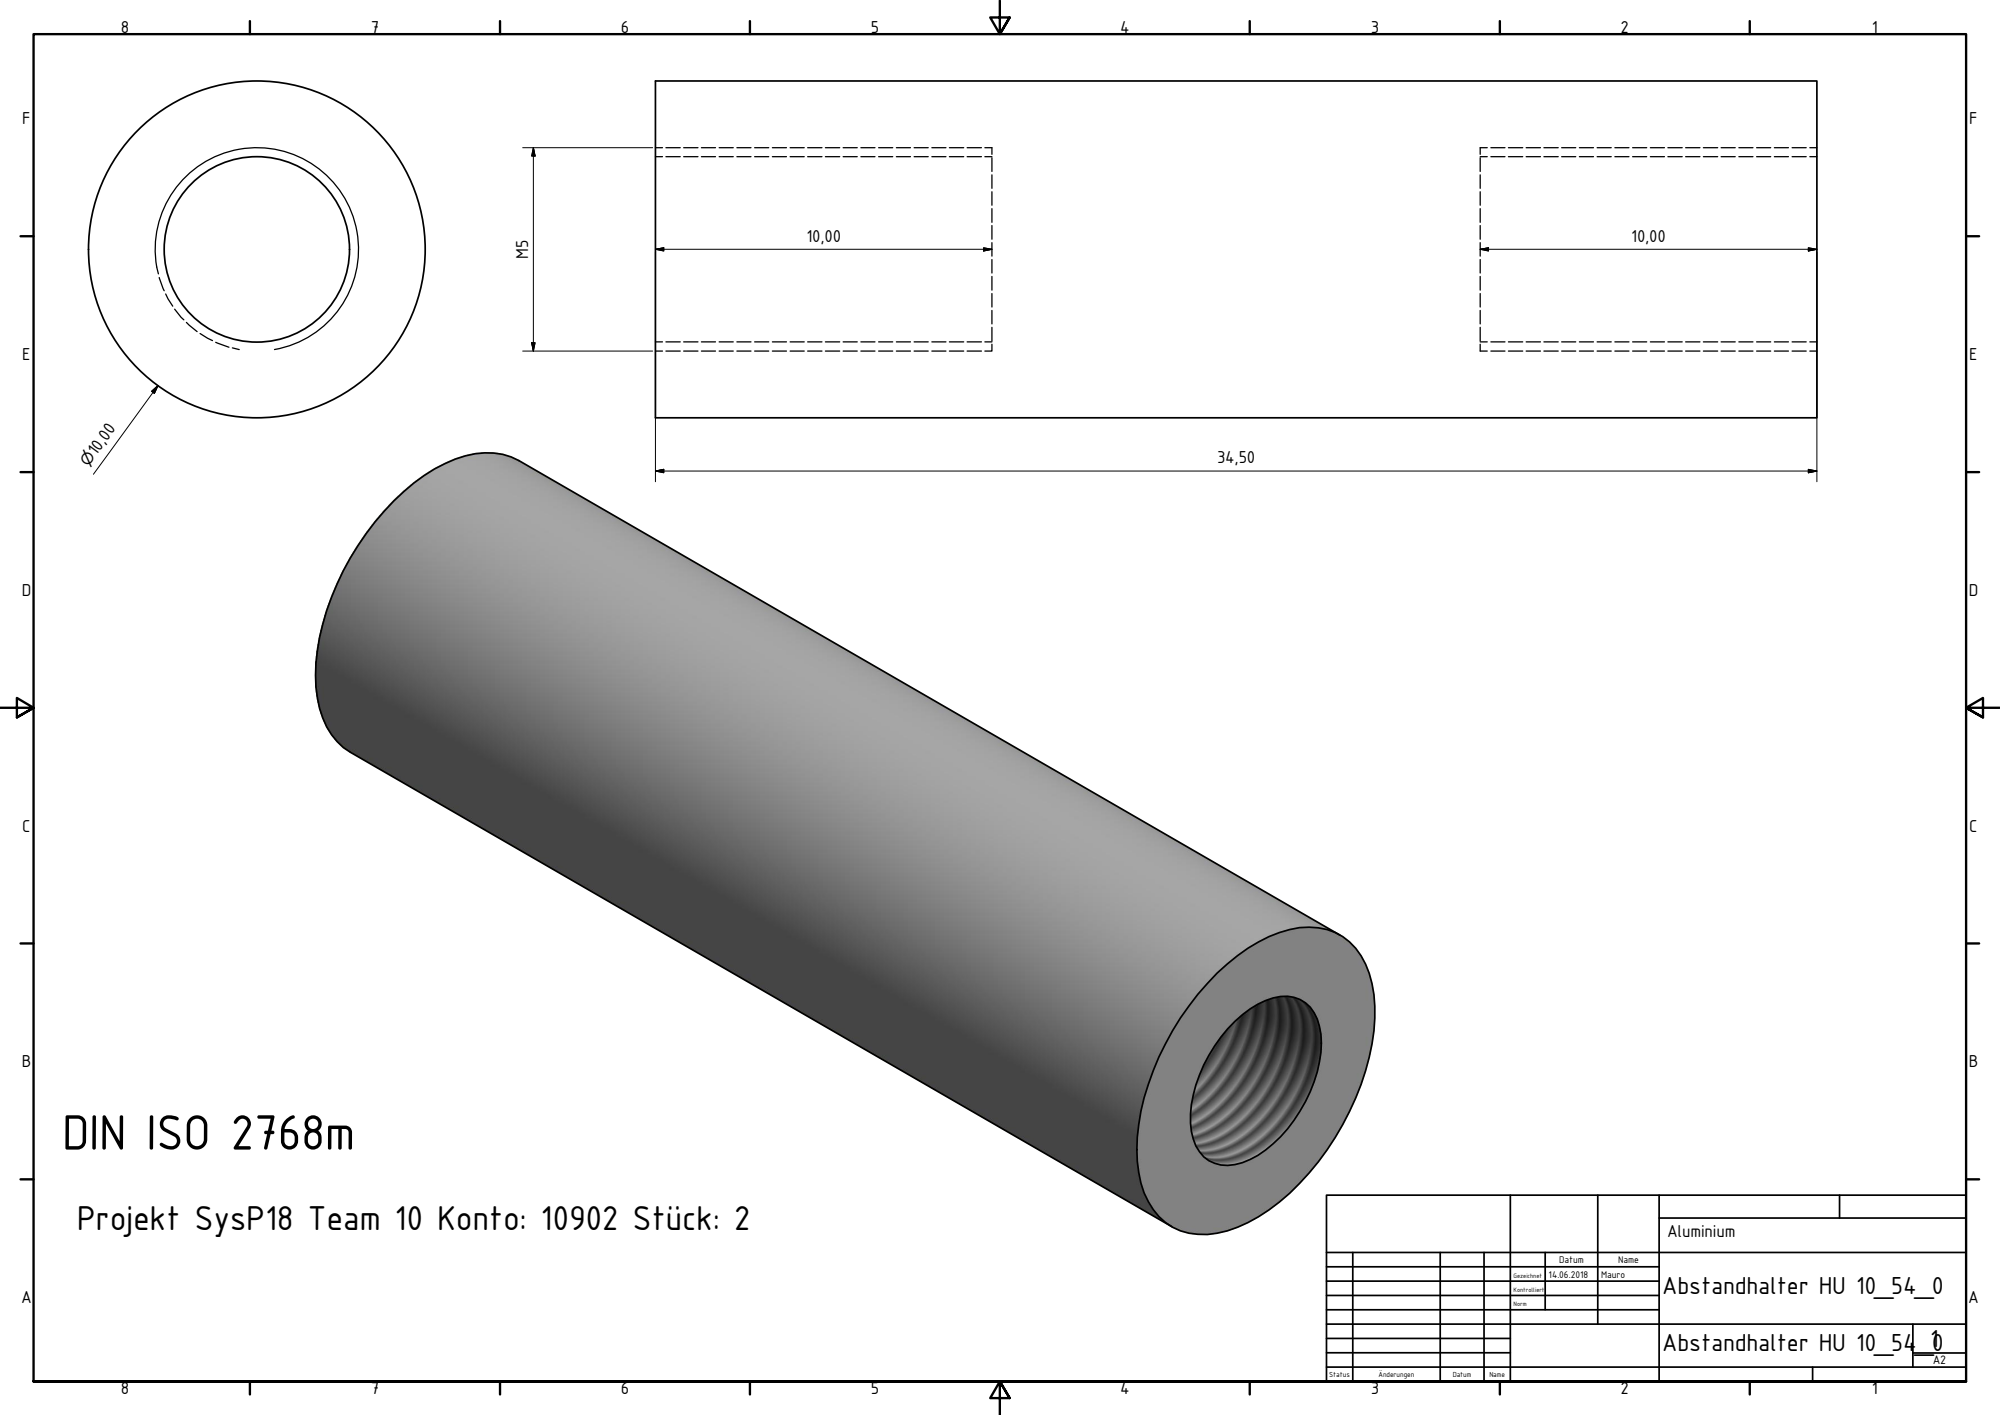
[picture p329: page 1]
Abstandhalter HU 10_54_0; DIN ISO 2768m

jekt SysP18 Team 10 Konto: 10902 St¯ck: 2

Datum | Name | Abstandhalter HU 10_54_0

Gezeichnet | 14.06.2018 | Mauro

Kontrolliert

Norm
