Unaqwyn/SysP18_1cv/01_Organisation/02_Meilensteine/m4/SySP18-Team10-Anhang/Abgabe Mechanik/CAD abgaben/Abstandhalter VU 10_53_0.pdf

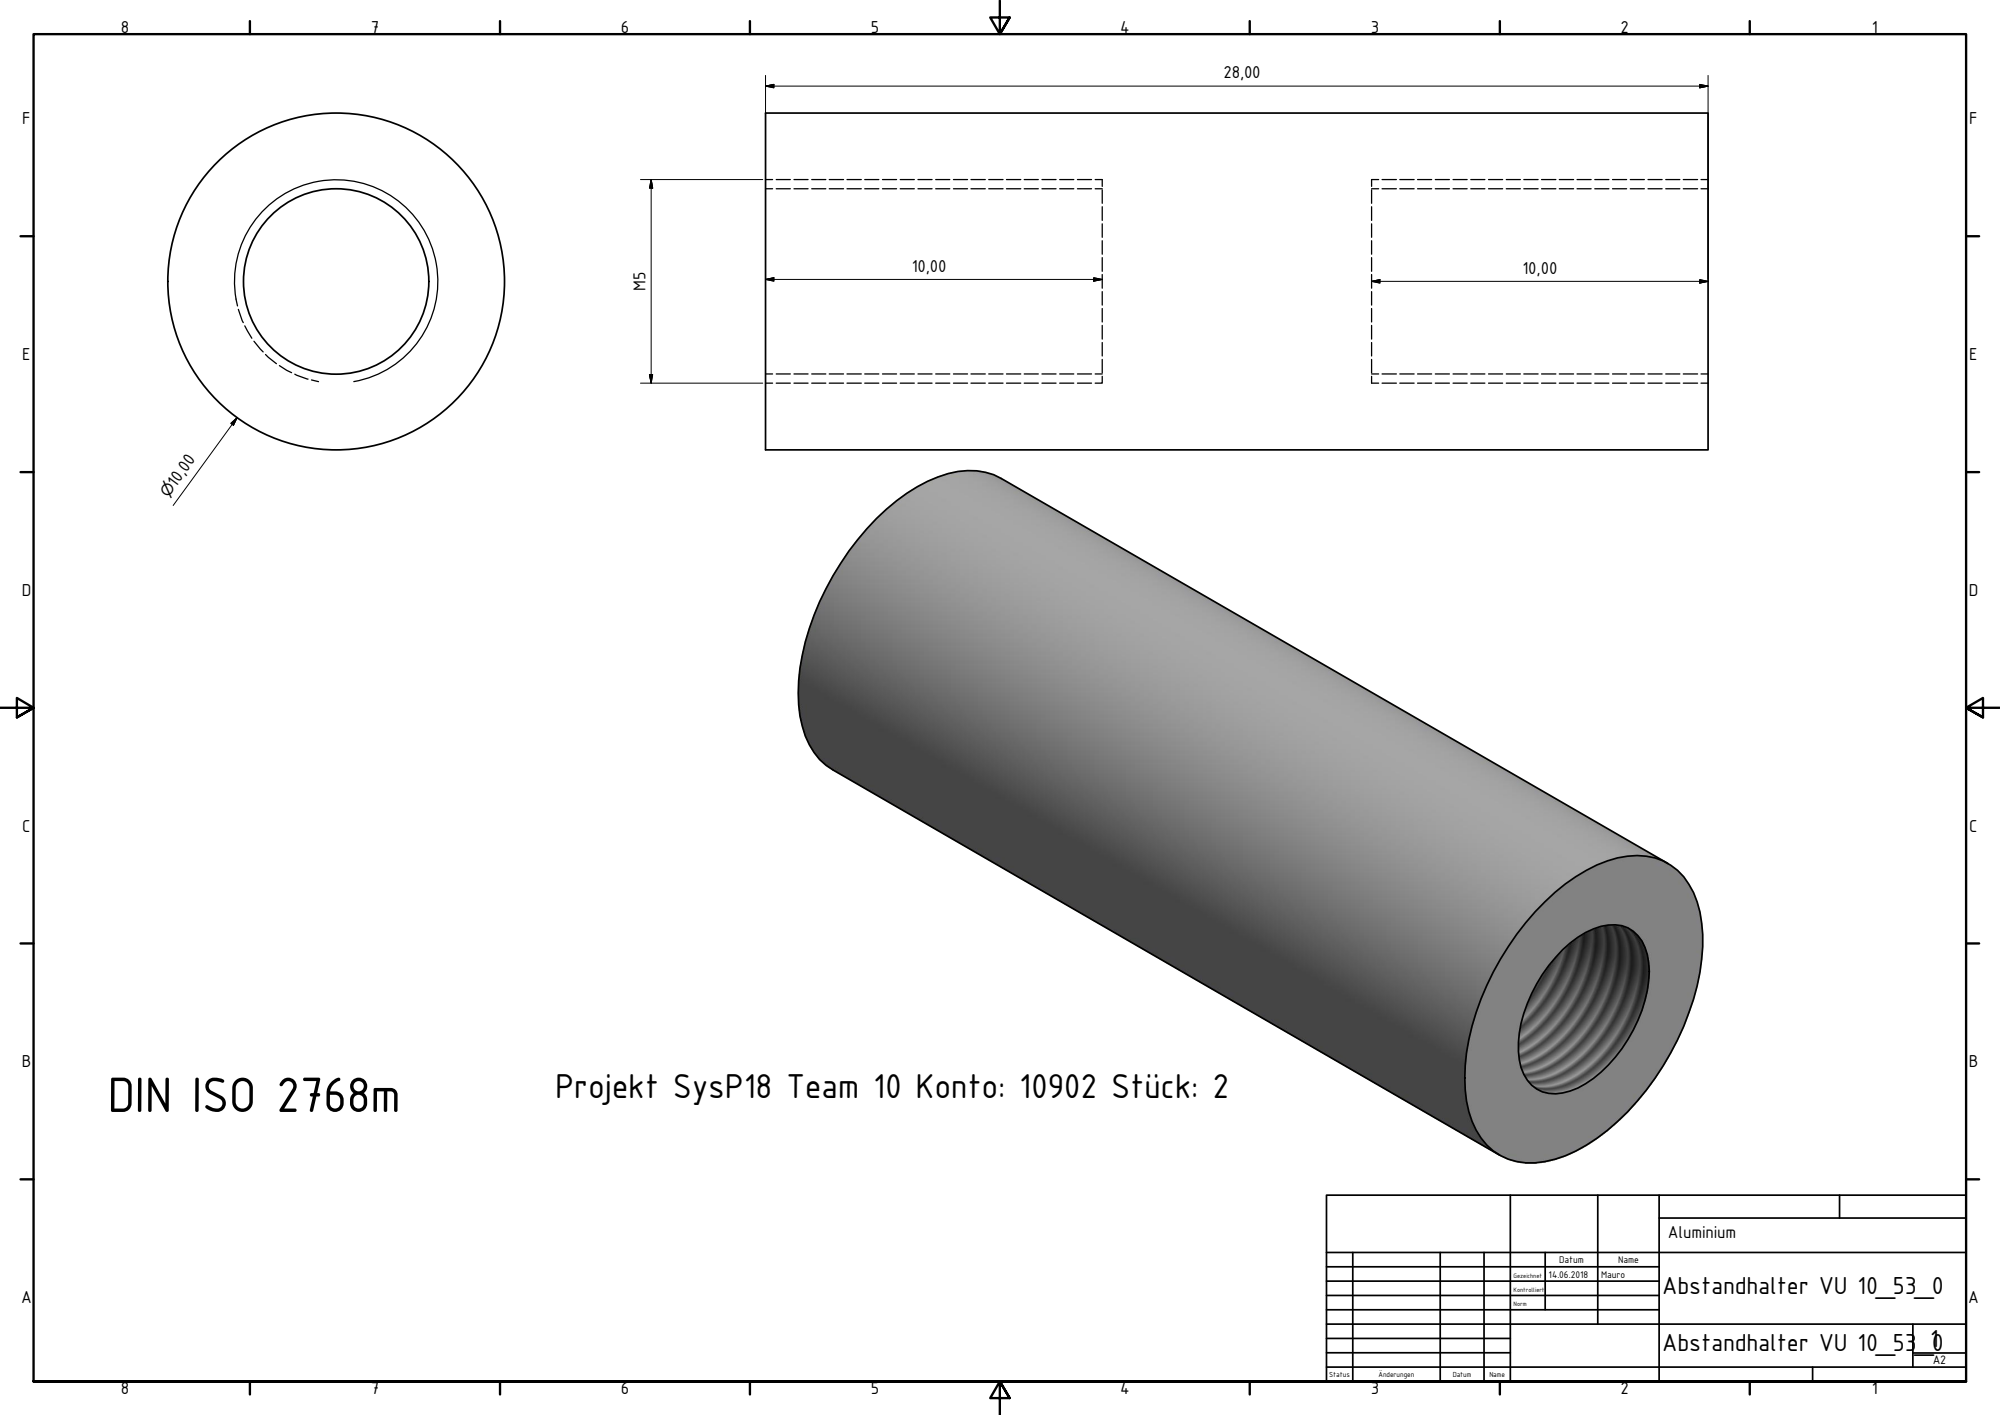
[picture p331: page 1]
Abstandhalter VU 10_53_0; Projekt SysP18 Team 10 Konto: 10902 St¯ck: 2; IN ISO 2768m

Datum | Name | Abstandhalter VU 10_53_0

Gezeichnet | 14.06.2018 | Mauro

Kontrolliert

Norm
