Unaqwyn/SysP18_1cv/01_Organisation/02_Meilensteine/m4/SySP18-Team10-Anhang/Abgabe Mechanik/CAD abgaben/Bodenplatte 10_50_0.pdf

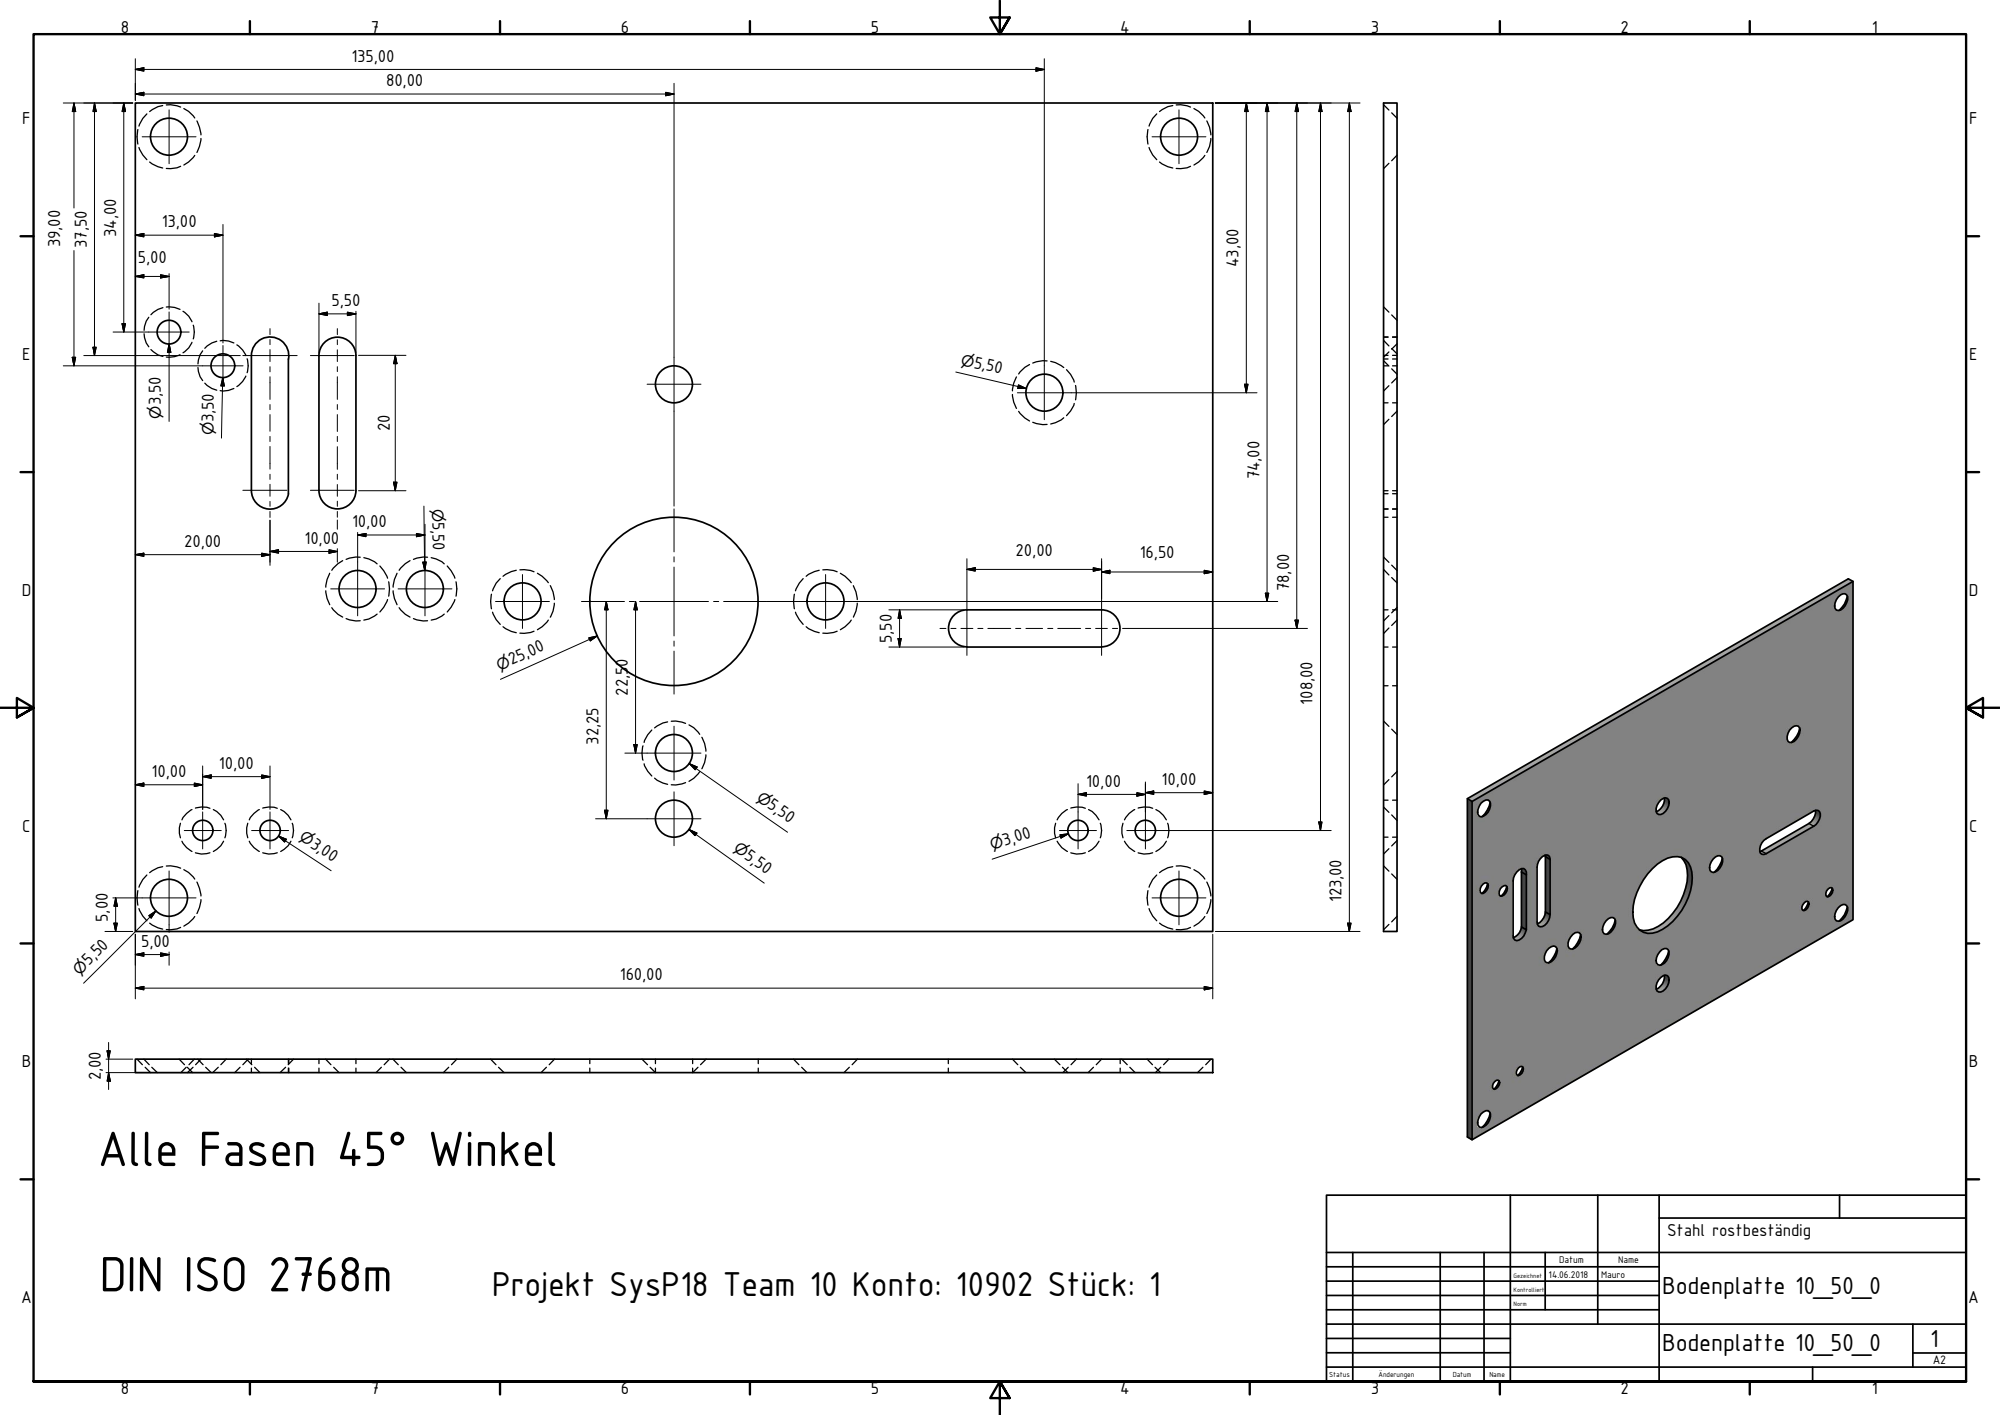
[picture p332: page 1]
Bodenplatte 10_50_0; DIN ISO 2768m

Alle Fasen 45n Winkel

Stahl rostbestndig

Datum | Name | Bodenplatte 10_50_0

Projekt SysP18 Team 10 Konto: 10902 St¯ck: 1

Gezeichnet | 14.06.2018 | Mauro

Kontrolliert

Norm
