Unaqwyn/SysP18_1cv/01_Organisation/02_Meilensteine/m4/SySP18-Team10-Anhang/Abgabe Mechanik/CAD abgaben/Deckplatte 10_52_0.pdf

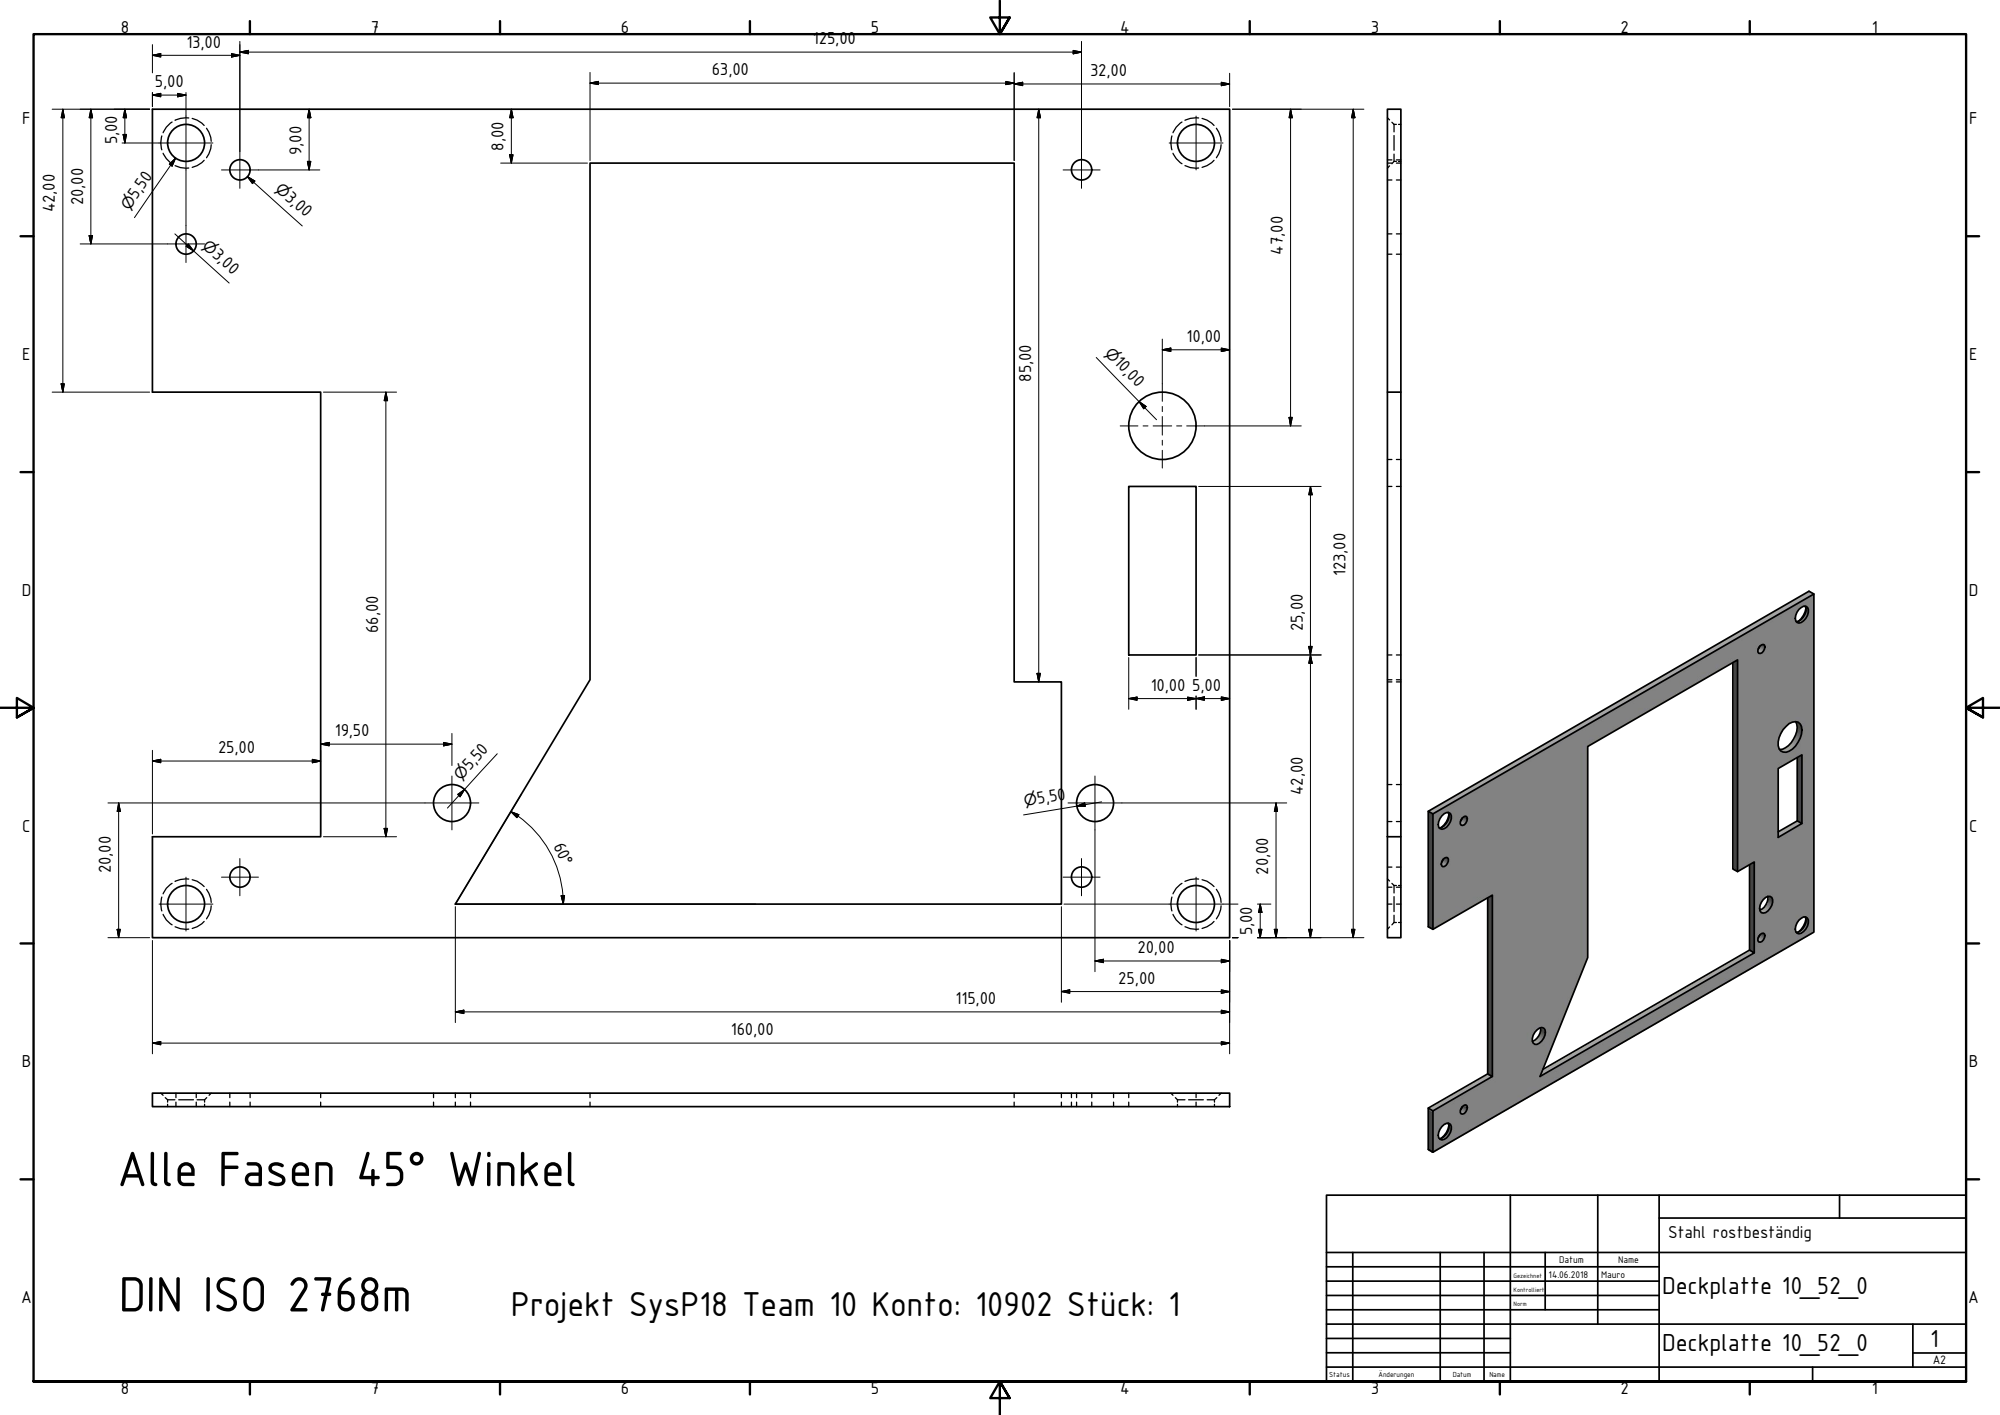
[picture p333: page 1]
Deckplatte 10_52_0; DIN ISO 2768m; Projekt SysP18 Team 10 Konto: 10902 St¯ck: 1

Alle Fasen 45n Winkel

Stahl rostbestndig

Datum | Name | Deckplatte 10_52_0

Gezeichnet | 14.06.2018 | Mauro

Kontrolliert

Norm
