Unaqwyn/SysP18_1cv/01_Organisation/02_Meilensteine/m4/SySP18-Team10-Anhang/Abgabe Mechanik/CAD abgaben/Zwischenplatte 10_51_0.pdf

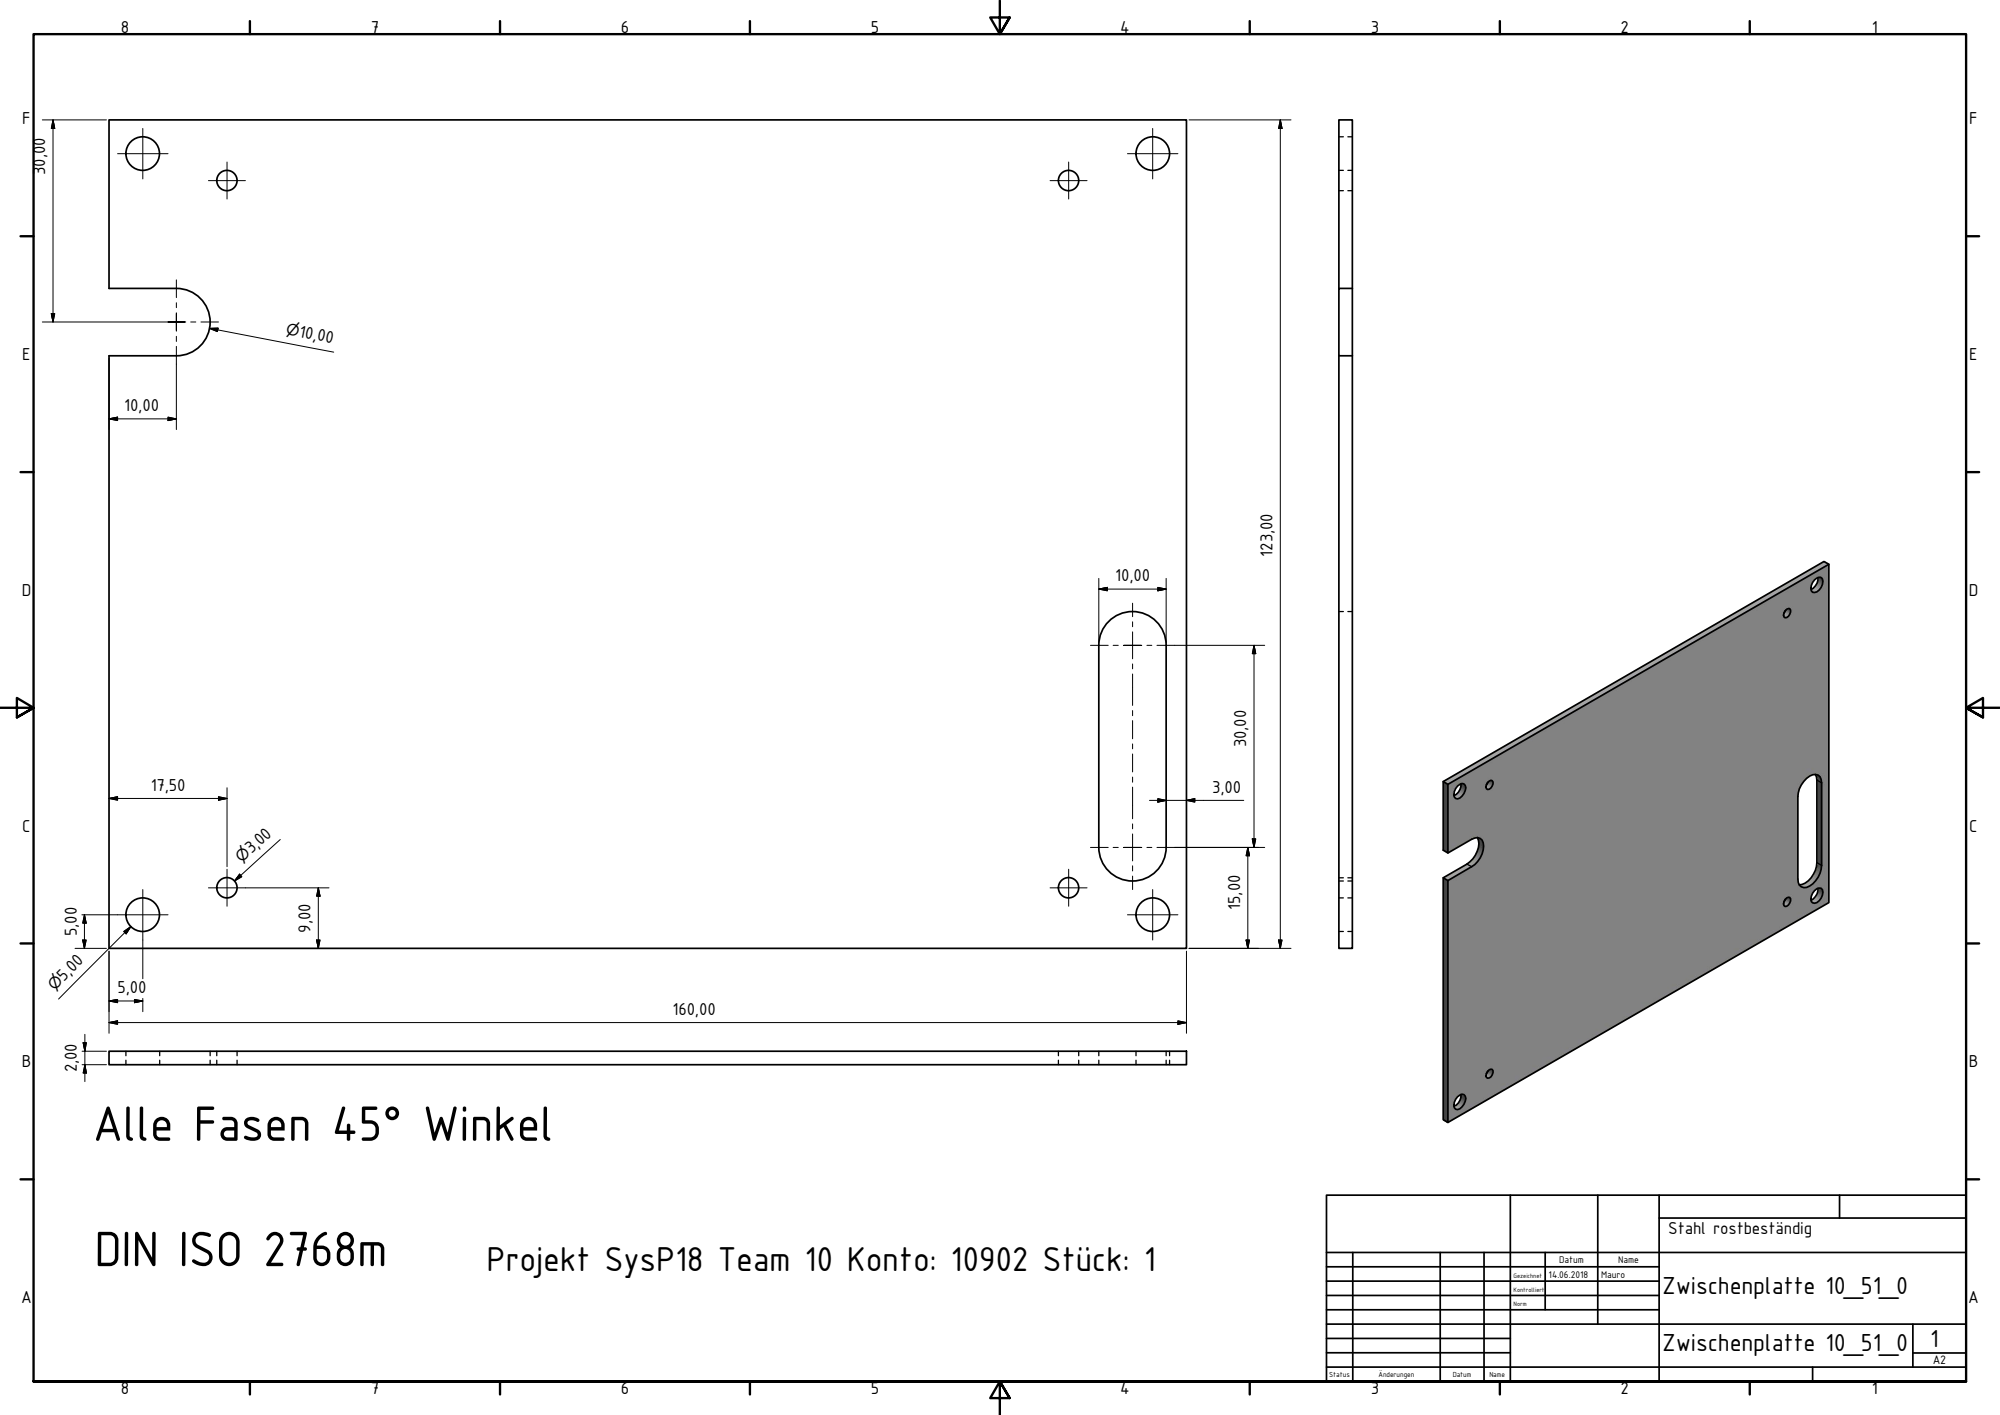
[picture p334: page 1]
Zwischenplatte 10_51_0; DIN ISO 2768m; Projekt SysP18 Team 10 Konto: 10902 St¯ck: 1

Alle Fasen 45n Winkel

Stahl rostbestndig

Datum | Name | Zwischenplatte 10_51_0

Gezeichnet | 14.06.2018 | Mauro

Kontrolliert

Norm
