Unaqwyn/SysP18_1cv/01_Organisation/02_Meilensteine/m4/SySP18-Team10-Anhang/Abgabe Mechanik/CAD abgaben/Motorenhalter d24 10_23_0.pdf

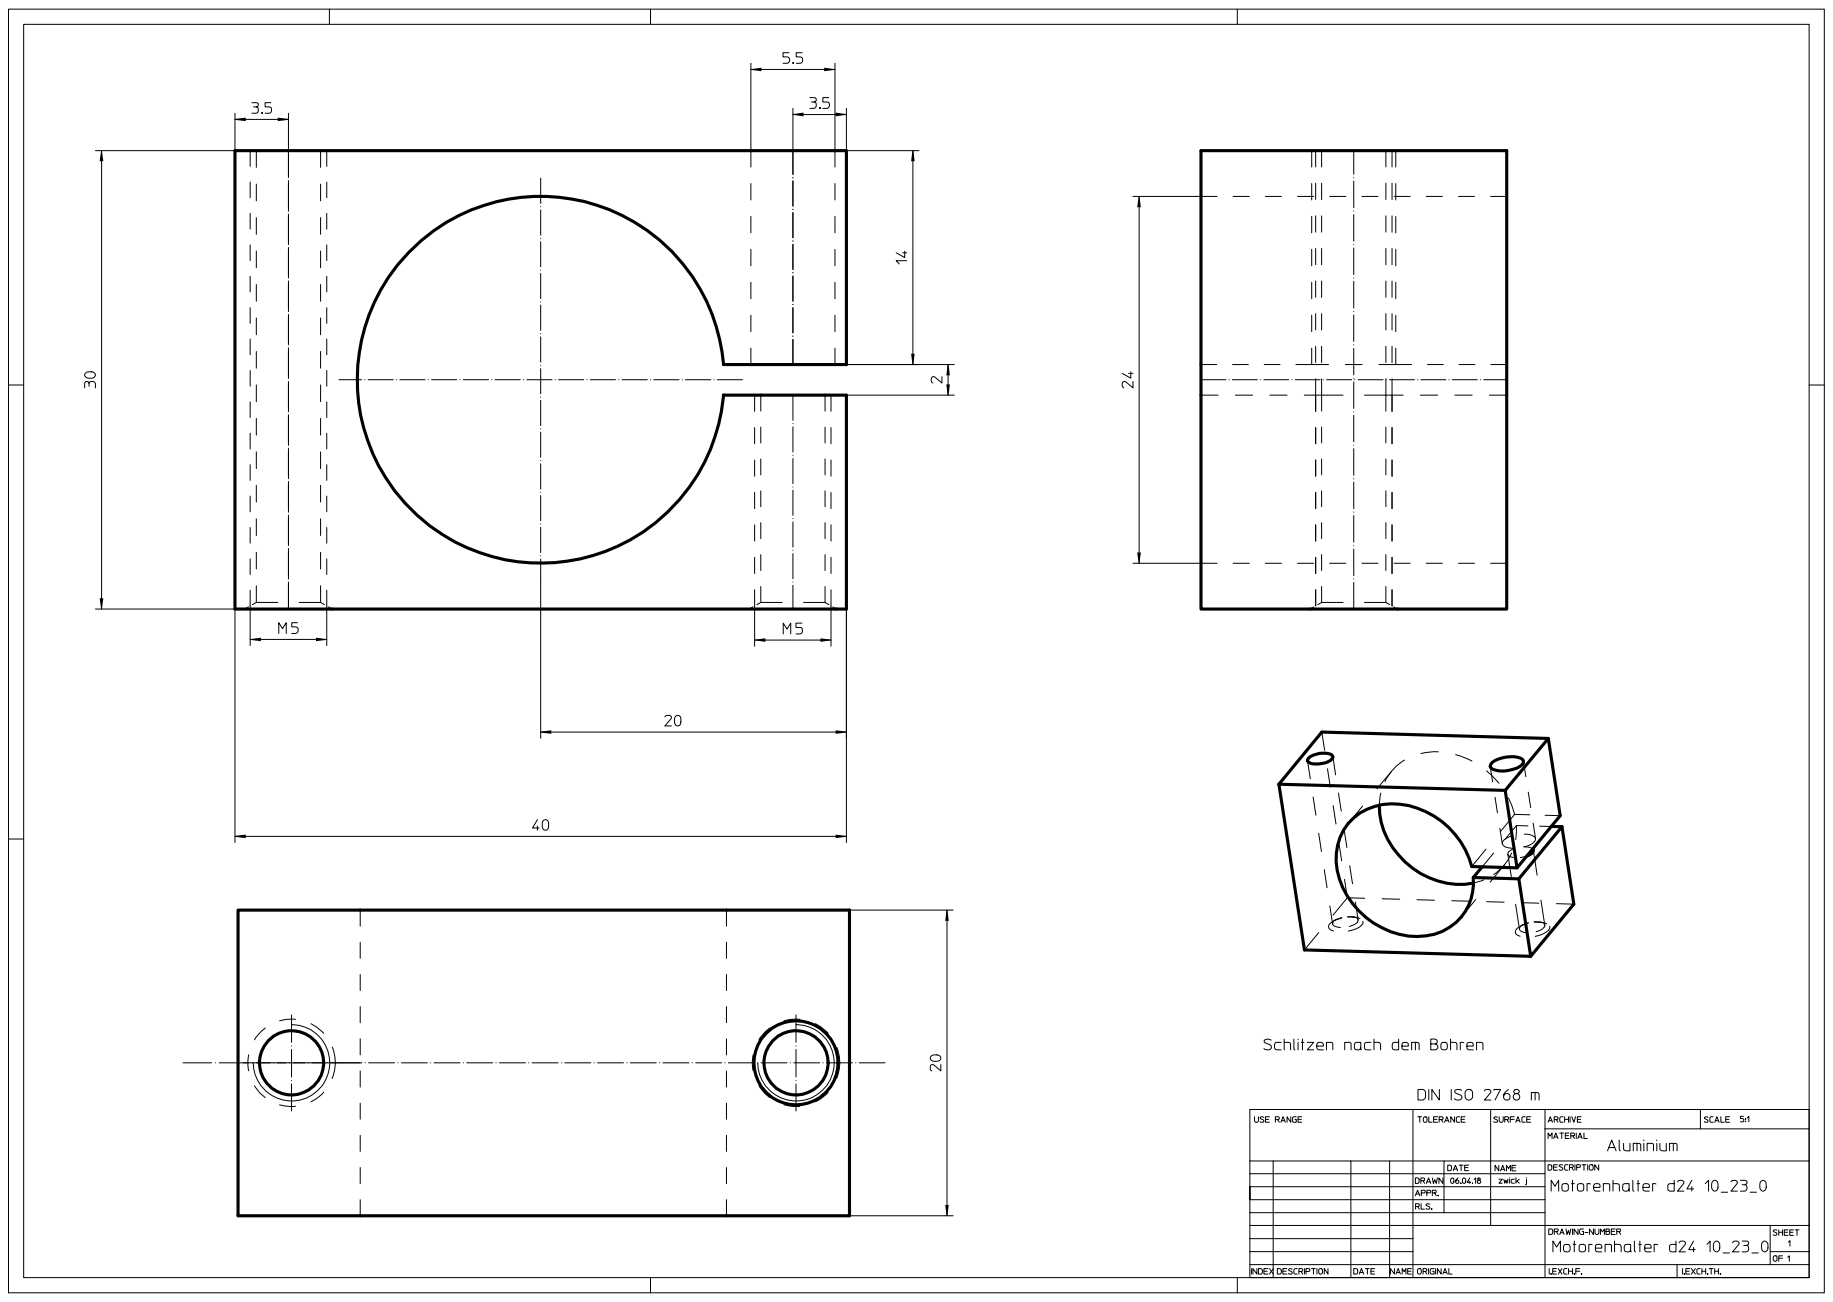
[picture p339: page 1]
