Unaqwyn/SysP18_1cv/(list of files, drawings)

Other design files:
01_Organisation/02_Meilensteine/m4/SySP18-Team10-Anhang/Abgabe Elektonik/Motortreiber, Spannungsversorgung/Footprints.PcbLib
01_Organisation/02_Meilensteine/m4/SySP18-Team10-Anhang/Abgabe Elektonik/Motortreiber, Spannungsversorgung/Motortreiber_1,2.SchDoc
01_Organisation/02_Meilensteine/m4/SySP18-Team10-Anhang/Abgabe Elektonik/Motortreiber, Spannungsversorgung/Motortreiber_3,4.SchDoc
01_Organisation/02_Meilensteine/m4/SySP18-Team10-Anhang/Abgabe Elektonik/Motortreiber, Spannungsversorgung/Motortreiber_5,6.SchDoc
01_Organisation/02_Meilensteine/m4/SySP18-Team10-Anhang/Abgabe Elektonik/Motortreiber, Spannungsversorgung/PCB.PcbDoc
01_Organisation/02_Meilensteine/m4/SySP18-Team10-Anhang/Abgabe Elektonik/Motortreiber, Spannungsversorgung/Schemasymbole.SchLib
01_Organisation/02_Meilensteine/m4/SySP18-Team10-Anhang/Abgabe Elektonik/Motortreiber, Spannungsversorgung/Spanungsversorgung.SchDoc
01_Organisation/02_Meilensteine/m4/SySP18-Team10-Anhang/Abgabe Elektonik/Motortreiber, Spannungsversorgung/SysP18_Team10.PrjPcb
01_Organisation/02_Meilensteine/m4/SySP18-Team10-Anhang/Abgabe Elektonik/Motortreiber, Spannungsversorgung/Uebersicht.SchDoc
01_Organisation/02_Meilensteine/m4/SySP18-Team10-Anhang/Abgabe Elektonik/MPC555undSensoren Bestellung/2_MPC555.SchDoc
01_Organisation/02_Meilensteine/m4/SySP18-Team10-Anhang/Abgabe Elektonik/MPC555undSensoren Bestellung/4_Sensoren.SchDoc
01_Organisation/02_Meilensteine/m4/SySP18-Team10-Anhang/Abgabe Elektonik/MPC555undSensoren Bestellung/SensorenUndMPC555.PcbDoc
01_Organisation/02_Meilensteine/m4/SySP18-Team10-Anhang/Abgabe Elektonik/MPC555undSensoren Bestellung/SysP18_Robi.PcbLib
01_Organisation/02_Meilensteine/m4/SySP18-Team10-Anhang/Abgabe Elektonik/MPC555undSensoren Bestellung/SysP18_Robi.PrjPcb
01_Organisation/02_Meilensteine/m4/SySP18-Team10-Anhang/Abgabe Elektonik/MPC555undSensoren Bestellung/TopSheet.schdoc
03_Elektronik/veralteteDateien/AchtungPfusch/Controller.SchDoc
03_Elektronik/veralteteDateien/AchtungPfusch/Sensoren.SchDoc
03_Elektronik/veralteteDateien/AchtungPfusch/SysP18_Robi.PrjPcb
03_Elektronik/veralteteDateien/AchtungPfusch/TopSheet.schdoc
03_Elektronik/veralteteDateien/Motortreiber, Spannungsversorgung/Motortreiber_1,2.SchDoc
03_Elektronik/veralteteDateien/Motortreiber, Spannungsversorgung/Motortreiber_3,4.SchDoc
03_Elektronik/veralteteDateien/Motortreiber, Spannungsversorgung/Motortreiber_5,6.SchDoc
03_Elektronik/veralteteDateien/Motortreiber, Spannungsversorgung/PCB.PcbDoc
03_Elektronik/veralteteDateien/Motortreiber, Spannungsversorgung/Spanungsversorgung.SchDoc
03_Elektronik/veralteteDateien/Motortreiber, Spannungsversorgung/SysP18_Team10.PrjPcb
03_Elektronik/veralteteDateien/Motortreiber, Spannungsversorgung/Uebersicht.SchDoc
03_Elektronik/veralteteDateien/PCB_SysP17_Official_170617_1141/div_Ele.SchDoc
03_Elektronik/veralteteDateien/PCB_SysP17_Official_170617_1141/Lichtsensor.SchDoc
03_Elektronik/veralteteDateien/PCB_SysP17_Official_170617_1141/Motor.SchDoc
03_Elektronik/veralteteDateien/PCB_SysP17_Official_170617_1141/MPC.SchDoc
03_Elektronik/veralteteDateien/PCB_SysP17_Official_170617_1141/Supply.SchDoc
03_Elektronik/veralteteDateien/PCB_SysP17_Official_170617_1141/SysP17_Team10.PrjPcb
03_Elektronik/veralteteDateien/PCB_SysP17_Official_170617_1141/SysP_Uebersicht.SchDoc
03_Elektronik/veralteteDateien/SpezWoche-IR-Sensor/1Sheet1-IR-Sensor.SchDoc
03_Elektronik/veralteteDateien/SpezWoche-IR-Sensor/DoubleSide-DesginRuleCheck.PcbDoc
03_Elektronik/veralteteDateien/SpezWoche-IR-Sensor/IR-Sensor.PcbLib
03_Elektronik/veralteteDateien/SpezWoche-IR-Sensor/Luzian schema/IR-Sensor.PrjPcb
03_Elektronik/veralteteDateien/SpezWoche-IR-Sensor/Luzian schema/IR-Sensor.SCHLIB
03_Elektronik/veralteteDateien/SpezWoche-IR-Sensor/Sensor Musterbeispiel/IR-Sensor.PcbDoc
03_Elektronik/veralteteDateien/SpezWoche-IR-Sensor/Sensor Musterbeispiel/IR-Sensor.PcbLib
03_Elektronik/veralteteDateien/SpezWoche-IR-Sensor/Sensor Musterbeispiel/IR-Sensor.PrjPcb
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
