Unaqwyn/SysP18_1cv/04_Informatik/NewRobi/src/Motor/LockedAnti.java

package Motor;

import Definitions.PinMap;
import Definitions.RobiConstants;
import ch.ntb.inf.deep.runtime.mpc555.driver.TPU_PWM;

public class LockedAnti extends Drive
{
	private TPU_PWM pwm;
	private int speedMom;

	public LockedAnti(int PWMChn, int pinEnc, double faktor)
	{
		super(pinEnc, faktor);
		pwm = new TPU_PWM(PinMap.useTPU_A, (short) PWMChn, RobiConstants.pwmPeriod, RobiConstants.pwmPeriod / 2);
	}

	public void setSpeed(int speed)
	{
		if (speedMom != speed)
		{
			speedMom = speed;
			int highTime = (int) (RobiConstants.pwmPeriod * (0.5 + (speed * 0.005)));
			pwm.update(highTime);
			if (speed != 0)
			{
				turns = true;
			}
			else
			{
				turns=false;
			}
		}
	}
}
