Unaqwyn/SysP18_1cv/(commit log)

2017-10-31 initial commit, Milestone 1b
    [SysP18-Anforderungsliste_V1.1 (1).xlsx]
2017-11-07 notizen des 3. semesters hinzugefügt
    [SysP18-Anforderungsliste_V1.1 (1).xlsx]
2017-11-15 Zeitplan aktualisiert
    Test
    [SysP18-Team10-IST-Zeitplan_v1_2017-10-13.xlsx, aktuell-SysP18-Team10-IST-Zeitplan_v1_2017-10-13.xlsx]
2017-11-15 alte Zeitpläne löschen
    lg Luzian
    [aktuell-SysP18-Team10-IST-Zeitplan_v1_2017-10-13.xlsx]
2017-11-22 Zeitplan
    aktualisiert
    [SysP18-Team10-IST-Zeitplan_v1_2017-10-13.xlsx]
2017-11-23 final edition m1b
    blablabla
    [SysP18-Team-10-morphologischer Kasten_V5_2017_11_14_M.Alig.xlsx]
2017-12-18 aufräumen
    [SysP18-Team 10-morphologischer Kasten_V1_2017_10_29_M.Alig.xlsx, SysP18-Team 10-morphologischer Kasten_V2_2017_11_04_M.Stoffel.xlsx, SysP18-Team-10-morphologischer Kasten_V5_2017_11_14_M.Alig.xlsx]
2017-12-18 Zeitplan
    Zeitplan aktualisiert
    [SysP18-Team10-IST-Zeitplan_v1_2017-10-13.xlsx]
2018-01-11 Spez woche Inf projekte, wifi, led, motor
    [SysP18-Team 10-morphologischer Kasten_V1_2017_10_29_M.Alig.xlsx, SysP18-Team 10-morphologischer Kasten_V2_2017_11_04_M.Stoffel.xlsx, SysP18-Team-10-morphologischer Kasten_V5_2017_11_14_M.Alig.xlsx]
2018-02-07 hello
    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
    [SysP18-Team10-IST-Zeitplan_v1_2017-10-13.xlsx]
2018-02-07 ordnernamen aktualisiert
    [Ideensammlung.xlsx, SysP18-Anforderungsliste_V1.1 (1).xlsx, SysP18-Team 10-morphologischer Kasten_V1_2017_10_29_M.Alig.xlsx, SysP18-Team 10-morphologischer Kasten_V2_2017_11_04_M.Stoffel.xlsx, SysP18-Team-10-morphologischer Kasten_V5_2017_11_14_M.Alig.xlsx, SysP18-Team10-Anforderungsliste.xlsx, SysP18-Team10-SOLL-Zeitplan (an Seite angepasst).xlsx, SysP18-Team10-SOLL-Zeitplan.xlsx]
2018-02-16 Elektronik
    Ordner Elektronik erstellt und Fotos eingefügt
2018-02-16 Name geändert und ordner neu angeordnet
    [Ideensammlung.xlsx, SysP18-Anforderungsliste_V1.1 (1).xlsx, SysP18-Team 10-morphologischer Kasten_V1_2017_10_29_M.Alig.xlsx, SysP18-Team 10-morphologischer Kasten_V2_2017_11_04_M.Stoffel.xlsx, SysP18-Team-10-morphologischer Kasten_V5_2017_11_14_M.Alig.xlsx, SysP18-Team10-Anforderungsliste.xlsx, SysP18-Team10-IST-Zeitplan_v1_2017-10-13.xlsx, SysP18-Team10-SOLL-Zeitplan (an Seite angepasst).xlsx]
2018-02-16 Zeitpläne verschoben/hinzugefügt
    [SysP18-Team10-IST-Zeitplan_v1_2017-10-13.xlsx, Zeitplan_16_02_2018.xlsx]
2018-02-19 la updated
2018-02-27 updated, encoder, distsensor
2018-03-02 LagerBock
    Lagerbock-.stp
    [Lagerbock_sysp.stp]
2018-03-06 IR Sensor Daten
    LG Luzian
    [1Sheet1-IR-Sensor.SchDoc, DoubleSide-DesginRuleCheck.PcbDoc, IR-Sensor.PcbDoc, IR-Sensor.PcbLib, IR-Sensor.PrjPcb, IR-Sensor.SCHLIB, IR-Sensor.SchDoc, Sensor-PCB.PcbDoc]
2018-03-06 Zeitplan aktualisiert
    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
    [SysP18-Team10-IST-Zeitplan_v1_2017-10-13.xlsx]
2018-03-06 Luzian
    luzian
    [Mircroprozessor1.SchDoc]
2018-03-06 am ablauf gearbeitet
2018-03-07 Elektronik aktualisiert
    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
    [1_PowerSupply.SchDoc, 2_MPC555.SchDoc, 3_Motoren.SchDoc, 4_Sensoren.SchDoc, PCB_Robi.PcbDoc, SysP18_Robi.PrjPcb, TopSheet.schdoc]
2018-03-08 am programm gearbeitet
2018-03-09 Schmea Elektronik weitergeführt
    Schmea Elektronik weitergeführt
    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
    [1_PowerSupply.SchDoc, 2_MPC555.SchDoc, 4_Sensoren.SchDoc, IR-Sensor.SchDoc, Lichtsensor.SchDoc, MPC.SchDoc, Motor.SchDoc, Supply.SchDoc]
2018-03-13 Michi
    Michi
    [1_PowerSupply.SchDoc, 4_Sensoren.SchDoc, MPC.SchDoc]
2018-03-13 Michi1
    Michi1
    [3_Motoren.SchDoc]
2018-03-13 Motortreiber
    Motortreiber
    [1_PowerSupply.SchDoc, 3_Motoren.SchDoc]
2018-03-13 LG Luzian
    Elektronik aktualisiert
    [2_MPC555.SchDoc, 4_Sensoren.SchDoc, TopSheet.schdoc]
2018-03-13 angepasst. klassen und methoden
2018-03-13 weiter gearbeitet
2018-03-13 Bestellformular online
    Formular für Teilebestellungen
    [Bestellformular_SysProjekt_18.xlsx]
2018-03-13 Infrarotsensor
    Infrarotsensor Hinzugefügt
    [Bestellformular_SysProjekt_18.xlsx]
2018-03-13 Bestellformular aktualisiert
    [Bestellformular_SysProjekt_18.xlsx]
2018-03-13 PCB Erstellen
    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
    [2_MPC555.SchDoc, 3_Motoren.SchDoc, 4_Sensoren.SchDoc, TopSheet.schdoc]
2018-03-14 Schema Leistungselektronik
    Schema Leistungselektronik V1
    [Motortreiber_1,2.SchDoc, Motortreiber_3,4.SchDoc, Motortreiber_5,6.SchDoc, PCB.PcbDoc, Spanungsversorgung.SchDoc, Supply.SchDoc, SysP18_Team10.PrjPcb, Uebersicht.SchDoc]
2018-03-15 andrücken umbennent andruecken und int parameter hinzugefügt. methode motorInPos eingeführt mit boolean return
2018-03-15 Elektronik aktualisiert
    [2_MPC555.SchDoc, 3_Motoren.SchDoc, 4_Sensoren.SchDoc, IR-Sensor.PrjPcb, SysP18_Robi.PrjPcb, TopSheet.schdoc]
2018-03-16 sensoren updated
2018-03-16 servo umbenannt
2018-03-16 LG Luzian
    [2_MPC555.SchDoc, 3_Motoren.SchDoc, 4_Sensoren.SchDoc, SysP18_Robi.PrjPcb, TopSheet.schdoc]
2018-03-19 distsensortest pin geändert
2018-03-20 Datenblätter
    Motor, Encoder, Getriebe
2018-03-20 update
    Teile NTB ergänzt
    [Bestellformular_SysProjekt_18.xlsx]
2018-03-20 Update
    Datenblättter und Bestellformular
    [Bestellformular_SysProjekt_18.xlsx]
2018-03-20 Elektronik akutalisiert
    [2_MPC555.SchDoc, 3_Motoren.SchDoc, 4_Sensoren.SchDoc, SensorenUndMPC555.PcbDoc, TopSheet.schdoc]
2018-03-20 LG
    LG
    [Aktuell_Fehlende_Teile_SysP18_Robi.PrjPcb And SysP18_Robi.XLS, SysP18_Robi.PrjPcb, SysP18_Robi.PrjPcb And SysP18_Robi.XLS]
2018-03-21 LG Luzian MIttwoch morgen
    [2_MPC555.SchDoc, 3_Motoren.SchDoc, TopSheet.schdoc]
2018-03-22 aktualisiert
    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
    [SysP18_Robi.PrjPcb]
2018-03-26 Elektronik
    aktualisiert mit Michi Mettler
    [2_MPC555.SchDoc, SensorenUndMPC555.PcbDoc]
2018-03-27 altes programm und dokumente hinzugefügt
    [Kommunikationstabelle.xlsx, LED_Funktionen.xlsx]
2018-03-27 mauro aktualisiert
    [Bestellformular_SysProjekt_18.xlsx]
2018-03-27 LG Luzian Elektronik aktualisiert
    [2_MPC555.SchDoc, 4_Sensoren.SchDoc, SensorenUndMPC555.PcbDoc, SysP18_Robi.PrjPcb, TopSheet.schdoc]
2018-03-27 elektronik
    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
    [SensorenUndMPC555.PcbDoc, SysP18_Robi.PrjPcb]
2018-03-29 weiter programmiert und webseite aktualisiert
2018-03-29 sensoren, wifi, io
2018-03-29 präsentation m2 erstellt
    [Kommunikationsprotokoll.xlsx]
2018-03-31 blabla
    blabla
    [1_PowerSupply.~(2).SchDoc, SysP18_Robi.~(7).PrjPcb, TopSheet.~(20).schdoc]
2018-04-03 motor und encoder gebastle
2018-04-03 encoder 2nd pin removed
2018-04-03 sensor: static final int added for easier access sensorArm, sensorBack, sensorInit
2018-04-05 Bestellisten update
    [Bestellformular_SysProjekt_18.xlsx, Bestellformular_SysProjekt_18_Team10_Elektronik.xlsx, Bestellformular_SysProjekt_18_Team10_Mechanik.xlsx, SensorenUndMPC555.xlsx]
2018-04-05 update
    budget + Bestellformular
    [Bestellformular_SysProjekt_18_Team10_Elektronik.xlsx, Budget.xlsx]
2018-04-05 layout angepasst
    layout angepasst
    [1Sheet1-IR-Sensor.SchDoc, 1_PowerSupply.SchDoc, 1_PowerSupply.~(2).SchDoc, 2_MPC555.SchDoc, 3_Motoren.SchDoc, 4_Sensoren.SchDoc, Controller.SchDoc, DoubleSide-DesginRuleCheck.PcbDoc]
2018-04-05 bestellliste
    bestellliste
    [Bestellformular_SysProjekt_18_Team10_Elektronik.xlsx]
2018-04-06 update der def. Bestelllisten inkl. Budget
    [Bestellformular_SysProjekt_18_Team10_Elektronik.xlsx, Bestellformular_SysProjekt_18_Team10_Mechanik.xlsx, Budget.xlsx, SensorenUndMPC555.XLS, SensorenUndMPC555.xlsx]
2018-04-17 wifi, motor fixed, should be working now
    [Drive.java, Encoder.java, LockedAnti.java, Servo.java, SignMagn.java]
2018-04-17 kommentare hinzugefügt und kleine änderungen am progamm
2018-05-01 sensors should be working
2018-05-01 sensoren init gemacht
2018-05-01 kommentar sensoren und lift
2018-05-01 Änderungen.txt erstellt wegen Vibrationsmotor
    [Lift.java, PinMap.java, Robi.java, Servo.java]
2018-05-01 bestelliste neu
    [Bestellformular_SysProjekt_18.xlsx]
2018-05-04 motor sleep changed mpiosm->mdasm
2018-05-08 pärsentation gearbeitet
2018-05-15 Elektronik angepasst
    Vibrator angeschrieben. R:33 Ohm geändert.
    [2_MPC555.SchDoc, 4_Sensoren.SchDoc, SensorenUndMPC555.PcbDoc, SysP18_Robi.PrjPcb, TopSheet.schdoc]
2018-05-24 Budget
    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
    [Budget.xlsx]
2018-05-29 mech schlussbericht und webseite
2018-06-05 der Roboter deutsch-mechanik aktuell
2018-06-05 robi englisch ablauf und informatik übersetzt
2018-06-11 lift init verändert übereinstimmungen test/richtige klassen geprüft(com, motor)
2018-06-11 bedinungs und wartungsarbeiten
2018-06-12 Elektronik aktualisiert
    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
    [2_MPC555.SchDoc, 4_Sensoren.SchDoc, TopSheet.schdoc]
2018-06-12 änderungen der test online vibrationmotor al sign magn statt mpiosm distSensor vorne mit threshold statt obstcle, range (500-800) zahlen für toPos methoden in robikonstants drive setzt den eigenen sp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
    [Drive.java, Servo.java]
2018-06-12 gitignore hat probleme gemacht
    [Lift.java, PinMap.java, Servo.java]
2018-06-13 flyer und bilder
2018-06-14 aktualisiert
    aktualisert
    [2_MPC555.SchDoc, 4_Sensoren.SchDoc, Footprints.PcbLib, Motortreiber_1,2.SchDoc, Motortreiber_3,4.SchDoc, Motortreiber_5,6.SchDoc, PCB.PcbDoc, Schemasymbole.SchLib]
2018-06-14 bedinungs und wartungsanleitung
2018-06-14 CAD abgaben
    [Fahrwerk 10_01_0.stp]
2018-06-15 Abgabe Mechanik
    [Fahrwerk 10_01_0.stp]
2018-06-15 bla
    bla
    [2_MPC555.SchDoc, 4_Sensoren.SchDoc, Footprints.PcbLib, Motortreiber_1,2.SchDoc, Motortreiber_3,4.SchDoc, Motortreiber_5,6.SchDoc, PCB.PcbDoc, Schemasymbole.SchLib]
2018-06-22 Jeannot isch en tubel
    Jeannot isch en tubel
2018-07-17 history Elektronik gelöscht
    history Elektronik gelöscht
    [1_PowerSupply.~(2).SchDoc, SysP18_Robi.~(7).PrjPcb, TopSheet.~(20).schdoc]
